lingkonglengfeng/nanhua-pendulum-car/chassis_fr4_v2_direct/README.md

# 底板 V2 新轮组直装版

本版直接修改整块底板，配合用户选定的 370、280 转、带编码器的整套轮组。**不需要上一版的小转接片。** 原 V1 底板文件保留作历史，不要混用两版 DXF。

底板仍为 320×220×4 FR4，外角 R10。四组轮组固定孔，每组横向 X 间距 16、沿电机轴向 Y 间距 14，孔径 Ø3.4，对应套件图的 4×Ø3.3，使用 M3 通孔连接。孔组中心为 X=±118、Y=±94；实际孔坐标 X=±110/±126，Y=±87/±101。

去除了旧 520 的 30×24 固定孔和旧转接片的 16 条 M4 槽，改为新轮组的 16 个直装孔。总孔/槽数量由 100 改为 84。倒立摆 8 个 M5 孔、电子模块 36 孔、IMU 4 孔、传感器 6 槽、电池 4 槽、走线 2 槽与侧边 8 孔全部保留。

孔组向两侧布置以给 27 mm 宽轮胎留空间。依据图中 34 mm 安装段、后孔距端部 8 和孔距 14，孔组中心距靠轮一侧的支架端约 19；因此正侧支架端名义位于 Y=113，超出主板边缘 110 约 3。轮与该端面之间的未标间隙没有擅自给定。最终先用纸样或实物叠放，确认轮胎及支架不擦板，再加工全部孔。

安装面到轴心高度未知，整车离地间隙不能沿用旧 520 模型。支架厚度和螺母空间也需确认后再选 M3 螺丝长度；采用穿透连接配垫圈和螺母，不在 4 mm FR4 上攻承力螺纹。

output/dxf 为加工轮廓，单位 mm；output/step 为完整底板实体；STL 仅供参考，不是一块能放入 A1 mini 的打印件。孔位表与顶视 SVG/PNG 一并提供。几何、孔位及导出文件检查通过，尚未试装和验证强度。
