lingkonglengfeng/nanhua-pendulum-car/pcb_bottom_adapter_v1/README.md

# 小车底部电路板转接板 V1

> 历史方案：用户已修正为底盘中央四槽安装。当前使用同级 `pcb_bottom_adapter_v2_center`；V1 端部安装不再是当前方案。

根据用户给定的电路板 **90×70 mm、四孔中心距 84×64 mm、M3** 设计。读取当前目录较新的 V3 300×200×4 mm 底盘 STEP，原有文件不修改。

## 直接使用

- `output/stl/01_adapter_84x64_M3.stl`：转接板打印 **1 件**，含四个一体支柱，整体 80×116×10 mm；主板厚 4 mm，支柱增高 6 mm。
- `output/stl/02_spacer_D8_H10_M3_qty4.stl`：隔柱打印 **4 件**，外径 8、高 10、通孔 Ø3.4。也可改用同尺寸绝缘通孔隔柱。
- `output/step/01_adapter_84x64_M3.step`：可编辑转接板实体。
- `output/step/03_chassis_adapter_pcb_assembly.step`：底盘、转接板、电路板参考体、电池参考体和简化紧固件装配。**不是整件打印文件**。
- `output/preview/adapter_viewer.html`：独立离线可旋转预览，支持只看打印件、查看装配、底视和侧视。
- `output/preview/dimensions.svg/png`：尺寸图；数值单位 mm，不按 PNG 显示尺寸量孔。
- `output/hole_coordinates_mm.csv`：孔位坐标。
- `output/adapter_profile_reference.dxf`：平面轮廓参考，BOSS_REFERENCE 为辅助层。立体支柱请以 STEP 为准，不可只根据 DXF 加工完整零件。

## 安装位置与尺寸

坐标沿用原底盘：X 为车长，Y 为车宽，底盘上表面 Z=0，下表面 Z=-4。

电路板旋转 90° 后，沿 X 为 70、沿 Y 为 90；孔距沿 X 为 64、沿 Y 为 84。默认孔阵相对板中心对称，即每个安装孔距板边 3 mm。转接板中心位于底盘 **(110,0)**，也可整体移至另一端 **(-110,0)**；两端底盘孔阵相同，实物安装选空闲一端。

| 项目 | 尺寸 / 坐标 mm |
|---|---|
| 转接板外形 | 80×116，外角 R5 |
| 转接板主板厚度 | 4 |
| 中央开窗 | 44×64，R5 |
| PCB 安装孔相对转接板中心 | X=±32，Y=±42，4×Ø3.4 |
| PCB 支柱 | 高 6，接触面 Ø5.5，根部 Ø9 锥形加强 |
| 底盘连接孔相对转接板中心 | X=±20，Y=±50，4×Ø3.4 |
| 默认使用的底盘原孔 | X=90/130，Y=±50；40×100 孔阵 |
| 底盘至转接板上表面 | 10 |
| 转接板主板 Z 范围 | -18 至 -14 |
| PCB 上表面（朝向底盘） | -24 |
| PCB 下表面 | -25.6，板厚仅暂按 1.6 建模 |

支柱朝下，PCB 装在支柱下端。转接板主板与 PCB 朝向底盘的一面之间留 6 mm；PCB 上表面至底盘下表面为 20 mm，中间包含转接板。若 PCB 背面有高于 6 mm 的器件，需增高支柱。接触面 Ø5.5 是为了适应孔中心距板边仅 3 mm 的尺寸。

## 配件与装配

| 配件 | 数量 | 用途 |
|---|---:|---|
| M3×25 螺丝、M3 螺母 | 各 4 | 穿过底盘、10 mm 隔柱、4 mm 转接板 |
| M3 平垫圈，外径约 7 | 8 | 底盘螺丝头和转接板下侧螺母处 |
| M3×16 螺丝、M3 螺母 | 各 4 | 从 PCB 外侧穿过 PCB、一体支柱和转接板 |
| M3 小外径绝缘垫圈，外径约 5.5 | 4 | PCB 螺丝头处，避让板边和元件 |

紧固件模型省略螺纹，长度按模型中 1.6 mm PCB 和 0.5 mm 垫圈选择；实际垫圈、板厚改变时对应调整长度。

1. 转接板平整大面朝打印平台，四个支柱朝上打印；隔柱竖直打印。建议 PETG，0.2 mm 层高、4 圈壁、约 35% 填充；此摆放无需悬空支撑。
2. 清理通孔，按实际打印收缩修至 M3 螺丝可顺畅穿过。所有孔均为通孔，**不要直接把螺丝攻进塑料孔**。
3. 先把 PCB 固定到四个一体支柱上，螺母位于转接板朝底盘的一面。PCB 角部安装孔周围要有足够无元件区域，螺丝及螺母不可触及带电焊盘。
4. 转接板支柱朝下，用四个 10 mm 隔柱连接底盘现有 40×100 mm 四孔。适度拧紧，避免压坏 PCB 或塑料支柱。
5. 线束可经过中央开窗或板边，按实际接插件位置固定。底盘原有孔若已用于上层模块，可共用贯穿螺栓，但需按实际叠层重新选螺丝长度。

## 验证范围

已检查单实体有效性、STL 闭合、STEP 回读、PCB 孔距、底盘四孔对位，以及装配中已表示实体（含螺丝、螺母、垫圈、电池参考体）的体积交叠。转接板与旧模型中央 120×50×28 电池参考体最短距离 10 mm。窗口是通孔，根部为锥形加强，支柱与板身为一个连续实体。

PCB 仅为外形与孔位参考体：未给出实际板厚、元件朝向、元件及接插件高度、孔位相对板边偏置。新轮组安装面至轮轴高度尚无可靠三维模型，未确认轮组向车内伸出的包络、接插件空间、路面间隙或实物强度。PCB 螺丝头最低约 Z=-29.1，PCB 外侧元件可能更低，安装前需一并核对。旧的 520 整车装配不是本次新轮组的尺寸依据。

## 重建

在 `D:\blance_car` 中运行：

```powershell
& .\.cad-venv\Scripts\python.exe .\pcb_bottom_adapter_v1\build_adapter.py
& .\.cad-venv\Scripts\python.exe .\pcb_bottom_adapter_v1\build_viewer.py
```

尺寸参数在同目录 `parameters.json`。改变孔距或安装位置后需同时检查板边距离、现有底盘孔阵及硬件干涉；生成脚本检查不会把未知器件空间当作已确认。
