lingkonglengfeng/nanhua-pendulum-car/HARDWARE_SELECTION.md

# 当前硬件选择

> 历史选型记录：以下内容对应 2026-09-28 的 G474 方案。后期 F103 固件和接口以 [项目首页](README.md) 与 [F103 工程说明](f103_bringup/README.md) 为入口；最终比赛实物配置待补充。

更新于 2026-09-28。

- 主控按最新用户图片：正点原子 ATK-DMG474。工程内资料盘包含 DMG474 V1.0 原理图及 IO 分配表；已据此完成 `wiring_dmg474_drv8871/output/DMG474引脚与转接板方案_V2.md` 的 MCU/接口针号分配。旧接线 SVG 仍为功能级 V1，模块针序与实物电气参数待核对。
- IPS200 调试屏当前走 CN10 的 SPI3 引脚；`wiring_dmg474_drv8871/output/IPS200接入与引脚分配_V3.md` 中的 CN3/SPI1 单独排线是旧备选。屏幕模块的供电、背光和实际排针顺序待实物核对。
- 为减少排线，当前 V6 沿用 `wiring_dmg474_drv8871/output/双牛角座两排线方案_V4.md` 中的 CN8/CN10 两根 24 芯信号排线、四路编码器、I²C4、IPS200/SPI3 和本地 5V→3.3V 供电；驱动器和控制网络以 V6 为准。
- 驱动方案按用户最新选择改为 **两块 AT8236 双路模块**，四台 12V 370 电机各用一通道。接口分配、模块两排 7 针照片视角丝印及 SVG 见 `wiring_dmg474_drv8871/output/AT8236双模块两排线方案_V6.md`。之前的 TB6612 V5 和 DRV8871 V4 均为旧方案。AT8236 小板实际排距、针脚方向、排针载流、温升与 3S 母线换向尖峰仍待实物核对。
- 轮组：用户确认采用最新图片中的整套电机+支架+轮胎。已知轮宽27、总长85.95、四孔3.3、沿电机轴向孔距14、另一方向16。轮径左右65/66标注需核对。
- 不再采用此前 JGB37-520 的参数。用户确认购买 **12V、21.3 减速比、空载 280 rpm** 的 370 电机；参数表标额定转速 220 rpm、额定电流 0.45A、堵转电流 1.3A，并注明不允许堵转或带负载瞬间反转。编码器 A/B 接线及轴高仍待核对。
- 最新底板采用 chassis_fr4_v3_300x200，300×200×4 mm、14×16 轮组直接安装，不再需要小转接片；配套文件为 `pendulum_底板V3_300x200.zip`，离线预览为 `pendulum_底板V3_300x200_独立预览.html`。chassis_fr4_v2_direct 与 wheelset_14x16_v1 仅保留为旧版本/过渡方案。此前整车模型里的 520 轮组外形是旧版占位，不能拿来确认新轮组轴高。
- 倒立摆仍采用 V3、Ø8 铝管、608轴承、AS5600圆板及可调配重。
