lingkonglengfeng/nanhua-pendulum-car/docs/发布准备.md

# GitHub 发布整理记录

首次公开整理包含项目首页、F103 使用入口、建模版本导航、技术调试过程初稿，以及根据作者口述整理的个人复盘、自制转接板工程、原理图及两张实物照片。仓库名为 `lingkonglengfeng/nanhua-pendulum-car`，默认分支为 `main`。

## 已整理的范围

- 当前 `f103_bringup/` 固件、随工程提供的 HAL / CMSIS / FreeRTOS、串口工具。
- 摆架、底盘、转接件、配重和参考整车的建模源文件及输出。
- 现有技术调试文档及面向读者的新导航。
- `hardware/adapter-board/` 保存作者提供的原始硬件工程和原理图；已注明设计仍有纰漏，实物使用飞线修正。
- `docs/images/` 保存整车及底部接线的两张实物照片。
- `.gitignore` 排除厂商整套资料盘、早期 G474 固件、重复归档、虚拟环境、生成缓存、调试器个人布局和批量原始日志。本地文件仍保留。
- 保留 `speed_pid_build/` 里的构建/验证脚本和测试源文件；只排除其中备份、主机生成目录与编译输出。

## 已完成与后续补充

- [x] 根据作者口述整理个人复盘，并将摘要加入 README。
- [ ] 比赛当天的具体过程、现场表现与最终结果。
- [ ] 确认当前 v48 与比赛最终运行版本的关系；需要时单独保留比赛版快照。
- [ ] 最终实物配置，尤其主控、电机、摆杆尺寸与重量、传感器和电源。
- [x] 整车与底部接线实物照片，已与 CAD 示意分开标注。
- [ ] 可公开的演示视频。
- [ ] 实物飞线修改清单：起止焊点、对应网络、原因，以及工程是否已回填。
- [x] 经作者选择，原创代码、设计及文档采用 MIT License；第三方部分保留原许可证。
- [x] 确定 GitHub 仓库名 `nanhua-pendulum-car`，整理简介和提交范围。

## 第三方文件说明

当前文件中可找到的许可证入口包括：

- `f103_bringup/Drivers/STM32F1xx_HAL_Driver/LICENSE.txt`
- `f103_bringup/Drivers/CMSIS/LICENSE.txt`
- `f103_bringup/Drivers/CMSIS/Device/ST/STM32F1xx/LICENSE.txt`
- `f103_bringup/Middlewares/Third_Party/FreeRTOS/Source/LICENSE`
- `pendulum_v3/output/preview/THREE-LICENSE.txt`

完整的第三方许可范围说明见 [THIRD_PARTY_NOTICES.md](../THIRD_PARTY_NOTICES.md)。保留模型预览脚本、参考图片和其他第三方资料的来源信息；仓库根目录的 MIT License 不替代其原许可。

## 原始数据

`f103_bringup/logs/` 暂不纳入默认提交，文档中对该目录的引用属于本地历史实验路径。串口工具 `samples/` 中用于离线展示和解析检查的样本日志保留。若后续公开更多实测数据，可挑选代表性日志，附固件号、命令顺序和实验条件，再单独整理。
