lingkonglengfeng/nanhua-pendulum-car/docs/校赛复盘与个人经验.md

# 南华电赛运控组校赛：一些调车的碎碎念

这次校赛的内容，是做一辆倒立摆小车。规则要求摆杆能够从最低点起摆，然后保持倒立。比赛结束了，就想把这次的代码、建模和一些调试经历整理出来，也聊聊自己一路做下来的感受。

过程中有方案更换，有选型踩坑，也有因为效果和时间原因最后没继续做的部分。把这些一起留下来，我觉得也有意义。

## 不会建模，就借助 AI 先做起来

我一开始不会建模，所以选择让 AI 辅助我做第一版倒立摆小车。考虑到摆杆需要从最低点起摆，最后选了龙门架式的结构，围绕这个结构一步步完成建模。

对我来说，这次算是一次跨出舒适圈的尝试。原本不熟悉的东西，借助 AI 可以先把想法做出来，再通过实物和调试慢慢理解。不过，模型做出来只是第一步，后面还有装配、接线和控制上的很多问题要处理。

## 第一版方案：想少飞线，还是踩了坑

最开始，角度传感器直接选了 AS5600，主控则用了正点原子的电机控制板。后面回头看，这块板对我这次的用途其实不太合适。

我个人不太喜欢飞特别多的线，所以参考原理图做了第一版转接板。想法很直接：利用控制板本身已有的简牛接口，通过排线连接到转接板，再接电机、磁编码器这些外设，把接线集中起来。

但实际测试时发现连接有些问题，加上那块控制板后来疑似因为短接损坏，这套选型最后就放弃了。

这部分让我体会到，前期选型不能只看功能够不够，也要结合自己真正要接的外设，以及整车的接线和调试方式。原本是想少一点飞线，实际做下来，接口核对和转接板设计本身也需要花不少功夫。

## 换成 F103，用 RTOS 组织任务

后面改成了 F103 的方案，重新画了第二版板子，软件架构用 FreeRTOS 来组织。

但换了方案、重新画板，也没有一下子把问题都解决。自己设计的转接板里还是有纰漏，最后是在实物上通过飞线修正的。本来想尽量少飞线，最后还是用到了飞线，这也是这次做板和调试的实际经历。

这次把 [转接板工程、原理图和已知问题](../hardware/adapter-board/README.md) 一起放进仓库，也附上了 [整车照片](images/car-overview.jpg) 和 [底部接线照片](images/car-underside.jpg)。工程文件保留提供时的设计内容，实物飞线的具体起止点还需要继续整理。

实际上，我对 RTOS 学得也不算深入。但这种把控制、通信等工作分成任务、通过调度交替运行的方式，用起来确实很方便。对这次项目来说，这种“伪并行”的使用感受很好，也让我有机会带着实际需求去理解任务调度。

## 编码器选型的影响，一直留到了后面

另一个比较明显的问题，是前期选型经验不足，选的轮组编码器分辨率偏低。

在后续调参时，我一直觉得这件事很影响零速附近的调试：把速度环的目标速度设成 0，也很难让车持续保持在原点。能让摆杆保持倒立，和能让整辆车一直停在同一个位置，实际做起来还是有差别的。

回头看，前期应该更早关注编码器在实际低速工况下能提供怎样的反馈。电机能转、转速够用以后，低速反馈和零速附近的控制仍然有不少问题要处理。

转向环我也做过，但效果比较差。再加上时间不是特别多，后来就没有继续往循迹上做了。

## 起摆策略：学过，也结合实车做了选择

起摆这一部分，我也去学习过，看到过动态正弦策略。不过结合这次的调试感受，AI 辅助写出来的这一版能量控制策略，好像更适合我的这辆车一些。

最后还是要把程序放到实车上，看摆杆怎么动、什么时候接管，再结合现象和日志去调整。

## AI 的辅助，确实占了很大一部分

这次项目里，AI 的辅助是占大头的。从最开始不会建模，到后面的代码实现和调试，我都用了很多 AI 帮助，也想把这个实际过程记录下来。

现在有这样的工具，我觉得应该跟上变化，勇敢跨出舒适圈，尝试一些以前觉得自己不会、可能就不敢开始的事情。很多时候，先把自己的想法说清楚，就可以借助 AI 一步一步往前做。学习和尝试的成本，确实比以前低了很多。

但最后还是要看行动能力。车要自己装，线要自己接，实物出了问题也要实际去看、去测、去改。实践能力还是非常重要的。

理论知识也可以边做边学。我自己的感受是，带着实际遇到的问题回头看理论，理解反而会更深一些。做的过程中发现自己哪里不懂，再去补，学到的东西也更容易和实际对应起来。

至于 AI 工具的选择，我觉得国产模型的能力也已经很强了。就我这次的个人使用体验来说，为了省事，某些国外模型能更快、更准确地帮我完成想做的事情，所以用得更多一些。我也期待国产模型继续进步，慢慢跟上。

这大概就是这次南华电赛运控组校赛调试的一些碎碎念。希望真正看到这里的人，能从这些代码、模型和不太顺利的经历里，找到一点对自己有帮助的东西。

---

项目入口：[README](../README.md)。按源码和历史日志整理的技术过程见 [调试过程](调试过程.md)。比赛现场具体表现与最终成绩，后续另行补充。
