lingkonglengfeng/nanhua-pendulum-car/pendulum_v2/output/V2圆角修改说明.md

# V2 圆角修改与旧底座兼容性

这次修改保留已经打印的 01 号底座。01 号底座、10 号试打块的 STL 与 V1 字节完全相同，下段支撑臂 Z=8–34 的插接段（含底部穿杆孔）与 V1 的几何差异为零，因此已有底座不必重打。如果“第一个”指的是先打印的试打块，它同样可以继续使用。

后续请采用 V2 的 02–09 号文件。轴高、摆长、两塔中心距、支撑臂厚度、轴承座配合、摆轴孔、摆杆孔以及底座/拼接处孔位均保留。编码器参考 PCB 外形仍待选购后确认。

## 改了哪些圆角

| 零件 | 修改 | 用途与边界 |
|---|---|---|
| 02 下段支撑臂 | 镂空窗口四角 R4 | 在原尖角处增加材料形成圆滑过渡；没有削薄原支撑臂，也没有改变底部插接段 |
| 03 上段轴承臂 | 镂空窗口四角 R3；顶部外轮廓 R3 | 窗口内角是主要受力过渡修改；顶部外角圆滑主要是外形处理；底部拼接端保留平面 |
| 04 拼接夹板 | 外轮廓四角 R4 | 保留平面夹紧面、厚度和全部孔位；这项主要去除外尖角，不应当解释为已验证的承载提升 |
| 05 轴承端盖 | 外轮廓四角 R3 | 保留中孔、螺丝孔以及压住轴承外圈的接触面 |
| 06 摆杆夹座 | T 形台阶内根部及外轮廓 R2；夹杆缝盲端 R0.8 退刀圆孔 | 重点改善台阶及夹紧缝根部的尖锐过渡；轴孔和插杆孔配合尺寸保留 |
| 07 编码器滑轨 | 安装脚与横向悬臂交界根部 R2.5；滑轨横截面宽度由 12 增至 14 | 加强悬臂根部；长圆槽位置及原有固定孔保留 |
| 08 编码器背板 | 背板与两脚连接根部 R2；中央开窗四角 R2；顶部外轮廓 R3 | 兼顾根部过渡与中央窗口；安装孔仍为占位 PCB 孔距 |
| 09 磁铁座 | 紧定螺母凸台外围 R1 | 仅圆滑凸台外围；没有声称磁铁座圆柱/凸台交界已做根部圆角 |

圆角针对的是几何过渡，尤其是窗口内角、台阶内角和悬臂根部。打印件仍可能因层间结合、低填充、螺丝过紧或层向不合适而开裂。这里没有进行有限元分析，也没有实测疲劳寿命或强度提升百分比。

## 编码器背板的装配修正

检查原结构时发现：背板脚上的竖直固定孔正好位于立板下方，螺丝头和工具无法从上方正常接近。V2 将两个孔从背板中心平面向磁铁方向前移 10，脚的前后长度由 20 改为 26，给螺丝头和工具留出空间。

这个修改不改变滑轨的长圆槽，也不改变编码器芯片与磁铁的名义位置。装配时让两只脚的新孔与滑轨槽对齐；背板仍可前后移动调节间距。M3 螺丝与原清单兼容。

定位环参考模型同步改为用户已经选定的内径 8、外径 14、厚 6。它不改变打印件配合；安装时薄垫片只接触轴承内圈，调整定位环轴向位置避免给轴承施加预紧。

## 验证情况

- 10 种导出零件均为有效单实体，STL 为封闭正体积网格。
- 最大平放尺寸仍为 169，适用于 A1 mini 的 180 成型范围；08 的打印高度由 20 改为 26。
- 固定打印件之间未检出体积交叠。
- 中央摆杆与夹座的转动空间、磁铁座整圈包络检查通过；底盘净空保持约 39.97。
- 旧底座与新插接段几何对比通过；轴承孔、光轴孔、铝管孔与底部/拼接孔的空腔检查通过。
- 编码器背板两个新孔上方的 Ø6.2、长 60 螺丝头/工具接近包络没有撞到背板。
- 装配 STEP 已回读验证；3MF 已检查内部模型单位、坐标和三角形索引。

对应记录：`verification.json`、`revision_compatibility.json`、`export_readback.json`。验证针对 CAD 几何与文件完整性，不等同于实物配合或强度已经合格。

继续按照原装配顺序，支撑臂平放打印。先用同一种材料和打印参数完成配合测试，再打印大件；不要为了圆角修改同时改变全局缩放比例，否则轴承孔和已打印底座的配合也会变化。
