lingkonglengfeng/nanhua-pendulum-car/chassis_fr4_v1/output/preview/chassis_top.png

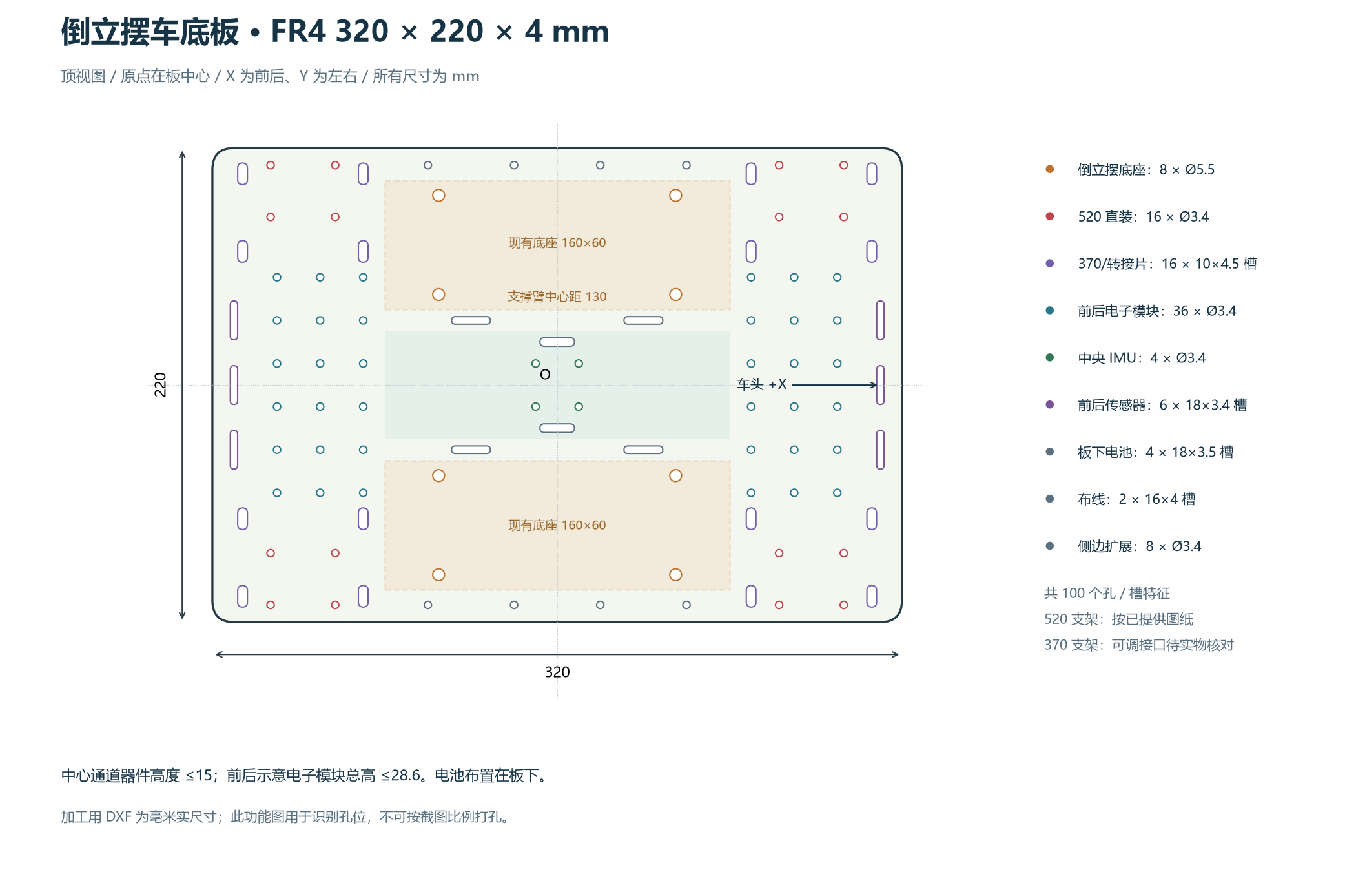
chassis_fr4_v1/output/preview/chassis_top.png
