lingkonglengfeng/nanhua-pendulum-car/chassis_fr4_v1/reference/520_bracket.jpg

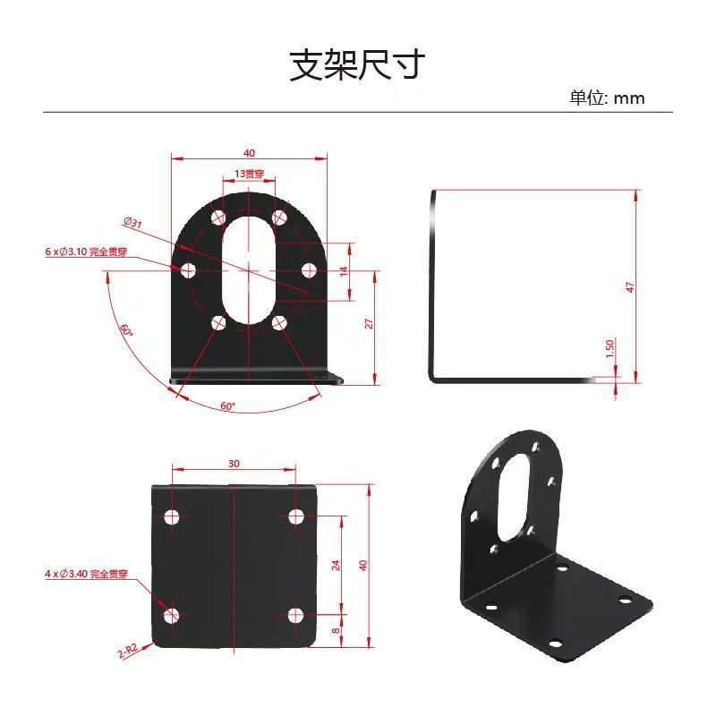
chassis_fr4_v1/reference/520_bracket.jpg
