lingkonglengfeng/nanhua-pendulum-car/chassis_fr4_v2_direct/output/preview/chassis_V2_top.png

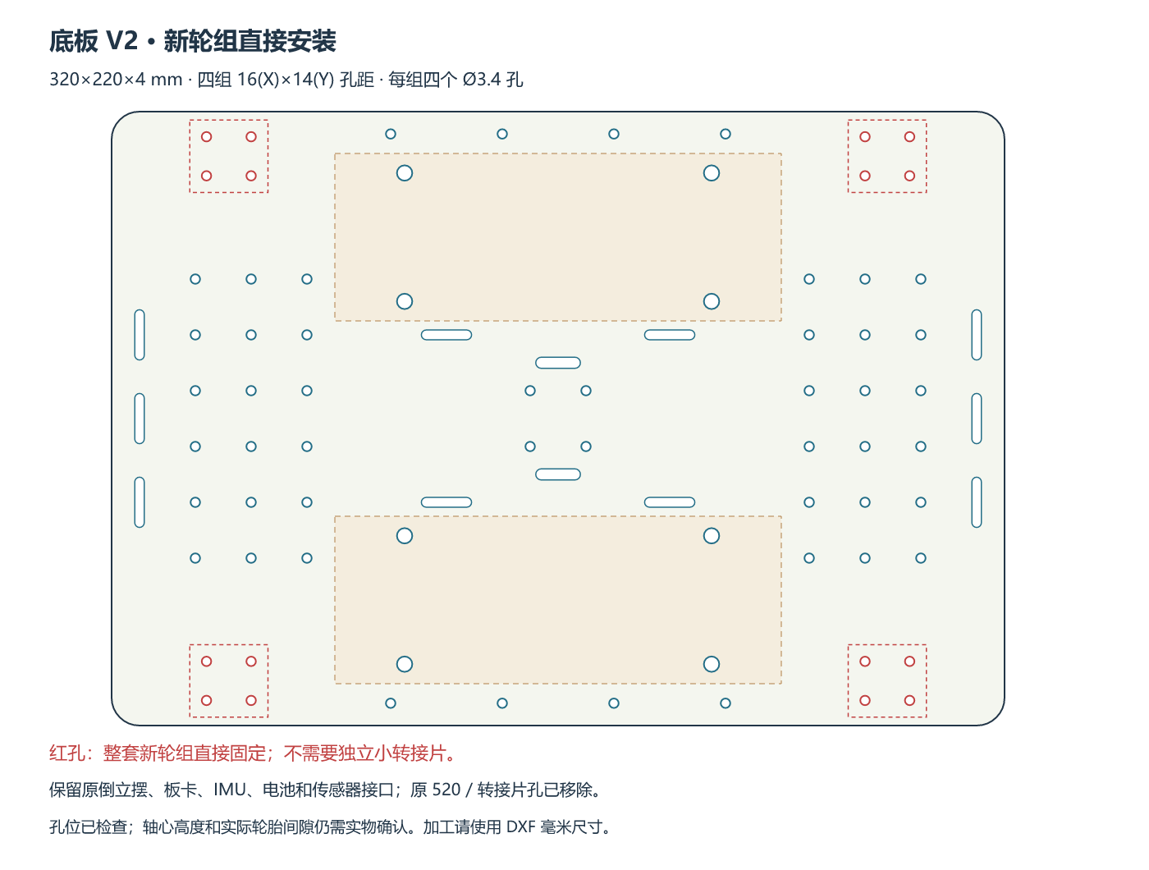
chassis_fr4_v2_direct/output/preview/chassis_V2_top.png
