lingkonglengfeng/nanhua-pendulum-car/pcb_bottom_adapter_v1/output/preview/dimensions.png

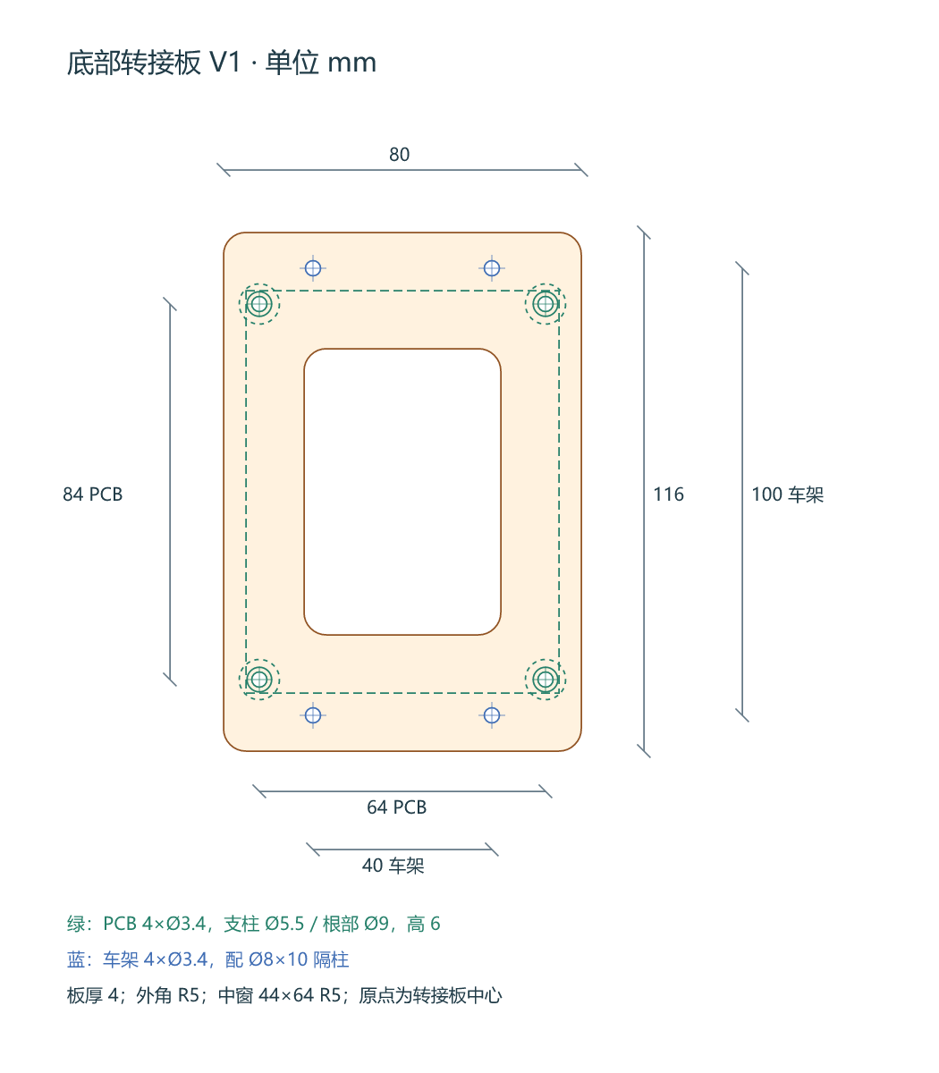
pcb_bottom_adapter_v1/output/preview/dimensions.png
