lingkonglengfeng/nanhua-pendulum-car/pcb_bottom_adapter_v2_center/output/preview/dimensions.png

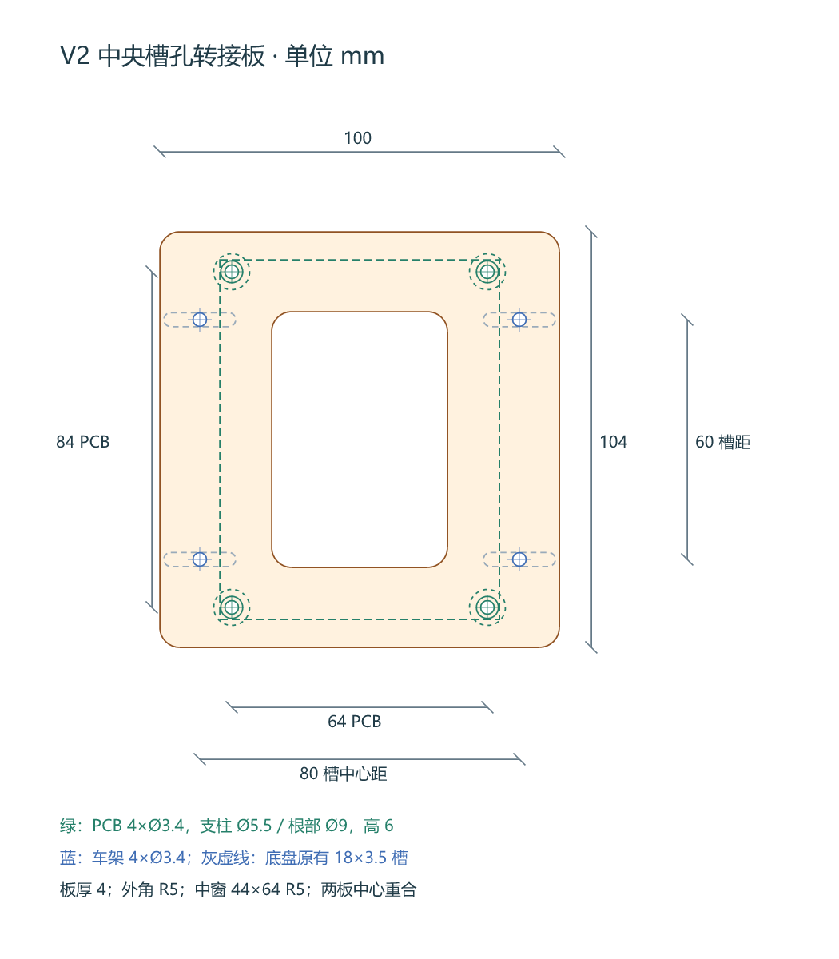
pcb_bottom_adapter_v2_center/output/preview/dimensions.png
