lingkonglengfeng/nanhua-pendulum-car/pendulum_v3/output/preview/AS5600_mount.png

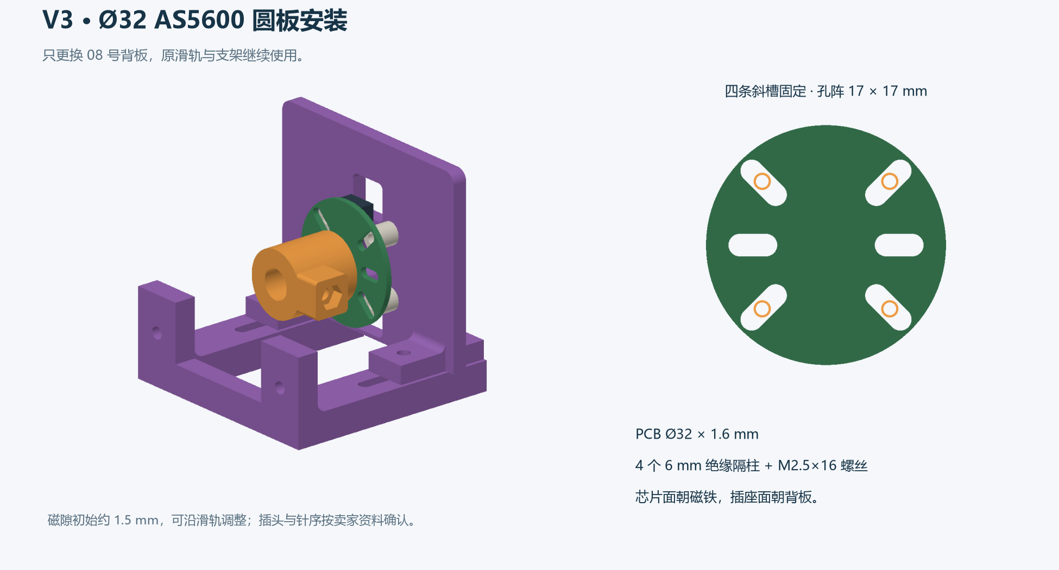
pendulum_v3/output/preview/AS5600_mount.png
