lingkonglengfeng/nanhua-pendulum-car/pendulum_v3/output/preview/dimensions.png

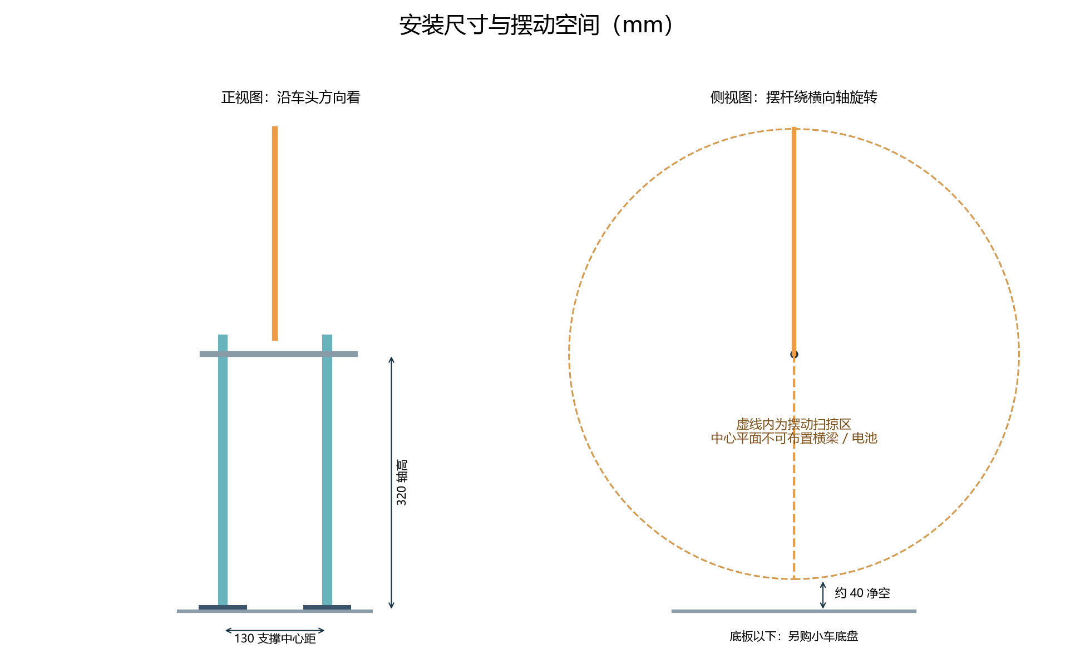
pendulum_v3/output/preview/dimensions.png
