lingkonglengfeng/nanhua-pendulum-car/pendulum_v3/reference/AS5600_module_drawing.jpg

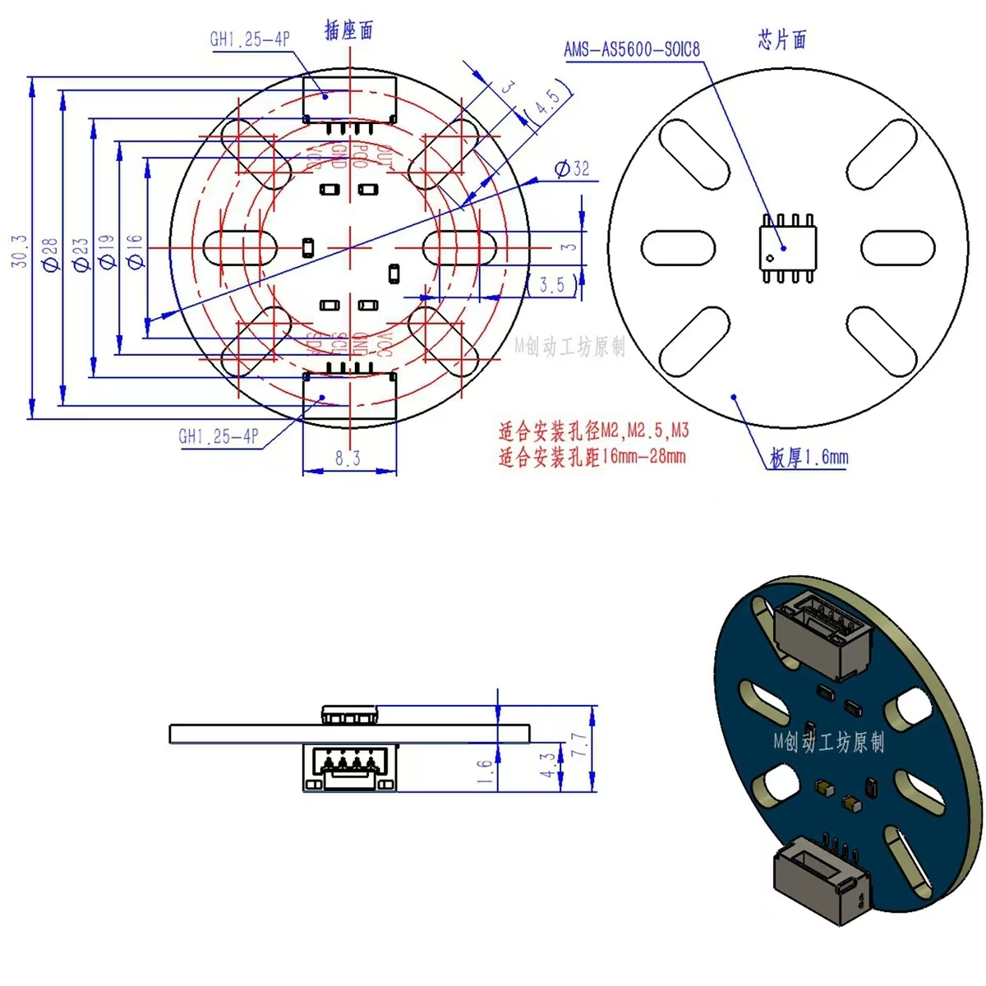
pendulum_v3/reference/AS5600_module_drawing.jpg
