lingkonglengfeng/nanhua-pendulum-car/vehicle_assembly_v1/output/preview/electronics.png

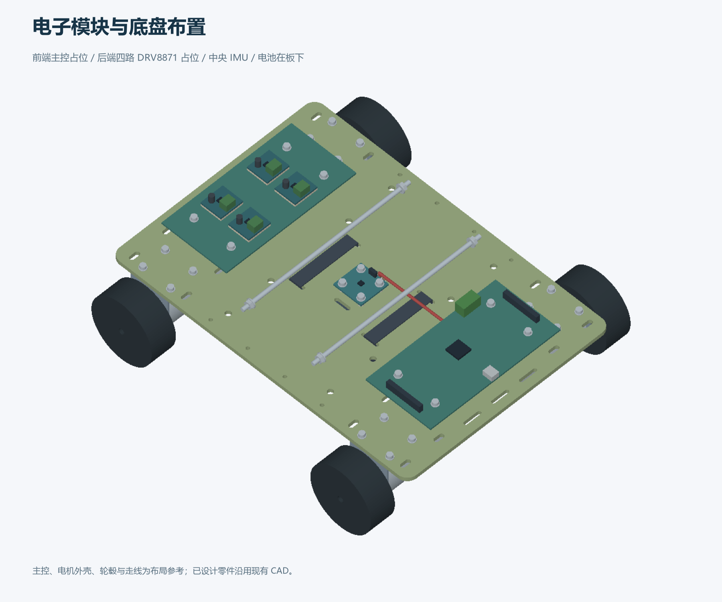
vehicle_assembly_v1/output/preview/electronics.png
