lingkonglengfeng/nanhua-pendulum-car/wheelset_14x16_v1/output/adapter_layout.png

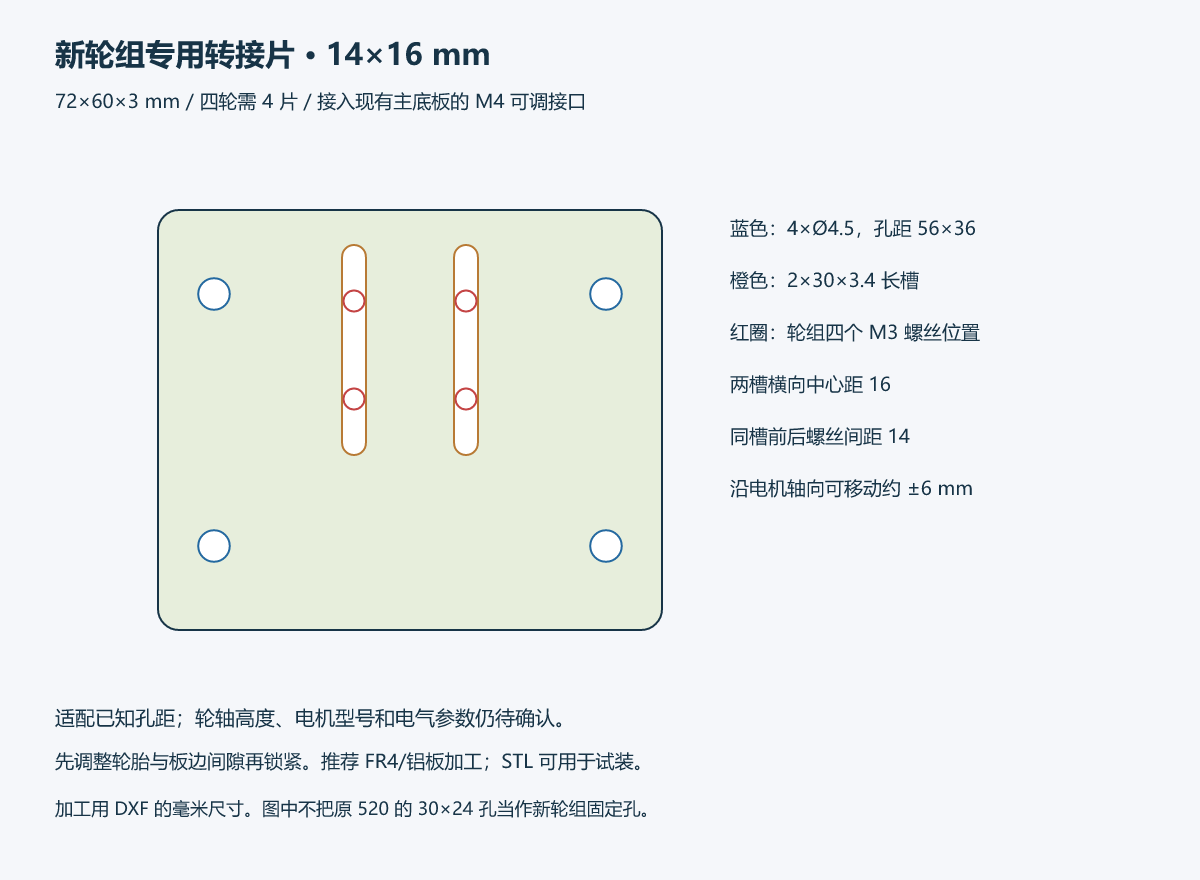
wheelset_14x16_v1/output/adapter_layout.png
