lingkonglengfeng/nanhua-pendulum-car/wiring_dmg474_drv8871/output/AT8236转接板元器件与线缆采购清单_V6.md

# AT8236 四驱转接板元器件与线缆采购清单（V6）

适用范围：ATK-DMG474 + 两块双路 AT8236 + 四台 12V 带编码器 370 电机 + AS5600 + IPS200。依据当前 [V6 接线方案](AT8236双模块两排线方案_V6.md)和 2026-09-28 的转接板原理图/PCB 截图整理。清单是**采购准备表**，不是已经通过 ERC/DRC 的最终 BOM；器件的排距、性别、针序和外形必须与实物及最终 PCB 封装一致。

## 可以先准备的板上连接器

| 用途/图中位号 | 搜索/采购规格 | 数量  | 对应线端与注意事项 |
| --- | --- | ---:| --- |
| 主控排线座 CN1、CN2 | 2.54 mm、2×12、24P、直插防呆简易牛角座（简牛、公座）；按现有 `LAIL-SI-2.54-2X12P-ZC` 封装核对定位柱和外框 | 2 个 | 分别接 DMG474 CN8、CN10。核对主板牛角座 1 脚及防呆口方向。 |
| 四路电机/编码器座 U1～U4 | XH2.54、6P、直插板端公座；按 PCB 选立式/卧式，图中为直插 | 4 个 | 每台电机一组 6 芯。所购电机原插头**不一定是 XH2.54**，先量实际针距和针序。 |
| AS5600 座 U6 | XH2.54、4P、直插板端公座 | 1 个 | 配一组 4 芯线；模块端接口若不是 XH2.54，另一端按模块实物制作。 |
| AT8236 插座 H1～H4 | 2.54 mm、1×7 单排母座/排母 | 4 条 | 两块模块各占两条。确认模块自带的是公针；**两排中心距、插入方向和触点额定电流尚未确认**，测量后再定最终型号。 |
| 电池输入 U5 | 与 PCB 封装一致的 XT60PB-M 板端连接器 | 1 个 | 核对所购 3S 电池插头的性别和 XT60 正负极；不得只按线色判断。 |
| PCB 安装孔 | M3 非金属化孔，建议成品孔径 3.2～3.4 mm | 4 孔 | 这是 PCB 加工特征，不需要买“孔元件”。目前截图只见两个 SCREW，四孔位置须在最终布局中补齐。 |

## 与板上连接器配套的线材

| 用途 | 建议搜索词/做法 | 数量  | 采购前核对 |
| --- | --- | ---:| --- |
| 主控到转接板 | `24P 2×12 IDC 双母头 1:1 直通排线`，24 芯灰排线导体间距通常为 1.27 mm，插头针距 2.54 mm | 2 根 | 两根长度按主板、转接板实际摆放确定；“同向/异向”按防呆口朝向决定，**电气必须逐针 1→1、2→2、…、24→24**。 |
| 四台电机 6 芯线 | XH2.54 6P 单端预压接线，或 6P 母壳 4 个 + 压接端子至少 24 只（建议多买 8 只）+ 合适线材 | 4 组 | 若电机已带可直接插入 U1～U4 的 6P 插头，不重复购买。电机两根功率线的触点额定电流需覆盖约 1.3 A 堵转瞬态。 |
| AS5600 4 芯线 | XH2.54 4P 单端预压接线，或 4P 母壳 1 个 + 压接端子至少 4 只（建议多买 4 只） | 1 组 | 核对模块端的 VCC/GND/SCL/SDA 顺序；不可只按导线颜色接。 |
| 电池到 XT60 | 与 U5 配对的 XT60 插头/成品电池线，建议至少 0.75 mm² 导线 | 1 组 | 若电池已有匹配 XT60 插头可不另买；核对极性、线长和固定方式。 |
| IPS200 屏幕连接 | 按下节确定的 2×8 对接件/16 芯线，或屏幕原装线 | 暂缓  | 当前屏幕实物针序、供电电压和 2×8 座的配合方式未核对，先不要只凭截图下单。 |

上表的“预压接线”和“母壳+散端子”是二选一的制作方式，不需要两套都买。预制排线仍要用万用表检查线序。

## 实物确认后再买的器件

| 项目 | 暂定数量 | 先确认什么 |
| --- | ---:| --- |
| IPS200 板端 2×8、2.54 mm 直插排针/排座 U9（图中 `HC-PM254-8.5H-2x8PZ`）及其对接件 | 各 1 | 现有 PCB 用 16 针，V6 早期草图曾按自定义 8 针规划；必须以**实际 IPS200 模块**的座子尺寸、针序、VCC 和背光接法决定。图中 U9 的 1、15 脚接 5V，不能未经核对就接屏幕。 |
| 5V→3.3V 稳压器及输入/输出电容 | 1 组 | AT8236 VCC 和 AS5600 需要可靠的 `3V3_LOCAL`。当前原理图**没有稳压器**；先根据 IPS、编码器和模块总电流选器件，建议按至少 0.5～1 A 的能力留余量，并在 PCB 中添加相应封装、去耦和测试点。 |
| 电机母线储能/去耦 | 每块驱动附近各 1 组，共 2 组 | 预留约 220～470 µF、耐压至少 25 V 的电解/固态电容及 0.1 µF 陶瓷电容；最终取值与是否已有板载电容按 AT8236 小板电路和实测尖峰确定。 |
| I²C4 上拉电阻 | 2 只（备选） | 常用 4.7 kΩ 上拉到本地 3.3V；若 AS5600 模块/主板已有合适上拉，避免重复导致总阻值过低。 |
| 电池侧保险丝与电源开关 | 各 1 组 | 依实测启动电流、导线规格和所选开关的直流额定值确定；可先做在线束上，不必强塞入紧凑 PCB。 |
| DC1 直流电源插座 | 默认不装 | 当前 DC1 与 XT60 直接并到 `VM/GND`。若要两种电源都保留，先设计切换/防反灌；不可同时插入两个电源。 |

## 模块、结构件与耗材

| 项目 | 数量 | 备注 |
| --- | ---:| --- |
| 所选 AT8236 **双路模块** | 2 块 | 前轮 FL/FR 一块、后轮 RL/RR 一块；不是两颗单路芯片就够四台电机。 |
| 12V、约 280 rpm、带编码器 370 电机 | 4 台 | 用户已选型号；额定约 0.45 A、堵转约 1.3 A/台，不允许持续堵转或带载瞬间反转。 |
| ATK-DMG474 主控板、AS5600 模块、IPS200 屏幕、3S 电池 | 各 1 | 已有则不重复采购；逐件核对接口和供电。 |
| 2 层 FR4 转接板 | 1 块装配，建议打样 5 块 | 当前外形约 120×56 mm，100×56 mm 仅是待重新摆件、完成布线后可尝试的目标；投板尺寸以最终 PCB 为准。 |
| M3 绝缘/金属隔离柱、螺钉与垫圈 | 隔离柱 4 根、螺钉 8 颗、垫圈 8 个 | 先按约 15 mm 隔离柱试装；底板厚 4 mm，螺钉长度按隔离柱有效螺纹和垫圈实测确定。避免金属垫圈碰到铜箔。 |

## 下单与投板前必须处理

1. U1～U4 电机功率脚当前叫 `VIN_*/VOUT_*`，驱动输出叫 `*_MOTOR1/2`；网络名不一致，四路电机实际上未接通。把每台电机的两根绕组线接到对应驱动输出。
2. U6 AS5600 的 `SCL/SDA/VCC` 目前未连到 `PC6_I2C4_SCL/PC7_I2C4_SDA/3V3_LOCAL`；增加稳压器并修正网络名。编码器座当前给 5V，应先确认编码器 A/B 输出的电压与 MCU 输入兼容。
3. CN2-20 右后轮控制网应为 `PC11_RR_IN2`，不是图上的 `PC10_RR_IN2`；PC10 已作屏幕 SPI 时钟。
4. 原方案只从主控 CN10-23 取 5V 给本地稳压器，CN8-23 留空。当前图中两个 5V 针均已连接，需要按最终供电方案修正。
5. 驱动模块双排针排距、IPS 16 针接口、XH 电机插头与 XT60 极性均须按实物检查。排线防呆口方向确定后再选同向/异向；关键是逐针 1:1。完成原理图 ERC、PCB DRC 与装配干涉检查后再投板。
