lingkonglengfeng/nanhua-pendulum-car/vehicle_assembly_v1/output/component_manifest.csv

component | category | source | reference
base_L | fixed | existing_CAD | False
lower_L | fixed | existing_CAD | False
upper_L | fixed | existing_CAD | False
splice_L_-1 | fixed | existing_CAD | False
splice_L_1 | fixed | existing_CAD | False
cover_L | fixed | existing_CAD | False
608_L | hardware | existing_CAD | False
collar_L | rotor | existing_CAD | False
shim_L | rotor | existing_CAD | False
base_R | fixed | existing_CAD | False
lower_R | fixed | existing_CAD | False
upper_R | fixed | existing_CAD | False
splice_R_-1 | fixed | existing_CAD | False
splice_R_1 | fixed | existing_CAD | False
cover_R | fixed | existing_CAD | False
608_R | hardware | existing_CAD | False
collar_R | rotor | existing_CAD | False
shim_R | rotor | existing_CAD | False
shaft_8x190 | rotor | existing_CAD | False
rod_hub | rotor | existing_CAD | False
tube_8x6x260 | rotor | existing_CAD | False
encoder_rail | fixed | existing_CAD | False
encoder_carrier | fixed | existing_CAD | False
magnet_cup | rotor | existing_CAD | False
magnet_6x3 | rotor | existing_CAD | False
AS5600_D32_PCB_FROM_DRAWING | reference | existing_CAD | True
AS5600_PACKAGE_ENVELOPE | reference | existing_CAD | True
GH125_CONNECTOR_ENVELOPE_-1 | reference | existing_CAD | True
GH125_CONNECTOR_ENVELOPE_1 | reference | existing_CAD | True
NYLON_SPACER_6mm_0 | hardware | existing_CAD | False
NYLON_SPACER_6mm_1 | hardware | existing_CAD | False
NYLON_SPACER_6mm_2 | hardware | existing_CAD | False
NYLON_SPACER_6mm_3 | hardware | existing_CAD | False
M4_tie_rod_-38 | hardware | existing_CAD | False
M4_tie_rod_38 | hardware | existing_CAD | False
FR4_MAIN_CHASSIS | fixed | existing_CAD | False
ref_520_-1_-1_Lbracket | reference | existing_CAD | True
ref_520_-1_-1_motor | reference | existing_CAD | True
ref_520_-1_-1_shaft | reference | existing_CAD | True
ref_520_-1_-1_wheel | reference | existing_CAD | True
ref_520_-1_1_Lbracket | reference | existing_CAD | True
ref_520_-1_1_motor | reference | existing_CAD | True
ref_520_-1_1_shaft | reference | existing_CAD | True
ref_520_-1_1_wheel | reference | existing_CAD | True
ref_520_1_-1_Lbracket | reference | existing_CAD | True
ref_520_1_-1_motor | reference | existing_CAD | True
ref_520_1_-1_shaft | reference | existing_CAD | True
ref_520_1_-1_wheel | reference | existing_CAD | True
ref_520_1_1_Lbracket | reference | existing_CAD | True
ref_520_1_1_motor | reference | existing_CAD | True
ref_520_1_1_shaft | reference | existing_CAD | True
ref_520_1_1_wheel | reference | existing_CAD | True
ref_battery_120x50x28 | reference | existing_CAD | True
ref_board_standoff_-1_-90_-50 | reference | existing_CAD | True
ref_board_standoff_-1_-90_50 | reference | existing_CAD | True
ref_board_standoff_-1_-130_-50 | reference | existing_CAD | True
ref_board_standoff_-1_-130_50 | reference | existing_CAD | True
ref_controller_board_-1 | reference | existing_CAD | True
ref_board_standoff_1_90_-50 | reference | existing_CAD | True
ref_board_standoff_1_90_50 | reference | existing_CAD | True
ref_board_standoff_1_130_-50 | reference | existing_CAD | True
ref_board_standoff_1_130_50 | reference | existing_CAD | True
ref_controller_board_1 | reference | existing_CAD | True
weight_lower_head | rotor | existing_CAD | False
weight_lower_nut | rotor | existing_CAD | False
weight_lower_bolt0 | rotor | existing_CAD | False
weight_lower_smallwasher0 | rotor | existing_CAD | False
weight_lower_hexnut0 | rotor | existing_CAD | False
weight_lower_bolt1 | rotor | existing_CAD | False
weight_lower_smallwasher1 | rotor | existing_CAD | False
weight_lower_hexnut1 | rotor | existing_CAD | False
weight_upper_head | rotor | existing_CAD | False
weight_upper_nut | rotor | existing_CAD | False
weight_upper_bolt0 | rotor | existing_CAD | False
weight_upper_smallwasher0 | rotor | existing_CAD | False
weight_upper_hexnut0 | rotor | existing_CAD | False
weight_upper_bolt1 | rotor | existing_CAD | False
weight_upper_smallwasher1 | rotor | existing_CAD | False
weight_upper_hexnut1 | rotor | existing_CAD | False
weight_mass_washer_1 | rotor | existing_CAD | False
weight_mass_washer_2 | rotor | existing_CAD | False
base_M5bolt_-55_-88 | hardware | simplified_fastener | False
base_M5washer_top_-55_-88 | hardware | simplified_fastener | False
base_M5washer_bottom_-55_-88 | hardware | simplified_fastener | False
base_M5nut_-55_-88 | hardware | simplified_fastener | False
base_M5bolt_-55_-42 | hardware | simplified_fastener | False
base_M5washer_top_-55_-42 | hardware | simplified_fastener | False
base_M5washer_bottom_-55_-42 | hardware | simplified_fastener | False
base_M5nut_-55_-42 | hardware | simplified_fastener | False
base_M5bolt_-55_42 | hardware | simplified_fastener | False
base_M5washer_top_-55_42 | hardware | simplified_fastener | False
base_M5washer_bottom_-55_42 | hardware | simplified_fastener | False
base_M5nut_-55_42 | hardware | simplified_fastener | False
base_M5bolt_-55_88 | hardware | simplified_fastener | False
base_M5washer_top_-55_88 | hardware | simplified_fastener | False
base_M5washer_bottom_-55_88 | hardware | simplified_fastener | False
base_M5nut_-55_88 | hardware | simplified_fastener | False
base_M5bolt_55_-88 | hardware | simplified_fastener | False
base_M5washer_top_55_-88 | hardware | simplified_fastener | False
base_M5washer_bottom_55_-88 | hardware | simplified_fastener | False
base_M5nut_55_-88 | hardware | simplified_fastener | False
base_M5bolt_55_-42 | hardware | simplified_fastener | False
base_M5washer_top_55_-42 | hardware | simplified_fastener | False
base_M5washer_bottom_55_-42 | hardware | simplified_fastener | False
base_M5nut_55_-42 | hardware | simplified_fastener | False
base_M5bolt_55_42 | hardware | simplified_fastener | False
base_M5washer_top_55_42 | hardware | simplified_fastener | False
base_M5washer_bottom_55_42 | hardware | simplified_fastener | False
base_M5nut_55_42 | hardware | simplified_fastener | False
base_M5bolt_55_88 | hardware | simplified_fastener | False
base_M5washer_top_55_88 | hardware | simplified_fastener | False
base_M5washer_bottom_55_88 | hardware | simplified_fastener | False
base_M5nut_55_88 | hardware | simplified_fastener | False
splice_M4bolt_-1_-16_155 | hardware | simplified_fastener | False
splice_M4washer_-1_-16_155_77 | hardware | simplified_fastener | False
splice_M4washer_-1_-16_155_52 | hardware | simplified_fastener | False
splice_M4nut_-1_-16_155 | hardware | simplified_fastener | False
splice_M4bolt_-1_-16_195 | hardware | simplified_fastener | False
splice_M4washer_-1_-16_195_77 | hardware | simplified_fastener | False
splice_M4washer_-1_-16_195_52 | hardware | simplified_fastener | False
splice_M4nut_-1_-16_195 | hardware | simplified_fastener | False
splice_M4bolt_-1_16_155 | hardware | simplified_fastener | False
splice_M4washer_-1_16_155_77 | hardware | simplified_fastener | False
splice_M4washer_-1_16_155_52 | hardware | simplified_fastener | False
splice_M4nut_-1_16_155 | hardware | simplified_fastener | False
splice_M4bolt_-1_16_195 | hardware | simplified_fastener | False
splice_M4washer_-1_16_195_77 | hardware | simplified_fastener | False
splice_M4washer_-1_16_195_52 | hardware | simplified_fastener | False
splice_M4nut_-1_16_195 | hardware | simplified_fastener | False
splice_M4bolt_1_-16_155 | hardware | simplified_fastener | False
splice_M4washer_1_-16_155_77 | hardware | simplified_fastener | False
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
encoder_slide_bottomwasher_-23 | hardware | simplified_fastener | False
encoder_slide_nut_-23 | hardware | simplified_fastener | False
encoder_slide_bolt_23 | hardware | simplified_fastener | False
encoder_slide_topwasher_23 | hardware | simplified_fastener | False
encoder_slide_bottomwasher_23 | hardware | simplified_fastener | False
encoder_slide_nut_23 | hardware | simplified_fastener | False
encoder_PCB_bolt_-8.5_311.5 | hardware | simplified_fastener | False
encoder_PCB_frontwasher_-8.5_311.5 | hardware | simplified_fastener | False
encoder_PCB_backwasher_-8.5_311.5 | hardware | simplified_fastener | False
encoder_PCB_nut_-8.5_311.5 | hardware | simplified_fastener | False
encoder_PCB_bolt_-8.5_328.5 | hardware | simplified_fastener | False
encoder_PCB_frontwasher_-8.5_328.5 | hardware | simplified_fastener | False
encoder_PCB_backwasher_-8.5_328.5 | hardware | simplified_fastener | False
encoder_PCB_nut_-8.5_328.5 | hardware | simplified_fastener | False
encoder_PCB_bolt_8.5_311.5 | hardware | simplified_fastener | False
encoder_PCB_frontwasher_8.5_311.5 | hardware | simplified_fastener | False
encoder_PCB_backwasher_8.5_311.5 | hardware | simplified_fastener | False
encoder_PCB_nut_8.5_311.5 | hardware | simplified_fastener | False
encoder_PCB_bolt_8.5_328.5 | hardware | simplified_fastener | False
encoder_PCB_frontwasher_8.5_328.5 | hardware | simplified_fastener | False
encoder_PCB_backwasher_8.5_328.5 | hardware | simplified_fastener | False
encoder_PCB_nut_8.5_328.5 | hardware | simplified_fastener | False
layout_main_MCU | reference | unverified_electronics_envelope | True
layout_USB | reference | unverified_electronics_envelope | True
layout_power_terminal | reference | unverified_electronics_envelope | True
layout_header_-63 | reference | unverified_electronics_envelope | True
layout_header_63 | reference | unverified_electronics_envelope | True
layout_driver_insulation_-125_-25 | reference | unverified_electronics_envelope | True
layout_DRV8871_module_PCB_-125_-25 | reference | unverified_electronics_envelope | True
layout_driver_IC_-125_-25 | reference | unverified_electronics_envelope | True
layout_driver_terminal_-125_-25 | reference | unverified_electronics_envelope | True
layout_driver_capacitor_-125_-25 | reference | unverified_electronics_envelope | True
layout_driver_insulation_-125_25 | reference | unverified_electronics_envelope | True
layout_DRV8871_module_PCB_-125_25 | reference | unverified_electronics_envelope | True
layout_driver_IC_-125_25 | reference | unverified_electronics_envelope | True
layout_driver_terminal_-125_25 | reference | unverified_electronics_envelope | True
layout_driver_capacitor_-125_25 | reference | unverified_electronics_envelope | True
layout_driver_insulation_-95_-25 | reference | unverified_electronics_envelope | True
layout_DRV8871_module_PCB_-95_-25 | reference | unverified_electronics_envelope | True
layout_driver_IC_-95_-25 | reference | unverified_electronics_envelope | True
layout_driver_terminal_-95_-25 | reference | unverified_electronics_envelope | True
layout_driver_capacitor_-95_-25 | reference | unverified_electronics_envelope | True
layout_driver_insulation_-95_25 | reference | unverified_electronics_envelope | True
layout_DRV8871_module_PCB_-95_25 | reference | unverified_electronics_envelope | True
layout_driver_IC_-95_25 | reference | unverified_electronics_envelope | True
layout_driver_terminal_-95_25 | reference | unverified_electronics_envelope | True
layout_driver_capacitor_-95_25 | reference | unverified_electronics_envelope | True
layout_IMU_standoff_-10_-10 | reference | unverified_electronics_envelope | True
IMU_mount_bolt_-10_-10 | hardware | simplified_fastener | False
IMU_mount_topwasher_-10_-10 | hardware | simplified_fastener | False
IMU_mount_bottomwasher_-10_-10 | hardware | simplified_fastener | False
IMU_mount_nut_-10_-10 | hardware | simplified_fastener | False
layout_IMU_standoff_-10_10 | reference | unverified_electronics_envelope | True
IMU_mount_bolt_-10_10 | hardware | simplified_fastener | False
IMU_mount_topwasher_-10_10 | hardware | simplified_fastener | False
IMU_mount_bottomwasher_-10_10 | hardware | simplified_fastener | False
IMU_mount_nut_-10_10 | hardware | simplified_fastener | False
layout_IMU_standoff_10_-10 | reference | unverified_electronics_envelope | True
IMU_mount_bolt_10_-10 | hardware | simplified_fastener | False
IMU_mount_topwasher_10_-10 | hardware | simplified_fastener | False
IMU_mount_bottomwasher_10_-10 | hardware | simplified_fastener | False
IMU_mount_nut_10_-10 | hardware | simplified_fastener | False
layout_IMU_standoff_10_10 | reference | unverified_electronics_envelope | True
IMU_mount_bolt_10_10 | hardware | simplified_fastener | False
IMU_mount_topwasher_10_10 | hardware | simplified_fastener | False
IMU_mount_bottomwasher_10_10 | hardware | simplified_fastener | False
IMU_mount_nut_10_10 | hardware | simplified_fastener | False
layout_IMU_PCB | reference | unverified_electronics_envelope | True
layout_IMU_chip | reference | unverified_electronics_envelope | True
layout_IMU_header | reference | unverified_electronics_envelope | True
battery_pad_top_-45 | reference | battery_mount_reference | True
battery_pad_top_45 | reference | battery_mount_reference | True
battery_pad_bottom | reference | battery_mount_reference | True
battery_strap_-40 | reference | battery_mount_reference | True
battery_strap_40 | reference | battery_mount_reference | True
route_encoder | routing | illustrative_not_wiring_pinout | True
route_power | routing | illustrative_not_wiring_pinout | True
