lingkonglengfeng/nanhua-pendulum-car/chassis_fr4_v1/output/chassis_assembly_520_reference.step

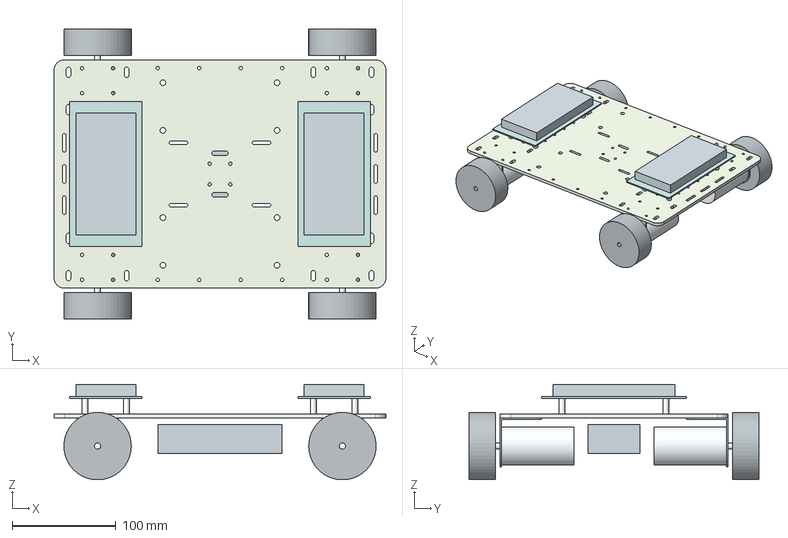
[picture p13: CAD file, 2026-10-20]
chassis_fr4_v1/output/chassis_assembly_520_reference.step
320.0 x 280.0 x 92.0 mm
FR4_MAIN_CHASSIS_part
ref_520_-1_-1_Lbracket_part
ref_520_-1_-1_motor_part
ref_520_-1_-1_shaft_part
ref_520_-1_-1_wheel_part
ref_520_-1_1_Lbracket_part
ref_520_-1_1_motor_part
ref_520_-1_1_shaft_part
ref_520_-1_1_wheel_part
ref_520_1_-1_Lbracket_part
ref_520_1_-1_motor_part
ref_520_1_-1_shaft_part
ref_520_1_-1_wheel_part
ref_520_1_1_Lbracket_part
ref_520_1_1_motor_part
ref_520_1_1_shaft_part
ref_520_1_1_wheel_part
ref_battery_120x50x28_part
ref_board_standoff_-1_-90_-50_part
ref_board_standoff_-1_-90_50_part
ref_board_standoff_-1_-130_-50_part
ref_board_standoff_-1_-130_50_part
ref_controller_board_-1_part
ref_board_components_-1_part
ref_board_standoff_1_90_-50_part
ref_board_standoff_1_90_50_part
ref_board_standoff_1_130_-50_part
ref_board_standoff_1_130_50_part
ref_controller_board_1_part
ref_board_components_1_part
