lingkonglengfeng/nanhua-pendulum-car/pcb_bottom_adapter_v1/output/step/03_chassis_adapter_pcb_assembly.step

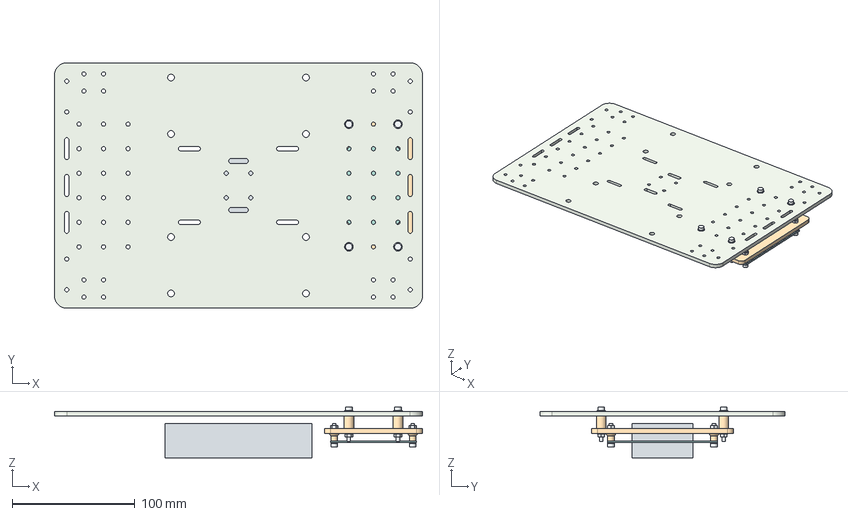
[picture p14: CAD file, 2026-10-20]
pcb_bottom_adapter_v1/output/step/03_chassis_adapter_pcb_assembly.step
300.0 x 200.0 x 41.5 mm
V3_CHASSIS_300x200x4_part
PRINT_ADAPTER_part
PCB_90x70_REFERENCE_part
BATTERY_120x50x28_REFERENCE_part
PRINT_SPACER_1_part
M3x25_CHASSIS_BOLT_1_part
CHASSIS_TOP_WASHER_1_part
CHASSIS_BOTTOM_WASHER_1_part
CHASSIS_M3_NUT_1_part
PRINT_SPACER_2_part
M3x25_CHASSIS_BOLT_2_part
CHASSIS_TOP_WASHER_2_part
CHASSIS_BOTTOM_WASHER_2_part
CHASSIS_M3_NUT_2_part
PRINT_SPACER_3_part
M3x25_CHASSIS_BOLT_3_part
CHASSIS_TOP_WASHER_3_part
CHASSIS_BOTTOM_WASHER_3_part
CHASSIS_M3_NUT_3_part
PRINT_SPACER_4_part
M3x25_CHASSIS_BOLT_4_part
CHASSIS_TOP_WASHER_4_part
CHASSIS_BOTTOM_WASHER_4_part
CHASSIS_M3_NUT_4_part
PCB_M3x16_BOLT_1_part
PCB_SMALL_WASHER_1_part
PCB_M3_NUT_1_part
PCB_M3x16_BOLT_2_part
PCB_SMALL_WASHER_2_part
PCB_M3_NUT_2_part
PCB_M3x16_BOLT_3_part
PCB_SMALL_WASHER_3_part
PCB_M3_NUT_3_part
PCB_M3x16_BOLT_4_part
PCB_SMALL_WASHER_4_part
PCB_M3_NUT_4_part
