lingkonglengfeng/nanhua-pendulum-car/pendulum_rod_weight/output/weight_assembly.step

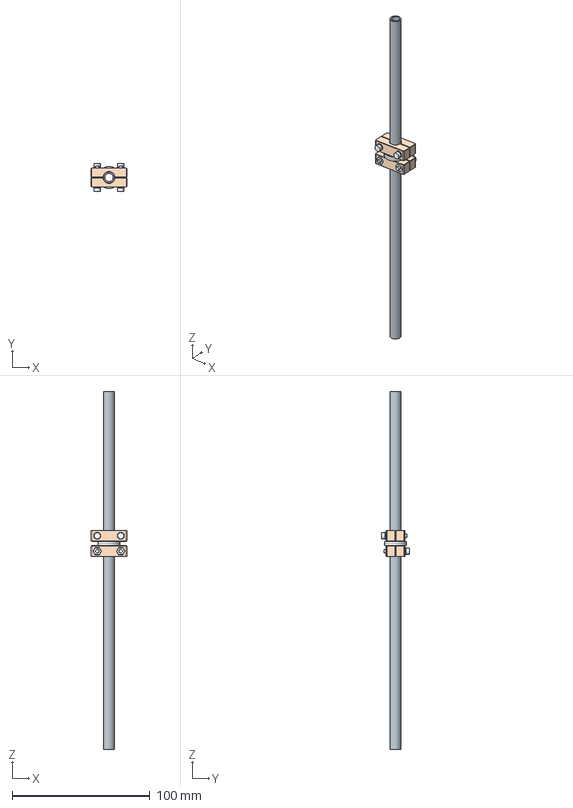
[picture p15: CAD file, 2026-10-20]
pendulum_rod_weight/output/weight_assembly.step
26.0 x 20.0 x 260.0 mm
weight_lower_head_part
weight_lower_nut_part
weight_lower_bolt0_part
weight_lower_smallwasher0_part
weight_lower_hexnut0_part
weight_lower_bolt1_part
weight_lower_smallwasher1_part
weight_lower_hexnut1_part
weight_upper_head_part
weight_upper_nut_part
weight_upper_bolt0_part
weight_upper_smallwasher0_part
weight_upper_hexnut0_part
weight_upper_bolt1_part
weight_upper_smallwasher1_part
weight_upper_hexnut1_part
weight_mass_washer_1_part
weight_mass_washer_2_part
existing_8mm_tube_reference_part
