lingkonglengfeng/nanhua-pendulum-car/pendulum_v3/output/assembly.step

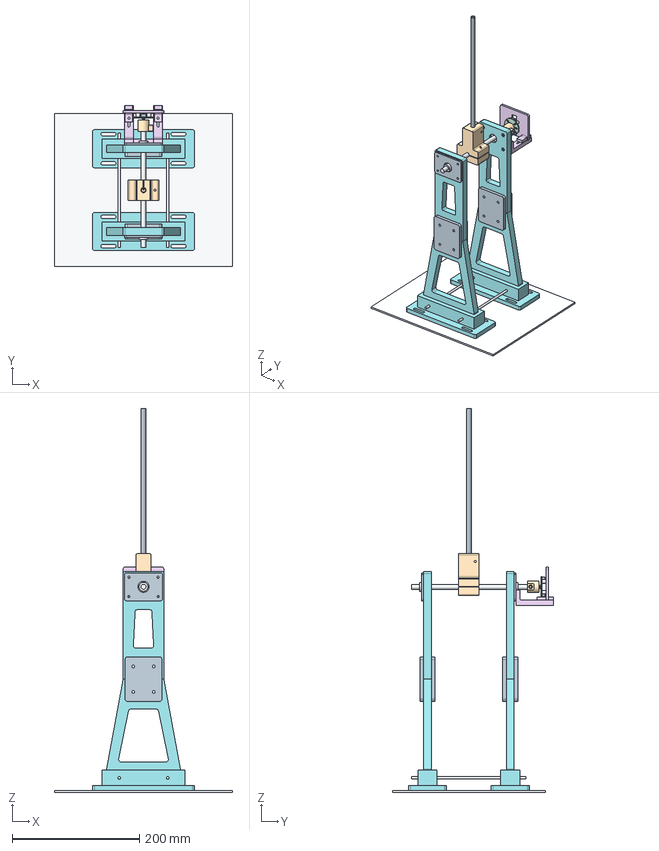
[picture p16: CAD file, 2026-10-20]
pendulum_v3/output/assembly.step
280.0 x 253.0 x 603.0 mm
base_L_part
lower_L_part
upper_L_part
splice_L_-1_part
splice_L_1_part
cover_L_part
608_L_part
collar_L_part
shim_L_part
base_R_part
lower_R_part
upper_R_part
splice_R_-1_part
splice_R_1_part
cover_R_part
608_R_part
collar_R_part
shim_R_part
shaft_8x190_part
rod_hub_part
tube_8x6x260_part
encoder_rail_part
encoder_carrier_part
magnet_cup_part
magnet_6x3_part
AS5600_D32_PCB_FROM_DRAWING_part
AS5600_PACKAGE_ENVELOPE_part
GH125_CONNECTOR_ENVELOPE_-1_part
GH125_CONNECTOR_ENVELOPE_1_part
NYLON_SPACER_6mm_0_part
NYLON_SPACER_6mm_1_part
NYLON_SPACER_6mm_2_part
NYLON_SPACER_6mm_3_part
M4_tie_rod_-38_part
M4_tie_rod_38_part
CHASSIS_DECK_ENVELOPE_ONLY_part
