lingkonglengfeng/nanhua-pendulum-car/vehicle_assembly_v1/output/vehicle_complete_520.step

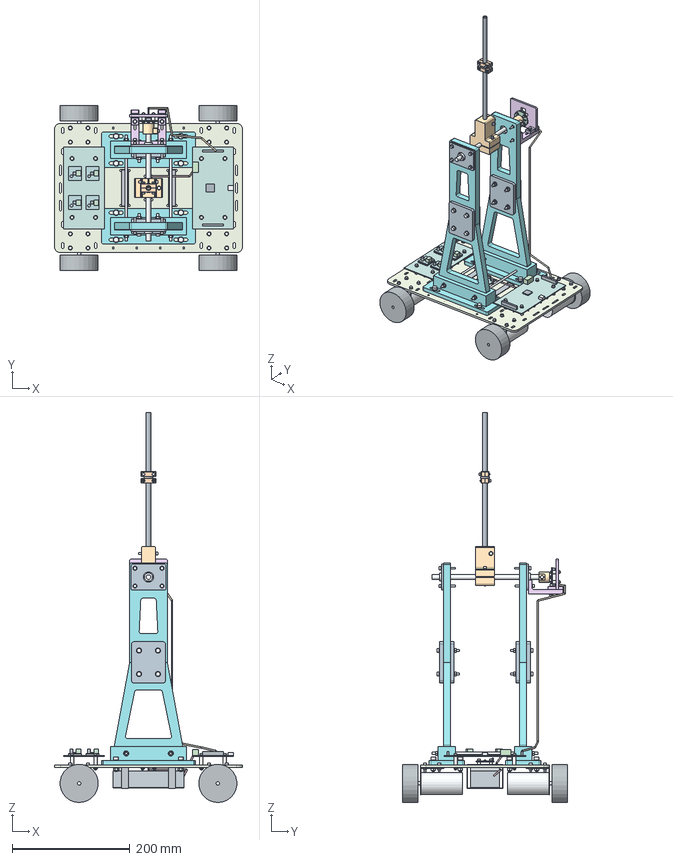
[picture p17: CAD file, 2026-10-20]
vehicle_assembly_v1/output/vehicle_complete_520.step
320.0 x 280.0 x 663.5 mm
base_L_part
lower_L_part
upper_L_part
splice_L_-1_part
splice_L_1_part
cover_L_part
608_L_part
collar_L_part
shim_L_part
base_R_part
lower_R_part
upper_R_part
splice_R_-1_part
splice_R_1_part
cover_R_part
608_R_part
collar_R_part
shim_R_part
shaft_8x190_part
rod_hub_part
tube_8x6x260_part
encoder_rail_part
encoder_carrier_part
magnet_cup_part
magnet_6x3_part
AS5600_D32_PCB_FROM_DRAWING_part
AS5600_PACKAGE_ENVELOPE_part
GH125_CONNECTOR_ENVELOPE_-1_part
GH125_CONNECTOR_ENVELOPE_1_part
NYLON_SPACER_6mm_0_part
NYLON_SPACER_6mm_1_part
NYLON_SPACER_6mm_2_part
NYLON_SPACER_6mm_3_part
M4_tie_rod_-38_part
M4_tie_rod_38_part
FR4_MAIN_CHASSIS_part
ref_520_-1_-1_Lbracket_part
ref_520_-1_-1_motor_part
ref_520_-1_-1_shaft_part
ref_520_-1_-1_wheel_part
ref_520_-1_1_Lbracket_part
ref_520_-1_1_motor_part
ref_520_-1_1_shaft_part
ref_520_-1_1_wheel_part
ref_520_1_-1_Lbracket_part
ref_520_1_-1_motor_part
ref_520_1_-1_shaft_part
ref_520_1_-1_wheel_part
ref_520_1_1_Lbracket_part
ref_520_1_1_motor_part
ref_520_1_1_shaft_part
ref_520_1_1_wheel_part
ref_battery_120x50x28_part
ref_board_standoff_-1_-90_-50_part
ref_board_standoff_-1_-90_50_part
ref_board_standoff_-1_-130_-50_part
ref_board_standoff_-1_-130_50_part
ref_controller_board_-1_part
ref_board_standoff_1_90_-50_part
ref_board_standoff_1_90_50_part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
