lingkonglengfeng/nanhua-pendulum-car/chassis_fr4_v1/output/chassis_assembly_370_reference.step

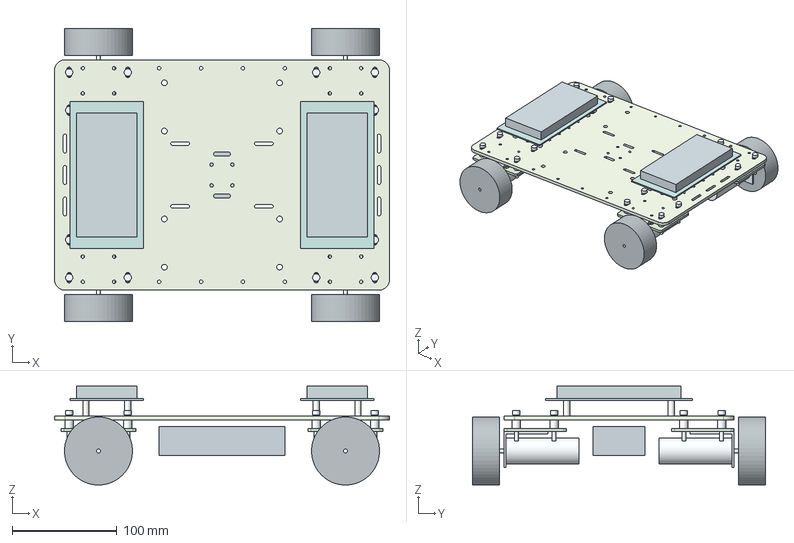
[picture p18: CAD file, 2026-10-20]
chassis_fr4_v1/output/chassis_assembly_370_reference.step
320.0 x 280.0 x 94.5 mm
FR4_MAIN_CHASSIS_part
ref_370_adapter_-1_-1_part
ref_370_standoff_-1_-1_-28_-18_part
ref_370_M4bolt_-1_-1_-28_-18_part
ref_370_standoff_-1_-1_-28_18_part
ref_370_M4bolt_-1_-1_-28_18_part
ref_370_standoff_-1_-1_28_-18_part
ref_370_M4bolt_-1_-1_28_-18_part
ref_370_standoff_-1_-1_28_18_part
ref_370_M4bolt_-1_-1_28_18_part
ref_370_adapter_-1_1_part
ref_370_standoff_-1_1_-28_-18_part
ref_370_M4bolt_-1_1_-28_-18_part
ref_370_standoff_-1_1_-28_18_part
ref_370_M4bolt_-1_1_-28_18_part
ref_370_standoff_-1_1_28_-18_part
ref_370_M4bolt_-1_1_28_-18_part
ref_370_standoff_-1_1_28_18_part
ref_370_M4bolt_-1_1_28_18_part
ref_370_adapter_1_-1_part
ref_370_standoff_1_-1_-28_-18_part
ref_370_M4bolt_1_-1_-28_-18_part
ref_370_standoff_1_-1_-28_18_part
ref_370_M4bolt_1_-1_-28_18_part
ref_370_standoff_1_-1_28_-18_part
ref_370_M4bolt_1_-1_28_-18_part
ref_370_standoff_1_-1_28_18_part
ref_370_M4bolt_1_-1_28_18_part
ref_370_adapter_1_1_part
ref_370_standoff_1_1_-28_-18_part
ref_370_M4bolt_1_1_-28_-18_part
ref_370_standoff_1_1_-28_18_part
ref_370_M4bolt_1_1_-28_18_part
ref_370_standoff_1_1_28_-18_part
ref_370_M4bolt_1_1_28_-18_part
ref_370_standoff_1_1_28_18_part
ref_370_M4bolt_1_1_28_18_part
ref_370_-1_-1_Lbracket_part
ref_370_-1_-1_motor_part
ref_370_-1_-1_shaft_part
ref_370_-1_-1_wheel_part
ref_370_-1_1_Lbracket_part
ref_370_-1_1_motor_part
ref_370_-1_1_shaft_part
ref_370_-1_1_wheel_part
ref_370_1_-1_Lbracket_part
ref_370_1_-1_motor_part
ref_370_1_-1_shaft_part
ref_370_1_-1_wheel_part
ref_370_1_1_Lbracket_part
ref_370_1_1_motor_part
ref_370_1_1_shaft_part
ref_370_1_1_wheel_part
ref_battery_120x50x28_part
ref_board_standoff_-1_-90_-50_part
ref_board_standoff_-1_-90_50_part
ref_board_standoff_-1_-130_-50_part
ref_board_standoff_-1_-130_50_part
ref_controller_board_-1_part
ref_board_components_-1_part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
