lingkonglengfeng/nanhua-pendulum-car/pcb_bottom_adapter_v2_center/output/step/03_center_chassis_adapter_pcb_assembly.step

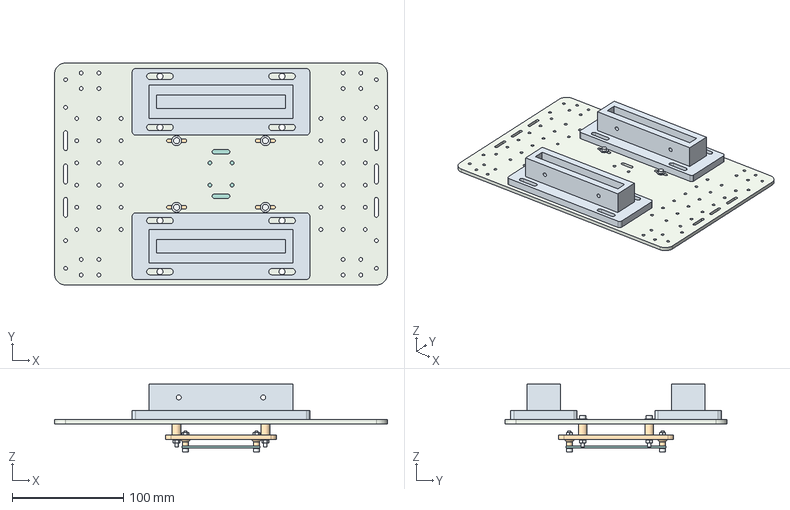
[picture p19: CAD file, 2026-10-20]
pcb_bottom_adapter_v2_center/output/step/03_center_chassis_adapter_pcb_assembly.step
300.0 x 200.0 x 61.1 mm
V3_CHASSIS_300x200x4_part
PRINT_ADAPTER_part
PCB_90x70_REFERENCE_part
EXISTING_PENDULUM_BASE_-1_part
EXISTING_PENDULUM_BASE_1_part
PRINT_SPACER_1_part
M3x25_CHASSIS_BOLT_1_part
CHASSIS_TOP_WASHER_OD9_1_part
CHASSIS_BOTTOM_WASHER_1_part
CHASSIS_M3_NUT_1_part
PRINT_SPACER_2_part
M3x25_CHASSIS_BOLT_2_part
CHASSIS_TOP_WASHER_OD9_2_part
CHASSIS_BOTTOM_WASHER_2_part
CHASSIS_M3_NUT_2_part
PRINT_SPACER_3_part
M3x25_CHASSIS_BOLT_3_part
CHASSIS_TOP_WASHER_OD9_3_part
CHASSIS_BOTTOM_WASHER_3_part
CHASSIS_M3_NUT_3_part
PRINT_SPACER_4_part
M3x25_CHASSIS_BOLT_4_part
CHASSIS_TOP_WASHER_OD9_4_part
CHASSIS_BOTTOM_WASHER_4_part
CHASSIS_M3_NUT_4_part
PCB_M3x16_BOLT_1_part
PCB_SMALL_WASHER_1_part
PCB_M3_NUT_1_part
PCB_M3x16_BOLT_2_part
PCB_SMALL_WASHER_2_part
PCB_M3_NUT_2_part
PCB_M3x16_BOLT_3_part
PCB_SMALL_WASHER_3_part
PCB_M3_NUT_3_part
PCB_M3x16_BOLT_4_part
PCB_SMALL_WASHER_4_part
PCB_M3_NUT_4_part
