lingkonglengfeng/nanhua-pendulum-car/chassis_fr4_v1/output/step/01_chassis_FR4_320x220x4.step

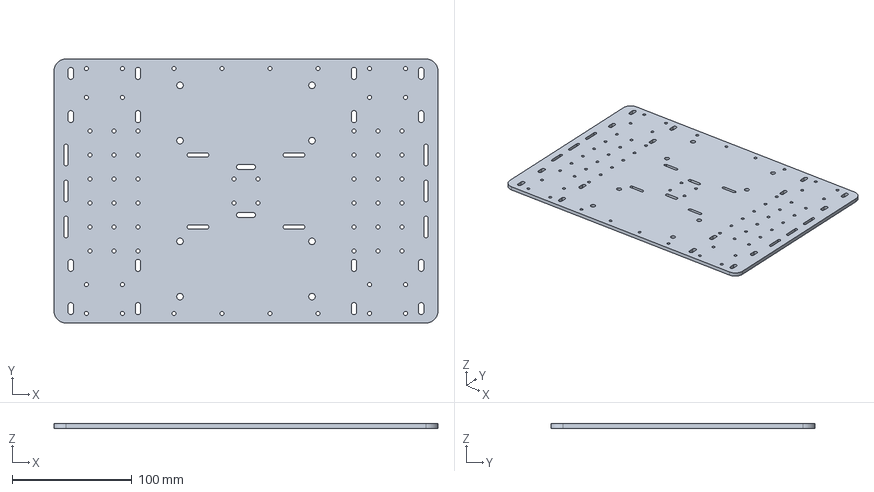
[picture p20: CAD file, 2026-10-20]
chassis_fr4_v1/output/step/01_chassis_FR4_320x220x4.step
320.0 x 220.0 x 4.00 mm
