lingkonglengfeng/nanhua-pendulum-car/chassis_fr4_v1/output/stl_reference/02_motor_adapter_adjustable_72x60x3.stl

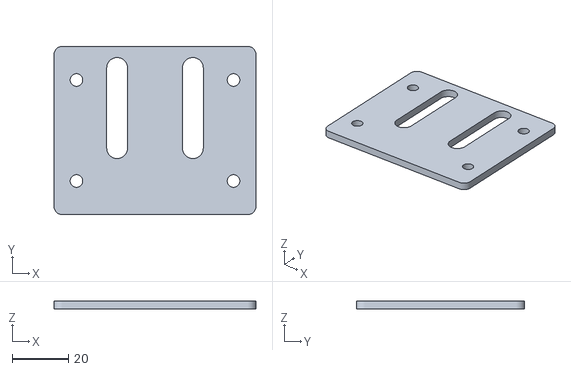
[picture p21: CAD file, 2026-10-20]
chassis_fr4_v1/output/stl_reference/02_motor_adapter_adjustable_72x60x3.stl
72.0 x 60.0 x 3.00
