lingkonglengfeng/nanhua-pendulum-car/chassis_fr4_v3_300x200/output/step/chassis_V3_direct_14x16_300x200x4.step

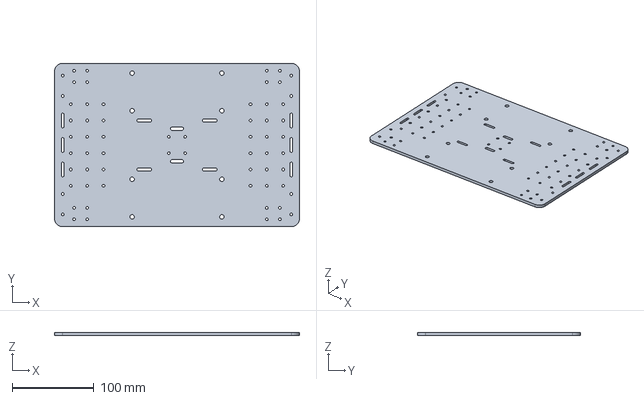
[picture p22: CAD file, 2026-10-20]
chassis_fr4_v3_300x200/output/step/chassis_V3_direct_14x16_300x200x4.step
300.0 x 200.0 x 4.00 mm
