lingkonglengfeng/nanhua-pendulum-car/pcb_bottom_adapter_v1/output/adapter_profile_reference.dxf

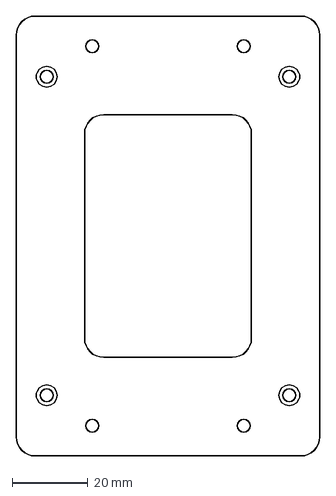
[picture p23: CAD file, 2026-10-20]
pcb_bottom_adapter_v1/output/adapter_profile_reference.dxf
80.0 x 116.0 mm
