lingkonglengfeng/nanhua-pendulum-car/pcb_bottom_adapter_v2_center/output/adapter_profile_reference.dxf

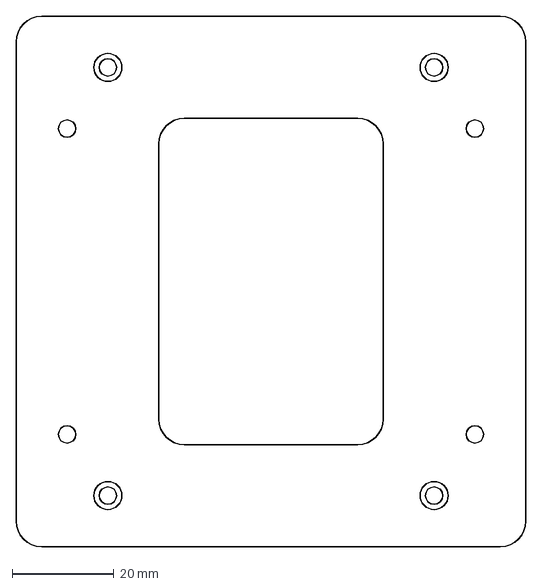
[picture p24: CAD file, 2026-10-20]
pcb_bottom_adapter_v2_center/output/adapter_profile_reference.dxf
100.0 x 104.0 mm
