lingkonglengfeng/nanhua-pendulum-car/pcb_bottom_adapter_v2_center/output/step/01_adapter_center_84x64_M3.step

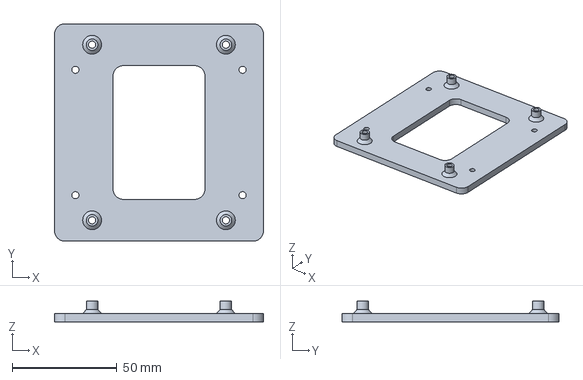
[picture p25: CAD file, 2026-10-20]
pcb_bottom_adapter_v2_center/output/step/01_adapter_center_84x64_M3.step
100.0 x 104.0 x 10.0 mm
