lingkonglengfeng/nanhua-pendulum-car/pendulum_v3/output/step/01_base_shoe.step

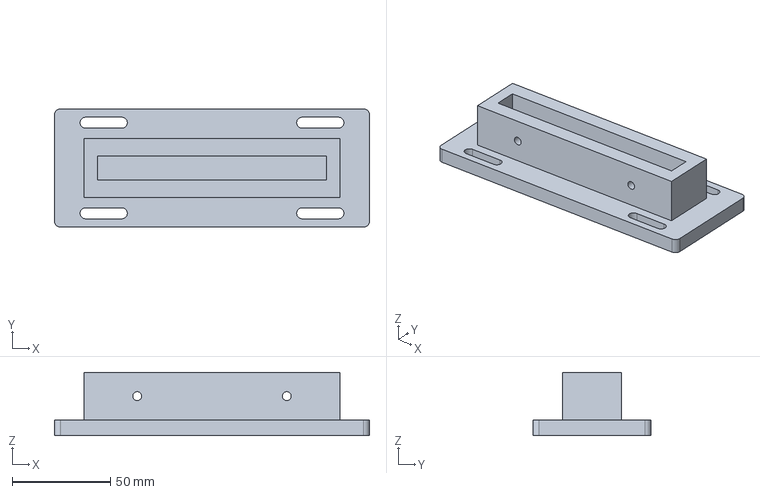
[picture p26: CAD file, 2026-10-20]
pendulum_v3/output/step/01_base_shoe.step
160.0 x 60.0 x 32.0 mm
