lingkonglengfeng/nanhua-pendulum-car/wheelset_14x16_v1/output/wheelset_adapter_14x16.step

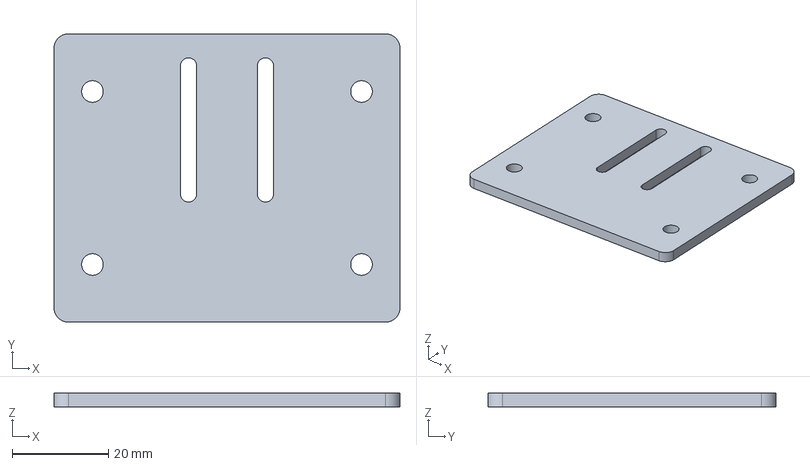
[picture p27: CAD file, 2026-10-20]
wheelset_14x16_v1/output/wheelset_adapter_14x16.step
72.0 x 60.0 x 3.00 mm
