lingkonglengfeng/nanhua-pendulum-car/pcb_bottom_adapter_v1/output/step/02_spacer_D8_H10_M3_qty4.step

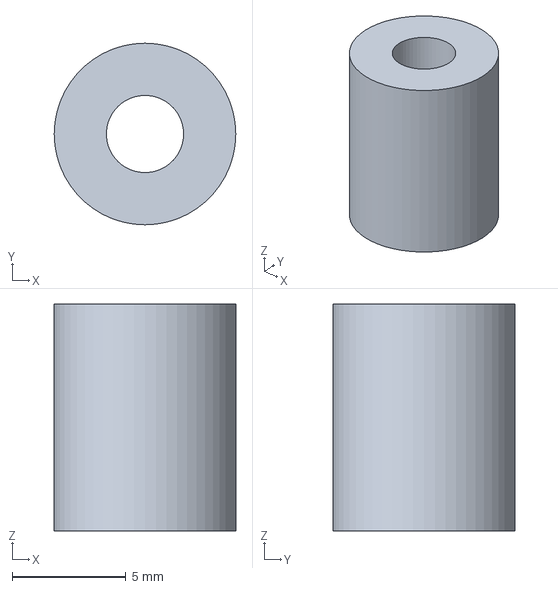
[picture p28: CAD file, 2026-10-20]
pcb_bottom_adapter_v1/output/step/02_spacer_D8_H10_M3_qty4.step
8.00 x 8.00 x 10.0 mm
