lingkonglengfeng/nanhua-pendulum-car/pendulum_rod_weight/output/step/11_weight_clamp_head.step

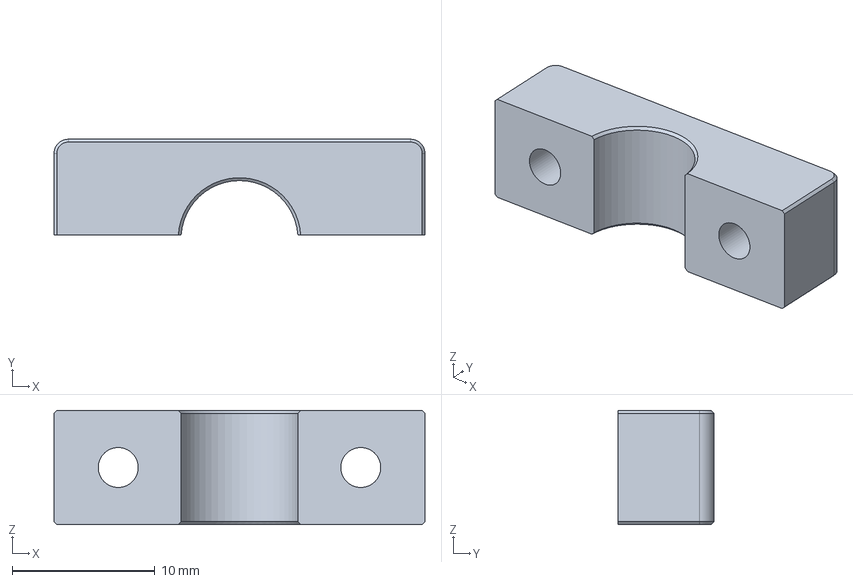
[picture p29: CAD file, 2026-10-20]
pendulum_rod_weight/output/step/11_weight_clamp_head.step
26.0 x 6.70 x 8.00 mm
