lingkonglengfeng/nanhua-pendulum-car/pcb_bottom_adapter_v1/output/step/01_adapter_84x64_M3.step

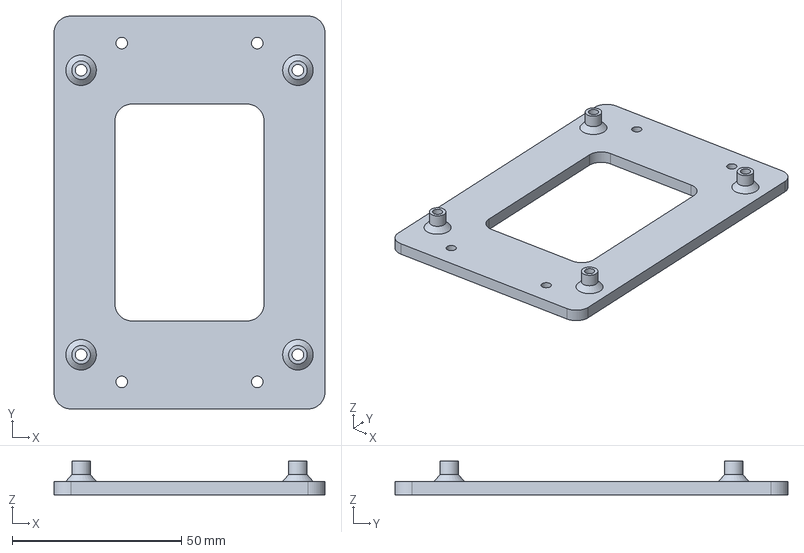
[picture p31: CAD file, 2026-10-20]
pcb_bottom_adapter_v1/output/step/01_adapter_84x64_M3.step
80.0 x 116.0 x 10.0 mm
