lingkonglengfeng/nanhua-pendulum-car/pendulum_v3/output/step/04_splice_plate.step

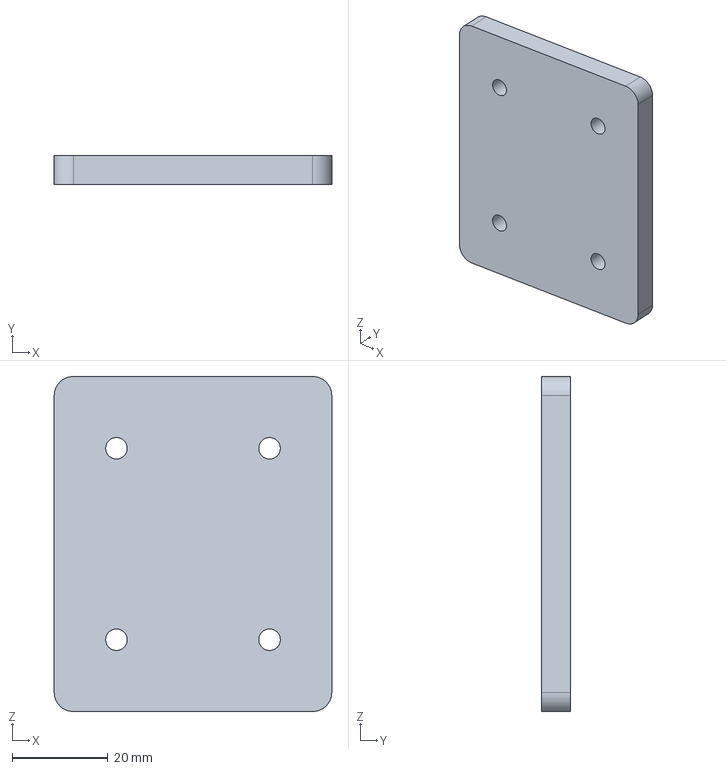
[picture p32: CAD file, 2026-10-20]
pendulum_v3/output/step/04_splice_plate.step
58.0 x 6.00 x 70.0 mm
