lingkonglengfeng/nanhua-pendulum-car/pendulum_v3/output/step/07_encoder_rail.step

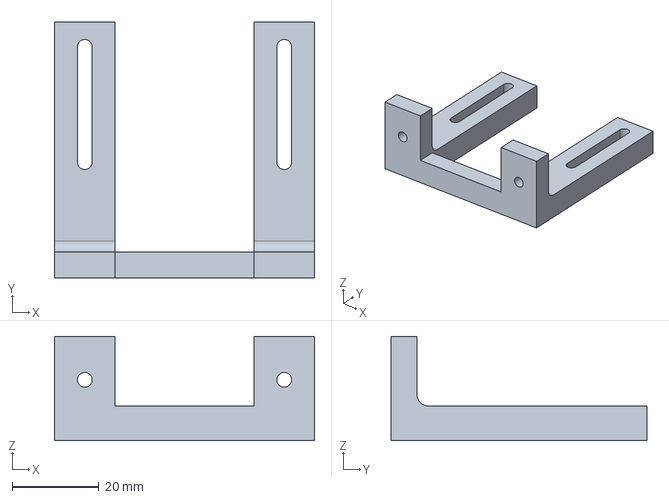
[picture p33: CAD file, 2026-10-20]
pendulum_v3/output/step/07_encoder_rail.step
60.0 x 59.0 x 24.0 mm
