lingkonglengfeng/nanhua-pendulum-car/pendulum_v3/output/step/08_encoder_carrier_PH2_4P_D2p8_edgegap16p75.step

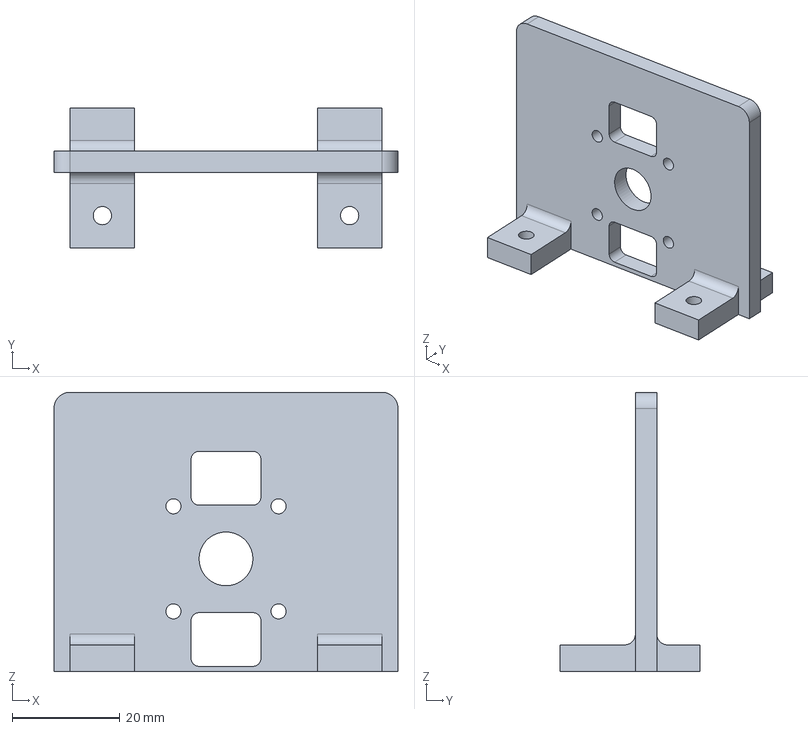
[picture p34: CAD file, 2026-10-20]
pendulum_v3/output/step/08_encoder_carrier_PH2_4P_D2p8_edgegap16p75.step
64.0 x 26.0 x 52.0 mm
