lingkonglengfeng/nanhua-pendulum-car/pendulum_v3/output/step/02_lower_arm.step

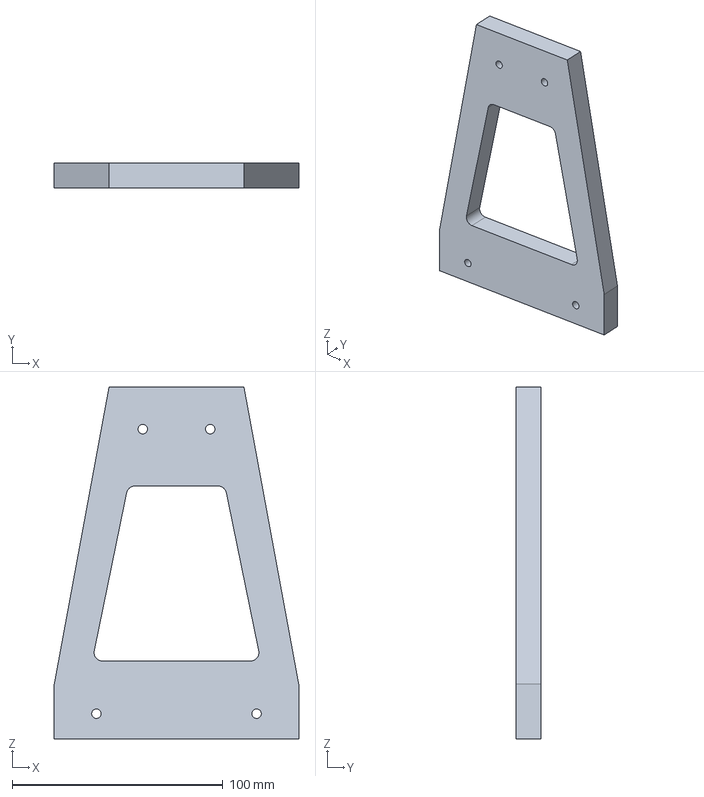
[picture p35: CAD file, 2026-10-20]
pendulum_v3/output/step/02_lower_arm.step
116.0 x 12.0 x 167.0 mm
