lingkonglengfeng/nanhua-pendulum-car/pendulum_v3/output/step/03_upper_arm.step

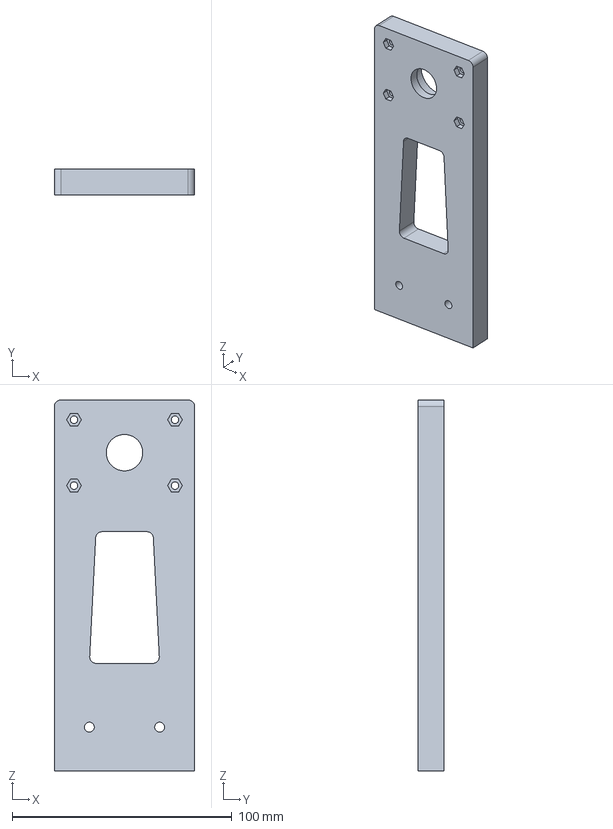
[picture p36: CAD file, 2026-10-20]
pendulum_v3/output/step/03_upper_arm.step
64.0 x 12.0 x 169.0 mm
