lingkonglengfeng/nanhua-pendulum-car/pendulum_v3/output/step/08_encoder_carrier_PH2_4P_M3_pilot_D2p6_H5.step

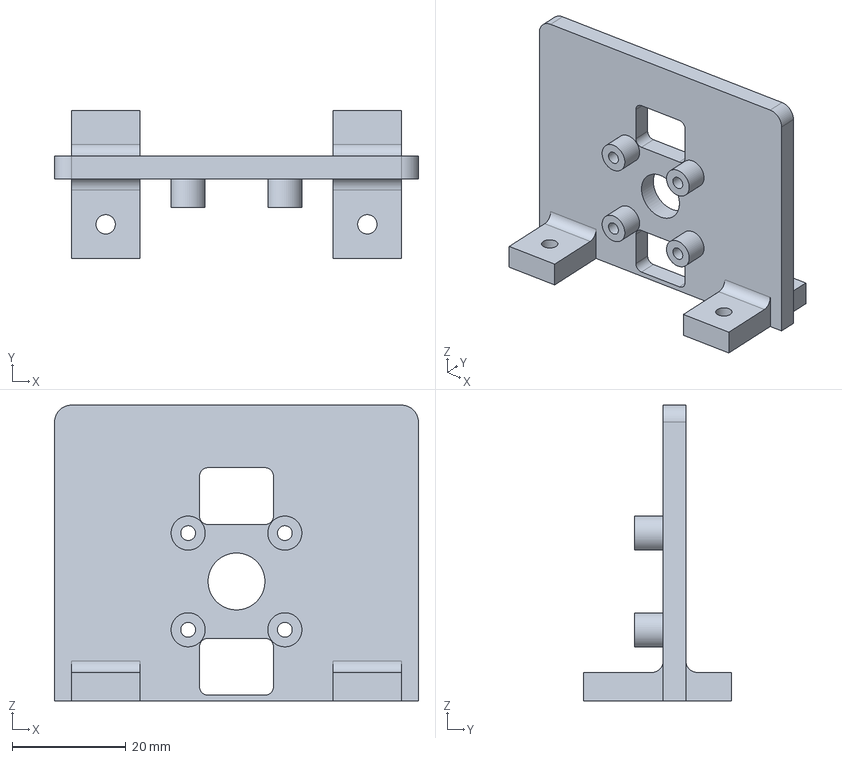
[picture p37: CAD file, 2026-10-20]
pendulum_v3/output/step/08_encoder_carrier_PH2_4P_M3_pilot_D2p6_H5.step
64.0 x 26.0 x 52.0 mm
