lingkonglengfeng/nanhua-pendulum-car/pendulum_v3/output/step/09_magnet_cup.step

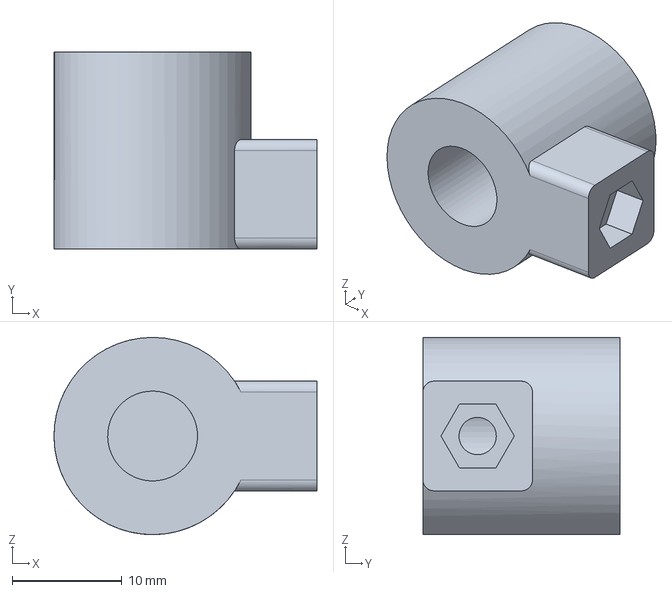
[picture p38: CAD file, 2026-10-20]
pendulum_v3/output/step/09_magnet_cup.step
24.0 x 18.0 x 18.0 mm
