lingkonglengfeng/nanhua-pendulum-car/pendulum_v3/output/step/10_fit_coupon.step

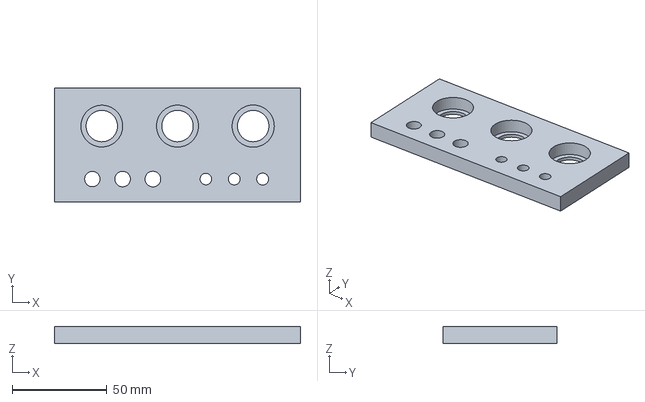
[picture p39: CAD file, 2026-10-20]
pendulum_v3/output/step/10_fit_coupon.step
130.0 x 60.0 x 9.00 mm
