lingkonglengfeng/nanhua-pendulum-car/pendulum_v3/output/step/05_bearing_cover.step

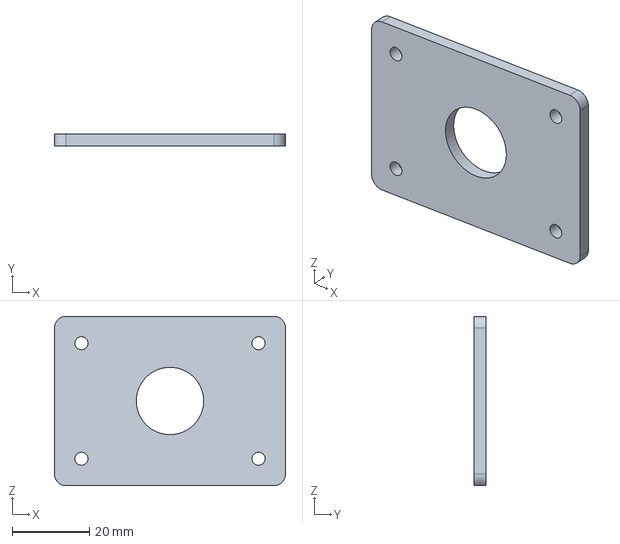
[picture p40: CAD file, 2026-10-20]
pendulum_v3/output/step/05_bearing_cover.step
60.0 x 3.00 x 44.0 mm
