lingkonglengfeng/nanhua-pendulum-car/pendulum_v3/output/step/06_rod_hub.step

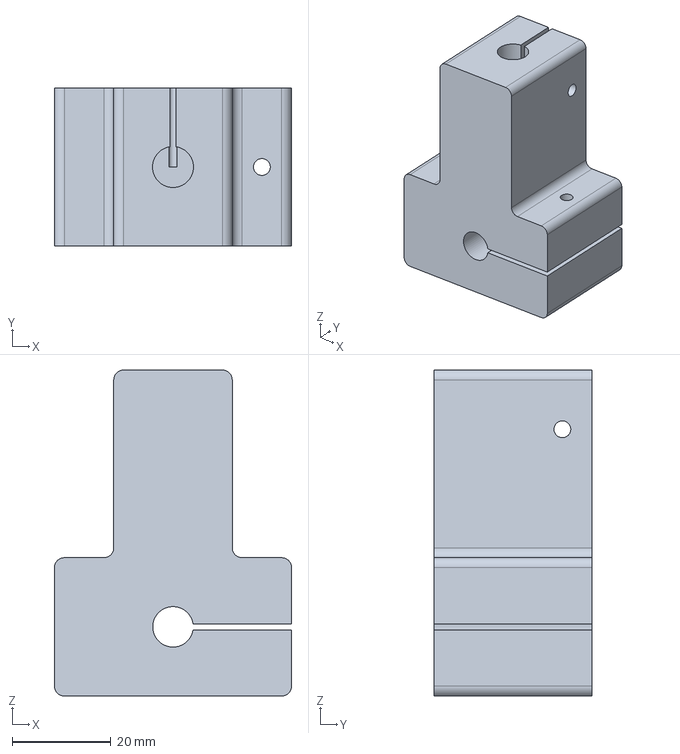
[picture p41: CAD file, 2026-10-20]
pendulum_v3/output/step/06_rod_hub.step
48.0 x 32.0 x 66.0 mm
