lingkonglengfeng/nanhua-pendulum-car/(list of files, cad)

Other CAD files:
chassis_fr4_v2_direct/output/step/chassis_V2_direct_14x16_320x220x4.step
chassis_fr4_v2_direct/output/stl_reference/chassis_V2_direct_14x16_320x220x4.stl
chassis_fr4_v3_300x200/output/stl_reference/chassis_V3_direct_14x16_300x200x4.stl
chassis_fr4_v1/output/step/02_motor_adapter_adjustable_72x60x3.step
chassis_fr4_v1/output/stl_reference/01_chassis_FR4_320x220x4.stl
pcb_bottom_adapter_v2_center/output/step/02_spacer_D8_H10_M3_qty4.step
chassis_fr4_v1/output/step/03_motor_adapter_blank_72x60x3.step
chassis_fr4_v1/output/stl_reference/03_motor_adapter_blank_72x60x3.stl
pendulum_v3/output/step/08_encoder_carrier_PH2_4P.step
pendulum_v3/output/step/08_encoder_carrier.step
chassis_fr4_v1/output/dxf/01_chassis_FR4_320x220x4.dxf
chassis_fr4_v1/output/dxf/02_motor_adapter_adjustable_72x60x3.dxf
chassis_fr4_v1/output/dxf/03_motor_adapter_blank_72x60x3.dxf
chassis_fr4_v2_direct/output/dxf/chassis_V2_direct_14x16_320x220x4.dxf
chassis_fr4_v3_300x200/output/dxf/chassis_V3_direct_14x16_300x200x4.dxf
pcb_bottom_adapter_v1/output/stl/01_adapter_84x64_M3.stl
pcb_bottom_adapter_v1/output/stl/02_spacer_D8_H10_M3_qty4.stl
pcb_bottom_adapter_v2_center/output/stl/01_adapter_center_84x64_M3.stl
pendulum_rod_weight/output/3mf/11_weight_clamp_head.3mf
pendulum_rod_weight/output/3mf/12_weight_clamp_nut.3mf
pendulum_rod_weight/output/step/12_weight_clamp_nut.step
pendulum_rod_weight/output/stl/11_weight_clamp_head.stl
pendulum_rod_weight/output/stl/12_weight_clamp_nut.stl
pendulum_v1/output/3mf/01_base_shoe.3mf
pendulum_v1/output/3mf/02_lower_arm.3mf
pendulum_v1/output/3mf/03_upper_arm.3mf
pendulum_v1/output/3mf/04_splice_plate.3mf
pendulum_v1/output/3mf/05_bearing_cover.3mf
pendulum_v1/output/3mf/06_rod_hub.3mf
pendulum_v1/output/3mf/07_encoder_rail.3mf
pendulum_v1/output/3mf/08_encoder_carrier.3mf
pendulum_v1/output/3mf/09_magnet_cup.3mf
pendulum_v1/output/3mf/10_fit_coupon.3mf
pendulum_v1/output/assembly.step
pendulum_v1/output/step/01_base_shoe.step
pendulum_v1/output/step/02_lower_arm.step
pendulum_v1/output/step/03_upper_arm.step
pendulum_v1/output/step/04_splice_plate.step
pendulum_v1/output/step/05_bearing_cover.step
pendulum_v1/output/step/06_rod_hub.step
pendulum_v1/output/step/07_encoder_rail.step
pendulum_v1/output/step/08_encoder_carrier.step
pendulum_v1/output/step/09_magnet_cup.step
pendulum_v1/output/step/10_fit_coupon.step
pendulum_v1/output/stl/02_lower_arm.stl
pendulum_v1/output/stl/03_upper_arm.stl
pendulum_v1/output/stl/04_splice_plate.stl
pendulum_v1/output/stl/05_bearing_cover.stl
pendulum_v1/output/stl/06_rod_hub.stl
pendulum_v1/output/stl/07_encoder_rail.stl
pendulum_v1/output/stl/08_encoder_carrier.stl
pendulum_v1/output/stl/09_magnet_cup.stl
pendulum_v2/output/3mf/01_base_shoe.3mf
pendulum_v2/output/3mf/02_lower_arm.3mf
pendulum_v2/output/3mf/03_upper_arm.3mf
pendulum_v2/output/3mf/04_splice_plate.3mf
pendulum_v2/output/3mf/05_bearing_cover.3mf
pendulum_v2/output/3mf/06_rod_hub.3mf
pendulum_v2/output/3mf/07_encoder_rail.3mf
pendulum_v2/output/3mf/08_encoder_carrier.3mf
pendulum_v2/output/3mf/09_magnet_cup.3mf
pendulum_v2/output/3mf/10_fit_coupon.3mf
pendulum_v2/output/assembly.step
pendulum_v2/output/step/01_base_shoe.step
pendulum_v2/output/step/02_lower_arm.step
pendulum_v2/output/step/03_upper_arm.step
pendulum_v2/output/step/04_splice_plate.step
pendulum_v2/output/step/05_bearing_cover.step
pendulum_v2/output/step/06_rod_hub.step
pendulum_v2/output/step/07_encoder_rail.step
pendulum_v2/output/step/08_encoder_carrier.step
pendulum_v2/output/step/09_magnet_cup.step
pendulum_v2/output/step/10_fit_coupon.step
pendulum_v2/output/stl/02_lower_arm.stl
pendulum_v2/output/stl/03_upper_arm.stl
pendulum_v2/output/stl/04_splice_plate.stl
pendulum_v2/output/stl/05_bearing_cover.stl
pendulum_v2/output/stl/06_rod_hub.stl
pendulum_v2/output/stl/08_encoder_carrier.stl
pendulum_v2/output/stl/09_magnet_cup.stl
pendulum_v3/output/3mf/01_base_shoe.3mf
pendulum_v3/output/3mf/02_lower_arm.3mf
pendulum_v3/output/3mf/03_upper_arm.3mf
pendulum_v3/output/3mf/04_splice_plate.3mf
pendulum_v3/output/3mf/05_bearing_cover.3mf
pendulum_v3/output/3mf/06_rod_hub.3mf
pendulum_v3/output/3mf/07_encoder_rail.3mf
pendulum_v3/output/3mf/08_encoder_carrier.3mf
pendulum_v3/output/3mf/09_magnet_cup.3mf
pendulum_v3/output/3mf/10_fit_coupon.3mf
pendulum_v3/output/stl/01_base_shoe.stl
pendulum_v3/output/stl/07_encoder_rail.stl
pendulum_v3/output/stl/08_encoder_carrier.stl
pendulum_v3/output/stl/10_fit_coupon.stl
wheelset_14x16_v1/output/wheelset_adapter_14x16.dxf
wheelset_14x16_v1/output/wheelset_adapter_14x16.stl
