lingkonglengfeng/nanhua-pendulum-car/chassis_fr4_v1/output/制造与装配说明.md

# 倒立摆小车 FR4 底板 V1

本版是整车承载底板，不是装在旧 235×140 底板上的转接板。尺寸为前后 X=320、左右 Y=220、厚 4，四角 R10。保留 V3 的 130 支撑臂中心距和两个 160×60 底座，兼顾前后电子模块空间、板下电池和四个轮组。

按本次题目，为单轴倒立摆稳摆、抗小幅扰动、移动到 1.5 m 正方形顶点提供机械安装基础；保留原结构的下垂空间。题目未明确的初态/人工辅助判定仍由出题方确认。底板本身不能保证完成控制指标。

## 本次交付与制造数量

| 文件前缀 | 成品尺寸 | 材料建议 | 数量 |
|---|---|---|---:|
| 01_chassis_FR4_320x220x4 | 320×220×4 | 无覆铜 FR4 环氧玻纤板 | 1 |
| 02_motor_adapter_adjustable_72x60x3 | 72×60×3 | FR4 或 3 mm 铝板 | 用 370 转接时 4；当前 520 直装不需要 |
| 03_motor_adapter_blank_72x60x3 | 72×60×3 | FR4 或 3 mm 铝板 | 可选，替代 02，不是两种都装 |

主板有 100 个孔/槽。按密度 1.9 g/cm³ 估算，开孔后约 518 g；不是轻量化极限方案。转接片约 21 g/片。整车最终质量可能超过此前电机讨论中假设的 1.5–2 kg，装车后应称重并复核加速能力。

加工使用 DXF 的所有 `CUT_` 图层，单位 mm、比例 1:1。外轮廓为闭合圆角多段线，长槽为闭合圆弧多段线，圆孔为圆实体。DXF 不含厚度，厚度以文件名和 STEP 为准。禁止按 PNG 截图比例打孔。

自己加工时可使用 `drill_template_1to1_A3.svg`：A3 横向、100% 实际尺寸打印，关闭“适应页面”。先量底部 100 mm 标尺，并用实物底座和金属 L 支架核对纸上孔位，再转印到板材。A4 缩印或截图打印不可用作钻孔定位。

建议尺寸目标：外形 ±0.2、孔中心位置 ±0.15；孔径确保紧固件能自由通过。实际加工厂能否满足需报价时确认。全为通孔，不在 FR4 上攻承力螺纹，不做沉头窝。孔边、外边去毛刺，玻纤板加工需控制粉尘。

## 孔位分区

坐标原点在板中心，X 向车头，Y 左右；底板上表面 Z=0。孔位编号对应 `hole_coordinates_mm.csv` 和 `hole_features.json`。

| 用途 | 数量 | 布置 |
|---|---:|---|
| 现有倒立摆底座 | 8 个 Ø5.5 | X=±55；Y=±42、±88，所有组合 |
| 520 金属 L 支架直装 | 16 个 Ø3.4 | X=±103、±133；Y=±78、±102，所有组合 |
| 可调电机转接片固定 | 16 个 10×4.5 长槽 | X=±90、±146；Y=±62、±98；槽长沿 Y |
| 前后电子模块 | 36 个 Ø3.4 | X=±90、±110、±130；Y=±10、±30、±50；20 mm 基本网格 |
| 中央 IMU | 4 个 Ø3.4 | X=±10、Y=±10，20×20 孔阵 |
| 前后传感器/附件 | 6 个 18×3.4 长槽 | X=±150；Y=−30、0、30；槽长沿 Y |
| 板下电池扎带 | 4 个 18×3.5 长槽 | X=±40，Y=±30，槽长沿 X |
| 中央走线 | 2 个 16×4 长槽 | X=0，Y=±20，槽长沿 X |
| 侧边扩展 | 8 个 Ø3.4 | X=±20、±60；Y=±102 |

孔阵为通用接口，**不是已验证的 G407 专用孔位**。若主控或传感器的四孔不落在孔阵上，使用小型转接片/有槽安装条和绝缘隔柱固定，不要强行弯板对孔。

## 520 的安装

用户提供的支架图存放在 `reference/520_bracket.jpg`：底部 40×40、孔距 30×24、4×Ø3.4、板厚 1.5；立面总高 47、安装孔阵中心距底面 27、前端 6×Ø3.1 位于 Ø31 圆周。**27 不是已经确认的电机出轴高度**：长圆开口可容纳偏置输出轴，实际还要结合电机正面尺寸图。折弯内半径未标明，模型使用外包络与孔位参考。

四个支架翻转安装在底板下表面，30 mm 孔距沿 X、24 mm 沿 Y，电机轴朝车外。每个支架用 4 颗 M3×12 螺丝、两侧平垫圈和螺母固定，共 16 套；长度按 4 mm FR4+1.5 mm 钢支架估算，实物垫圈/螺母不同时核对长度。建议板面使用较大外径的平垫圈分散压力，勿把 FR4 拧裂。电机与支架的短螺丝按电机厂家允许旋入深度选，不能用底板长螺丝代替。

预览暂把输出轴放在孔阵中心 Z=−31。以 Ø65、宽 26 的轮胎包络为例：轴距 236，轮中心左右间距约 254，车体连轮总宽约 280，底板上表面名义离地约 63.5。若轴线相对孔阵中心上下偏 7，离地高度相应变为约 56.5–70.5，因此这些不是实车保证尺寸。轮毂需要让轮胎内侧距板边至少 3 mm；模型是 4 mm，实际轮毂插深和电机轴伸长尚未确认，不能直接把轮子推到底。

520 默认方案不安装 02/03 转接片或 8 mm 电机隔柱。

## 370 的安装范围

370 的 L 支架尚未提供尺寸，主板为其保留可更换接口。02 转接片的主板接口为 56×36 的四个 Ø4.5 孔，通过 8 mm 长 M4 金属隔柱装在主板下方，再将 370 L 支架固定在转接片下面。每片需 4 套 M4×25、平垫圈、螺母以及 4 个 8 mm 隔柱，四片合计各 16。

02 中间两条槽总长 36、宽 7.4、X 中心距 27，槽沿 Y；在模型指定中心位置，M3 底脚孔可覆盖约 24–30 的横向孔距和 0–30 的纵向孔距。已检查 24/27/30 与 0/12/20/24/30 的组合。宽槽必须用外径约 12 的大平垫圈或合适压板跨住，不能只用小螺丝头压槽。

该范围不是所有“370 支架”都通用的承诺。拿到实际支架后核对孔位、底脚外形、轴高和输出轴。超出范围时，在 03 留白转接片上按实物开孔，保留其标准四孔接口即可；原主板不需跟着改孔。留白片上的新增孔也要避开现有四孔并留足边距。

参考 370 示意脚厚 2 mm；L 支架到转接片暂按 M3×12 配大垫圈和螺母。8 mm 隔柱为这层螺母和螺丝尾端提供空间，装好确认不顶到主板。预览中的 370 轴高和外形都是假设，不能用于电机支架加工。

四个轮组应使用同一种电机/支架组合，不建议在一辆车上混用 370 和 520，以免轴高、速度和响应不一致。

## 倒立摆、电池与电子模块

原 V3 两底座放在主板上，用原有 8 个长圆孔对准主板 Ø5.5 孔。初始可配 M5×20、平垫圈和螺母共 8 套，按 8 mm 旧底座+4 mm 主板核对实际螺纹啮合。支撑中心距保持 130，摆轴高度仍为安装面上方 320，摆长 280，原 8 mm 光轴、AS5600 背板和可调配重无需改变。

电池放在主板下方中央，用软垫/绝缘支撑和两条绑带固定。预览包络为 120×50×28，顶部距板下表面 6 mm，为中央螺母和螺丝尾端留空间；520 零偏置参考下其底面距地约 25.5，出轴上下偏 7 时约 18.5–32.5。实际电池还要留接头、扎带扣和缓冲垫空间，检查所有螺丝尾端都没有顶到电池。

前后各放一个约 70×140 的电子模块参考板，使用约 15 mm 绝缘隔柱；元器件顶部包络为 Z=28.6。它们用于展示布局，不代表 G407 外形已经核实。前后位置可互换：主控一端、驱动/电源另一端，重物尽量低置并靠近中心。

中央 IMU 区建议器件连安装件总高不超过 15，避开原两根底部横杆；其余中央区域保留摆动通道。原摆杆全周扫掠最低约 Z=39.97，示意电子模块顶部比它低约 11.37。实际插头和线缆也要计入高度，不能让线拱到摆杆路径中。

## 验证和限制

已完成有效单实体、STL 封闭网格、DXF 毫米单位与实体数量回读、主板孔间距计算、旧底座孔位、520 四孔对位、转接片孔位范围及参考轮组/电池空间检查。底盘 STEP 是装配参考，主板 STEP/DXF 才是加工文件。

没有完成实物加工、螺丝预紧、底板刚度/模态、抗倾覆或控制性能试验。特别是底板跨度和整车质量已增大，装车后先检查高支架根部是否随加减速明显晃动，再整定控制参数。需加强时可增加金属加强条，而不宜只靠大力拧紧螺丝。

`chassis_assembly_520_reference.step` 显示当前已知支架的直装方案；`chassis_assembly_370_reference.step` 显示待核对的转接方案。独立 HTML 可切换两种模式，三维不可用时会显示装配图；它不是动力学仿真。
