lingkonglengfeng/nanhua-pendulum-car/pendulum_v3/output/采购与装配说明.md

# 车载倒立摆打印结构 采购与装配说明

当前为 V3 AS5600 圆板适配版。只有 08 号背板相对 V2 改变，01–07、09、10 均不变，已有底座继续使用。圆角结构保留。编码器安装的完整说明见同目录 `AS5600安装说明.md`。

这套结构让摆杆绕小车左右方向的一根被动转轴转动，小车通过前后加速稳摆。支撑臂与夹具打印，转轴、轴承和摆杆使用采购金属件；编码器只测角度，不承担摆杆载荷。所有尺寸均为 mm。

模型按 A1 mini 的 180 × 180 × 180 成型范围设计，最大零件平放后的长度 169。9 种功能零件共 16 件，另有 1 块配合试打块。无需多色打印。

## 先看这些尺寸

| 项目 | V3 尺寸或约束 |
|---|---|
| 支撑臂中心间距 | 130 |
| 摆轴距底盘安装面 | 320，不是离地高度 |
| 摆杆轴心到末端 | 280 |
| 采购铝管切割长度 | 260；管底位于摆轴上方 20，插入夹座约 32 |
| 下垂扫掠对底盘的保守净空 | 约 39.97，不包含端帽、变形和额外线缆 |
| 两个底座合计占地 | 前后 160 × 左右 190 |
| 顶部编码器端的最外位置 | 比右支撑中心向外约 68；预留模块接线空间 |
| 底盘选购起点 | 可用安装面至少约 280 × 240，优先刚性好的金属板底盘 |
| 底盘安装孔 | 每底座 4 个 M5 长圆孔，左右两底座合计 8 个；可能需要自行钻孔 |

不要把电池、主控或横梁布置在中央摆动扫掠区。保守做法是底盘中央沿前后方向留出至少 50 mm 宽的通道，并让通道内器件高度不超过 15 mm。280 mm 是轴心到末端，不是购买管材的长度。增加端帽或配重后必须重新检查扫掠半径。

底盘安装面越高，整车总高度也越高；直立杆端在底盘安装面上方约 600。底盘轮组、电机、驱动、电池和主控不包含在这份上部机构模型中。底盘电机仍需结合整车质量和电机板型号确定。

## 采购清单

| 物料 | 规格与采购关键词 | 数量 | 说明 |
|---|---|---:|---|
| 金属转轴 | Ø8 精密光轴，长 190 | 1 | 让商家切割、去毛刺；不要用螺纹杆作摆轴。装配时轴心相对两塔中心左右不对称：编码器侧伸出较长 |
| 深沟球轴承 | 608，内径 8、外径 22、宽 7，优先低阻力 ZZ 型 | 2 | 轴承必须转动顺畅；不要为高粘度润滑或紧配合损失过多摆动能量 |
| 轴用定位环 | 用户选定的内径 8、外径 14、厚 6，带紧定螺钉 | 2 | V2 装配参考已更新；外径必须能通过端盖 17.5 孔；轴向位置在装配时调整 |
| 轴端薄垫片 | 内径约 8.2、外径约 11、厚约 0.5 | 2–4 | 放在轴承内圈与定位环之间；不能压到密封盖或外圈；备薄垫片调节 |
| 摆杆 | 铝管，外径 8、内径 6，切割长 260 | 1 | 先用无顶部配重的轻杆；买较长管材也可以自行切割并去毛刺 |
| 磁编码器模块 | 用户图中的 AS5600 圆板，Ø32、厚 1.6、六个长槽、GH1.25-4P 插座 | 1 | 按卖家引脚图确认 I²C 和供电接法；机械图不能确定插座针序 |
| 磁铁 | 编码器用径向/直径方向充磁，Ø6 × 3 | 1–2 | 必须核对“直径方向充磁”；普通轴向充磁圆片不能替代 |
| 打印耗材 | 1.75 PETG，先用单色 | 1 卷 | V2 结构较厚；实际耗材量由切片决定。PLA/PLA+ 可用于尺寸试装，注意电机附近温升 |
| 胶水 | 少量适合塑料与磁铁的环氧胶 | 少量 | 固定磁铁；不要流入轴承、轴孔或夹紧缝 |
| 编码器线 | 适配该模块的 GH1.25-4P 线 | 至少 1 条 | 向卖家索取同款配套线；固定在支撑臂外侧 |

AS5600 圆板依据用户提供的图纸重建，四个安装点选在四条斜槽内：相对板中心 X/Z 各 ±8.5，即 17×17 孔阵，对角孔距约 24.04。用 M2.5 螺丝、6 mm 绝缘隔柱固定，芯片面朝磁铁、插座面朝背板。不得用 V2 的方形模块背板替代。

09 号磁铁座继续保留 Ø6×3 直径方向充磁磁铁方案，这不是对赠送磁铁规格的确认。V3 名义磁隙 1.5，沿滑轨调节后用磁场诊断/AGC 确认。AS5600 数据手册的典型磁隙为 0.5–3，实际取决于所用磁铁。插座的插头外形和线序仍需卖家资料或实物确认。

## 螺丝、螺母与间隔柱

长度均为螺丝头以下长度；建议各类多买 20% 备用。底盘厚度变化时，M5 长度必须跟着复核。

| 紧固件 | 用途 | 基本数量 |
|---|---|---:|
| M4 丝杆，切长 180 | 在底部横穿两个底座及下支撑臂，兼作两根横向连接杆 | 2 根 |
| M4 × 35 螺丝 | 两侧拼接，穿过 6 + 12 + 6 的夹板/支撑臂 | 8 |
| M4 螺母 | 拼接 8 个，丝杆两端 4 个 | 12 |
| M4 平垫圈 | 拼接和丝杆两端 | 至少 20 |
| M5 × 20 螺丝 | 底座与约 3 mm 金属底板连接 | 8 |
| M5 螺母和平垫圈 | 底盘固定，垫圈放在长圆孔处 | 螺母 8，垫圈 16 |
| M3 × 25 螺丝 | 左端盖 4，右端盖上部 2 | 6 |
| M3 × 30 螺丝 | 右端盖下部与编码器滑轨共用 2，摆杆夹座两处夹紧各 1 | 4 |
| M3 × 20 螺丝 | 编码器背板两只脚锁在滑轨上 | 2 |
| M3 × 12 螺丝 | 磁铁座径向紧定，顶住光轴 | 1 |
| M3 六角螺母 | 上述 M3 连接，含预留的六角螺母窝 | 13 |
| M3 平垫圈 | 按螺丝头与滑轨处配置，避免局部压坏 | 约 20 |
| M2.5 × 16 低头/盘头螺丝与螺母 | AS5600 PCB 四条斜槽固定，优先非磁性材料 | 各 4 |
| M2.5 平垫圈，外径约 6 | PCB 面与背板螺母侧，跨住长槽 | 8 |
| 绝缘穿孔隔柱，长 6、外径 6、内径约 2.7 | PCB 与背板隔开，避让 4.3 mm 高的插座 | 4 |

编码器模块固定件尽量用尼龙/黄铜，并避开磁铁正对区域。本次已按指定圆板配置；如果商家发来不同版本，需重新核对。模型中的 M3 螺母窝是普通六角螺母设计，不是热熔铜螺母孔。PCB 螺丝头加前垫圈凸出按约 2.2 mm 校核，实物装配仍需转轴检查。

## 打印文件与数量

打印时选择 `stl` 或 `3mf` 中的一种即可，不要把两套一起导入。3MF 是通用几何文件，不是已切片的 Bambu 工程。导入后选择 A1 mini 与实际耗材，查看层预览再切片。

| 文件名 | 零件 | 数量 | 已设置的朝向 |
|---|---|---:|---|
| 01_base_shoe | 底座插槽座 | 2 | 底面贴板，插槽向上 |
| 02_lower_arm | 下段支撑臂 | 2 | 大平面贴板 |
| 03_upper_arm | 上段轴承臂 | 2 | 大平面贴板，轴承沉孔向上 |
| 04_splice_plate | 拼接夹板 | 4 | 大平面贴板 |
| 05_bearing_cover | 轴承端盖 | 2 | 大平面贴板 |
| 06_rod_hub | 摆杆/转轴夹持座 | 1 | 转轴孔竖直，部分侧孔需要检查桥接或局部支撑 |
| 07_encoder_rail | 编码器滑轨 | 1 | 滑轨底面贴板 |
| 08_encoder_carrier | 编码器背板 | 1 | 带脚结构，按切片预览为悬空面增加支撑 |
| 09_magnet_cup | 磁铁座 | 1 | 转轴孔/磁铁孔轴线竖直；检查盲孔封顶桥接 |
| 10_fit_coupon | 配合试打块 | 1 | 试完再决定主件孔径 |

建议起始配置：0.4 喷嘴、0.20 层高、5–6 道墙、5 层顶底、40–50% 填充。轴承臂、拼接区可局部提高填充，夹座与磁铁座采用较高填充。它们是试打起点，不是已经验证的打印配方。壁数、填充、材料与摆放方向变化都会影响刚度和配合。

支撑臂必须平放打印，不要竖着打印长臂。模型最大平面尺寸 169，可留约 5 mm 边界；添加裙边/擦嘴/辅助结构后仍需检查是否超出打印范围。左右上臂用同一个零件打印两份，装配时让轴承沉孔朝两侧外面。

先打印 `10_fit_coupon`，不要直接把全部零件开打：

- 上排三个轴承座从左到右为 Ø22.1、22.2、22.3，深 7.2，内孔 16.6。
- 下排左侧三个光轴孔从左到右为 Ø8.1、8.2、8.3。
- 下排右侧三个磁铁孔从左到右为 Ø6.1、6.2、6.3。
- 左右以导入后的打印顶视图为准；没有额外刻字，所以请对照孔排列。
- 当前主模型轴承座 Ø22.2、转轴夹座孔 Ø8.2、摆杆孔 Ø8.3、磁铁座 Ø6.2。
- 轴承外圈应能轻压装入且无明显晃动；不要靠锤击压入。孔过紧会改变外圈形状并增加阻力。光轴需要顺利穿过轴承；打印夹座则依靠螺丝夹紧。

## 装配顺序

1. 清理毛刺、桥接与支撑。把 M3 螺母预装进上轴承臂内侧的螺母窝，确认孔道通畅。
2. 两个底座按中心距 130 放在底盘上，安装螺丝先不完全锁紧。插入两个下支撑臂，用两根 M4 丝杆在底部横穿连接，丝杆位于摆动区下方。
3. 接上两个上轴承臂，接缝两面各一块夹板，每侧 4 颗 M4 × 35。先松装，以便后续对齐。
4. 两只 608 从外侧装入轴承座。把 Ø8 光轴穿过第一轴承、中央摆杆夹座和第二轴承，利用光轴对中后再逐步锁紧支架、夹板和底盘固定。不要用螺丝强行把歪斜的轴承拉正。
5. 安装两个端盖。右端盖下方两颗螺丝同时固定编码器滑轨。摆杆夹座置于两支撑中心，确认夹紧缝可收紧。
6. 轴承外侧依次安装小外径薄垫片和定位环。定位环用于轴向限位，不要将两侧拧成轴承预紧；留微小轴向活动余量，确保转轴自由转动。
7. 将长 260 的 Ø8 铝管插到底，管底位于轴心上方 20，夹座插入深度约 32。锁紧夹杆螺丝，不要把薄铝管压瘪。用手轻试确认管和轴都不会在夹座内滑动。
8. 编码器侧光轴端部安装磁铁座，径向 M3 螺丝固定；可在轴端接触处做小平面避免打滑。将直径方向充磁的磁铁装入，少量胶固定，胶不要高出磁铁正面。
9. 圆板四条斜槽经 6 mm 隔柱装在 V3 背板的 17×17 孔阵上，芯片面朝磁铁，中心对准轴心。背板脚放在原滑轨上，用 M3 螺丝、垫圈、螺母锁定。移动背板调节磁铁间距；插座朝背板，线缆从窗口或板边引出后沿右支撑外侧固定。
10. 手动慢转一整圈，检查杆、夹座、磁铁座、螺丝尾端和线缆是否碰撞，再测编码器角度是否连续。编码器数据正常后再接入稳摆程序。

装配 STEP 中的绿色圆板按用户图纸建模，包含六条长槽、芯片/插座包络与四个 6 mm 隔柱。没有绘制配套插头和绝大多数螺丝。插座沿板面方向的深度采用 4.5 mm 保守包络，实际采购件仍需试装。

## 已验证与未验证

已通过：10 种零件均为有效单实体；导出的 STL 为封闭正体积网格；打印包络符合 180 mm；固定打印件无体积交叠；中央摆杆/夹座与固定支架在轴向空间分离；杆端全转动扫掠半径对应底板净空约 39.97。详细记录在 `verification.json`。

未验证：实际打印公差、层间强度、支架模态/振动、整车抗倾覆裕量、采购件误差、控制性能，以及具体 PCB 的尺寸/电气兼容性。先以轻摆杆、低加速度做机械试验；这份 CAD 不代表已经能完成比赛指标。

题目是否允许单轴摆、摆杆初始是否必须自然下垂仍需向出题老师确认。本模型已经保留自然下垂与完整转动空间，但没有额外驱动摆轴的电机。

## 技术依据

- [Bambu Lab A1 mini 官方快速指南：180 mm 成型范围](https://cdn1.bambulab.com/documentation/quick-start-f507128172bdf/Quick%20start%20guide%20-%20A1%20mini-EN.pdf)
- [AS5600 数据手册：接口、磁铁与间距要求](https://files.seeedstudio.com/wiki/Grove-12-bit-Magnetic-Rotary-Position-Sensor-AS5600/res/Magnetic%20Rotary%20Position%20Sensor%20AS5600%20Datasheet.pdf)
- [用户提供的 AS5600 模块尺寸图](../reference/AS5600_module_drawing.jpg)
- [SKF 官方轴承目录：608 的 8 × 22 × 7 尺寸](https://cdn.skfmediahub.skf.com/api/public/0901d196802809de/pdf_preview_medium/0901d196802809de_pdf_preview_medium.pdf)

预览使用 Three.js 0.160.1（MIT 许可）；许可证在 `preview/THREE-LICENSE.txt`。结构参数和采购数量以本 V3 为准，修改尺寸后应重新生成与检查。
