lingkonglengfeng/nanhua-pendulum-car/vehicle_assembly_v1/output/整车模型说明.md

# 整车模型与当前布局

整车采用 320×220×4 FR4 底板、四个 520 减速电机及 Ø65 普通轮、现有 V3 单轴倒立摆和 Ø32 AS5600 模块。摆杆配重使用两片 M8 垫片，下夹环下沿距摆轴 160，可在预览中沿杆调整。

## 已整合的结构

- 原 V3 的打印底座、分段支撑臂、拼接夹板、轴承盖、摆杆夹座、编码器滑轨、圆板背板及磁铁座。
- 金属光轴、铝管、两只 608、用户选定的 8×14×6 定位环、薄垫片和底部横杆。
- 新 FR4 主底板与按用户图纸确定底脚孔距的 520 金属 L 支架。
- 两组配重夹环、两片 M8 垫片及夹紧螺丝。
- 底座/拼接/端盖/编码器/夹座/电机安装/电子模块的主要简化紧固件。
- 板下电池、支撑垫、两条绑带，以及参考电子模块和两束示意走线。

模型共 360 个独立实体，包括大量垫圈、螺母和电子元件包络，因此不是 360 种采购物料。STEP 保留各零件名称和颜色，具体导入后的层次显示取决于 CAD 软件。紧固件没有建螺纹；电机到 L 支架的厂家专用短螺丝、轮毂紧定螺丝等未全部细化，实际长度和旋入深度依供应商资料。

## 空间参考

| 项目 | 名义值 |
|---|---:|
| 底板外形 | 320×220×4 mm |
| 包含轮子的整车宽度 | 约 280 mm |
| 直立时总高度 | 约 664 mm |
| 摆轴距底板上表面 | 320 mm |
| 轴心到摆杆末端 | 280 mm |
| 下垂杆端距底板 | 约 40 mm |
| 电池占位 | 120×50×28 mm |
| 电池顶端与底板下表面 | 6 mm，采用支撑垫留空间 |
| 配重默认位置 | 下夹环下沿距摆轴 160 mm |

轮组参考把轴线放在支架孔阵中心，对应底板上表面距地约 63.5。实际减速箱可能有出轴偏置，轮毂宽度和轴伸长也未确认，所以总高度、离地间隙与轮距不是最终实车保证尺寸。

## 电器件的表示方式

前端绿色板表示主控安装空间，后端安装板上放置四块 DRV8871 模块包络，中央放置一个小 IMU 包络。它们用于看布置和螺丝位置，没有声称是 G407、某款 DRV8871 模块或特定 IMU 的准确 PCB 模型。准确安装仍需实物外形、孔距和插头高度。

AS5600 圆板及四条斜槽固定点延续已提供尺寸图的 V3 方案。板下电池也是空间占位，插头、BMS 和线束尺寸待核对。

橙色线为编码器线束的参考路径，红色线为电源线路的参考路径。两者只表达从哪里走线，不表达线数、针序、接插件或电气连接关系。实际线束应固定在车架上，留弯曲余量，避开转动件。

## 预览操作

打开独立 HTML，拖动旋转、滚轮缩放；可选择整车、底盘、摆轴/AS5600、配重四种范围。正面、侧面、上方和底部按钮用于检查不同方向。摆角滑块改变杆和相关转动件姿态，配重滑块改变夹环位置。它们是几何演示，没有模拟电机力矩、摆杆动力学或控制器。

参考器件和走线可以隐藏，便于观察已设计的结构。所有占位仍保留在 STEP 中供检查，不应该将其当作采购件加工图。整车 STEP 不能直接作为一件打印；原 V3 打印零件、新底板 DXF 和配重分件文件仍是各自制造依据。

## 检查结果

- 已从各子项目 STEP 读取实体，并按唯一位置包络与已知零件名称匹配，避免把旧底板或重复铝管叠加进去。
- 对当前名义装配的非线束实体进行交叠检查，未检出超过检查阈值的体积穿插。
- 新增摆杆夹紧螺丝、磁铁座紧定螺丝已经计入转动包络。中心转动组件的最低包络约 Z=39.97，新增磁铁座紧固件的转动包络半径约 19.20，均通过固定结构避让检查。
- 整车 STEP 回读为有效实体。预览脚本的角度、范围切换、配重移动及静态图回退经过无 GPU 的逻辑检查；没有在实际浏览器 GPU 上复测。

线束因端点进入接插件占位，不包含在普通实体交叠结论中；实际走线、接头和弯曲半径需装机确认。所有检查均为给定模型下的几何检查，没有做实物静载、振动、夹紧力或比赛控制测试。
