lingkonglengfeng/nanhua-pendulum-car/wiring_dmg474_drv8871/output/IPS200接入与引脚分配_V3.md

# DMG474 四驱接线增加 IPS200 调试屏（V3）

> 已由 [两根 24 芯排线的 V4 方案](双牛角座两排线方案_V4.md)更新。V3 需要 CN3 第三根排线；V4 改用 CN10 空脚的 SPI3，并在转接板本地转换 3.3V。新制作请用 V4。

**结论：CN8/CN10 两只 2×12 座的四驱、编码器和 AS5600 分配保持不变。** IPS200 从 DMG474 已有的 2×4 LCD 接口 **CN3** 单独接入；若所有插头集中在信号转接板，就增加一只与 CN3 对接的输入座和一个 J_IPS 输出座。最新版图见 [05_双排座加IPS关系图_V3.svg](05_双排座加IPS关系图_V3.svg)，所有网络见 [pin_assignment_v3_ips.csv](pin_assignment_v3_ips.csv)。

## 从参考工程移植的依据

`E:\Engineering_Training_Project\Core\Src\ips200.c` 用 `HAL_SPI_Transmit()` 发送命令/像素，使用独立的 CS、DC、RST GPIO，分辨率为 240×320（横屏 320×240）；其 `spi.c` 把屏幕接 **STM32H723 的 SPI2**。该工程的 `Core\Inc\main.h` 标为 PC6/PC7/PC8 控制脚。**这些 MCU 脚号不照搬到 DMG474**；移植的是屏幕所需的电气信号、SPI 模式和命令流程。

DMG474 工程资料 `3，原理图.zip` 中 `DMG474_V1.0.pdf` 第 1 页显示 CN3 的逐针网络；硬件手册说明 PB3/PB4/PB5 的 SPI1 同时连接板载 SPI Flash，靠不同片选使用。CN3 原本为 1.3 寸 TFT 接口，但三根控制脚可重新定义为 IPS200 所需的 CS、DC、RST。没有修改主板铜线。

| 主板 CN3 脚 | 主板网络/MCU | 本方案 IPS200 信号 | 转接板 J_IPS（自定义） |
|---:|---|---|---:|
| 1 | GND | GND | 1 |
| 2 | VCC3.3 | VCC（仅在模块支持 3.3 V 时） | 2 |
| 3 | PD8，原 LCD_PWR/CE | D/C，普通 GPIO | 6 |
| 4 | PD10，原 LCD_CS | CS#，普通 GPIO | 5 |
| 5 | PB3，SPI1_SCK | SCK/SCL | 3 |
| 6 | PB5，SPI1_MOSI | MOSI/SDA/DIN | 4 |
| 7 | PB4，SPI1_MISO | 屏幕不用，J_IPS 不连接 | — |
| 8 | PD9，原 LCD_RST/IRQ | RST#，普通 GPIO | 7 |

J_IPS-8 预留给 BLK/LED 背光。如果所购屏幕板的背光需要单独供电，应按模块电路图确定电压、电流和限流方式，在转接板上通过可选焊位供电；若屏幕已经板载背光电路，按其说明连接。**不能从标号猜测直接把 BLK 接 3.3 V。** J_IPS 是本方案自定义线序，屏幕本身排针的真实顺序还需逐脚核对。

## 原理图怎么画

1. 保留 V2 的 J1←CN8、J2←CN10 及所有四轮网络。增加 J3←CN3（2×4，逐脚对应）。若屏幕直插主板 CN3，可省去转接板上的 J3 与 J_IPS。
2. J3 的 1、2、3、4、5、6、8 脚按表连接到 J_IPS；J3-7（PB4/MISO）不引到 IPS，标不连接。J3-3 虽在主板标 `LCD_PWR`，本方案在固件中改成 `IPS_DC` GPIO，连接屏幕 D/C，不能继续作为背光开关。
3. 板载 W25Q128 Flash 仍使用 PB3/PB5 的 SPI1，总线 MISO 为 PB4，片选为 PB8；IPS 使用 PD10 片选。固件保证访问任何一个器件时另一个的片选为高，若有并发访问则用同一总线锁串行化。屏幕不接 MISO。
4. CN3-2 的 3.3 V 只供电压兼容且总电流在主板预算内的屏幕；两块 2×12 座的第 23 脚为 **5 V**，本方案仍留空，不用于屏幕或传感器。

## 固件移植要点

DMG474 固件应启用 **SPI1 主机、8 bit、MSB first、CPOL=0、CPHA=首沿、软件 NSS**，首版可从较低时钟开始测试，再按屏幕实测稳定性提速。`PB3=SPI1_SCK`、`PB5=SPI1_MOSI`；`PD10=IPS_CS`、`PD8=IPS_DC`、`PD9=IPS_RST` 初始输出高。板载 Flash 的 `PB8=FLASH_CS` 初始保持高。屏幕初始化沿用参考工程的复位、Sleep Out、像素格式和显示开启流程，但实际屏幕控制芯片、分辨率和方向设置须与所购模块一致。

把参考代码中的 `stm32h7xx_hal.h` 和 `hspi2` 换为 DMG474 工程对应的 STM32G4 HAL 头文件与 `hspi1`。参考工程使用 FreeRTOS `osDelay()`；若本车固件不是 CMSIS-RTOS，应在其延时封装中改用 HAL/定时器延时。屏幕与 Flash 共用 SPI1 时，**锁必须覆盖片选拉低至拉高的完整事务**，不能只锁一次 `HAL_SPI_Transmit()`。不在高优先级平衡控制中断里做整屏刷新；调试屏低优先级、限频更新，避免影响摆杆控制周期。

## 上电前核对

- IPS200 实物的 VCC/BLK 允许电压、供电电流、控制芯片、分辨率和排针顺序。
- CN3 插座的 1 脚方向及连接排线的逐针通断，避免把原理图奇偶列当成实物俯视顺序。
- 屏幕 CS、Flash CS 在复位和初始化期间均处于非选中状态；SPI1 共线不会同时驱动两器件。
- 实测屏幕刷新对控制任务周期的影响。现有仓库只有接口/模型资料，没有可直接编译的 DMG474 控制固件，因此此处不声称已经完成代码移植或上机测试。
