lingkonglengfeng/nanhua-pendulum-car/wiring_dmg474_drv8871/output/双牛角座两排线方案_V4.md

# 两根 24 芯排线连接四驱、编码器、AS5600 和 IPS200（V4）

> 历史方案：用户已改选两块 AT8236 双路模块。新制作请使用 [V6 双模块方案](AT8236双模块两排线方案_V6.md)；以下 DRV8871 内容仅供追溯。

## 所购 DRV8871 模块的正反转

用户提供的正面照片清楚标出四针 **VM、GND、IN1、IN2**，左侧另有 `POWER` 两孔和 `MOTOR 1/2` 两孔。**可以双向驱动有刷直流电机**；`IN2` 是 H 桥的第二个控制输入，图里的 `*_DIR` 只是 MCU 侧网络简称，不代表模块有专用 DIR 引脚。四路均按 `PWM→IN1`、`DIR控制GPIO→IN2` 接。DRV8871 芯片真值表如下：

| IN1 | IN2 | 结果 |
|---:|---:|---|
| 0 | 0 | 输出悬空，滑行；持续约 1 ms 后进入休眠 |
| 1 | 0 | 正向：电流 OUT1→OUT2 |
| 0 | 1 | 反向：电流 OUT2→OUT1 |
| 1 | 1 | 两端低电平，电气刹车 |

当前 **一根 PWM + 一根 GPIO** 的分配可实现正反转。以 `d` 为 0–1 的目标占空比：正向 `IN1=PWM(d)、IN2=0`；反向 `IN1=PWM(1−d)、IN2=1`；停止时 `IN1=0、IN2=0`。反向的 PWM 关闭区间进入刹车，正向关闭区间进入滑行，动态响应会有差异；做倒立摆控制时需分别实测、整定。若将来要求两方向采用同一衰减模式，可改为每个输入各由一个 PWM 通道驱动，再重做引脚分配。

模块上的 **VM 不是 3.3V 逻辑电源**。本方案把电机电源接到模块 `POWER +/−`，把模块 `GND` 针接控制板公共地，`VM` 针先不接；断电后用万用表核对 `VM` 与 `POWER+` 是否同网、GND 针与 `POWER−` 是否同网，再按实物丝印确认 `POWER` 两孔的极性。两个 `MOTOR` 孔接该台电机绕组。芯片输入可识别 3.3V 逻辑，但模块限流电阻、散热能力仍要与所购 370 电机核对。[TI DRV8871 数据手册](https://www.ti.com/lit/ds/symlink/drv8871.pdf)给出上述 H 桥真值表。

## 如改用 TB6612FNG

TB6612FNG 每片有两路，可用两片驱动四台电机；[东芝数据手册](https://toshiba.semicon-storage.com/info/TB6612FNG_datasheet_en_20141001.pdf?did=10660&prodName=TB6612FNG)给出的输出能力为**每路平均 1.2 A**，峰值 **3.2 A 仅为约 10 ms 单次脉冲**，另列 2 A/20 ms 且占空比不超过 20% 的脉冲条件。两路同时工作还共用一片芯片的散热条件。用户新提供的 370 参数表显示，21.3 减速比、280 rpm 空载转速对应 **6V/12V/24V 三个版本**；其中若实物为 **12V 版本**，其额定电流 0.45A、堵转电流 1.3A。按额定工作点看 TB6612 的每路电流并非明显不足，但堵转已略高于 1.2A 平均限值，不能长期堵转；表格也明确不允许堵转或带负载瞬间反转。3S 电池满电 12.6 V 距 TB6612 的 13.5 V 推荐 VM 上限仅 0.9 V，需验证回生及走线尖峰。若实际为 6V 或 24V 版本，应重新评估电机供电和整车性能，不能沿用本 3S/12V 判断。

若确认购买的是 12V 版本，且启动/快速换向电流、芯片温升及母线尖峰均满足要求，现有每电机两根 MCU 控制线可改接 TB6612 的 IN1/IN2，并将其 PWM 使能脚保持高电平、STBY 可靠拉高，另接逻辑 3.3 V 和电机 VM；**不能将当前 DRV8871 模块插头直接替换为 TB6612 模块**。本版仍以已购 DRV8871 为正式接线。无论用哪种驱动器，控制程序均应限制换向电流、避免堵转，并检测驱动器热状态。

主板到低压信号转接板只接 **CN8→J1、CN10→J2 两根 2×12 牛角座排线**，逐针 1:1。屏幕不再占用 CN3 排线，传感器也不再需要 CN2 的供电线。完整原理图关系参考 [06_双牛角座全接线_V4.svg](06_双牛角座全接线_V4.svg)，逐网络表见 [pin_assignment_v4_two_cables.csv](pin_assignment_v4_two_cables.csv)。V2/V3 文件保留作设计历史，绘制新转接板以本 V4 为准。

## 仅改动的 MCU 引脚

先前右后轮的 `RR_DIR` 使用 **PC10/CN10-18**。现把它改接 **PC11/CN10-20**，空出 PC10 作为屏幕 SPI3 时钟。其他三路驱动、四路编码器、AS5600 的引脚均不变。

| 功能 | MCU | 主板 CN10 针号 | 连接 |
|---|---|---:|---|
| 右后轮 DIR | PC11 / GPIO | 20 | DRV_RR.IN2 |
| IPS SCK | PC10 / SPI3_SCK | 18 | IPS.SCK/SCL |
| IPS MOSI | PC12 / SPI3_MOSI | 22 | IPS.SDA/DIN |
| IPS CS# | PD11 / GPIO | 24 | IPS.CS |
| IPS D/C | PD14 / GPIO | 5 | IPS.DC |
| IPS RST# | PD7 / GPIO | 6 | IPS.RST |

屏幕是单向 SPI，**PC11/SPI3_MISO 无须给屏幕使用**，所以 PC11 可以设普通 GPIO 做 `RR_DIR`。STM32G474 数据手册的复用表确认 PC10/PC12 可作 SPI3_SCK/MOSI；DMG474 原理图第 2 页确认两脚分别是 CN10-18/-22，且上述其他脚都引出到 CN10。TIM2/TIM4 编码器只使用 CH1/CH2，PD7/PD14 改成 GPIO 不占用它们的 A/B 通道。PC8 的 TIM8_CH3 PWM 与 PC12 的 SPI3 引脚配置各自独立。

## 用两根排线解决 3.3V

主板 **CN10-23 = VCC5**，只从这一脚给转接板的本地稳压器 `U_REG` 输入供电；**CN8-23 = VCC5** 保持不连接，避免两条排线并联供电。CN8/CN10 的 7、16 脚为公共信号地。`U_REG` 输出 `3V3_LOCAL`，只供四个编码器、AS5600、可选 IMU 和 IPS 屏幕；它**不接**主板 CN2-1 的 3.3V。电机驱动模块的 `POWER+/−` 和电机绕组仍走独立功率线，不经排线或稳压器。

```text
DMG474 CN10-23 (VCC5) ──> U_REG 5V→3.3V ──> 3V3_LOCAL
DMG474 CN8/CN10 GND ───────────────────────> 信号公共 GND
3V3_LOCAL ──> 编码器×4 / AS5600 / IPS200 / 可选 IMU
```

`U_REG` 选型须满足所有模块的**同时峰值电流**并留余量，输入/输出去耦按所选器件数据手册布置。若用线性稳压器，按 `(5−3.3)×电流` 计算发热；电流偏大时优先用 5V→3.3V 开关稳压。CN10-23 取电仍受 DMG474 板载 5V 轨及其保护/连接器额定能力限制，应在主板 DC6–24V 正常供电下测负载端电压，不以 USB 单独供电作为带全负载依据。编码器、AS5600、IPS 的 3.3V 兼容性和总电流需按实物确认。

## 屏幕输出座和背光

建议转接板 `J_IPS` 自定义 8 针：`1 GND、2 3V3_LOCAL、3 SCK、4 MOSI、5 CS、6 DC、7 RST、8 BLK预留`。这不是 IPS200 模块现有排针的物理顺序，接线前按实物板丝印和电路图换位。BLK 是否接 3.3V、是否需要限流/开关，待模块资料确认；转接板预留可选焊位，不默认短接。

I²C4 仍是 PC6/CN10-17（SCL）与 PC7/CN10-19（SDA），上拉到 `3V3_LOCAL`。这两脚同时接板载步进/舵机辅助电路，使用前按 V2 说明处理 P7/CN14 供电并检查波形。

## 固件与参考工程的关系

`E:\Engineering_Training_Project\Core\Src\ips200.c` 是 STM32H723 的 SPI2 屏幕驱动。移植到 DMG474 时使用 **SPI3**：`hspi2→hspi3`，HAL 头文件改为 G4 对应版本，控制 GPIO 改为 `PD11=CS、PD14=DC、PD7=RST`，按参考工程设 8 bit、MSB first、SPI Mode 0、软件 NSS。先用低速测试，再根据显示稳定性调节分频。`RR_DIR` 固件定义要同步从 PC10 改 PC11。屏幕低优先级限频刷新，不在平衡控制中断里整屏刷图。SPI3 当前没有其他使用者，板载 Flash 继续使用 SPI1，屏幕与 Flash 也不再共用总线。

当前仓库没有可直接构建的 DMG474 控制固件，因此这里交付的是接线与端口移植清单，尚未声称代码已烧录或实测。上电前还须核对牛角座 1 脚、防呆口、排线逐芯通断和各模块实际针序。
