lingkonglengfeng/nanhua-pendulum-car/chassis_fr4_v1/output/preview/assembly.png

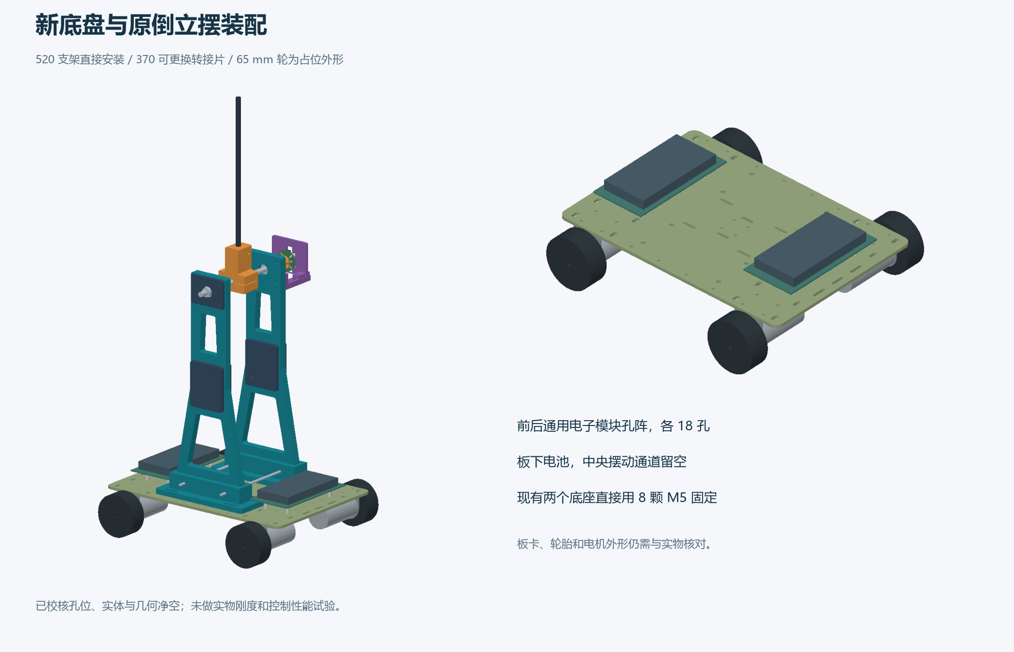
chassis_fr4_v1/output/preview/assembly.png
