lingkonglengfeng/nanhua-pendulum-car/pcb_bottom_adapter_v1/output/preview/adapter_and_assembly.png

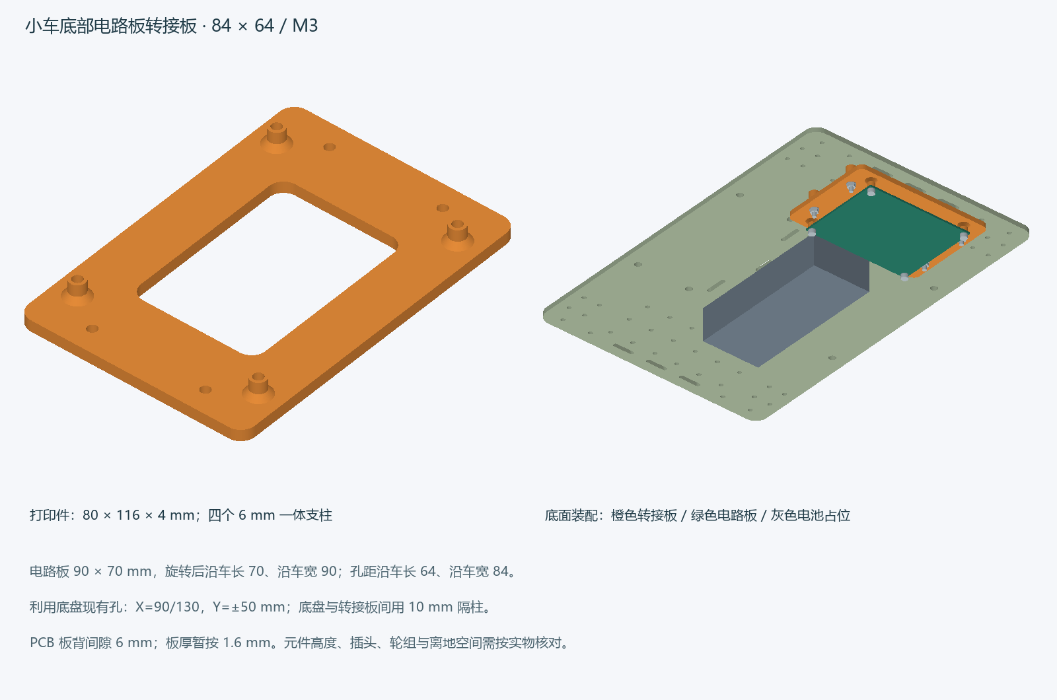
pcb_bottom_adapter_v1/output/preview/adapter_and_assembly.png
