lingkonglengfeng/nanhua-pendulum-car/pcb_bottom_adapter_v2_center/output/preview/adapter_and_assembly.png

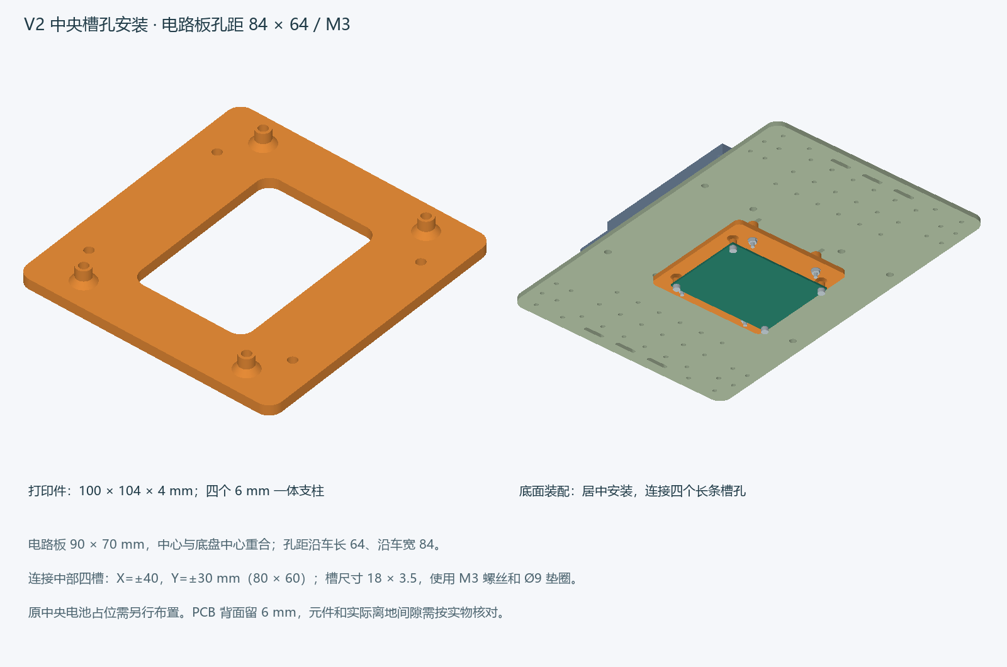
pcb_bottom_adapter_v2_center/output/preview/adapter_and_assembly.png
