lingkonglengfeng/nanhua-pendulum-car/pendulum_rod_weight/output/preview/assembly.png

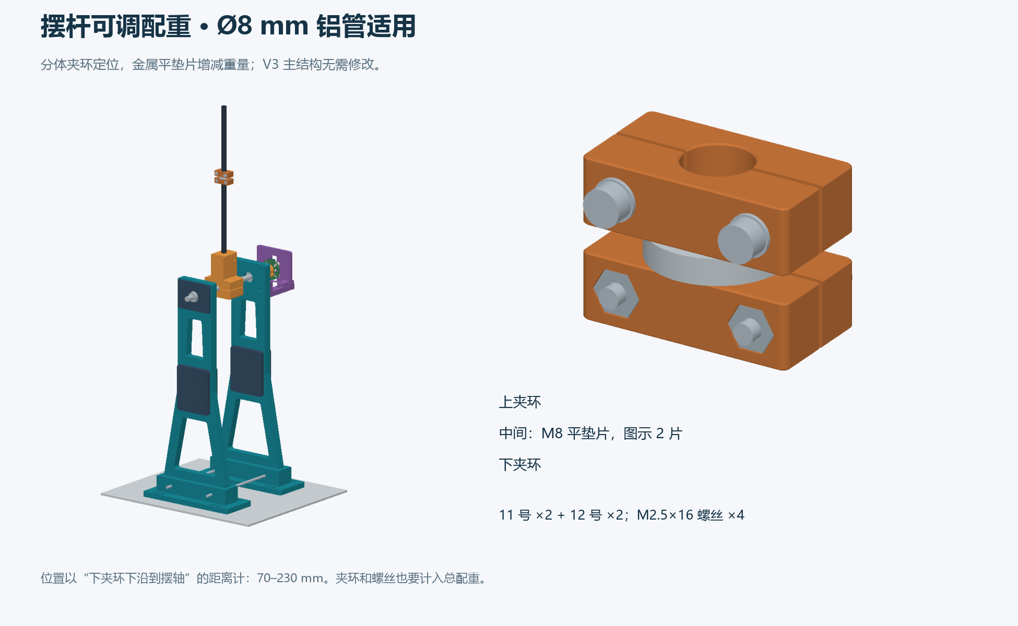
pendulum_rod_weight/output/preview/assembly.png
