lingkonglengfeng/nanhua-pendulum-car/pendulum_v3/output/preview/assembly.png

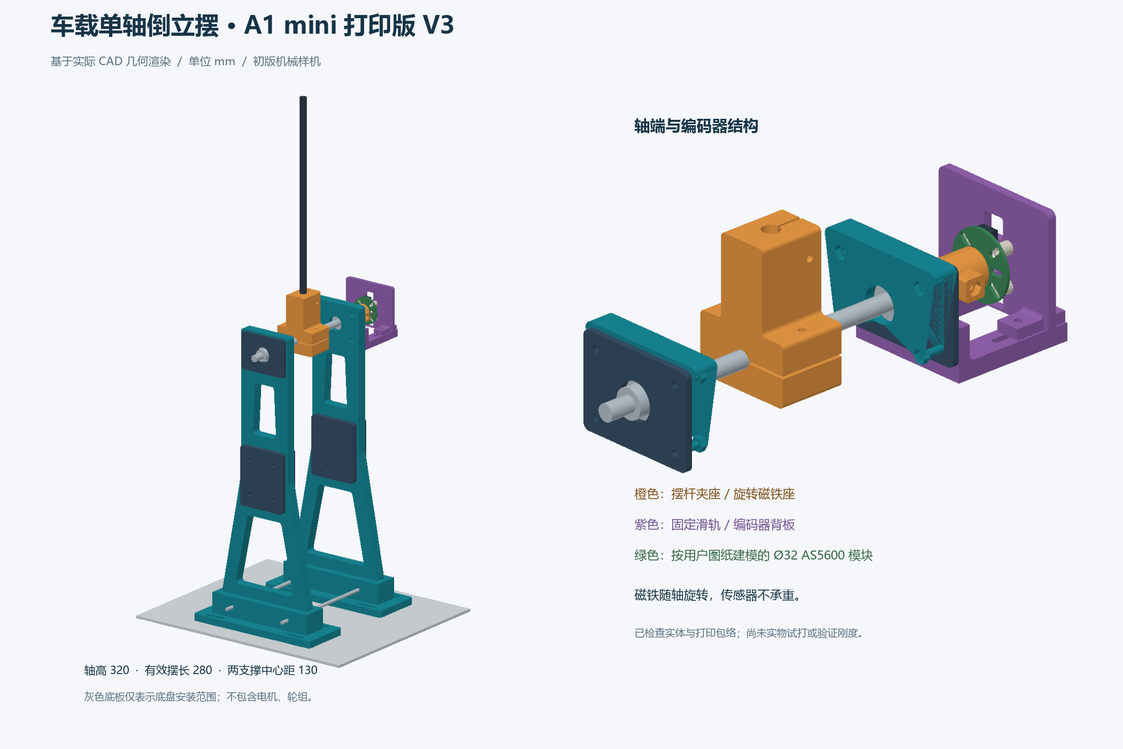
pendulum_v3/output/preview/assembly.png
