lingkonglengfeng/nanhua-pendulum-car/vehicle_assembly_v1/output/preview/assembly.png

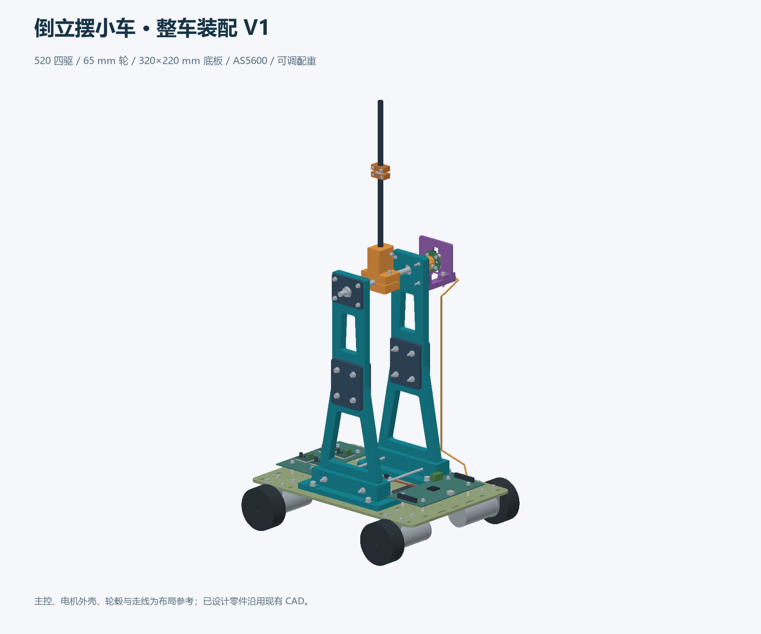
vehicle_assembly_v1/output/preview/assembly.png
