lingkonglengfeng/nanhua-pendulum-car/vehicle_assembly_v1/output/preview/three_views.png

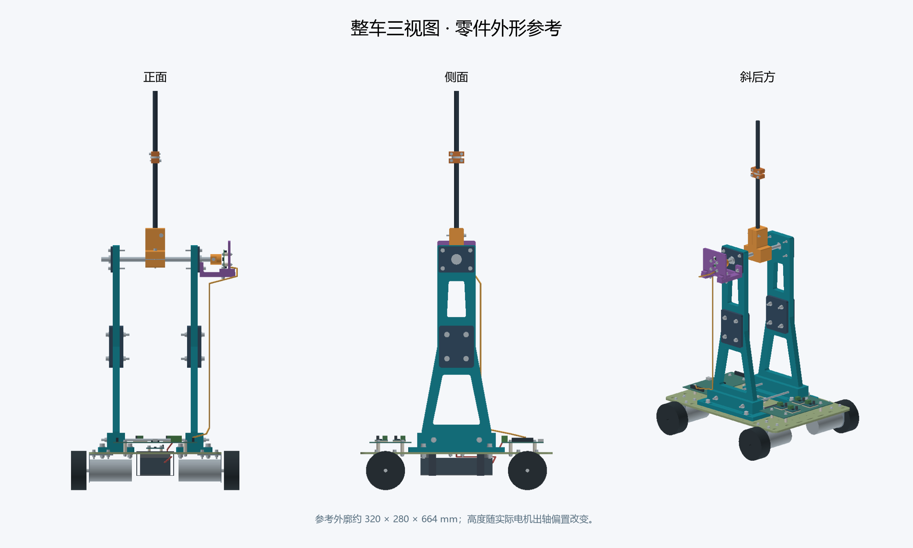
vehicle_assembly_v1/output/preview/three_views.png
