lingkonglengfeng/nanhua-pendulum-car/vehicle_assembly_v1/output/preview/underside.png

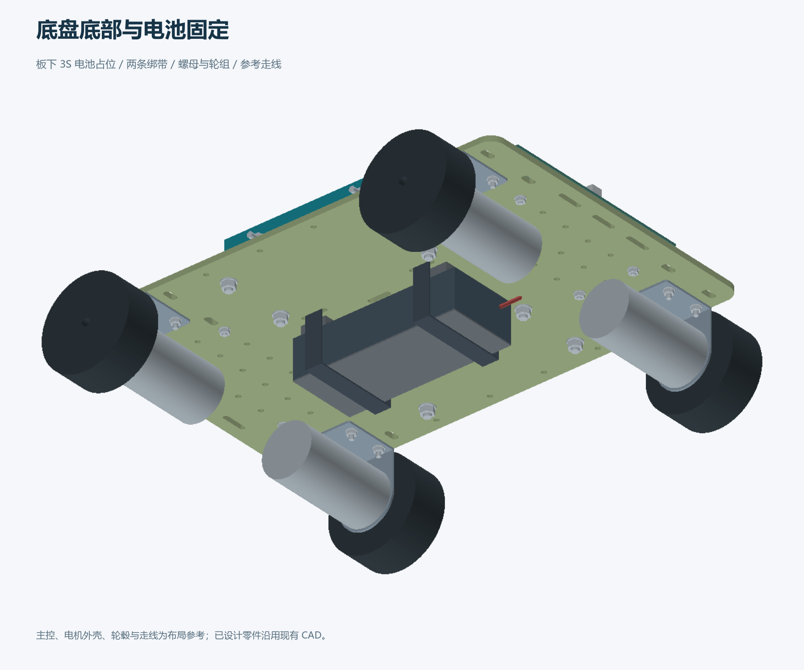
vehicle_assembly_v1/output/preview/underside.png
