lingkonglengfeng/nanhua-pendulum-car/wiring_dmg474_drv8871/output/01_整车接线总图.png

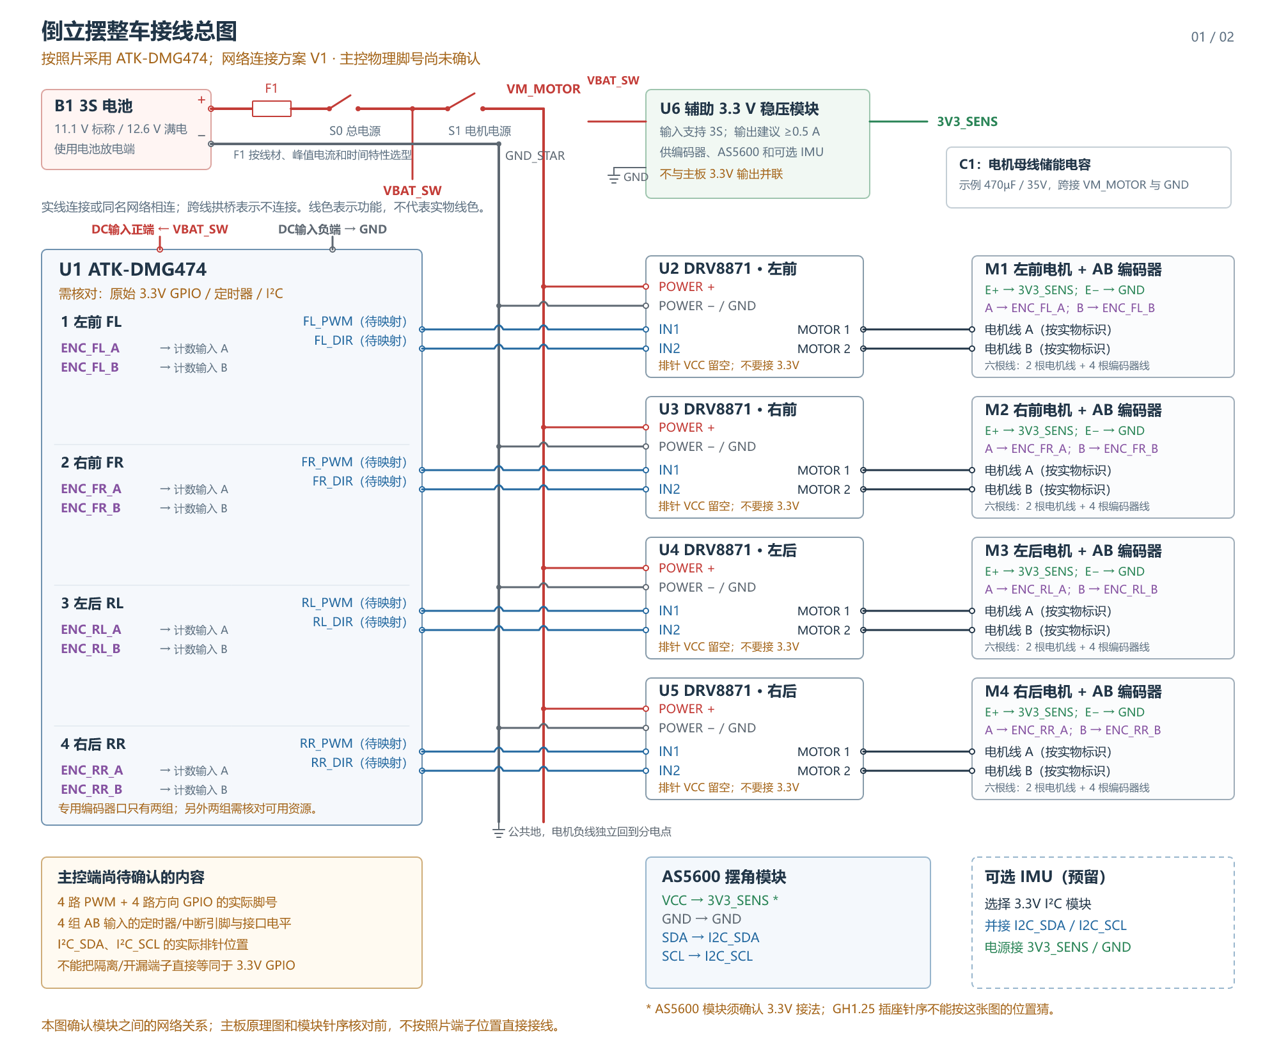
wiring_dmg474_drv8871/output/01_整车接线总图.png
