lingkonglengfeng/nanhua-pendulum-car/wiring_dmg474_drv8871/output/02_单路驱动与传感器细节.png

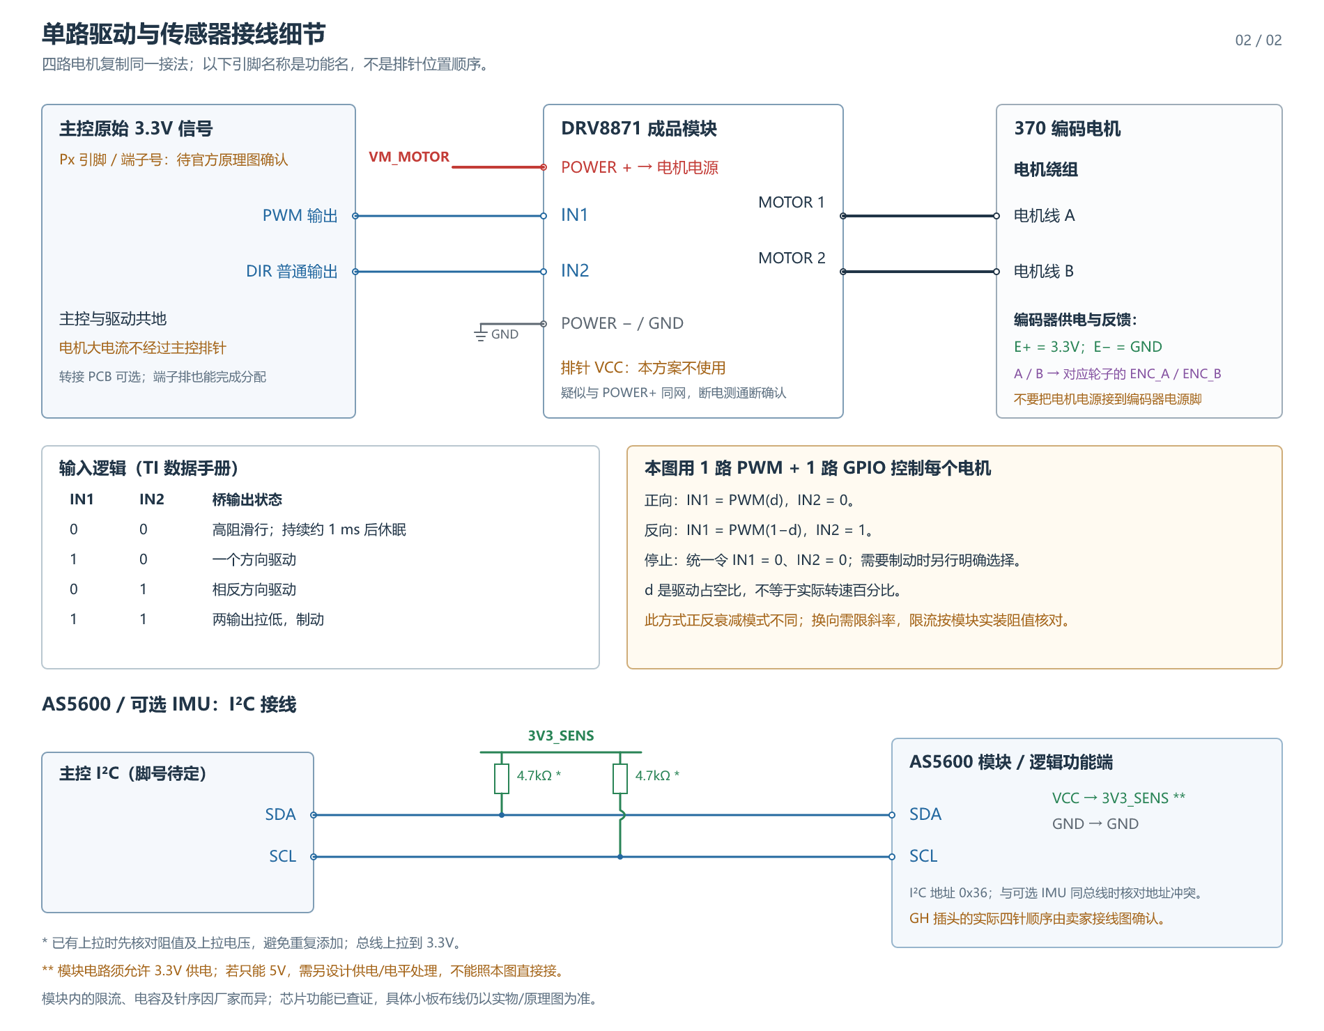
wiring_dmg474_drv8871/output/02_单路驱动与传感器细节.png
