lingkonglengfeng/nanhua-pendulum-car/wiring_dmg474_drv8871/output/03_原理图关系图_V2.png

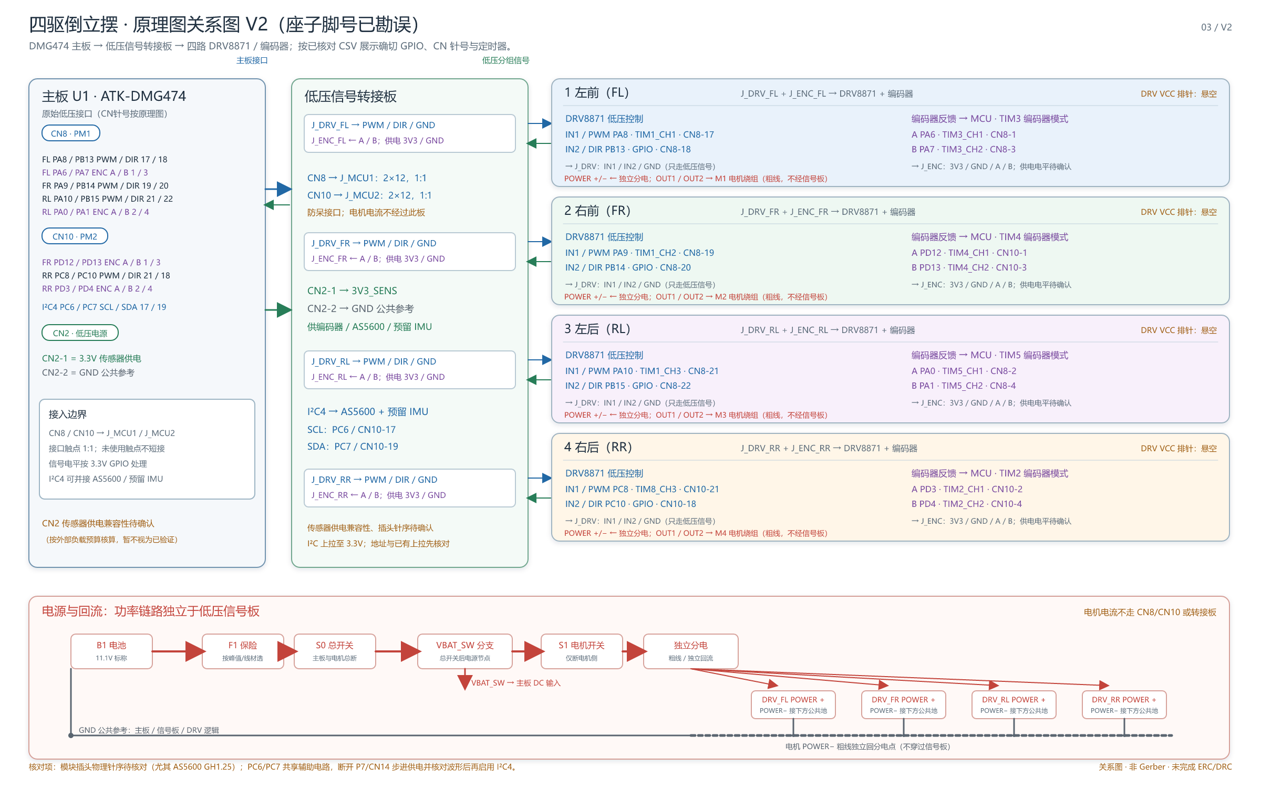
wiring_dmg474_drv8871/output/03_原理图关系图_V2.png
