lingkonglengfeng/nanhua-pendulum-car/wiring_dmg474_drv8871/output/04_双排座原理图参考.png

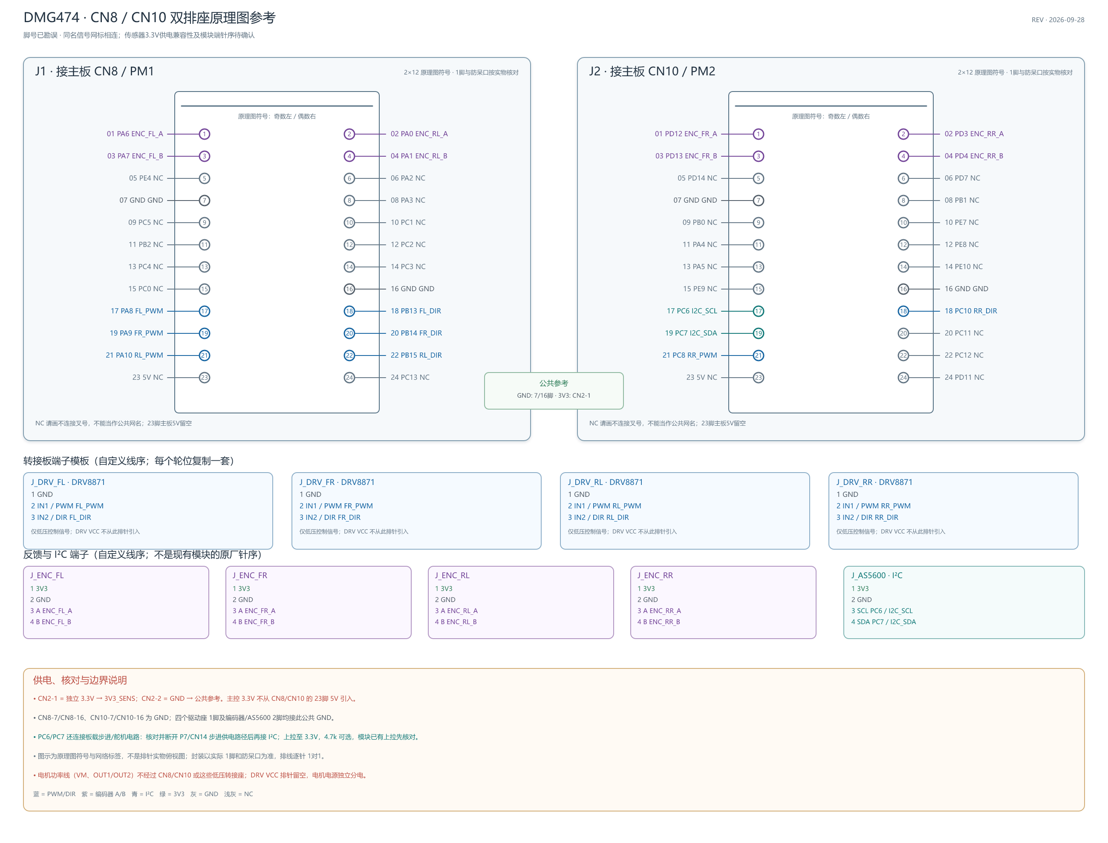
wiring_dmg474_drv8871/output/04_双排座原理图参考.png
