lingkonglengfeng/nanhua-pendulum-car/wiring_dmg474_drv8871/output/05_双排座加IPS关系图_V3.png

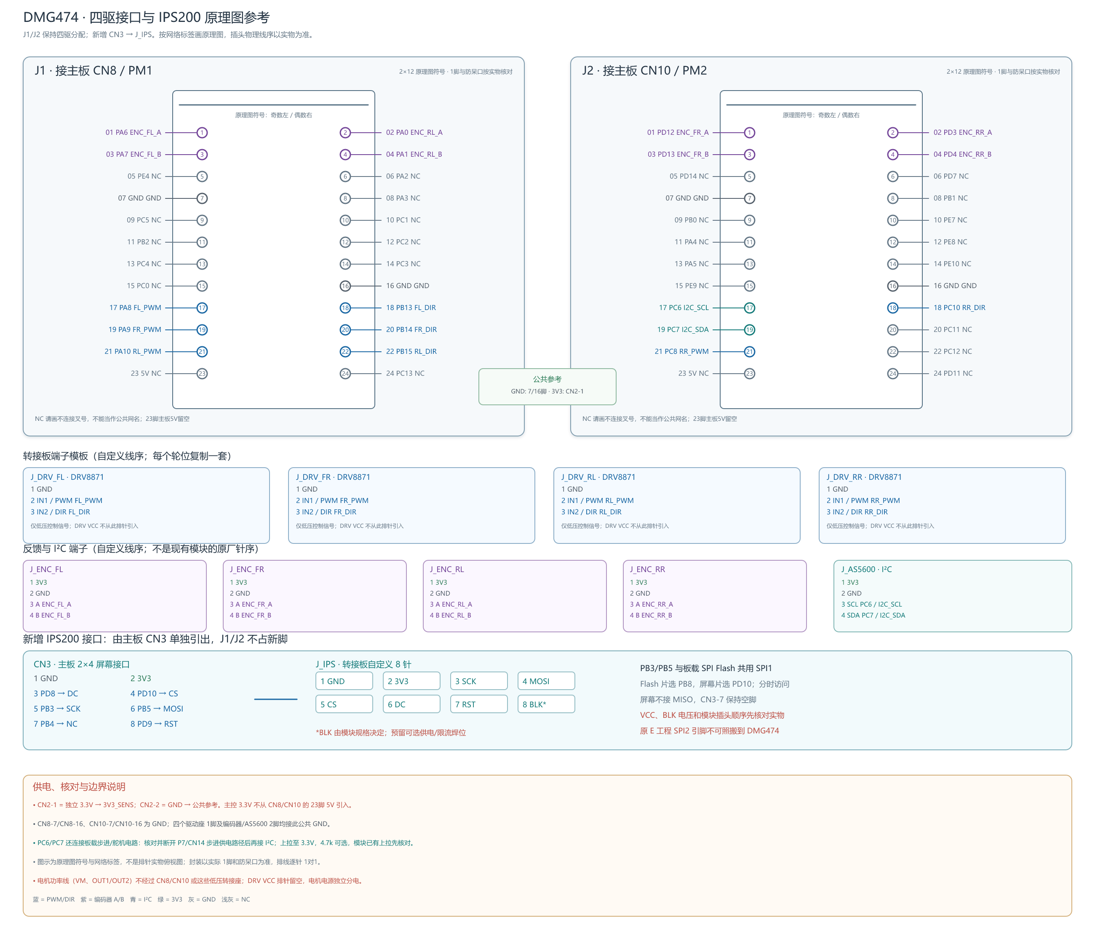
wiring_dmg474_drv8871/output/05_双排座加IPS关系图_V3.png
