lingkonglengfeng/nanhua-pendulum-car/wiring_dmg474_drv8871/output/06_双牛角座全接线_V4.png

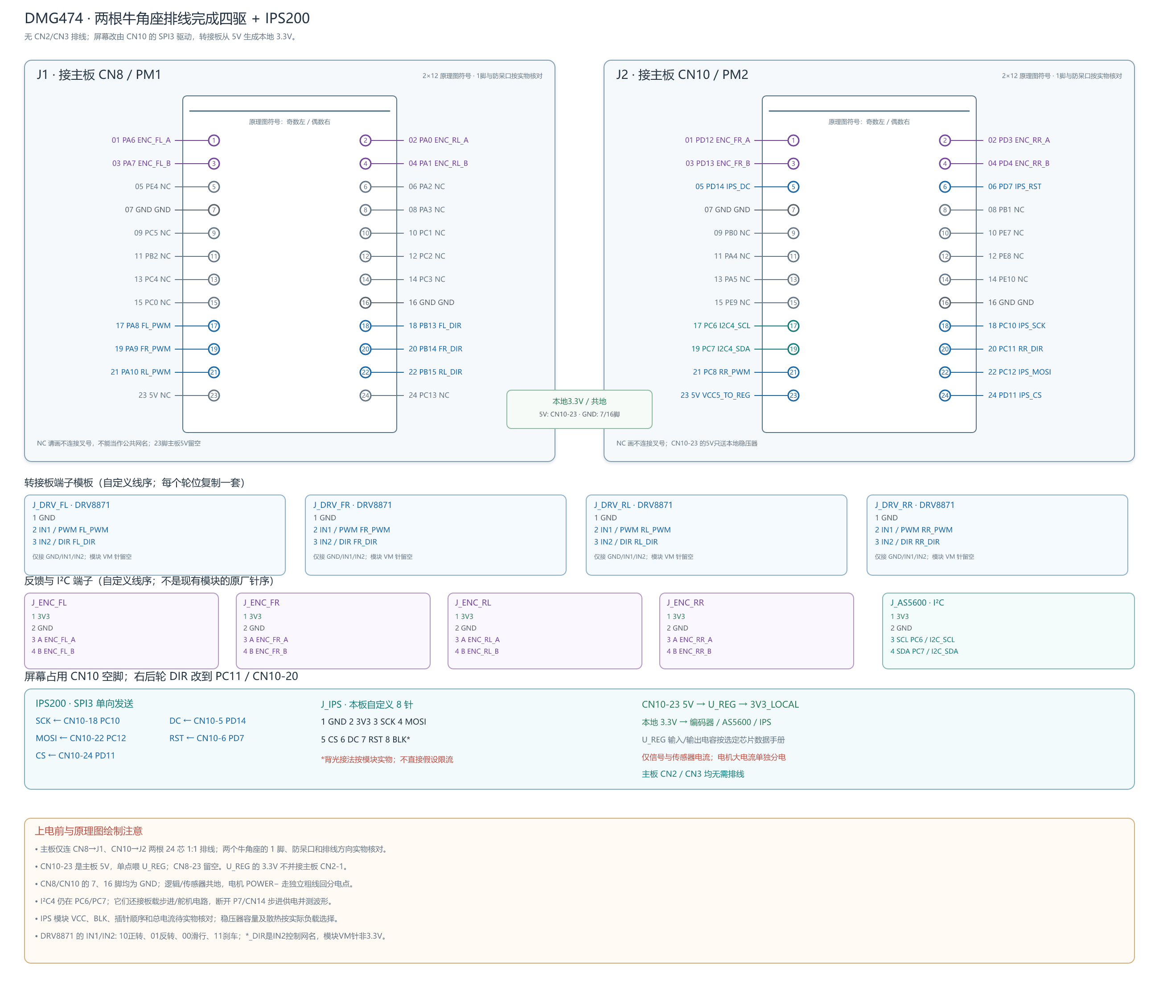
wiring_dmg474_drv8871/output/06_双牛角座全接线_V4.png
