lingkonglengfeng/nanhua-pendulum-car/wiring_dmg474_drv8871/output/07_TB6612双牛角座接线_V5.png

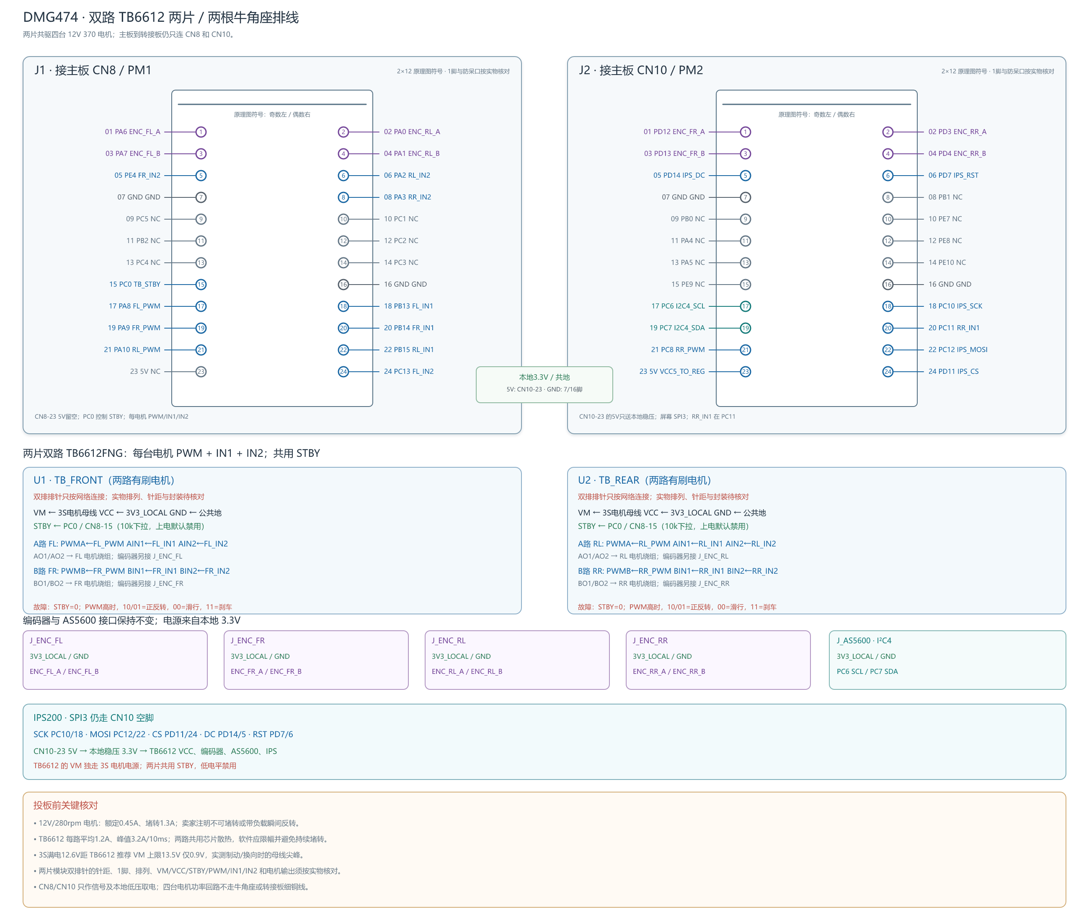
wiring_dmg474_drv8871/output/07_TB6612双牛角座接线_V5.png
