lingkonglengfeng/nanhua-pendulum-car/wiring_dmg474_drv8871/output/08_AT8236双模块双牛角座_V6.png

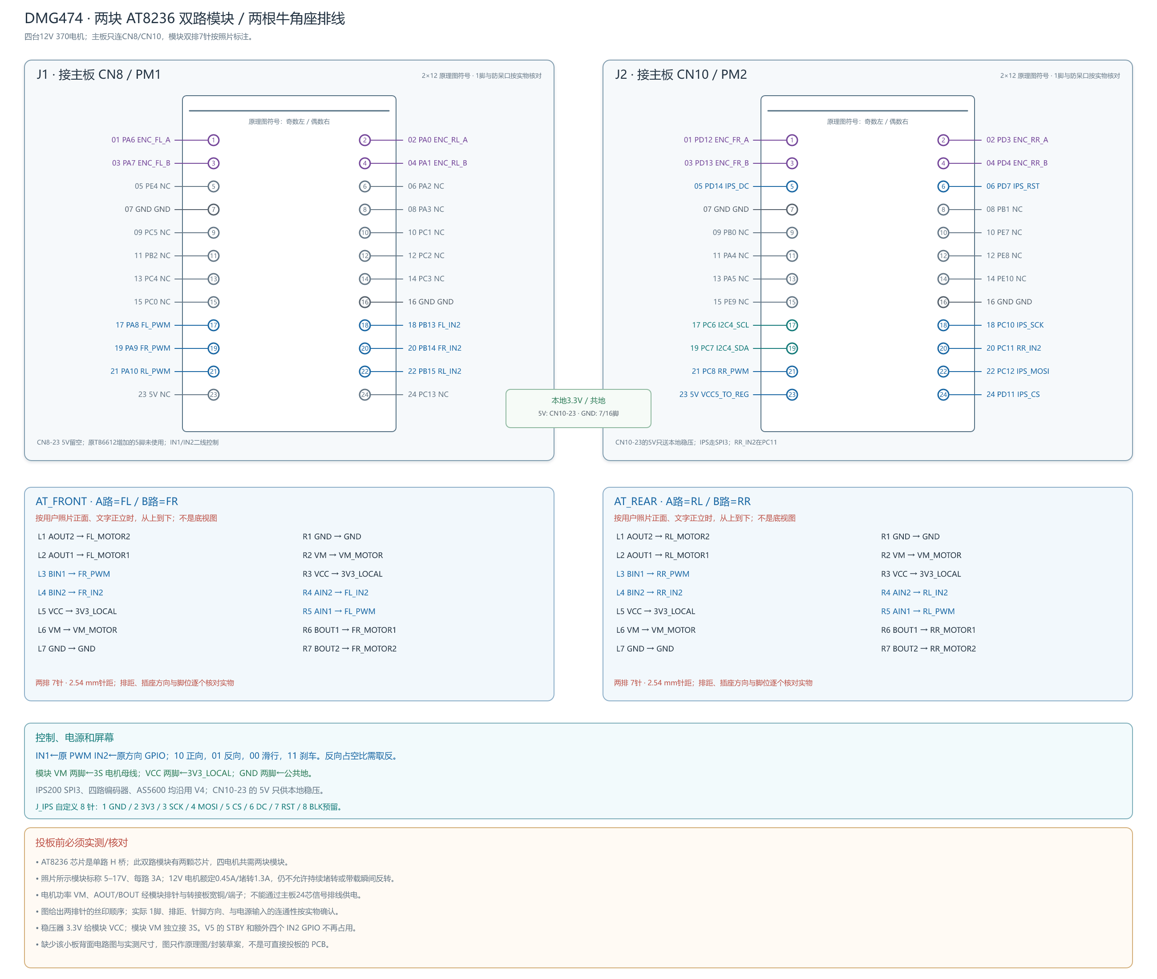
wiring_dmg474_drv8871/output/08_AT8236双模块双牛角座_V6.png
