lingkonglengfeng/nanhua-pendulum-car/wiring_dmg474_drv8871/reference/ATK_DMG474_board.png

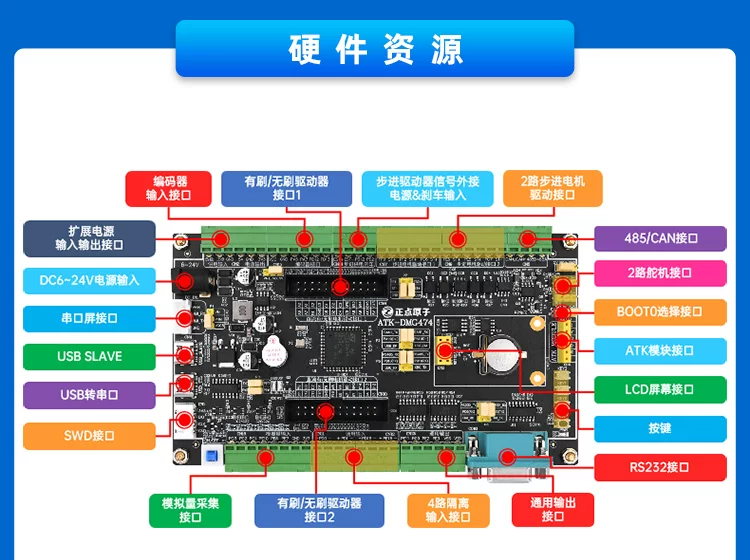
wiring_dmg474_drv8871/reference/ATK_DMG474_board.png
