lingkonglengfeng/nanhua-pendulum-car/wiring_dmg474_drv8871/reference/DRV8871_module.png

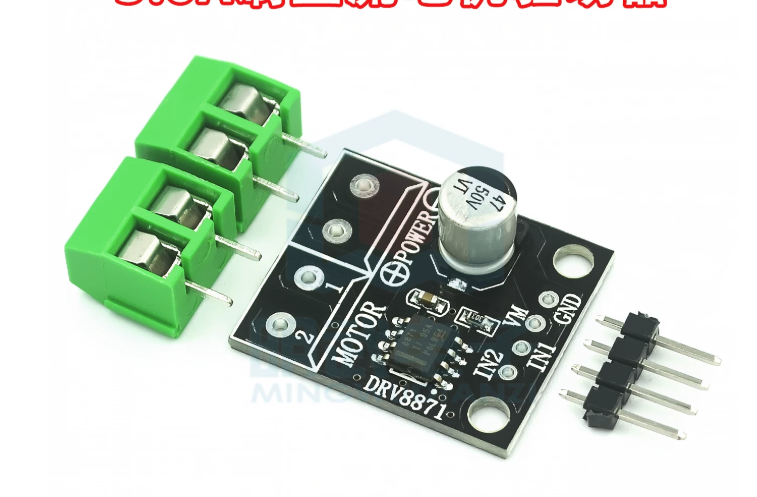
wiring_dmg474_drv8871/reference/DRV8871_module.png
