lingkonglengfeng/nanhua-pendulum-car/f103_bringup/docs/F103倒立摆完整方案.md

# F103C8T6 车载倒立摆完整实现方案（过渡平台）

> 目标：以 STM32F103C8T6（Blue Pill）为平台，完整实现选拔题全部功能：
> 摆起 → 倒立保持 20s → 抗扰 → 1.5m 正方形四顶点巡点（每点停 5s）。
> 设计原则：模块名/变量名与 G474 工程保持一致，将来回迁零障碍。

## 1. 系统组成

| 层 | 组成 |
|---|---|
| 控制器 | F103C8T6 @72MHz（HSE 8MHz × PLL9，已验证） |
| 执行 | 4× AT8236 通道（2 块双路模块）：PWM 20kHz + DIR 真值表映射 |
| 感知 | 摆杆角度 AS5600（位带 I2C，目标 200~400Hz）；4× 车轮霍尔编码器（定时器编码器模式）；航向 IMU（ICM-42688/MPU6050，强烈建议） |
| 人机 | PC13 LED（心跳/状态）；USART3 调试日志（报告数据用） |

## 2. 引脚分配（完整，最终版）

| 功能 | 引脚 | 外设/说明 |
|---|---|---|
| FL 轮 PWM | PA2 | TIM2_CH3（20kHz） |
| FR 轮 PWM | PA3 | TIM2_CH4 |
| RL 轮 PWM | PB0 | TIM3_CH3 |
| RR 轮 PWM | PB1 | TIM3_CH4 |
| FL/F** DIR ×4 | PB12~PB15 | GPIO 输出 |
| FL 编码器 A/B | PA8 / PA9 | TIM1 CH1/CH2 编码器 TI12 |
| RL 编码器 A/B | PA15 / PB3 | TIM2 CH1/CH2（部分重映射①） |
| FR 编码器 A/B | PB4 / PB5 | TIM3 CH1/CH2（部分重映射①） |
| RR 编码器 A/B | PB6 / PB7 | TIM4 CH1/CH2 |
| AS5600 + IMU SCL/SDA | PB8 / PB9 | 位带 I2C（开漏，模块 3.3V 上拉），两器件共总线（地址 0x36 / 0x68） |
| 调试串口 | PB10 / PB11 | USART3 TX/RX |
| LED | PC13 | 状态指示 |
| SWD | PA13 / PA14 | 下载调试 |

① TIM2 部分重映射（AFIO_MAPR.TIM2_REMAP=01）+ TIM3 部分重映射（=10）+ 关闭 JTAG（SWJ_CFG=010，保留 SWD）。
**原因：PA0~PA7 非 5V 容忍，编码器多为 5V 输出；重映射后编码器输入全部落在 5V 容忍(FT) 引脚上，5V/3.3V 输出都安全。**
若实测编码器输出 ≤3.3V，可用简化版：TIM2=PA0/PA1、TIM3=PA6/PA7（免重映射）。

**定时器复用技巧**：F103 只有 4 个定时器，4 路编码器占满 CH1/CH2；PWM 从 TIM2/TIM3 剩余
的 CH3/CH4 出（编码器模式下 CH3/CH4 完全空闲）。方向脚用普通 GPIO。

## 3. 关键电气检查点（上电前）

1. **编码器电平**：量编码器输出高电平（5V 还是 3.3V）→ 按上表接线（两版都安全，重映射版为默认）。
2. **共地**：Blue Pill GND ↔ 电池− ↔ 驱动模块 GND ↔ 编码器 GND ↔ AS5600/IMU GND 全部连通。
3. **供电**：VM 从电池走（只接 VM/GND）；逻辑 3.3V 从 Blue Pill 3V3；编码器 5V 从 Blue Pill 5V 针（USB 供电时可用）。
4. **电机线束**：XH6 转杜邦；电机两根功率线接模块 AOUT1/AOUT2。
5. 上电顺序：先逻辑（ST-Link/USB）→ 心跳灯闪 → 再接电池。急停习惯：测试前手边可随时拔电池。

## 4. 软件架构（裸机 + SysTick 1ms 调度）

| 文件 | 职责 |
|---|---|
| main.c | 初始化、SysTick 1ms 时基、主循环调度 |
| bsp.c | GPIO / AFIO 重映射 / 外设时钟 |
| encoder.c | 4 路计数读取，16 位回绕安全的差值解算 + 速度滤波 |
| motor.c | AT8236 映射：u>0 → (CCR=u·ARR, DIR=0)；u<0 → (CCR=(1−|u|)·ARR, DIR=1)；u=0 → (0,0) 滑行 |
| as5600.c | 位带 I2C（移植现版，延时改 ~20 迭代 → 约 250kHz） |
| pendulum.c | 零点/跨零/角速率低通（移植 pendulum_angle.c 数学部分） |
| imu.c | 陀螺/加速度读取、航向积分、静止零漂校正 |
| control.c | 直立环 + 速度环 + 转向环 |
| swingup.c | 能量法摆起 + 捕捉切换 + 失稳自动重试 |
| nav.c | 里程计（x,y,ψ）+ 方形巡点状态机 |
| log.c | 可选：USART3 100Hz 回传（测试数据/画波形） |

**调度表**：

| 任务 | 频率 | 说明 |
|---|---|---|
| AS5600 读角 | 200~400Hz | 与直立环同一时隙先读后算，保证数据新鲜 |
| 直立环 | 200Hz（5ms） | 先跑通后可提到 400Hz |
| 编码器读取 + 速度解算 | 200Hz | 计数差分 |
| 速度环 / 转向环 | 100Hz | |
| 摆起控制 | 200Hz | 能量法 |
| 里程计 / 航向 | 100Hz | |
| 巡点状态机 | 20~50Hz | |

## 5. 控制算法

### 5.1 直立环（200Hz，PD）
`u_θ = Kp·θ + Kd·θ̇` （θ：直立偏差 rad，杆顶向车头为正——沿用你们已验收的符号约定）

### 5.2 速度环（100Hz，PI 进角度给定）
`v_err = v_meas − v_ref`；`lean = Kp_v·v_err + Ki_v·∫v_err`
把 lean 叠加到角度给定（车身倾斜追速度），符号在阶段 2 实测标定。

### 5.3 转向环（100Hz，PD）
`u_ψ = Kp_ψ·(ψ_ref − ψ) + Kd_ψ·(ω_ref − ω_gyro)`

**轮输出合成**：`u_L = uθ + u_v − u_ψ`，`u_R = uθ + u_v + u_ψ` → motor_set()。

### 5.4 摆起（200Hz，能量法）
以直立为 θ=0，单位能量：`E = ½·θ̇² + (g/l)·(cosθ − 1)`（静止下垂 E=−2g/l，目标 E*=0）

```
u_a = Ke·(E* − E)·sign(θ̇·cosθ) + Kx·x + Kv·ẋ
```
前项泵能量，后两项把小车拉回原点（防漂移）。**捕捉条件**：|θ| < 20° 且 |θ̇| < 1.5 rad/s → 切直立环。
失稳（|θ| > 35°）自动回到摆起——满足"重复性"要求。

### 5.5 方形巡点（20~50Hz）
- 里程计：x, y 由 4 轮编码器（差速运动学）；航向 ψ 优先用陀螺积分（无 IMU 则用编码器差速，精度差）；
- 状态机：`待命 → 去点 k（v_ref 指向目标，ψ_ref 指向目标方向）→ 距点 <5cm → 保持 5s（位置保持 ±3~5cm）→ 下一点`；
- 起步巡点速度 ≤0.6 m/s，稳定后逐步提高（时间分）；
- 全程保持倒立：位置误差只进速度/航向环，直立环始终优先。

### 5.6 总体状态机
`上电标定(陀螺零漂) → 待命 → 摆起 → 倒立保持 →（任务使能）→ 巡点 → 完成`，
任意阶段失稳 → 自动摆起重试。启动触发用按键或串口命令。

## 6. 分阶段实施计划

| 阶段 | 内容 | 验收标准 |
|---|---|---|
| 0 ✅ | 台架固件（AS5600 + 单电机） | 已编译通过 |
| 1 | 硬件全检：4 编码器手转计数+方向表；4 电机真值表+方向表；AS5600 提速到 200Hz+；IMU 打通 | 计数/方向正确，read_errors 不涨 |
| 2 | 直立保持 | 手扶释放后自主保持 20s；轻推能回 |
| 3 | 摆起 | 静止自动摆起；连续 10 次成功 ≥8 次 |
| 4 | 巡点 | 1.5m 方形 4 点各停 5s；连续 3 轮成功 |
| 5 | 提速+数据 | 记录完成时间；导出测试数据（报告素材） |

## 7. 资源预算

| 资源 | 预估 | 余量 |
|---|---|---|
| Flash | ≈20~35KB | 64KB ✓ |
| RAM | ≤8KB（全局+栈+小缓冲） | 20KB ✓ |
| CPU | AS5600 读 ~8% + IMU ~10% + 控制 ~10% | <30% ✓（还有提速空间） |

不跑 FreeRTOS（裸机调度），不做动态内存——RAM 省着用，为日志/调参留余量。

## 8. 风险与对策

| 风险 | 对策 |
|---|---|
| 编码器 5V 电平伤 IO | 默认重映射方案（FT 引脚）；先测量再接线 |
| 摆起失败（机械摩擦大） | 检查摆杆枢轴/轴承顺畅度；能量法参数从慢到快调 |
| 陀螺零漂导致航向漂 | 上电静止标定；巡点每段重新对准目标方向 |
| 电池电压下降致参数漂移 | 比赛保持满电；可选加电池电压前馈 |
| AS5600 磁铁松动 | 磁铁+支架点胶固定（评分要求重复性） |
| 时间超支 | 按阶段推进，任一阶段超时先保底（保持+抗扰 50 分优先于巡点 50 分） |

## 9. 与 G474 工程的对应关系

- `as5600.c / pendulum.c` 直接沿用 G474 版逻辑（位带总线宏改 PB8/PB9）；
- `encoder/motor/control/swingup/nav/imu` 为新增模块——将来 G474 板修好后整体搬回，接口不变；
- Watch 变量沿用 `g_` 前缀命名（g_as5600_* / g_pendulum_* / g_motor_* / g_car_*），调试习惯无缝切换。

## 更新（整车版 v3，固件 0x103C8003）

工程已升级为与 F407 版功能对齐的整车固件（四电机+四 EXTI 编码器+AS5600+直立环），引脚方案更新如下（替代上文早期方案）：

| 功能 | 引脚 |
|---|---|
| 4 路 PWM（TIM1，20kHz）| PA8 / PA9 / PA10 / PA11 |
| 4 路 DIR | PA2 / PA3 / PB14 / PB15 |
| 编码器 w0 右前 | PA0(A) / PA1(B)，EXTI0 |
| 编码器 w1 左前 | PA4(A) / PA5(B)，EXTI4 |
| 编码器 w2 右后 | PA6(A) / PA7(B)，EXTI6 |
| 编码器 w3 左后 | PB12(A) / PB13(B)，EXTI12 |
| AS5600 位带 I2C | PB8(SCL) / PB9(SDA) |
| 心跳 LED | PC13（Blue Pill 板载）|
| SWD | PA13 / PA14 |

- 电机接线（模块 AIN1/AIN2、BIN1/BIN2、AOUT/BOUT → 线束 1/6）与 F407 版完全一致，只改探索者侧引脚名
- Watch 变量全套同名（g_enc_*、g_pendulum_*、g_bal_*），调试流程照 F407 版
- 编码器线束：3脚→A、4脚→B、5脚→3.3V、2脚→GND（5 脚供电不能忘）
