lingkonglengfeng/nanhua-pendulum-car/f103_bringup/docs/F103引脚分配与应用.md

# STM32F103C8T6 引脚分配与应用详解（蓝丸 · 整车版）

> 对应工程：`f103_bringup`（固件 0x103C8003）
> 与 F407 探索者版功能完全一致：四电机 + 四 EXTI 编码器 + AS5600 + 摆角处理 + 直立环
> 本文是引脚清单、选型理由、避坑规则与扩展余量的完整说明

## 1. 芯片资源速览

- LQFP48，37 个 GPIO，64KB Flash / 20KB RAM（本项目仅用 8.6KB Flash）
- 定时器：TIM1（高级）、TIM2/3/4（通用）
- 通信：2×SPI、2×I2C、3×USART、USB、CAN
- 本项目不用硬件 I2C（AS5600 走**位带**，任意两个 IO 都行——把外设资源留给以后）

## 2. 本项目引脚总表（21 个 GPIO）

| 引脚 | 用途 | 模式 | 备注 |
|---|---|---|---|
| **PA8** | 右前轮 PWM（TIM1_CH1） | AF 推挽 | 20kHz |
| **PA9** | 左前轮 PWM（TIM1_CH2） | AF 推挽 | 20kHz |
| **PA10** | 右后轮 PWM（TIM1_CH3） | AF 推挽 | 20kHz |
| **PA11** | 左后轮 PWM（TIM1_CH4） | AF 推挽 | 20kHz |
| **PA2** | 右前轮 DIR | 推挽输出 | 低=前进 |
| **PA3** | 左前轮 DIR | 推挽输出 | 低=前进 |
| **PB14** | 右后轮 DIR | 推挽输出 | 低=前进 |
| **PB15** | 左后轮 DIR | 推挽输出 | 低=前进 |
| **PA0** | 右前编码器 A | 输入上拉 + **EXTI0** | 双边沿中断 |
| **PA1** | 右前编码器 B | 输入上拉 | 中断里读电平判方向 |
| **PA4** | 左前编码器 A | 输入上拉 + **EXTI4** | |
| **PA5** | 左前编码器 B | 输入上拉 | |
| **PA6** | 右后编码器 A | 输入上拉 + **EXTI6** | |
| **PA7** | 右后编码器 B | 输入上拉 | |
| **PB12** | 左后编码器 A | 输入上拉 + **EXTI12** | |
| **PB13** | 左后编码器 B | 输入上拉 | |
| **PB8** | AS5600 SCL（位带 I2C） | 开漏输出 | ~150kHz，内置总线解锁 |
| **PB9** | AS5600 SDA（位带 I2C） | 开漏输出 | |
| **PC13** | 心跳 LED（板载蓝灯） | 推挽输出 | 低点亮，500ms 翻转 |
| **PA13** | SWDIO | SWD 调试 | 保留 |
| **PA14** | SWCLK | SWD 调试 | 保留 |

时钟：**PD0/PD1 接板载 8MHz 晶振**（HSE ×PLL9 = 72MHz），不可移作他用。

## 3. 分组详解与设计理由

### 3.1 PWM 组（PA8~PA11，TIM1 一个定时器出 4 路）

- 四路 PWM 放在**同一个定时器**：输出同频同相、寄存器同时更新——四轮驱动的加速指令天然同步，省掉跨定时器对齐的问题
- 20kHz（PSC=0、ARR=3599 @72MHz）：超出人耳，电机线圈不啸叫
- TIM1 是高级定时器：需要 MOE（`HAL_TIM_PWM_Start` 自动处理），本项目不开死区（单端驱动不需要）
- 把 4 路 PWM 集中在 PA8~PA11，是为了**把 PA0~PA7 整段留给编码器**（编码器最吃 EXTI 线号资源）

### 3.2 编码器组（EXTI 软件正交解码，2 倍频）

- **只有 A 相接中断**（双边沿），B 相普通输入——中断里读 B 电平判方向：`a≠b 则 +1，否则 -1`
- **EXTI 线号 = 引脚编号**（PA0 和 PB0 共用线 0！），所以 4 个 A 相必须落在**互不相同**的线号上：
  本项目用 **0（PA0）、4（PA4）、6（PA6）、12（PB12）** ✓
- B 相不受线号限制（不接中断），随便放
- 上拉输入：拔掉编码器时引脚不悬空
- 中断入口：`EXTI0/EXTI4/EXTI9_5（线6）/EXTI15_10（线12）` 四个处理函数（在 main.c）
- 计数速度：11 线 ×2 倍频×减速比 ≈ 每轮几百~几千计数/圈，72MHz 下 IRQ 负载 <3%
- 编码器供电：线束 **5 脚必须接 3.3V、2 脚接 GND**（血的教训：不供电=一个脉冲都没有）

### 3.3 AS5600（PB8/PB9 位带 I2C）

- 任意两个 IO 都能做位带 I2C（不占硬件外设）；选 PB8/PB9 是为了和 F407 版**引脚名相同**，两套平台接线不用改
- 开漏输出 + 模块自带 3.3V 上拉；驱动含 9 时钟总线解锁（从机卡死自恢复）
- 与 F407 版一样：5ms 读一次（200Hz），带通信/磁铁/30ms 时效三重有效性判断

### 3.4 心跳 LED（PC13）

- 蓝丸板载 LED，低电平点亮——不接调试器也能一眼看出"程序在跑"（F407 版没有这个，F103 版反而多一个优势）
- PC13 在 F103 上驱动能力弱（仅 2MHz/低驱动）：只适合 LED，别挂外设

### 3.5 调试（PA13/PA14）

- SWD 独占；工程的 `HAL_MspInit` 里调了 `SWJ_NOJTAG`——**JTAG 已禁用，PA15/PB3/PB4 已释放**（可作扩展 IO）

## 4. 避坑规则（选脚红线）

| 引脚 | 为什么避开 |
|---|---|
| **PB2** | BOOT1 启动配置脚（上电采样），当普通 IO 有启动模式风险 |
| **PC14/PC15** | 板载 32.768kHz 晶振 |
| **PD0/PD1** | 板载 8MHz 晶振（HSE） |
| **BOOT0 跳线** | 必须放"0"位——不在 0 位时上电进 Bootloader，程序"假死"（探索者上折腾一晚的同款坑） |
| PA0 的按钮 | 蓝丸 PA0 没有按钮（若是有按钮的板型，按钮=往 3.3V 短接，属无源负载，可接受） |

## 5. 空闲资源与扩展建议

### 空闲 GPIO（可用于以后加设备）

**PA12、PA15、PB0、PB1、PB3、PB4、PB5、PB6、PB7**（+ 若不做 USB 的其余脚）

| 想加什么 | 推荐引脚 | 说明 |
|---|---|---|
| 串口日志/无线 | **USART3 = PB10/PB11**（空闲） | 首选；别动 PA9/PA10 |
| IMU（ICM42688/MPU6050）| **直接挂 PB8/PB9 同一条位带 I2C** | 地址不同不冲突（0x36 vs 0x68） |
| SPI 屏/W25Q | **SPI1 重映射 = PB3/PB4/PB5** | JTAG 已禁，正好可用 |
| 备用 PWM | PB0/PB1（TIM3_CH3/4）、PB6/PB7（TIM4_CH1/2） | |
| 硬件 I2C（如果想换） | PB6/PB7（I2C1 默认脚，空闲） | 目前位带方案更稳，不刚需 |

### 定时器余量

- TIM1：已用（4 路 PWM）
- **TIM2 / TIM3 / TIM4：完全空闲**——以后做舵机/云台/双 PWM 硬件驱动的备用

## 6. F407 ↔ F103 引脚对照（换平台接线用）

| 功能 | 探索者 F407 | 蓝丸 F103 |
|---|---|---|
| 右前 PWM | PB0 | **PA8** |
| 左前 PWM | PB1 | **PA9** |
| 右后 PWM | PE5 | **PA10** |
| 左后 PWM | PE6 | **PA11** |
| 右前 DIR | PB6 | **PA2** |
| 左前 DIR | PB7 | **PA3** |
| 右后 DIR | PB10 | **PB14** |
| 左后 DIR | PB11 | **PB15** |
| w0 编码器 A/B | PA4 / PA5 | **PA0 / PA1** |
| w1 编码器 A/B | PE2 / PE3 | **PA4 / PA5** |
| w2 编码器 A/B | PD6 / PD7 | **PA6 / PA7** |
| w3 编码器 A/B | PC7 / PC12 | **PB12 / PB13** |
| AS5600 | PB8 / PB9 | **PB8 / PB9**（相同）|
| 心跳 LED | 无 | **PC13** |

**电机/模块侧接线完全不变**：模块 AIN1/AIN2、BIN1/BIN2、AOUT/BOUT→线束 1(M−)/6(M+)，只换开发板这一头的引脚名。

## 7. 完整外设接线速查

| 对端 | 接到蓝丸 |
|---|---|
| 4 个编码器线束 | 3脚→A（见上表）、4脚→B、**5脚→3.3V**、**2脚→GND** |
| 模块① 通道A（右前）| AIN1←PA8、AIN2←PA2、AOUT1→1孔、AOUT2→6孔 |
| 模块① 通道B（左前）| BIN1←PA9、BIN2←PA3、BOUT1→1孔、BOUT2→6孔 |
| 模块② 通道A（右后）| AIN1←PA10、AIN2←PB14、AOUT1→1孔、AOUT2→6孔 |
| 模块② 通道B（左后）| BIN1←PA11、BIN2←PB15、BOUT1→1孔、BOUT2→6孔 |
| 模块 VCC | 3.3V（×2 每块，共 4 路）|
| 模块 GND | 共地（板子 GND + 电池−，粗线走电机电流）|
| 模块 VM | 电池+（粗线，两块并联）|
| AS5600 | VCC→3.3V、GND→共地、SCL→PB8、SDA→PB9 |
| ST-Link | SWD 4 针：3V3、DIO(PA13)、CLK(PA14)、GND |

## 8. 中断与定时资源占用表

| 资源 | 用途 | 说明 |
|---|---|---|
| EXTI0 | 右前编码器 A | `EXTI0_IRQHandler` |
| EXTI4 | 左前编码器 A | `EXTI4_IRQHandler` |
| EXTI9_5 | 右后编码器 A（线6）| `EXTI9_5_IRQHandler` |
| EXTI15_10 | 左后编码器 A（线12）| `EXTI15_10_IRQHandler` |
| SysTick | HAL 1ms 时基 | main 循环用 5ms 软节拍 |
| TIM1 | 4 路 PWM | 20kHz |
