lingkonglengfeng/nanhua-pendulum-car/f103_bringup/docs/不改线双向慢衰减PWM.md

# 不改线双向慢衰减PWM（0x103C8013）

用户已明确控制信号线焊死，保持现有接线，要求软件修改。原先的换线方案不再执行；g_mot_sign仍为{-1,1,1,1}，反馈映射、编码器符号、轮位定义均保持。无需把方向符号改成全-1。

## 控制方式

F103的PA8～PA11改为普通GPIO输出，与原IN2引脚PA2/PA3/PB14/PB15一起由同步DMA生成波形。每路电气正向为10驱动/11刹车，电气反向为01驱动/11刹车，零输出为00滑行。两方向都采用慢衰减，不再存在原方案一边驱动/滑行、一边驱动/刹车的模式差异。

由TIM1更新事件触发DMA1通道5向GPIOA.BSRR写入；TIM1的TRGO同时经ITR0复位TIM4，TIM4更新事件触发DMA1通道7向GPIOB.BSRR写入。TIM4的URS保持0，允许从模式控制器产生更新DMA请求。固定引脚未改变，只写电机相关GPIO位，保留编码器、AS5600、串口和LED相关位。

TIM1分频为72MHz/56，波形64个槽，PWM约20089Hz；串口TX/RX仍使用DMA1通道2/3，HAL时基仍为TIM2。资料依据：[ST RM0008的DMA请求映射、内部触发连接与URS说明](https://www.st.com/resource/en/reference_manual/rm0008-stm32f101xx-stm32f102xx-stm32f103xx-stm32f105xx-and-stm32f107xx-advanced-armbased-32bit-mcus-stmicroelectronic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)、[AT8236第5页逻辑表](https://static.chipdip.ru/lib/795/DOC042795118.pdf)。

每5ms在ControlTask生成完整四轮波形，发布至两个staging bank之一；DMA中断只把完整波形复制到两个GPIO流共同空闲的循环缓冲区半区。ISR不做浮点计算、不调用RTOS或阻塞函数。发布bank/代号用极短PRIMASK区保护，防止高优先级中断看到不一致的组合。更换半区前检查两个DMA的剩余计数，至少预留32槽约25us；迟到只保留上一帧并增加诊断计数，不写DMA正在读取的半区。

单周期分辨率为1/64，在相邻5ms命令周期之间保留小数余量，使长期平均占空比接近输入值；例如10%会在6/64与7/64之间分配。具体低速表现仍需实物测试。DMA传输错误会关闭这两路波形DMA并将电机输入置00，计数暴露在M行；正常STOP也是00滑行。上电仍默认所有驱动入口关闭，没有自动起转。

实现以 `Core/Src/app_motor_dma.inc` 私有文件被app_vehicle.c包含，无需新增Keil编译源文件，避免再次出现漏加.c导致的链接错误。回退源码及12版AXF/HEX备份位于 `MDK-ARM/speed_pid_build/before_dma_motor/`。没有自动烧录。

## 第一轮只验右前正负10%

1. 在旧程序先STOP，再下载13版，确认g_fw_build=0x103C8013；保留原方向符号。
2. 逐行发送STOP、LOG 1、OPEN 3 10，记录约3秒，STOP并等停稳。
3. 单独发送OPEN 3 -10，记录约3秒，再STOP。

先不发送RUN 1，不继续沿用旧快衰减下的59%作为新慢衰减起点。记录全部C/S/W/M/D/F行并反馈两个方向是否都能起转、是否平稳。如果两方向均可小输出起转，再做60RPM闭环试验，重新验证增益；原后轮基础参数也不能自动视为新驱动方式下已通过。

额外测速低通仍为{0,60,0,60}ms，可通过Watch设0旁路，M/OPEN测试不由速度PID驱动。

## CSV_V5与Watch

D/C/S/W/F列数保持49/28/22/18/10。新增每次配置报告及GET返回的21列M行：

`M,ms,slow_decay,slots,pwm_hz,periods,dma_err,refill_late,isr_max_cycles,on0,in1_hi0,in2_hi0,on1,in1_hi1,in2_hi1,on2,in1_hi2,in2_hi2,on3,in1_hi3,in2_hi3`

- slow_decay=1、slots=64。on是本周期实际量化的驱动槽数，in1_hi/in2_hi是两根输入线的高电平槽数；它们不是GPIO瞬时电平，波形应用可能滞后该命令至多几个PWM周期。
- 正10%预计on3=6或7、in1_hi3=64、in2_hi3=58或57；负10%则in1_hi3与in2_hi3对换。其它三轮应全0。
- periods正常应持续增长，72MHz下每秒约20089；这是DMA循环完成计数，长时间暂停CPU造成中断合并时不能作为精确频率测量。
- dma_err正常0，refill_late正常应为0或无持续增加。isr_max_cycles/72可估算ISR最大微秒耗时；运行时序尚未上板验证，需通过M行核对，最好测量IN1/IN2波形。
- Watch对应g_motor_on_ticks、g_motor_in1_ticks、g_motor_in2_ticks、g_motor_pwm_hz、g_motor_dma_periods、g_motor_dma_errors、g_motor_dma_late、g_motor_dma_max_cycles。
- 旧D.ccr字段现在是IN1高电平占比换算至3599刻度的兼容观察量，不是TIM1的CCR；D.dir是电气方向命令，不是IN2静态引脚电平。实际波形占比以M为准，原始测试g_motor_test_pwm_pct/dir仍沿用旧命令接口，以便OPEN指令保持兼容。

## 验证与资源

生产波形函数已回归检查中间值、端点、混合四轮方向、00滑行、10/01驱动与11刹车、非电机GPIO位不变；实际s_motor_apply的方向映射和限幅、小数余量、反转清余量、完整波形发布、STOP清输出、双流共同空闲半区及环绕/时限边界均通过。本机测试不能代替定时器内部触发和真实DMA总线时序验证。

原命令/串口DMA边界及滤波回归通过，格式检查包含21列M行。压力包1891/2048字节，默认20Hz上限估算8312字节/秒。39个源文件完整构建，Keil Rebuild为0 Error、0 Warning。

Code34784、RO2828、RW572、ZI19404字节，ROM38184字节，静态RAM19976/20480字节，包含既有任务栈和FreeRTOS堆；未减少任务栈或堆。日志任务已知调用链1268/2048字节，DMA7中断调用链56字节（不含硬件异常入栈）。CPU负载、GPIO相位、半区更新时间和物理调速效果均需新日志/实测确认。

## 03:30:26 首轮板上日志

原始日志、归一化CSV、汇总及曲线位于 `logs/2026-10-18_033026/`。板上版本确认为13；OPEN正10%、STOP、负10%均成功回执。共454条完整D记录，均为5ms采样，控制漏周期与晚唤醒均0，其它三轮输出始终0。

| 右前轮 | 跳过起转1秒后的D均值 | 同段累计计数平均 | D范围 | 原20ms测速标准差 |
|---|---:|---:|---|---:|
| OPEN 3 10 | +25.23RPM | +25.25RPM | 22.99～25.80RPM | 1.27RPM |
| OPEN 3 -10 | -25.53RPM | -25.52RPM | -26.28～-23.34RPM | 1.00RPM |

累计计数计算的两方向速度幅值相差约1.1%。原先正10%不转、负10%转的明显差异在本轮已经消失，软件改波形的效果得到电机计数响应支持；真实IN1/IN2引脚相位尚未用仪器直接测量。

M的DMA错误与refill_late全0，periods每秒约增加20089，符合预期频率。记录到ISR最大1144周期，即72MHz下约15.89us，低于32槽约24.89us的换缓冲区预留；这只是本轮观测，不能代替所有负载下的最坏时序验证。日志任务最小余栈796字节。log_drop从4增加到33，表示日志包发送忙时跳过数据帧，控制漏周期仍为0，不能把该计数解释为车轮漏计或控制丢周期。

停止段计数稳定、测速回0。截取末尾仍处于负10%OPEN，未见最终STOP，下一轮前先STOP。

目前完成的是固定输出双向对照，还没有验证新版下的60RPM闭环。下一轮先用通道0此前的基础增益做右前单轮试验：STOP、LOG 1、PIDW 3 0.001562 0.01 0、LED 3 5、SET 3 60、RUN 1，记录10～12秒后STOP。各行等待OK回执，保存M/F及全部数据。以实物平稳程度、累计计数跟踪、原测速/反馈与PWM变化共同判断，不单独用灯或额外低通后的D判断通过。
