lingkonglengfeng/nanhua-pendulum-car/f103_bringup/docs/串口控制指令.md

# 串口控制速度环（固件 0x103C8041）

当前v48（0x103C8048）：支持BALSAFE 0 0关闭轮速超限退出和直立运行时限；BALSAFE 200 0恢复200RPM连续200ms退出。命令会先STOP，之后需重新ARM或SWING；仅RAM生效，复位恢复200RPM默认。角度、传感器及起摆15秒时限等原逻辑保留。详见[关闭轮速超限退出](关闭轮速超限退出.md)。

v47（0x103C8047）：BALSTEP默认直行上限20RPM，等价BALSTEP 1 20；起点和终点保持均改为固定计时5秒，平衡修正不重置计时。行进到点仍需位置/速度条件连续400ms。

v45（0x103C8045）新增 `BALSTEP [metres rpm]`：默认当前位置稳住5秒、向前1米、终点稳住5秒后继续保持；仅直立ACTIVE时接受。实测65mm轮径已固化，`BALWHEEL mm`可修改滚动直径（20～300，先STOP，RAM配置）。新增P阶段7/8/9，完成回到原保持状态5；不自动返程。详见[完整使用与状态说明](直立保持5秒直走1米再保持5秒.md)。保留v44起摆37%/.65/63.5/2和速度外环.040/.0015/3、trim=-.81。下文各版本为历史记录。

v42（0x103C8042）新增 `AS5600`：全部状态、LOG 0 均可主动查询最新 C/S/Q，不启动电机或改变控制。网页新增对应读取按钮，见 [AS5600主动查询](AS5600主动查询.md)。原 GET 和周期日志的运行状态条件保持原有行为。

v41按用户成功试验固化SWINGENERGY0.65/66/2，其余v40默认与命令/协议不变。上电自然下垂静止ZERO，等待约1秒，再单独SWING即可，不必重发参数。成功轮完整日志与连续20秒保持仍待核验。

v40自动起摆接管单独改顶端±2°，要求原始/滤波/40ms预测角都在范围内；手动ARM仍±8°连续400ms。新增 `SWINGCATCH deg`（0.5～4，修改停止），实际角带还受BALWIN入口较小值约束。起摆开机默认35%/±2圈/15秒、能量.65/65/2；上电ZERO等待标定完成后直接SWING。U末尾新增capture_deg为18列，SWING_TRACE_V2/CSV_V22，正常旧日志列数保留。详见[自动起摆顶端接管修正](自动起摆顶端接管修正.md)。旧版默认值见历史条目。

v39新增能量反馈自动起摆：自然下垂静止ZERO，等待约1秒标定结束，再单独发 `SWING`。默认35%输出、起点±2轮轴圈、10秒；`SWINGCFG pct rev ms`、`SWINGENERGY gain omega2 capture_rate`、`SWINGDIR +/-1`可配置，修改会停止。SWING运行state6，近顶端满足角度/角速度/预测角及车速条件后自动接入原ACTIVE与位置保持，无需手扶400ms；手动ARM流程仍±8°/400ms。新增40ms U17起摆日志，CSV_V21，正常TRACE_V2/旧列保留，TRAVEL=10退出诊断。详见[自动起摆控制与调试](自动起摆控制与调试.md)。软件验证完成，实车起摆未验证。

v38修正SPIN状态的前后测速，改用四轮平均以匹配位置里程；此前排序中间两项在转向轮速不一致时会低估平移。其它模式和PID保留，CSV_V20/TRACE_V2、字段数不变，详见[原地转向前后测速均值修正](原地转向前后测速均值修正.md)。首轮用BALSPIN2作对照，实际窜动改善待验证。

v37新增 `BALSPIN rpm`（±10，仅ACTIVE），原地转向时同时保持进入SPIN时的平均里程锚点；重复正反转速或BALSPIN0不重设锚点，0停止差速并继续保持。P.seq_state6为SPIN，旧BALTURN仍取消位置模式。PID/零点/阈值保留，见[原地转向与零点整定](原地转向与零点整定.md)。完整CSV_V19，旧各日志字段数不变；新模式待实车验证。

v36默认捕捉改为180°±8°连续400ms，捕捉进入ACTIVE时自动把当前位置记0并保持，无需再发BALHOLD/BALPZERO。上电先ZERO标定；重新ARM捕捉会以新进入地点为原点。退出±30°、200RPM/200ms及X诊断保留，见[自动捕捉与当前位置保持](自动捕捉与当前位置保持.md)。以下旧版本±1.4°与手动启用保持说明为历史值。

v35按用户要求将默认超速退出改为任一轮绝对速度>200RPM连续达到200ms；BALSAFE第二项仍是总时限，可用BALSAFE200/0关闭总时限。新增一次性X11退出诊断，显示SPEED/ANGLE/TIMING等原因、实际阈值和冻结观测值，在非ACTIVE/LOG0也可发送，普通参数仍仅ACTIVE。详见[退出诊断与200RPM阈值](退出诊断与200RPM阈值.md)。以下旧版60RPM/50ms和只靠Watch确认退出的说明为历史记录。

v34新增编码器平均里程位置保持：`BALPOS rev`（±5圈）设置绝对目标且不重设原点，`BALHOLD`保持当前位置，`BALPZERO`将当前位置设0并保持，`BALPOSCFG kp max_rpm`默认20/6。位置/保持/置零只在ACTIVE且速度外环启用、转向请求及斜坡归零时接受；启动不自动启用，位置控制P.seq_state=5，非零转向/普通速度/STOP取消。新增O5日志，旧T/B/V/E/P/Y/H列数保持，CSV_V17，详见[编码器平均里程位置保持](编码器平均里程位置保持.md)。以下为旧版本记录。

v33增加转向PI及 `BALTURNPI kp ki`（0～0.02、0～0.05；可在ACTIVE修改，清转向积分），默认0.008/0.010。直立共同输出上限改80%、转向差动上限12%、退出角度改180°±30°；捕捉仍±1.4°连续400ms，不限时与原速度保护保留。Y行末尾追加ki/i，现10列，完整CSV_V16，其余T/B/V/E/P/H列数不改。见[转向积分与30度退出](转向积分与30度退出.md)。下文为旧版本记录。

v32加入F103低速周期/高速计数混合测速，新增H6列用于观察四轮估算RPM；转向P默认提高到0.008，指令格式不变。原计数fast速度仍用于独立超速退出，旧T/B/V/E/P/Y列数保留，完整协议CSV_V15；捕捉、时限和PID等参数延续v31。见[低速周期测速与转向增益](低速周期测速与转向增益.md)。下文v31及更早段落保留为历史记录。

v31新增 `BALTURN rpm`（±10，正右/负左，左右平均轮速差的一半），仅ACTIVE接受，斜坡变化并优先保留直立输出。默认运行时限改为0，不再24秒自动退出；`BALSAFE 60 0` 关闭到时退出，其余退出条件保留，非零时限仍500～60000ms。BALSPD保留当前转向请求，非零BALTURN取消BALSEQ且把平移目标设0；BALSEQ要求转向目标和斜坡均0。新Y8列每100ms记录差速目标/实测/输出，T/B/V/E/P列不改，全量CSV_V14。详细操作与限制见[长时间直立与差速转向](长时间直立与差速转向.md)。以下v30和更早部分为版本记录，当前默认值以上述v31为准。

v30新增保持倒立的BALSPD目标速度和BALSEQ直走/停稳/返原点流程，仅ACTIVE时接受。默认BALSEQ等于8RPM上限/0.25轮轴圈/停稳2000ms，回程基于编码器相对里程；实际精度需实车验证。捕捉按用户要求改为±1.4°连续400ms，退出改为±25°。源码默认速度外环0.038/0.0009、60RPM/24000ms，目标0且不自动跑序列。新增P9列运动日志，旧T/B/V/E列保持；完整步骤和限制见[直立直走停车返程测试](直立直走停车返程测试.md)。普通FWD/REV/MOVE仍退出直立。

v29增加F103编码器100μs非阻塞稳定电平确认与重复IRQ检查，T/B/V旧列保持，ACTIVE期间新增E19列累计诊断。全量协议CSV_V12，TRACE_V2不改T格式。源码默认PID仍为v28起点，恢复当前0.038/0.0009和12秒候选的下载步骤见[编码器毛刺与重复中断检查](编码器毛刺与重复中断检查.md)。本次先核查测速突跳，不同时调增益。

v28按用户更换实心铁棒后的要求，将最近参数固化为开机试调初值：直立8.4/0/0.17、速度外环启用0.037/0.0007/3°、70%输出、60RPM/8000ms、捕捉±0.5°/400ms、BALSLEW10、trim0、BALTRACE1。仍开机OFF，每次需要最低点ZERO；旧版下面的“默认”描述为历史值，当前值及上电步骤以[实心铁棒默认参数](实心铁棒默认参数.md)为准。这组尚未验证新结构稳定性。

v26不加新命令，直立外环车速输入改为四轮排序中间两路均值，再做原100ms低通；原始最大轮速仍用于超速保护。精简TRACE_V2的T16列新增四轮测速和robust_rpm，全量CSV_V11的V16列新增robust_rpm，原B不变。下载恢复指令及局限见[直立外环单轮测速尖峰处理](直立外环单轮测速尖峰处理.md)。

v25新增 `BALTRIM deg`（-1～+1°，默认0，修改会停止，需ARM或ZERO），为控制目标添加独立平衡点偏置，不改写AS5600几何标定/角度保护。V尾部新增trim_deg，全量CSV_V10；T11列格式不变。完整烧录后恢复指令及试调说明见[直立平衡点微调](直立平衡点微调.md)。

v24新增 `BALTRACE 0/1`：1启用20ms/50Hz精简T日志，0恢复全量CSV；修改会停止，需ARM或ZERO。仍仅ACTIVE输出参数，LOG仍是总开关，控制算法与v23相同。详见[直立环50Hz精简日志](直立环50Hz精简日志.md)。

v23新增 `BALSLEW deg_s`（0.1～10°/s，默认1，修改会停止，需ARM或ZERO），允许调整速度外环目标角变化率。协议CSV_V9的V行新增尾字段slew_deg_s，原B不变。新版候选试验与模型局限见[外环变化率与电机延迟复核](外环变化率与电机延迟复核.md)。

v22新增 `BALVEL kp ki max_deg`：零速外环，增益范围0～0.05°/RPM、0～0.01°/(RPM·s)，目标角最大偏置0.1～3°；两增益为0关闭，默认关闭。修改会停止，需ARM或ZERO。角速度滤波已改为10ms，读取仍200Hz。详情及初估参数见[10ms滤波与直立速度外环](10ms滤波与直立速度外环.md)。

v21新增 `BALSAFE max_rpm max_run_ms`，默认 `BALSAFE 40 1500`：任一轮基础滤波RPM绝对值连续50ms超过阈值，或ACTIVE运行达到设定时长，撤掉驱动并锁定。范围10～280RPM、500～60000整数ms；修改会停机，需ARM或ZERO。此为退出阈值，不是恒速控制；STOP及保护退出均为滑行。详见[直立试验自动退出保护](直立试验自动退出保护.md)。

v20：参数仅在直立环state=4时打印；其它状态保持静默，但指令接收/回执及主动HELP继续工作。非运行状态GET只回执。直立PID默认输出方向BALSIGN=-1，按用户实测修正“杆前倾、车却后退”的现象。

v19依据用户最新逐轮确认：0右后、1右前、2左后、3左前；将左前（3）和右后（0）相对v18取反。当前电机方向 `{-1,-1,1,1}`、编码器方向 `{-1,1,-1,-1}`，映射 `{0,2,1,3}`。

新增整车 `FWD rpm` / `REV rpm` / `MOVE signed_rpm`，以及最低点 `ZERO`、手扶400ms捕捉、`ARM`、`BALPID` 等直立控制；完整流程见 [倒立摆串口控制与最低点标定](倒立摆串口控制与最低点标定.md)。前后指令直接切到四轮速度环；STOP同时取消直立准备。新增B日志，默认打印周期100ms。

## 接线与格式

USART3，**115200、8N1、无流控，ASCII 文本发送，末尾加 CR、LF 或 CRLF**。命令不区分大小写，参数用空格或 Tab 分开；每条发完等待回执，再发下一条。参数可用小数或科学计数法。

| F103 | USB-TTL |
|---|---|
| PB10（TX） | RX |
| PB11（RX） | TX |
| GND | GND |

使用 3.3V TTL。板子已有供电时无需连接 USB-TTL 的供电脚。

发送使用文本模式，不选 HEX。串口助手的发送换行选项必须开启；没有行尾时，固件只保存半条命令，不会执行。

## 先测试通道 0

F103 电机方向为 `g_mot_sign={-1,-1,1,1}`；编码器方向为 `{-1,1,-1,-1}`，反馈映射为 `{0,2,1,3}`。轮位为0右后、1右前、2左后、3左前。RPM 每圈计数仍为 `11×2×21.3=468.6`。

架空车轮，依次发送下面各行，每行等待 `A,...,OK,...`：

```text
STOP
PID 0.001562 0.01 0
SET 0 60
RUN 1
```

`RUN 1` 自动退出原始单电机测试、开环直行和直立模式并进入速度环；从停止或其它模式进入时清 PID 历史。已在速度模式时重复发送保持现有积分，不会因重复使能掉速。`SET` 只改目标，不会自行开启电机。

停止时发送：

```text
STOP
```

停止命令会关闭全部电机控制入口、清零四轮目标和 PID 历史，并在该控制周期输出滑行；轮子仍可能因惯性继续转动。再次运行前需重新设置目标。

反馈方向若仍不对，先停止，确认物理轮位和前进方向后再改电机方向或编码器符号；不要在持续饱和的状态下靠增益调整修正方向问题。

## 指令表

| 指令 | 示例 | 行为 |
|---|---|---|
| `HELP` | `HELP` | 返回简短英文指令帮助 |
| `AS5600` | `AS5600` | 单次读取当前 AS5600 机械角、磁场和通信计数；停止/LOG 0 也可用 |
| `GET` | `GET` | 直立环运行时返回完整参数（LOG=0也可）；其它状态仅回执 |
| `SET <轮号> <rpm>` | `SET 0 60` | 设置指定电机目标，轮号 0～3，负数表示反向 |
| `ALL <rpm>` | `ALL 30` | 四轮使用相同目标 |
| `TARGET <r0> <r1> <r2> <r3>` | `TARGET 60 60 0 0` | 在同一控制周期设置四轮目标 |
| `PID <kp> <ki> <kd>` | `PID 0.001562 0.01 0` | 同时设置增益，清 PID 历史 |
| `PIDW <轮号> <kp> <ki> <kd>` | `PIDW 3 0.0008 0.005 0` | 只设置该轮独立增益、清该轮历史；其它轮不变 |
| `KP <值>` | `KP 0.002` | 单独设置 Kp，清 PID 历史 |
| `KI <值>` | `KI 0.003` | 单独设置 Ki，清 PID 历史 |
| `KD <值>` | `KD 0` | 单独设置 Kd，清 PID 历史 |
| `RUN 1` | `RUN 1` | 退出其它驱动模式并启用速度环；首次进入清历史，重复使能保持历史 |
| `OPEN <轮号> <有符号百分比>` | `OPEN 3 59` | 关闭速度/直立/直行模式，清四轮目标和PID历史，仅指定轮恒定输出；整数-100～100，按电机方向符号换算 |
| `STOP` / `RUN 0` | `STOP` | 关闭速度环及其它驱动模式，清四轮目标和 PID 历史 |
| `RESET` | `RESET` | 清积分/微分历史，保持当前目标和运行模式 |
| `MAP <电机> <编码器>` | `MAP 0 0` | 设置反馈对应通道，两个索引均为 0～3；清 PID 历史 |
| `ENCSIGN <编码器> <符号>` | `ENCSIGN 0 -1` | 修改指定编码器符号，只接受 ±1；清 PID 历史 |
| `MOTSIGN <电机> <符号>` | `MOTSIGN 0 -1` | 修改指定电机驱动符号，只接受 ±1；清 PID 历史 |
| `CPR <每圈计数>` | `CPR 468.6` | 修改四轮共用的输出轴每圈计数；清 PID 历史 |
| `LOG <0或1>` | `LOG 0` | 关闭/允许直立运行期间的周期日志，不能绕过state=4条件；指令接收和回执继续工作 |
| `PERIOD <毫秒>` | `PERIOD 100` | 日志周期，整数20～1000，默认100，过快可能跳过日志 |
| `LED <电机> <容差百分比>` | `LED 0 5` | PC13 观察通道和速度到达容差，默认通道 0、5% |

目标 RPM 的语法范围为 ±1000000，增益 0～100，CPR 0.001～1000000，LED 容差 0～100；这些是输入有效性范围，不代表电机可实现的速度。当前电机试调仍建议从 60RPM 开始。`RUN` 和 `LOG` 参数必须严格写 `0` 或 `1`，不接受 `1.0`。

设置写入RAM，掉电、复位或重新下载后恢复源码默认值；本版没有写Flash的SAVE命令。上电默认目标0、速度环关闭、无周期打印，满足直立运行条件后自动打印。

## 回执和日志

每条命令由固件分配编号，成功示例：

```text
A,1,OK,SET
A,2,OK,RUN
```

成功回执表示指令已在控制周期开始时应用；它不表示机械速度已到达目标。到达情况看 D 数据行的 `rpmN/errorN` 或 PC13。

错误示例：

```text
A,3,ERR,SET,BAD_ARGS
A,4,ERR,UNKNOWN,UNKNOWN_COMMAND
```

错误原因包括 `BAD_ARGS`、`UNKNOWN_COMMAND`、`QUEUE_FULL`、`RX_OVERFLOW`、`LINE_TOO_LONG`、`BAD_CHAR`、`RX_ERROR`。非法或不完整命令不会部分修改参数。错误只丢弃命令/损坏行，不自动切换电机模式。出现接收错误后发送一个空行，再发送完整命令，以重新对齐行边界。

接收单行最多 95 个 ASCII 字符（不含行尾）。串口输入队列可容纳 8 条待执行命令，回执队列容纳 16 条；正常交互请逐条等待回执。瞬间灌入大量指令可能收到队列满或导致回执丢弃计数增加。

回执优先于周期日志；运行直立环时GET主动返回一组状态，非运行时GET只回执。HELP可在任意状态返回帮助。用于调参时保持LOG 1，保存包含B行的完整运行日志。退出后不再提交新参数包，已提交的DMA包正常发完。S行包含通信、任务栈等诊断。

## 实现与验证

TX 使用 DMA1 通道 2；RX 使用 DMA1 通道 3、512 字节循环缓冲区。低优先级任务每 5ms 服务 RX，先复制最多 256 字节再解析，避免格式化日志期间占用 DMA 接收缓冲区。USART3 接收错误中断和 DMA 中断只维护标志/计数，不解析字符串、不操作电机。

完整且合法的命令进入固定队列，200Hz ControlTask 每周期开始应用，再计算本周期反馈和输出。四轮目标与三项增益的批量设置在同一个控制周期生效。串口拔出、日志错误和接收错误均不会自动停机；停止使用显式 `STOP`。

新增 Watch：`g_uart_rx_bytes`、`g_uart_rx_overruns`、`g_uart_rx_dma_errors`、`g_uart_rx_uart_errors`、`g_uart_cmd_received`、`g_uart_cmd_applied`、`g_uart_cmd_errors`、`g_uart_cmd_reply_drops`。它们是观察量，请由固件更新。

本机构建脚本为 `build_speed_pid.ps1`。命令回归脚本 `verify_commands.ps1` 编译真实生产解析器及提取的接收/回执函数，覆盖分段接收、CR/LF/CRLF、全部指令、控制周期提交、STOP、非法数值和后缀、增益原子更新、溢出恢复、队列满、DMA 环绕与 NDTR=0、接收错误、关闭日志后的回执和 HELP/GET 包长度。寄存器边界测试使用本机桩，不代表板上 DMA 已经验证；实际串口和车轮响应仍需下载后采集确认。

本版增加 AS5600 BUSY 快速返回和耗时诊断，保持 PID 参数不变。39 个源文件编译/链接通过，Keil Rebuild 0 Error、0 Warning；三组本机回归通过。静态 RAM 17608 字节，ROM 34608 字节。S 行增加 AS5600 诊断字段，周期修复仍需新日志确认。详见 [首轮日志分析](首轮速度环日志分析.md)。

固件0x103C8010已将默认Ki固化为0.01，通道0空载30/60/100RPM跟踪已验证。复位仍默认关闭电机。详见 [基础参数报告](通道0速度环基础参数.md)。

通道1/2已根据联动日志修正默认反馈映射与编码器2符号，详见 [映射修正](通道1-2反馈映射修正.md)。

从0x103C8010起，已在速度模式时重复RUN 1保持积分历史；从停止/其它驱动模式进入仍重置。详见 [通道1实测](通道1速度环实测.md)。

0x103C8010新增PIDW单轮PID覆盖与W配置行，详见 [单轮PID调试](单轮PID调试.md)。后轮参数不变，前轮试验组尚未固化。

0x103C8011新增OPEN固定输出诊断；59表示输出59%，不是59RPM。该模式PC13熄灭是正常现象，观察测速和实际CCR/DIR。停止仍使用STOP，切回闭环需重新SET目标再RUN 1。详见 [右前轮固定输出对照](右前轮固定输出对照.md)。

0x103C8012只给前轮1/3增加60ms反馈低通，原测速保留在F行；保存日志时也需保留F行。详见 [前轮测速反馈滤波](前轮测速反馈滤波.md)。

0x103C8013保留焊死的全部接线和原方向符号，通过GPIO DMA把正反转都改为慢衰减，协议CSV_V5新增21列M行。旧ccr/dir字段不再代表TIM比较寄存器/静态IN2电平，第一轮先做OPEN正负10%对照，详见 [不改线双向慢衰减PWM](不改线双向慢衰减PWM.md)。

0x103C8014协议CSV_V6新增9列Q行（原始AS5600角度、度数、STATUS/valid、MD/ML/MH），每次D后发送，GET也返回。角度诊断步骤见 [AS5600角度串口诊断](AS5600角度串口诊断.md)，电机驱动和参数保持13版。
