lingkonglengfeng/nanhua-pendulum-car/f103_bringup/docs/原地转向与零点整定.md

# 原地转向与零点整定

v38（0x103C8038）更新：SPIN的前后速度反馈改四轮平均，与平均里程一致；非SPIN模式保留中间两项抑制。用户无外力10RPM试验发现前后往复及约2.55RPM测量偏差，见[均值修正分析](原地转向前后测速均值修正.md)。以下v37记录为此前实现。

2026-10-18，固件 `0x103C8037`。用户当前优先目标为原地转弯，并询问零点与11线编码器是否妨碍位置保持。本版新增BALSPIN，将平均里程保持与差速转向同时启用；原BALTURN保留取消位置模式的旧语义。编译和逻辑回归通过，未自动烧录或实车验证。

## 零点与当前推杆记录

摆杆角度零点由自然下垂静止时ZERO标定，最高点取底点加180°；BALTRIM是直立参考的微小偏置，二者与车轮里程原点不同。BALPZERO只是把当前平均里程记0，不会校正摆杆平衡点。应先在同一平整地面取得无外力的静止记录，再判断是否有恒定角度偏置；不能只凭一轮推杆瞬态就确定trim方向和数值。

11线编码器在当前A双边沿、减速21.3条件下为468.6计数/轮轴圈，单轮一计数约0.768°。其极低速反馈确实有粒度和无新脉冲的等待时间。v32已用低速周期/高速计数混合测速，不能增加物理分辨率。四轮平均里程有更细的数值步进，但不能把它等同编码器真实精度提高四倍；打滑、间隙和轮胎变形也会影响位置。

本次附件 `C:/Users/14449/.codex/attachments/3d70cad2-01b9-4221-b430-d8cf79276d1c/已粘贴的文本.txt` 为fw36；用户确认推的是摆杆，其余接触情况未补充。起点B偏角+2.021°，自动位置模式P.state5、目标0，P20/上限6，内环8.4/0/0.17、外环0.038/0.0009、X保护200RPM/200ms正确生效。

约运行1.9～2.1秒附近，原始角/角速度开始快速变化；记录从10139ms的-0.615°、均速-7.03RPM，发展到10299ms的-6.943°、均速168.33RPM。10399ms位置环已要求-6RPM回原点，速度斜坡尚+1.64RPM；11199ms斜坡已到-6，滤波速度仍+119.68RPM。外环参考角从约10539ms开始限在+3°，输出多次到0.80；中段一度减速到约41RPM，但未恢复静止，随后再次持续增速。速度积分约-0.013°，没有达到3°积分限幅，不能说是速度积分饱和。

最终明确诊断为 `X,13089,SPEED,8,204.85,200.00,200,200,-14.326,4891,0`：运行4.891秒，峰值204.85RPM，超限连续200ms，原始直立偏差-14.326°，不是30°角度退出。末P位置6.496轮轴圈、目标0，控制明显未跟踪回正。四轮计数/混合测速共同升高，不能把这一整段都归因于11线低速测速粒度；仍需整定速度跟踪和扰动恢复，不仅是换编码器或改静态零点。

## 原地转向指令

烧录正常Keil HEX/AXF，上电摆杆自然下垂且静止发ZERO，标定完成后扶到180°±8°连续400ms，自动倒立并保持进入点。先记录不推杆的零速段，再单独测试一个方向：

| 指令 | 请求 |
| --- | --- |
| `BALSPIN 2` | 记录当前平均里程为转向锚点，右转半轮速差目标2RPM |
| `BALSPIN -2` | 左转，保留原地转向锚点 |
| `BALSPIN 0` | 转向目标归零，继续保持同一平均里程锚点 |
| `BALTURN 0` | 差速目标归零；若处于SPIN也继续保持锚点 |
| `BALSPD 0` | 取消位置/原地转向模式，转为平移零速；转向目标仍按原BALSPD语义保留 |
| `STOP` | 撤驱动并取消全部运动请求 |

BALSPIN参数±10，与BALTURN一样是 `(左平均RPM−右平均RPM)/2`，不是转角、角速度或占空比。正值左轮比右轮快，定义为右转；实际左右与转向效果仍需实车确认。BALSPIN0不是STOP，仍保持倒立。

只在实际ACTIVE且速度外环启用时接受；否则NOT_READY。首次进入SPIN从当前里程建立新锚点，不清原始编码计数，也不改总里程的坐标原点。重复发送正/负/零转速保留同一锚点和原阶段计时，不会让位置目标追随小车漂移。它不继续追旧BALSEQ的一维返程目标；从往返切入时会取消往返并改为当前地点锚点。

P.seq_state新增6=原地转向带平均里程保持（与B.state6不存在对应关系）。位置P20产生前后纠偏请求，限幅最多6RPM；转向PI0.008/0.010负责半轮速差。两者目标绝对值之和继续不超过当前超速阈值一半且平移最多30RPM的既有余量；SPIN会按转向请求缩小前后目标上限。共同角度输出优先、差动最多12%且受80%共同限幅剩余空间约束，目标斜坡和转向反向清积分保留。

普通非零BALTURN仍取消所有位置保持，用于保留旧的手动平移/转向模式；原地需求使用BALSPIN。BALPOS/BALHOLD/BALPZERO仍要求转向请求和斜坡均归零，完成停转后才能修改位置目标。STOP/ARM/ZERO/故障取消SPIN，重新捕捉默认回普通位置保持5，不自动恢复旧转向。

这是平均净里程约束，目的是减少原地旋转时的前后窜动。它不测车体航向或地面二维位置，轮胎打滑/转向侧滑时，平均编码器位移小不等于车身中心完全不移；不保证转90°或锁住绝对地面点。位置/速度环已有漂移仍需要实车调参，新增模式不是已经验证的长期稳定结果。

## 验证与后续

保留所有PID、trim0、80%共同/12%差动、200RPM/200ms、±8°/400ms捕捉、±30°退出和X打印，未基于单次推杆记录盲改零点。CSV_V19/TRACE_V2，旧T/B/V/E/P/Y/H/O/X列数不变，P.state6标识新模式。下一轮需要完整无外力零速段、单独BALSPIN2的T/P/Y/H/O日志及实物是否转向；若先出现持续加速，日志可用来先整定平移，不能仅看转向指令OK判断已原地转成功。

主机回归验证SPIN同时允许位置回正与非零差速、锚点记录/重复/中立不重置、反向积分清除及斜坡、目标总余量、正反位置纠偏、非法命令原子拒绝、手动/往返切换、STOP/传感器/配置/原时限退出和计时回绕。旧控制/位置/转向/退出、生产命令与日志回归通过，ARMCC5全40源警告视错编译成功；没有新增RAM、任务或堆分配。v36备份before_spin_hold_v37，构建日志build_spin_hold_v37.log。
