lingkonglengfeng/nanhua-pendulum-car/f103_bringup/docs/原地转向前后测速均值修正.md

# 原地转向前后测速均值修正

2026-10-18，固件 `0x103C8038`。用户报告原地转向时仍到处跑，并确认全程落地、松杆、没有接触/过坎/碰撞。检查发现SPIN仍沿用直行的四路排序中间两项均值，与四轮平均里程的位置反馈权重不一致。本版仅修正SPIN的平移测速为四轮算术平均，保留其它PID与阈值作对照；未自动烧录或实车验证。

## 日志依据

附件 `C:/Users/14449/.codex/attachments/2e5c7a16-cee3-49a5-8fdf-62a759ccab20/已粘贴的文本.txt` 是中间截取片段，没有版本头和命令ACK，但P.seq_state始终6，Y请求/斜坡均10，确实进入了SPIN。完整T1132/P290/Y290/H290/V29/B29/E29行，覆盖约95364～124364ms，共29秒。V反推ACTIVE起点82263ms，P反推SPIN起点86749ms；不能当成含启动静止段或2RPM对照的完整试验。

转向半轮速差实测6.36～16.87RPM，均值10.09，基本围绕目标10；前后计数均速却在-36.45～+58.10RPM之间往复，摆角约-1.318～+1.758°。位置目标0.744圈不变，位置约-0.13～1.90圈，末1.902，偏离锚点约1.158圈，位置环目标多次到±6限幅。没有X退出行，末仍ACTIVE，不是这段发生了保护退出。

H同一四轮快照分别计算均值和中间两项：四轮均值全片段平均约+2.84RPM，中间两项平均约+0.29RPM，平均低估约2.55RPM，差值范围-2.80～+8.37。对应约29秒的净里程差可达1.23轮轴圈量级，足以影响位置反馈。示例H95464四轮[0,5.12,40.82,21.55]，全均值16.8725，中间两项13.335；后者原T末robust_rpm约13.33。前后轮响应不同时，丢最大/最小项不再保留平移与差动分解的正确轮权重。

E首末快照差，按原始编码器顺序：0 IRQ+3610/ok+3606/glitch+1/dup+2；1 +4591/+4581/+1/+9；2 +6975/+3597/+953/+1472；3 +3930/+3174/+255/+246。确认器仍在拦截输入事件，特别原始2，不能据此认定输入已经无噪声；也不能用排序均值掩盖原地转向的合法轮速差。新平均法对单轮通过确认的假计数更敏感，E、H与原计数保护应继续观察。

## 修改

SPIN（P.seq_state6）的平移测速为 `(H0+H1+H2+H3)/4`，与位置累计中每轮1/4的权重一致，再走原100ms外环低通。左右轮纯等速反转的均值为0；叠加共同前后速度时保留这个共同分量。普通HOLD/速度模式的中间两项离群抑制保留，不在本轮同时调整所有测量模式。

沿用既有变量/日志名g_bal_robust_rpm、T.robust_rpm和V.robust_rpm；它们现在需按模式解释：SPIN是四轮均值，其它模式仍排序中间两项。H是各轮混合测速，T.fast/mean仍是旧计数测速，故同一时刻可能略有差异。字段数不变，完整CSV_V20，精简T仍TRACE_V2；版本头为0x103C8038。

原角度8.4/0/0.17、速度0.038/0.0009、位置20/6、转向0.008/0.010、trim0、±8°/400ms自动捕捉保持、±30°退出、80%共同/12%差动、200RPM/200ms超速和X打印都保留。此处有明确软件偏差，不把所有往复都确定归因为单一因素；修正后的实际稳定性仍需继续整定。

## 首轮对照

烧录正常Keil HEX/AXF，下垂静止发ZERO，扶到捕捉窗口进入自动保持。先记录无手推的静止段，再单独发送：

```text
BALSPIN 2
```

数秒后单独发送BALSPIN0，转向斜坡归零并继续守锚点。先验证较小目标；本次附件实际目标是10，已到当前±10范围上端。发送完整T/P/Y/H/O和可能的X，并注明实物是否仍前后来回、左右方向及接触情况。不要把左右/停止命令一次连续粘贴，避免没有独立观察段。

## 验证

生产回归回放非对称轮速[0,0,33.12,14.19]，SPIN前后测速应为11.8275而非旧7.095，反向对称输入符号正确；纯差速[-10,-10,10,10]不产生虚假平移，共同分量[5,5,25,25]恢复15RPM。切回普通模式仍用原中间两项，确认没有全局删掉离群抑制。原SPIN锚点/斜坡/控制、位置、转向PI、退出事件、命令及日志回归通过，ARMCC5全40源警告视错编译成功。没有新增RAM、任务或堆分配。

v37备份before_spin_mean_v38，构建日志build_spin_mean_v38.log。这是代码与测量回归，不是实车已位置收敛或固定中心旋转的证明。
