lingkonglengfeng/nanhua-pendulum-car/f103_bringup/docs/右前轮双向慢衰减60RPM实测.md

# 右前轮双向慢衰减60RPM实测（0x103C8013）

用户已确认右前轮新驱动下OPEN正负10%均能起转且平稳；本次又确认60RPM闭环“看起来平稳”。当前右前轮空载正向60RPM点的实物与日志一致，暂保留Kp=0.001562、Ki=0.01、Kd=0。未验证其它速度、反向闭环、其它轮位的新驱动响应和带载效果。

## 两份相邻日志

- 03:37:36日志保存于 `logs/2026-10-18_033736/raw.txt`，实际发送的是OPEN 3 60，即60%固定输出；目标仍0、mode4、速度环关闭，后段约162RPM。这份不能作为60RPM闭环数据。
- 03:38:09日志保存于 `logs/2026-10-18_033809/`，107条完整D记录、mode2、speed_en=active=1，目标3=60RPM。C/W确认共用基础增益0.001562/0.01/0，individual全0，符合本轮要求。

最后2秒37条记录，D反馈平均60.076RPM，范围59.61～60.43，标准差0.180RPM；同段累计计数平均60.051RPM。原20ms测速F范围57.85～63.09RPM、标准差1.55RPM；新增60ms低通后的平滑程度不能直接等同于机械精度，因此同时核对了累计计数和用户实物观察。

稳态u约0.226～0.227，平均0.22619，标准差0.000392；积分约0.226～0.227，未饱和。最后2秒其它三轮输出、速度均0，计数保持不变。5ms周期、漏周期0、晚唤醒0；M的波形DMA错误/换半区迟到均0，最大ISR1146周期约15.92us。没有为此修改参数默认值或发布新固件，仍为13版。

## 中间掉速的原因

截取起始已经在60RPM附近运行。约471254ms收到STOP、SET 3 60、RUN 1，并于下一组回执确认应用。这几条连续命令清零了积分；471303ms的u降至约0.005，随后速度暂降至19.46RPM，再恢复60RPM。该过程是人为清历史后的恢复，不能作为从静止起转或正常目标阶跃来评价，也不能据此贸然增大Ki。

起始截取中通道0目标0但留有-0.019积分/输出；STOP后已清零，后续段保持0。此历史输出不计为新一轮单轮试验中的持续联动。

今后在同一速度模式下改变目标只发送SET，不重复STOP、PID或RESET；RUN 1虽已实现幂等，变速时通常也无需重复。停止测试时才发送STOP。

## 下一轮建议

发LED 3 5确保PC13观察右前轮。本段reached仍为0，日志不记录LED通道/容差，不能单凭该字段推断速度未达到目标；重新明确LED配置即可。

保持已运行的速度模式，SET 3 100采8～10秒；再SET 3 30采8～10秒；最后STOP。若开始前已停机，则先设置目标100并RUN 1，过程中不再清历史。保存全部行并反馈高/低速实物表现，先验证增益的适用范围，再决定是否调整或推广至其它轮。

## 03:40:45 高低速补充与任务切换

用户已完成100/30RPM试验并确认“两档都平稳”，数据保存在 `logs/2026-10-18_034045/`。最后2秒累计计数平均：60RPM为59.92、100RPM为100.06、30RPM为30.09。对应D反馈范围为59.05～60.34、98.16～101.38、28.97～30.61RPM，平均输出为0.22584、0.37214、0.11677。其它三轮输出0，5ms周期、漏周期0、晚唤醒0，DMA错误/换缓冲区迟到0，最后STOP成功，计数稳定并回到0速。

右前轮空载正向30/60/100RPM跟踪与用户实物反馈一致，保留原基础增益，不为本轮另行改PID。仅完成了这些范围的验证，不代表其余三个轮位和反向闭环、带载测试已完成。用户现转向AS5600角度检查，不继续派发车轮试验；后续见 [AS5600角度串口诊断](AS5600角度串口诊断.md)。
