lingkonglengfeng/nanhua-pendulum-car/f103_bringup/docs/右前轮固定输出对照.md

# 右前轮固定输出对照（固件0x103C8011）

本轮日志来自 `logs/2026-10-18_024342/raw.txt`。W行与回执确认右前轮3已实际使用Kp=0.0008、Ki=0.005、Kd=0。用户无法肉眼确定改善，只感觉指示灯有一点变化。PC13表示当前误差进入±5%，亮灯不能单独证明速度稳定。

降低增益后，末4秒测速范围36.21～101.42RPM、标准差13.57RPM；此前共用增益末4秒为28.48～85.07RPM、标准差10.80RPM。末2秒降增益组均值60.37RPM，但仍为36.21～82.33RPM。不同时间段的波动使本轮不能判定改善；不固化前轮试验增益。

## 下一次采集

先STOP，下载新固件并确认 `g_fw_build=0x103C8011`。逐行发送、等待OK回执：

```text
STOP
LOG 1
OPEN 3 59
```

架空记录5～8秒，然后单独发送 `STOP`。59是59%固定输出，不是目标RPM；取值接近右前轮此前60RPM时约0.59的闭环输出。不要在对照期间发送RUN 1，它会切回闭环。串口115200、8N1，文本发送加行尾，保存全部回执和C/S/W/D行，同时记录轮子是否仍忽快忽慢。

## 预期日志

- 原始单轮测试模式（mode=4），速度使能/active均为0，四轮目标为0；PC13熄灭正常。
- 只有通道3输出；正方向符号为+1，DIR=0、CCR约2123（ARR=3599）。C行记录测试使能、轮号、占空比和方向。
- D行rpm3仍是右前轮映射后的测速；u3、i3属于关闭的PID，保持0不能用于推断电机未输出。实际输出看ccr3/dir3。
- 负输出按AT8236关系换算：DIR=1、PWM=1-|输出|。OPEN同时应用g_mot_sign；并非直接把绝对占空比写入反向PWM。

固定输入时若仍明显波动，应继续区分编码器测量、供电和机械问题；若明显平稳，再针对闭环增益/测速处理调整。此试验尚未进行，不能提前判定原因。

## 02:51:55 实测结果

原始日志与分析结果保存于 `logs/2026-10-18_025155/`。本节更新上一段的待测状态：固定输出试验已完成，实物观察仍待用户确认。

固件0x103C8011；STOP、LOG、OPEN均成功回执。约9秒内179条完整OPEN数据，mode=4、speed_en=active=0，右前轮CCR始终2123、DIR=0，其余三轮CCR为0。5ms采样，无晚唤醒或漏周期；随后STOP成功，输出回到0。

跳过起转1秒后，现有测速均值60.74RPM，范围32.98～92.68RPM，标准差10.26RPM；按累计计数计算该段平均61.17RPM。PID关闭后仍有相近量级的测速波动，不能把现象全部归因于PID增益，也不能由此排除闭环对波动的放大。

使用同一日志的累计计数离线重新计算，100ms测速范围39.69～76.82RPM、标准差7.30RPM；500ms为53.01～67.35RPM、标准差2.55RPM。长窗会平均掉快速变化，不能把更平滑的曲线直接认定为真实转速稳定，不能据此直接将控制滤波改成500ms。

在468.6计数/圈、5ms采样下，每个计数对应约25.61RPM。短采样窗会放大量化影响，但100ms计数窗口仍有明显变化，因此尚不能仅凭量化解释全部波动。仅靠本日志不能区分真实机械转速变化、编码器边沿不均匀或信号计数异常；下一步需要结合固定输出下的实物观察，必要时用示波器/逻辑分析仪或已知正常电机通道做交叉对照。暂不修改PID默认值或固件。

图：`logs/2026-10-18_025155/wheel3_open_response.png`，其中100/500ms曲线仅为离线诊断，不是本次固件新增的控制滤波。

用户随后确认固定输出下轮子“看起来平稳”。下一轮采用0x103C8012有限反馈低通试验，保留原测速并打印F行，见 [前轮测速反馈滤波](前轮测速反馈滤波.md)。

## 实现验证

生产解析器回归覆盖OPEN单轮隔离、退出其它模式、目标清零、正反方向与端点换算、非法参数原子拒绝、STOP退出。原有PIDW、RUN、接收DMA边界和格式回归通过。HELP+GET包1138/2048字节，压力日志包1501/2048字节。

39个源文件构建通过；Keil Rebuild为0 Error、0 Warning。Code33156、RO2592、RW500、ZI17260字节，静态RAM17760字节，ROM36248字节。没有自动烧录或驱动车轮。
