lingkonglengfeng/nanhua-pendulum-car/f103_bringup/docs/外环变化率与电机延迟复核.md

# 外环变化率与电机延迟复核

2026-10-18，固件0x103C8023；未自动烧录，未实车验证。

## 05:56重新校零结果

附件：`C:/Users/14449/.codex/attachments/7d6fa622-b58a-47d3-95fc-50e40bf45d74/已粘贴的文本.txt`。STOP、ZERO均收到OK；200样本标定成功，bottom_raw4053、upright_raw2005，相对前次4044/1996移动9计数约0.791°。角度PID8/0/0.205、输出限幅50%、保护120RPM/4000ms、外环关闭。首末B377664～379364ms覆盖1.7秒，曾经过+0.088°，后段缓慢负向偏至-3.428°，输出+0.500，末条四轮约100～117RPM。重新校零未消除持续加速，不能将零位差当作唯一原因。

此前理想模型用“占空比直接产生加速度”，忽略了电机速度升高时的力矩下降，不能据其通过就认定实车角度环或外环已经设计完成。仍需结合供电、摩擦、机械参数及反馈辨识；现有闭环日志不足以可靠辨识全部参数。

## 软件修改

新增 `BALSLEW deg_s`，允许0.1～10°/s，默认仍1°/s。命令会停止当前运行，需ARM或ZERO。配置使用实际控制dt，NaN/越界Watch修改触发配置退出。STOP/故障/重新捕捉清外环参考与积分；不修改轮位、方向、电机PWM或角度滤波。

外环保持默认关闭，BALVEL语义不变。v22参考角每秒最多变化1°，前几轮日志后段已触及变化率限制；继续只提高外环P会继续受此限制，所以本次将变化率单独开放调参。该限制可能参与了响应偏慢，但日志不足以证明它是唯一原因。

新增V行尾字段 `slew_deg_s`，V列数从13变为14，协议CSV_V9；原B行仍25列，仅ACTIVE打印策略不变：

```text
V,ms,en,rpm,ref_deg,i_deg,kp,ki,limit_deg,guard_rpm,max_rpm,run_ms,max_run_ms,slew_deg_s
```

## 下一轮候选值

先烧录正常Keil路径 `MDK-ARM/f103_bringup/f103_bringup.hex`，再逐行发指令并等OK：

```text
STOP
BALPID 8 0 0.205
BALLIMIT 50
BALSAFE 120 4000
BALVEL 0.035 0 3
BALSLEW 10
ZERO
```

摆杆自然下垂、底盘放平静止完成ZERO，再手扶顶端连续400ms进入。新一轮保留角度PID和保护；速度外环只用P，不先加积分。0.035的单位为°/RPM，参考角限制±3°，变化率10°/s。它是在补充示意模型中选出的试调值，不是实车稳定参数，未写为默认。不得据此再放大输出或保护阈值；若仍持续加速或振荡，应依据V行、角度和实际驱动响应继续排查。

## 检查范围与局限

除既有生产代码回归，增加含速度相关电机响应的示意模型：

```text
rpm_dot = (260*u - rpm) / motor_tau
theta_ddot = 25*theta - BALSIGN*0.0085*rpm_dot
```

其中260、0.0085、25以及0.10/0.18/0.25秒电机时间常数是用于敏感性检查的假设，不是本车实测辨识结果。模型加入20ms编码器低通、10ms角度延迟、10ms角速度低通，并执行生产外环与角度控制模块。初始偏角±0.5°、速度0时，候选参数在这些模型上40秒内收敛，峰值约9.2～9.8RPM；这不预测本车峰值或成功率。相反角度符号测试通过。

控制回归覆盖原默认1°/s、新10°/s实际变化率、NaN和零变化率拒绝、参考限幅/抗积分饱和、外环关闭等价、STOP复位、角度/超速/到时保护。串口验证BALSLEW合法范围、原子拒绝、HELP/schema/GET包大小，遥测验证V14列和完整GET1052/2048字节。默认10Hz极值带宽估算7296字节/秒。

ARMCC5全量40个源文件、警告视为错误构建通过：Code39008、RO3844、RW680、ZI19528；RAM链接占用20208/20480字节，ROM加载42976字节。静态最大栈保留未知路径警告，实车继续看S.stack_free。新HEX/AXF同步正常Keil产物；v22备份在 `MDK-ARM/speed_pid_build/before_velocity_slew_v23/`。
