lingkonglengfeng/nanhua-pendulum-car/f103_bringup/docs/摆杆转轴与重心几何核对.md

# 摆杆转轴与重心几何核对

2026-10-18，按用户指定读取 `D:/blance_car` 的机械模型，未修改或重新生成CAD，也未改变固件参数。

## 已从旧模型确认的结构

读取 `pendulum_v3/parameters.json`、`build_model.py`、原装配说明和预览图，并用本地CadQuery回读 `pendulum_v3/output/assembly.step`：

| 项目 | 模型中的直立装配坐标/长度 |
| --- | --- |
| 横向转轴中心 | Z=320 mm，轴沿Y方向 |
| 原铝管近轴端 | Z=340 mm |
| 原铝管尖端 | Z=600 mm |
| 管本体长度 | 260 mm |
| 轴心到管尖 | 280 mm |
| 轴心到管近轴端的沿杆偏移 | 20 mm |
| 原均匀管本体中心到轴心距离 | 150 mm |

这是通过橙色夹座连接的单轴摆，横轴没有直接穿过长摆杆的端面。模型以直立姿态展示，棒位于轴的上方；绕轴转180°成为自然下垂姿态时，轴在棒上方。两种姿态是同一结构，不应将某个姿态下的“上/下”误当成不同转轴或直接据此翻转控制输出。

## 新铁棒的测量口径

用户粗测约265 mm、直径8 mm，并已明确265 mm指“旋转的那个轴到铁棒末端”，即轴心到棒尖，不是棒本体长度。模型仍是原Ø8×Ø6铝管及旧配重，不能从这些旧CAD质量属性直接读取新实心棒的实际质量，也不能保证新棒插入深度与原模型一致。

按已确认的轴心到棒尖约265 mm，若沿用原夹座并插到底、轴心到近轴端仍为20 mm，则棒本体长度约245 mm，均匀裸棒本体重心距轴约142.5 mm。20 mm仍是模型值，实际插入位置需要实物核准。棒本体长度265 mm对应的另一种估算已不适用。

之前按“轴正好在棒端”的假设给出132.5 mm，只是条件估算；该假设与当前旧夹座模型不符，后续不能沿用。实际应以横轴中心为基准量到棒近端、棒尖，再确定重心。整个转动组件还含夹座、横轴、螺丝、磁铁座及可能保留的配重，整体重心/惯量不等于裸铁棒数值；打印填充率和实物质量需另行确定。

用户补充实际连接件很大一部分中空，认为下垂姿态重心更偏下。此信息应体现在质量分布中：其余部分不变时，近轴连接件质量减小会使整体重心更接近铁棒一侧；不能将CAD外形或实体体积直接按满密度计算该打印件。只有随摆轴转动的零件计入摆组件，固定支撑塔/底板不计入；横轴、夹具、紧固件及可能保留的配重需按实际质量加权。沿杆方向距离取同一坐标，整体重心为 `sum(m_i*r_i)/sum(m_i)`，惯量还需各件自身惯量与平行轴项。裸棒142.5 mm不是已确认的整组件重心。

“偏下”描述自然下垂姿态时的空间位置；将整套旋转180°至直立，同一重心随之转到轴上方。空心连接件改变质量分布，不改变ZERO最低点与顶端相隔180°的定义，也不单独要求反转控制极性。

本次几何核对不构成新PID识别，不修改软件最低点ZERO/顶端相差180°的标定流程。控制方向和参数仍按实物/日志验证，先前建议的外环Ki0.0009回退候选未因读取模型自动写入或发送给硬件。
