lingkonglengfeng/nanhua-pendulum-car/f103_bringup/docs/直立外环单轮测速尖峰处理.md

# 直立外环单轮测速尖峰处理

2026-10-18，固件0x103C8026。已编译和主机验证，未自动烧录、未实车验证。

## 07:15回退记录中的疑点

附件：`C:/Users/14449/.codex/attachments/6e8d0d59-feaa-4ca3-9584-08c6541c8fc1/已粘贴的文本.txt`。本轮回退到外环0.035/0.0005/3°，其余内环8.4/0/0.15、零位4061/2013、trim0、窄捕捉、70%输出、60RPM/8000ms均保持。

392条完整T覆盖1246594～1254574ms，约7.98秒。末速+7.73RPM，最后一秒均速约+9.90RPM，偏角-0.264～0°，后段比Ki0.001的增长振荡小。但约620ms（1247214ms）角度+0.088°、输出-0.038时，四轮算术均速突到-56.59RPM、最大单轮223.73RPM；下一条最大91.64RPM，随后37.54RPM，符合短时单路输入经过低通衰减的可疑形态。

用户确认本次“无接触”，且实物轮速没有那么高、看起来较稳定。此与07:04那次用户确认碰轮/搬动车的319RPM记录不同：此次有理由优先排查测速跳变，但仅靠最大值与算术均值不能确定哪一通道，也不能认定一定是编码器硬件毛刺，采样/计数/干扰等仍待检查。末段速度变正和较低的终值不能直接归因于Ki回退，因为前面异常输入已影响外环状态。

## 外环速度估计修改

原来外环输入是四个有符号逻辑轮速的算术均值，单轮突跳会以1/4幅度进入车速估计，经过100ms滤波和PI改变参考角。直立场景是四轮同向平移，现改为：

```text
sorted = sort(fast_rpm[0..3])
robust_rpm = (sorted[1] + sorted[2]) / 2
outer_rpm = LP100ms(robust_rpm)
```

它剔除最大和最小的各一路，减少单路失真或打滑对车身平移估计的影响。两路或更多异常、正常轮速本来不一致的转向等情况仍可能有偏差；这不是编码器硬件故障的修复，不能以估计看起来平稳就停止检查原始数据。

以下保持：

- 编码器ISR、原始计数、20ms基础低通、轮速PI、轮位映射和符号均不改。
- 超速保护仍取四路原始基础滤波速度的最大绝对值，连续50ms超阈值仍退出；不是拿中值来放宽保护。NaN/无穷大测速仍触发原传感器故障退出。
- 原始轮速不被覆写，T.mean_rpm仍是原算术均值，便于直接观察污染；新增估计量不掩盖原始尖峰。
- 角度PID、外环增益默认值、10ms角速度滤波、BALTRIM、捕捉/退出角度、定时退出与仅ACTIVE打印策略均保持。

计算仍在5ms控制任务，固定4个栈内float做插入排序，无堆分配/阻塞；本周期估计用于下一控制周期，沿用原最多一个正常5ms周期的速度反馈时序。外环关闭时PI状态仍清零，估计值只用于诊断；它本身不会启动电机。

## 新日志

精简协议F103_BAL_TRACE_V2，T从11增加到16列，前11列含义保持不变，尾部新增四轮基础滤波速度和本周期中间两路估计：

```text
T,ms,raw,error_deg,rate_rad_s,u,mean_rpm,ref_deg,guard_rpm,state,reason,fast0,fast1,fast2,fast3,robust_rpm
```

fast0=右后、fast1=右前、fast2=左后、fast3=左前，均为映射后的逻辑有符号RPM。mean_rpm是原四路算术均值，robust_rpm是本次直接估计，V.rpm是其100ms低通后的外环反馈。guard_rpm仍是原始最大单轮绝对RPM。

全量协议CSV_V11，V尾部新增robust_rpm，V由15增16列，原B仍25列。Watch新增g_bal_robust_rpm。需要看原始快速度与估计是否分离、是否只有某一通道反复异常，不将单个原始尖峰当作整车速度。

## 下载后设置

正常Keil下载路径为 `MDK-ARM/f103_bringup/f103_bringup.hex`。复位后RAM参数和标定丢失，逐行发送并等OK：

```text
STOP
BALPID 8.4 0 0.15
BALLIMIT 70
BALSAFE 60 8000
BALWIN 0.5 20 400
BALVEL 0.035 0.0005 3
BALSLEW 10
BALTRACE 1
BALTRIM 0
ZERO
```

杆自然下垂、底盘放平静止完成ZERO，再手扶顶端捕捉。全程不碰轮/搬动车，保留足够无障碍行程，发送新T/V日志。此轮优先定位测速跳变，不同时继续调增益。中间两路估计改变了外环实际输入，旧增益只能作为候选，不能预先保证同样稳摆；原始超速保护仍有效，撤驱动仍滑行。

## 验证与资源

- 生产控制模块：四个通道分别注入+319/-319RPM、另三路0；估计保持0、外环参考与输出不被拉偏。持续原始超速50ms仍退出，短脉冲后重置计时。
- 正负同速DC保留，-21/-19/-20/-1000时估计-20.5、原峰1000；NaN仍退出。旧捕捉、角度/时序/配置/标定故障、trim和抗积分饱和回归通过。
- 串口/RX DMA旧命令回归通过。遥测T16/V16、前11列兼容、四轮列顺序、极值缓冲边界与溢出检测通过。首trace包531/2048字节，50Hz极值估算不超过5900字节/秒；全量GET1067/2048字节，10Hz极值估算7450字节/秒。
- ARMCC5全量40源文件、警告视为错误构建通过：Code39628、RO4144、RW688、ZI19536；RAM链接占用20224/20480字节（含预留堆栈），ROM加载43896字节。模型/主机测试不代表实车成功；继续观察实测周期、日志栈余量和原始四路数据。

正常Keil HEX/AXF与脚本产物一致；v25源码和固件备份在 `MDK-ARM/speed_pid_build/before_robust_speed_v26/`。
