lingkonglengfeng/nanhua-pendulum-car/f103_bringup/docs/直立环调参记录.md

# 直立环实车调参记录

日期：2026-10-18；固件：0x103C8020。参数单位：Kp为归一化输出/rad，Kd为归一化输出/(rad/s)，限幅为归一化驱动比例。日志仅在ACTIVE期间打印，因此末条ACTIVE数据不能证明确切退出原因或运行总时长。

## 已确认的实物条件

小车放在地面，摆杆松手；BALSIGN=-1时，车朝摆杆倾倒方向追赶。最新轮位：0右后、1右前、2左后、3左前。保留现有轮位及方向配置。

## 第一次：05:11

- 来源：`C:/Users/14449/.codex/attachments/8fce75be-d81b-4614-b9e4-1d69ae60296c/已粘贴的文本.txt`。
- Kp=1.2，Ki=0，Kd=0.08，限幅25%。最低点200样本标定成功，bottom_raw=4056，upright_raw=2008。
- 共20条B数据，MCU时间12199～14199ms，覆盖2秒。后段误差从约-2°扩大到-12.920°，末条角速度-0.872rad/s，输出+0.250已限幅。
- 不能据此认定已稳摆。下一次建议P、D加倍，并提高限幅；用户实际采用70%限幅。

## 第二次：05:15

- 来源：`C:/Users/14449/.codex/attachments/bf9f8d7a-239d-44a5-928b-6c66a15c6f61/已粘贴的文本.txt`。
- 回执及B行确认Kp=2.4，Ki=0，Kd=0.16，限幅70%，BALSIGN=-1均已生效。
- 用户重新ZERO，200样本标定成功，bottom_raw=4054，upright_raw=2006；相对上次仅差2计数（约0.176°）。
- 共12条完整B数据，MCU时间230454～231854ms，覆盖1.4秒；记录有缺段，不能把样本覆盖时间当作松手后的准确存活时间。

| MCU时间ms | 直立偏角° | 角速度rad/s | 输出 |
|---|---:|---:|---:|
| 231154 | 2.109 | 0.075 | -0.100 |
| 231454 | 4.834 | 0.210 | -0.236 |
| 231654 | 8.877 | 0.459 | -0.445 |
| 231854 | 16.963 | 0.880 | -0.700 |

- 末条四轮测速约-162.09、-141.37、-167.41、-142.49RPM。四轮已有明显响应；编码器速度本身不能证明车身加速度足够或完全没有打滑。
- AS5600有效，所见通信错误、漏周期和DMA错误为0。用户确认“车朝倒下方向追，但杆一直倒向一边”。本次未建立直立稳定，未观察到反复过冲的证据。
- 当前工作假设：小偏角阶段控制增益仍不足，追赶偏晚；不能仅靠日志排除驱动能力、机械摩擦、地面附着等因素。

## 第二轮后的建议，尚未实测

保持方向、70%限幅、±20°退出保护以及Ki=0，将P、D再次加倍，使小偏角阶段更早给出纠偏输出：

```text
STOP
BALPID 4.8 0 0.32
BALLIMIT 70
ARM
```

逐行发送并确认OK；未重启且标定有效时无需重新ZERO。手扶在顶端附近连续400ms，进入直立后松手并记录完整日志；反馈继续单向倾倒、来回振荡或打滑的实物表现。这组参数只作下一轮试调，尚未写入固件默认值，也没有自动运行电机。

## 第三次：05:17，高频振荡反馈

- 来源：`C:/Users/14449/.codex/attachments/12fce835-a75a-4263-80ce-af604852db0b/已粘贴的文本.txt`。
- 用户实际发送且B行确认：Kp=6，Ki=0，Kd=0.16，限幅100%。尚未验证上节建议的4.8/0/0.32、70%组合。
- 用户明确反馈高频振荡。完整B行12条，MCU时间360419～361718ms，覆盖1.299秒；其中存在缺段。
- 可见角速度多次正负切换，例如-0.537、+0.314、-0.601、+0.303rad/s；偏角仍全部在负侧，后段-6.504、-4.395、-9.580、-7.119、-11.426°。这是振荡叠加单侧偏离，尚未稳住。
- 所记录输出均为正，范围+0.136～+1.000，其中两条满幅；不能说日志已证明电机反复正反换向。100ms采样无法可靠测定高频振荡频率。
- 最低点标定成功，bottom_raw=4053，upright_raw=2005。所见AS5600、DMA及控制漏周期计数没有报错。

下一轮仍建议实测4.8/0/0.32、70%组合：相对本次降低P、增加D，并收回满幅输出。增加D是待实测的阻尼调整，现有角速度滤波与执行机构响应会影响效果，不能保证仅加D即可消除高频振荡。Ki继续为0；保留方向、±20°退出窗口和现有标定。记录是否减轻抖动，以及杆是否仍单侧倒下；固件默认值暂不改动。

## 第四次：05:21，7/0/0.1

- 来源：`C:/Users/14449/.codex/attachments/59fe6b3e-74d5-459c-a99a-d45e8c565020/已粘贴的文本.txt`。
- 实际参数Kp=7、Ki=0、Kd=0.1，限幅100%。标定成功，bottom_raw=4057，upright_raw=2009。
- 用户说明后面失控是把小车提起来了，并反馈“没倒下去，但是一直往一个方向走”。提起时刻不详，不能将日志后半段满幅和偏角增大当作落地自行失稳的证据。
- 前段MCU时间619984～621184ms（1.2秒、13条B），偏角-1.406～0°，RMS约0.629°；所采样输出-0.005～+0.183。该短段显示已有回拉并保持在顶端附近，不代表长期稳定。
- 最初ARM返回NOT_READY，随后ZERO成功并自动进入捕捉，后续B行state=4。该回执不是传感器故障；未标定时应直接ZERO，无须在ZERO前ARM。

## 第五次：05:23:16，7/0/0.3，高频抖动

- 来源：`C:/Users/14449/.codex/attachments/ae14af91-68e9-4405-b5a0-0c1663933e76/已粘贴的文本.txt`。
- 实际Kp=7、Ki=0、Kd=0.3，限幅100%；用户明确反馈高频抖动。
- 共15条完整B，覆盖705799～707998ms。前段可见+1.934、-1.934、+2.109、-2.197°等反复越过顶端；输出约-0.386、+0.393、-0.377、+0.377，已有反复换向证据。
- 该实测不支持继续增加D。当前100ms日志不能可靠测定振荡频率，不能单凭这些样本断言噪声、滤波相位或机构间隙的各自贡献。

## 第六次：05:23:41，7/0/0.2，候选基准

- 来源：`C:/Users/14449/.codex/attachments/e47d812f-9c75-4c36-b7ed-0155e747b994/已粘贴的文本.txt`。
- 实际Kp=7、Ki=0、Kd=0.2，限幅100%；bottom_raw=4059，upright_raw=2011。用户反馈短暂稳定，并确认05:23:47后大幅摆动时也提起了小车；不能将该尾段当作落地自行失稳。
- 前段730249～731849ms（1.6秒、17条B），偏角+0.176～+1.143°，RMS约0.579°；所采样输出-0.168～-0.026，未接近满幅。
- 同期四轮平均反馈由约-2.44RPM增至-16.54RPM。杆维持在顶端附近，同时小车向同一方向漂移，和用户反馈一致。这里只确认短时间角度控制有效，尚无长期原地稳定的证据。
- 当前代码只有角度PD直接输出四轮驱动，没有小车速度归零或位置回中外环。角度暂稳不能保证车速为0；应结合平均轮速反馈及直立平衡点偏差处理持续行驶，不能仅凭漂移给角度环加积分。

最新建议：将7/0/0.2暂记作候选角度环基准，不再沿用第三次之后继续提高D的建议；固件默认值尚未修改。后续落地记录应在提车前先STOP，给出可区分的地面运行结束时间。接入速度外环时必须与现有角度环一起设计，不直接并联四轮速度PI输出，也不把上次悬空数据用于整定。

## 第七次：05:26，来不及手动STOP

实际参数7/0/0.19、100%限幅。用户反馈车跑太快，来不及STOP。日志末段四轮约180～204RPM，偏角约-7°，仍在±20°窗口内；所给记录没有后续STOP发送。此前要求较长落地记录并依赖人工及时STOP不适合当前持续加速的表现，因此暂停该试验方式。

已实现v21试验自动退出：默认任一轮基础滤波绝对RPM连续50ms超过40，或ACTIVE运行达到1500ms，清输出并锁定。新增BALSAFE，不改角度PID默认值。构建及控制/串口/日志/电机DMA回归通过，未自动烧录；退出为滑行且尚无速度外环。后续使用短试验，说明及HEX路径见[直立试验自动退出保护](直立试验自动退出保护.md)。

## 第八次：05:36，放宽保护后仍加速

实际7.05/0/0.205、50%输出限幅，BALSAFE 120 4000收到OK；首末ACTIVE相隔2秒，末条四轮约106～118RPM、偏角-4.131°、输出+0.500。日志没有退出后的状态，不能仅凭最后速度接近120认定退出原因。AS5600在相邻1秒配置帧间恰好成功读取200次，无通信错误，读取仍200Hz。

随后用户要求将角速度滤波改为10ms。v22已实现10ms滤波和默认关闭的零速外环BALVEL，独立保护保留；全量编译、生产控制/串口/日志回归通过，未自动烧录。先单独比较滤波，再手动启用外环，以免混淆效果。具体参数、V行和试验指令见[10ms滤波与直立速度外环](10ms滤波与直立速度外环.md)。

## 第九次：05:50，10ms滤波首轮

- 来源：`C:/Users/14449/.codex/attachments/8de83e67-562e-492e-ac44-4b763f65a581/已粘贴的文本.txt`。固件0x103C8022、CSV_V8，7.05/0/0.205、输出限幅70%、BALSAFE 180 4000，BALVEL 0 0 2关闭外环，回执和B/V行一致。
- 用户确认实物高频抖动减轻，随后补充本次一直在地面上；该尾段可作为落地持续加速的证据。
- 共20条完整B，27759～29759ms覆盖2秒。前段28059～28959ms偏角-0.352～-2.109°，后段到-8.438°、输出+0.700。末条四轮D速度约167.81～179.65RPM，基础滤波最大速度V.guard_rpm=182.52RPM，V.run_ms=2000。
- 末条已超过180RPM阈值，但仍为ACTIVE；仅该100ms采样不能证明内部连续超速50ms已满足，也不能确认最终退出原因。到时阈值4000ms尚未到。需要Watch读reason，不将日志截止直接描述成超速退出。
- 外环关闭时V.rpm/ref/i均为0是实现主动清状态的结果，实际轮速看D/F；不是编码器没有测速。
- 本次bottom_raw=4044、upright_raw=1996；上一轮4058/2010，相差14计数约1.230°。可能与自然下垂、底盘姿态或机械条件有关，不能直接认定传感器漂移；后续在相同平整地面自然下垂静止后标定，不据单次差异硬改零位。

下一轮建议：保留10ms滤波和角度PID7.05/0/0.205，收回输出限幅50%、BALSAFE 120 4000，再单独启用初估外环 `BALVEL 0.008 0.002 2`、ARM。外环尚未实车验证，不保证能消除漂移；不得以初估外环代替自动退出保护。若已重启/移动底盘重新标定，用ZERO替代ARM，ZERO只需一次。观察V.en=1、均速和ref_deg，及小车是否仍持续加速。

## 第十次：05:52，外环启用但未建立稳定

- 来源：`C:/Users/14449/.codex/attachments/624d9bc8-b852-4b97-b4e2-a6cabf0e1247/已粘贴的文本.txt`。实际角度7.05/0/0.205、限幅50%、BALSAFE 120 4000、BALVEL 0.008 0.002 2，回执和B/V行确认。沿用同一标定4044/1996。
- 用户确认持续加速并自动撤掉驱动；最后B仍是ACTIVE，退出reason没有记录，因此不能仅凭附件确认超速原因码，但时间上尚未达到4秒。
- 首B123234ms，末B124234ms，覆盖1秒。V.en=1，滤波均速从13.41升至99.37RPM，参考偏置从+0.110升至+0.817°，积分+0.003升至+0.082°。
- 同时实际角度误差从-1.055扩大到-3.252°，末条角度相对参考误差约-4.069°，输出+0.500饱和。外环有执行，但未使摆杆向目标角收敛，也未观察到速度回落。
- 外环目标角后段每100ms增加0.1°，已受1°/s变化率限制，继续只增大BALVEL的P不一定能加快参考变化。不能从“输出仍为正”直接认定外环极性错误，倒立摆的零速控制有先改变杆倾斜的暂态；也不能把本次和上次不同释放初态的加速时间直接用作参数优劣证据。
- 修正调试判断：此前“短暂角度接近顶端”不足以证明内环已稳定。外环整定提前，应先回到角度环，确认能出现持续拉回而非角度与速度单向增长。

下一轮只作单变量小步试调：外环关闭，角度P从7.05增至8（约+13.5%），D保持0.205、I=0、滤波10ms、输出限幅50%、保护120RPM/4000ms均不变。指令如下；未实测、未固化到默认值：

```text
STOP
BALVEL 0 0 2
BALPID 8 0 0.205
BALLIMIT 50
BALSAFE 120 4000
ARM
```

观察是否能向顶端拉回或出现来回振荡；若仍在小偏角单向加速后饱和，不继续扩大输出/保护阈值，应转向在地面负载下辨识驱动响应和内环控制结构，而非不断加大外环增益。

## 第十一次：05:53，提高输出上限仍持续加速

- 来源：`C:/Users/14449/.codex/attachments/626dd322-3a27-4f86-8649-156200b7e7d7/已粘贴的文本.txt`。实际仍为7.05/0/0.205、外环0.008/0.002/2°，输出限幅提高至78%、BALSAFE提高至180RPM/4000ms；回执和B/V行一致。前述关闭外环、P=8的单变量试验尚未收到实测。
- 首B216844ms，末B218544ms，覆盖1.7秒；实际末段是否提车本次没有额外确认。
- 末条滤波均速159.49RPM，基础滤波单轮最大189.31RPM，目标角+1.360°，实际偏角-4.834°，输出+0.780已限幅。相对目标角误差约-6.194°，摆杆未向外环要求的正偏角收敛。目标角后段仍受1°/s限速。
- 加大可用输出没有建立稳定，不能继续将问题单独归结为50%限幅。最大单轮已超过180但末B仍ACTIVE，50ms连续条件和最终退出原因仍须Watch确认；本次没有达到4秒时限的证据。
- 保留上一轮的待测建议：关闭外环，角度P=8、D=0.205、I=0，限幅50%、BALSAFE120/4000。该试验仅为辨别内环拉回能力，尚未验证；不据本次提高固件默认输出或保护阈值。

## 第十二次：05:54，外环关闭、P=8

- 来源：`C:/Users/14449/.codex/attachments/634298be-0749-4e7d-b81e-a8c3286eaafd/已粘贴的文本.txt`。确认角度PID8/0/0.205、外环关闭、输出限幅50%、BALSAFE120/4000已生效，仍沿用bottom_raw4044、upright_raw1996。
- 首B256604ms、末B258004ms，覆盖1.4秒；由初始+0.615°到末条-3.691°，200ms时曾到-0.088°。随后角度缓慢向负侧偏离，轮速持续上升，末条四轮约110～126RPM，输出+0.500限幅。不能把短暂接近0°描述为已建立长期稳定。
- 用户先选择“摆杆也逐渐倒向一边”，随后主动更正：“肉眼可见基本直立说错了，有一点斜而已”。以更正为准：略有倾斜并持续加速，不是明显大幅倾倒。末条小偏角与这一观察一致；最终退出原因未在本附件中记录。
- 增大角度P未消除漂移。现有标定与05:36的4058/2010差14计数约1.23°，需在相同平整地面、底盘静止、摆杆自然下垂后重新ZERO复核；该差异仅提示需核验，不能据此认定零位有误或是唯一原因。

下一步不改增益或保护阈值，先STOP、自然下垂静止、ZERO，底盘保持同一位置和姿态，再手扶顶端捕捉并提交日志。重新标定后的原始底/顶计数、偏角和加速方向将用于区分重复的零点偏差与内环/执行机构及外环问题。当前没有为本轮修改固件或自动驱动。

## 第十三次：05:56，重新ZERO仍加速

STOP/ZERO成功；200样本bottom_raw4053、upright_raw2005，比4044/1996变化9计数约0.791°。参数仍8/0/0.205、限幅50%、120RPM/4000ms、外环关闭；记录覆盖1.7秒，末偏角-3.428°、输出+0.500、四轮约100～117RPM。重新校零未消除现象，不能再单独归因于零位差。

改为复核电机速度相关响应及外环速率约束，不继续只提高角度P。v23新增BALSLEW可调变化率、CSV_V9的V14列，外环默认仍关闭；补充含电机延迟和测量滤波的示意模型。控制/串口/遥测回归及ARMCC5全量构建通过，未自动烧录、没有实车稳定结论。下一轮初估外环0.035/0/3°、变化率10°/s，保留内环8/0/0.205、输出50%、120RPM/4秒保护。细节见[外环变化率与电机延迟复核](外环变化率与电机延迟复核.md)。

## 06:00～06:03后续：撞桌、高频抖动与较长保持

06:00新外环试验用户明确碰撞桌子，不知道碰撞时刻，不能当作保护正常停机或稳定记录。06:02将输出改70%、180RPM保护，用户确认全程松手无碰撞/提车，杆中段偏角较小但车反向加速至约182RPM，仍未稳速。06:03用户把角度P改8.8，其余同上，完整记录3.9秒、偏角采样-2.55～+1.58°、最大单轮约115RPM，仍存在抖动及约-8～-58RPM滤波均速，末条接近4秒时限，需Watch确认是否reason9。

不再继续盲目放大增益。v24仅补上50Hz精简诊断BALTRACE，控制保持v23原样，编译/生产串口及格式回归通过，未自动烧录。详细事实、数据限制与字段见[直立环50Hz精简日志](直立环50Hz精简日志.md)。

## 06:08，首份50Hz诊断

来源：`C:/Users/14449/.codex/attachments/8f043c64-a9c8-4c2b-b4be-788fef956bf4/已粘贴的文本.txt`。固件0x103C8024，8.8/0/0.205、70%限幅、180RPM/4000ms、外环0.035/0/3°、10°/s。200样本ZERO成功，bottom4076、upright2028；本次是否全程无接触未额外确认。

- 重建串口助手拆分帧后，102条完整T覆盖11059～13139ms，共2.08秒。首包与1秒配置包附近存在40ms间隔，其余多数20ms；分析使用真实ms。
- 摆角采样范围-1.934～+2.197°。正峰时间11419、11639、11879、12119、12359、12579、12839、13059ms，峰间隔220/240/240/240/220/260/220ms，约4.3Hz，不能将该频率等同于PWM开关频率。
- 12/102条采样输出达到70%限幅。均速最高+40.30、最低-172.16RPM，最大单轮185.53RPM。外环参考由正转负，约12199ms后多次顶到-3°。偏角仍只有数度，却有持续振荡并反向漂移。
- 本次末T仍ACTIVE、reason0，最大单轮已经超180RPM，但日志缺少最终退出码；不能仅据截止认定超速退出。由连续采样的上下波动可见，瞬间越限不必然满足连续50ms条件。
- 不能根据这一份闭环日志唯一确定电机惯性、机械间隙、测量延迟或D项各自作用，也不能仅凭参考角与输出同向判断外环极性错误。

下一轮作为单一控制增益试调：角度P保留8.8、I=0，D从0.205降至0.15；外环0.035/0/3°、变化率10°/s及70%输出保持。因已有碰撞史，保护收回120RPM/1500ms（不是控制增益变化），记录约6个4.3Hz周期，保留BALTRACE1；不烧录、不固化默认值。依据先前D0.3抖动较明显的实测选择向下试探，但这不是已证实的阻尼修复，若振荡加重需撤回。不要同时再改P、外环或提高输出限制。

## 06:10，D=0.15抖动减轻，仍漂移

来源：`C:/Users/14449/.codex/attachments/49a9a197-b8da-47b7-b882-7345a5f26244/已粘贴的文本.txt`。固件v24，8.8/0/0.15、70%限幅、120RPM/1500ms，外环仍0.035/0/3°、10°/s，沿用bottom4076/upright2028。用户肯定本次抖动减轻，确认全程松开摆杆，车移动方向与摆杆摆动方向一致。

- 73条完整T覆盖133654～135134ms，1.48秒。串口助手末段接收延迟约2秒，但MCU时间戳仍基本每20ms，不能将PC接收延迟描述成控制暂停。
- 全段偏角-0.703～+0.791°，相对上次-1.934～+2.197°收窄，4.3Hz持续往复在本轮短窗内明显减弱。
- 以各次进入ACTIVE后400～1400ms比较，偏角标准差约1.112→0.310°，角速度RMS约0.494→0.049rad/s。初始偏角分别约-1.846与-0.615°且保护窗口不同，不能将全部改善精确归因于D，更不能据此保证任意释放条件下稳定。
- 末T平均轮速-91.33RPM、最大单轮92.94RPM，参考角-3°，输出-0.368，角度-0.615°。未顶70%输出，但仍反向漂移，尚未达到零速稳定。
- 末时长1480ms接近1500ms保护阈值，最后T仍ACTIVE，退出原因未记录。不能直接认定reason9，需Watch确认。

下一轮保留角度环8.8/0/0.15作为候选，外环积分仍0，角度偏置限幅3°、变化率10°/s、70%输出及120RPM/1500ms保护不变。仅将外环P从0.035降至0.030（约-14.3%），观察漂移和目标角是否减少；这是待实测的小步试调，不是已证实的极性或模型修复。STOP、BALVEL 0.030 0 3、ARM，无需重复ZERO、烧录或延长保护。若漂移减轻但摆角变差，应据下一轮T数据重新权衡，不能只以较低车速判定控制成功。

## 06:12～06:14，外环0.030与捕捉初态

06:12日志直接粘贴在对话中：8.8/0/0.15，外环0.030/0/3°、10°/s，70%输出、120RPM/1500ms、零位4076/2028。进入时+0.439°，约1秒前较平缓；约1.14秒偏角+1.934°、1.18秒平均轮速-130.33RPM、最大单轮148.39RPM。用户记不清松手时机，因此不能将约1.1秒的突变直接归于外环增益，也不能假定一定是那时松手。没有证明0.030优于0.035，不根据该不确定记录继续调增益。

06:14用户再次直接粘贴同参数试验，并明确“这是立马松开”：初始322449ms偏角-2.549°、角速度-0.050rad/s，输出+0.399；60ms后322509ms平均轮速+60.63RPM，随后摆角过冲到+3.340°（322629ms）。末T323409ms即960ms，偏角+2.197°、输出-0.674、均速-141.34RPM、最大单轮170.14RPM。仅该尾段不能证明确切退出原因。

这份明确显示±5°捕捉窗口允许在较大初始偏角进入，初始P项约39.15%、加D项后约39.9%，与日志一致；不能归咎于“松手太晚”。起步角不同会混淆增益比较。

下一步只统一捕捉条件，不据这两份改变增益：STOP、BALWIN 0.5 20 400、ARM。保持当前角度8.8/0/0.15、外环0.030/0/3°、变化率10°/s及全部输出/退出保护。入口改为180°±0.5°连续400ms，原始角度退出仍±20°。±0.5°时仅P项不超过约7.68%，D项仍依实际角速度计算，所以不能承诺总输出一定低于8%。这一步针对初始冲击，不保证消除后续振荡。无需重新烧录或ZERO，保留50Hz日志与相同零位，下一次记录开始即松手。

## 06:16，收窄捕捉后的首次记录

附件：`C:/Users/14449/.codex/attachments/decc9ab8-7e20-4c22-af82-a9afcafc9d17/已粘贴的文本.txt`。本次用户又发送ZERO，成功200样本，bottom4047/upright1999，比前次4076/2028变化29计数约2.549°。记录确认入口0.50°、出口20°、保持400ms，内环8.8/0/0.15、外环0.030/0/3°、10°/s、70%输出、120RPM/1500ms均保持。

首B/T486899ms，角度0.000°、角速度0.082rad/s、输出-0.012。对比06:14起步-2.549°与+0.399，明显减少了起步脉冲；但同时重新标定和初始姿态均有变化，不能把全部后续差异单独归于捕捉窗口。

最初约400ms，单轮最高不到14RPM，部分时段速度接近0；随后从约0.5秒开始向正方向加速。1秒时V均速29.71RPM、参考+0.891°，T实际均速36.32RPM、角度-0.352°、输出+0.191。末T488379ms即1.48秒，角度-1.230°、角速度-0.464rad/s、输出+0.522、实际均速72.69RPM、参考+1.714°、最大单轮76.26RPM。仍未稳速，末T仍ACTIVE，不能仅凭接近1500ms推断最终退出原因。

下一步保留最新零位1999、入口±0.5°、内环8.8/0/0.15、70%输出与120RPM/1500ms保护；仅关闭速度外环，STOP、BALVEL 0 0 3、ARM。此组合（10ms滤波、D0.15、窄入口、同一零位）此前没有外环开关直接对照，不再同时改增益或反复ZERO。该对照用于区分外环参考变化与内环/负载漂移，不能预先认定外环极性错误或关闭即可稳定。

## 06:18，外环关闭，零位再次变化

附件：`C:/Users/14449/.codex/attachments/11617e85-4366-415b-93fe-870a762e1b61/已粘贴的文本.txt`。本次仍发送ZERO，成功200样本，bottom4061/upright2013，比上一轮4047/1999变化14计数约1.230°；入口±0.5°、角度PID8.8/0/0.15、70%输出、120RPM/1500ms均保持。V.en=0，参考偏置0，确认外环关闭。

73条完整T覆盖614644～616124ms，共1.48秒。首角度+0.264°、输出-0.052；末角度+1.318°、角速度+0.052rad/s、输出-0.210、平均轮速-39.81RPM、最大单轮43.68RPM。小幅抖动较前期4.3Hz试验明显小，但角度缓慢正向偏离且车仍反向漂移，未建立零速稳定。最后仍ACTIVE，退出原因未记录。

相对06:16外环开启时末均速+72.69RPM，关闭后本次漂移较慢但方向也改变；零位同时相差1.23°且初始状态不同，不满足只切外环的严格对照，不能将差异全部归因于外环增益/极性。探索性拟合轮速/输出与摆角模型的拟合质量不足，不据此认定真实电机参数或给出新的已验证增益。

当前先保持增益与保护，核实ZERO时是否完全松手自然下垂、底盘是否同一平整位置；后续沿用同一零位并通过ARM重复试验，减少零位变化对小偏角实验的干扰。不自动运行电机。

用户随后确认ZERO时完全松手自然下垂，底盘在同一块平整地面。因此标定操作符合既定流程，不能归咎于用户扶杆或换地面。历史重复零位存在约1°以上变化，具体是轴系静摩擦、导线偏置、磁铁/支架相对位移或传感器读数变化，尚无证据区分。下一步先STOP、不驱动电机，摆杆从左右两侧轻拨后自然静止，用Watch记录g_as5600_raw_angle，复核最低点重复性；不通过不断改PID来掩盖这个未明的重复性问题。

## 06:25～06:27，复位后重建参数及3秒记录

用户提供最低点静止raw四值0x0FDD/0x0FDF/0x0FDE/0x0FDE，即4061/4063/4062/4062，极差2计数约0.176°，短期重复性良好，不据历史ZERO差异认定机械故障。后续ARM返回NOT_READY且命令编号重回1，提示可能复位、RAM标定/调参丢失；因此重新设置内环8.8/0/0.15、70%输出、120RPM/1500ms、外环关闭、入口0.5°/出口20°/400ms、BALTRACE1并ZERO。B确认新底/顶4063/2015；此后不用反复ZERO。

06:26的末T约运行1480ms，偏角+1.230°、均速-39.17RPM、最大单轮41.31RPM；用户反馈“还在平衡就退出”，推测接近1500ms定时条件，需Watch确认reason9。不能将短时小角度描述为稳态稳定。

附件 `C:/Users/14449/.codex/attachments/4b42fb25-df83-4291-98f7-f4b6f2c7e13b/已粘贴的文本.txt` 前半为上述旧数据，后半是新增06:27试验：STOP、BALSAFE 120 3000、ARM收到OK，同一零位4063/2015；其余控制参数不变，外环仍关闭、BALSLEW复位默认1但外环关闭时不参与输出。

- 新试验293849ms初角0°、输出-0.002。附件约开始100ms后至1160ms之间缺段，不能按PC接收延迟认定控制停顿。
- 295009ms（1160ms）偏角+1.230°、均速-37.97RPM；295849ms（2000ms）偏角+3.428°、输出-0.555、均速-125.15RPM、最大单轮130.54RPM。未达到70%输出限幅，但角度与车速继续偏离。
- 最后时长2000ms尚未达到3000ms，不支持“3秒定时结束”的解释；末几条单轮超120RPM，更像超速退出，但末T仍ACTIVE，需Watch确认reason8。20ms采样不能证明中间每个5ms样本均持续超限，因此不据连续几条T超限就认定50ms保护实现错误。

下一轮保留当前同一零位2015、内环8.8/0/0.15、70%输出、120RPM/3000ms及窄捕捉窗口，仅启用外环0.030/0/3°，显式BALSLEW10恢复变化率，再ARM。不要ZERO或同时加P；这是同一标定与相近释放初态的外环开关对照，尚未验证，不表示预先确认能稳住。如果启用后加速更快或振荡加重，应关闭外环并据新日志复核增益与控制结构，不再提高输出/速度上限。

## 06:29，同零位开启外环后短时角度显著改善

附件：`C:/Users/14449/.codex/attachments/be30fa29-5773-448f-b8e9-862d3ea9becb/已粘贴的文本.txt`。前一组ARM后未见ACTIVE日志，随后用户再次STOP/BALVEL0.030/0/3、BALSLEW10、ARM。本段进入时零位仍4063/2015，角度+0.176°、输出-0.041，内环8.8/0/0.15、70%输出、入口±0.5°/400ms、120RPM/3000ms保护均确认。

相同零位下，运行2秒的外环开启记录：偏角+0.088°、均速-25.41RPM、参考-0.727°、输出-0.125；对照外环关闭的2秒记录：偏角+3.428°、均速-125.15RPM、输出-0.555。初始释放角度/角速度仍非完全相同，不做精确因果量化，但这轮确有短时角度改善和更慢的速度漂移。

末T410569ms，进入407589ms，覆盖2.98秒。末偏角+0.088°、均速-46.05RPM；后段角度多在顶端附近，没有之前4.3Hz大幅周期摆动的形态，但均速仍缓慢向负侧增长，未实现零速稳态。最后仍ACTIVE，接近3秒时限，不能仅凭日志结束确认reason9。约460ms时单轮峰值76.32RPM而其它速度较低，不能将孤立测速尖峰当作稳定运行速度或判定传感器坏。

下一轮只加入小外环积分：从BALVEL 0.030 0 3改为BALVEL 0.030 0.001 3。内环、外环P、偏置限幅3°、变化率10°/s、70%输出、120RPM/3000ms保护均不变；STOP、BALVEL0.030/0.001/3、ARM。积分单位°/(RPM·s)，初估值尚未验证，应同时看V.i_deg/T参考角和车速趋势，不能把积分改变后短时角度小直接描述成零速稳定。不重新ZERO、不烧录、不增加输出/保护阈值；如加速或摆动明显恶化，撤回Ki=0。

## 06:37，外环Ki=0.001末段再现增长振荡

附件：`C:/Users/14449/.codex/attachments/4282fd60-293c-4e91-a65b-901f4f149c63/已粘贴的文本.txt`。STOP/BALVEL0.030/0.001/3、ARM收到OK。所见B确认内环8.8/0/0.15、70%限幅、窄窗口0.5°/20°/400ms及零位4063/2015，V确认120RPM/3000ms、参考变化率10°/s。用户反馈前段还行、末段抖动。

开头协议头和首B/V缺失，由871954ms的V.run_ms2000推算进入约869954ms。2秒时角度+0.176°、均速-32.80RPM、外环滤波均速-31.30RPM、参考-0.968°，其中积分仅-0.029°。其幅度远未到3°限幅，且折算角度P输出仅约0.0045，因此不能未经证据就称为积分饱和/严重积累，不能断言末段振荡唯一由小积分引起。

约2.28秒后角度往复逐步增大，后段正峰约872414、872654、872914ms，峰间240/260ms，约4Hz；872754～872794ms负峰-1.758°，末段正峰+2.461°。末T872934ms约运行2980ms，角度+2.373°、角速度-0.068rad/s、输出-0.612、均速-119.49RPM、最大单轮139.76RPM、参考-1.676°，尚未到参考限幅。末T仍ACTIVE，不能仅凭结束确定超速或到时原因。

该轮小积分没有确认的稳速收益，撤回Ki=0，以最近无积分组合为比较基准。下一轮仅相对该基准将角度P从8.8降到8.4（约-4.5%），D仍0.15、I_angle=0，外环P0.030、I_velocity=0、偏置3°、10°/s、70%输出和120RPM/3000ms保护均保持；STOP、BALVEL0.030/0/3、BALPID8.4/0/0.15、ARM。不重新ZERO，不延长试验，尚未实测或固化默认值。观察后段振荡是否减弱，同时确认角度不因降P而更快单向偏离，不能只根据振幅小就判定稳住。

## 06:40，角度P=8.4，末段振荡减轻但仍缓慢行驶

用户直接粘贴日志，STOP、BALVEL0.030/0/3、BALPID8.4/0/0.15、ARM收到OK。B确认内环8.4/0/0.15、70%限幅、入口0.5°/出口20°/400ms、同一零位4063/2015；V确认外环0.030/0/3°、10°/s、120RPM/3000ms。

开头、若干中段T及尾部一段存在缺失，不能据PC接收间隔断言控制暂停。所见后半段偏角约0～+0.264°，没有上一轮Ki0.001末段的明显增长振荡。2秒时偏角+0.176°、输出-0.162、均速-33.26RPM、参考-0.926°；末T1059909ms约运行2980ms，偏角+0.088°、输出-0.219、均速-46.21RPM、参考-1.360°、最大单轮48.66RPM。用户反馈“一直稳定但是缓慢向前”。可以把8.4/0/0.15保留为当前候选角度环，但记录仅约3秒且有缺段，不称为长期稳摆或零速稳定。

下一轮保留内环、当前零位、窄捕捉与全部输出/退出保护，只将外环P0.030降至0.025（约-16.7%）、I_velocity仍0、偏置3°、变化率10°/s保持。STOP、BALVEL0.025/0/3、ARM，不ZERO、不烧录；这仍是待实测的小步试调，不保证降低P一定消除漂移。同时评估车速趋势和角度误差，若速度降低但角度开始持续偏离，也不能判定改善；不通过扩大时限/保护上限掩盖加速。

## 06:43，外环P=0.025未显示漂移改善

附件：`C:/Users/14449/.codex/attachments/ac66869a-b2c5-42d7-82f1-d3492668aef0/已粘贴的文本.txt`。STOP/BALVEL0.025/0/3、ARM均OK；B/V确认同一零位4063/2015、内环8.4/0/0.15、70%限幅、0.5°/20°/400ms、120RPM/3000ms、参考变化率10°/s。进入1212244ms时角度0°、输出0。日志有缺帧和拼接残片，只使用完整帧，不把PC接收时间间隙当控制间隔。

1秒1213244ms偏角+0.352°、输出-0.110、均速-18.72RPM、滤波外环均速-16.06RPM、参考-0.401°。后段大多数偏角约+0.18～+0.44°，仍无之前的大幅4Hz摆动，但平均轮速继续向负侧增长：约2秒均速约-37RPM，2.88秒1215124ms均速-63.74RPM，末T1215224ms即2980ms均速-55.20RPM、角度0°、参考-1.477°、输出-0.219。末段最大单轮约67RPM，未接近120阈值；记录接近3秒时限，但最终退出原因仍未直接记录。

本次不支持“降低外环P即可减轻漂移”的试调方向：上一轮P0.030的3秒末约-46RPM，本次后段约-55～-64RPM。初始释放状态并非完全相同，不能据单次比较精确量化因果；但没有改善证据，不继续往更小P试探。

下一轮保持候选角度环8.4/0/0.15、外环I=0、偏置3°、变化率10°/s、70%输出、120RPM/3000ms及同零位与窄捕捉，只试外环P0.032（比先前0.030高约6.7%，不直接跳回0.035）。STOP、BALVEL0.032/0/3、ARM，不ZERO、不烧录。重点观察是否开始减小均速增长且摆角仍小；参数尚未验证、不固化默认值。

## 06:44，外环P=0.032，角度小但未稳速

附件：`C:/Users/14449/.codex/attachments/750e7039-4f1e-448d-a31d-b3e038c3cc4c/已粘贴的文本.txt`。STOP/BALVEL0.032/0/3、ARM均OK；B/V确认零位4063/2015、内环8.4/0/0.15、70%限幅、入口0.5°/20°/400ms、120RPM/3000ms和10°/s变化率。进入1290159ms时角度-0.176°、角速度0.001rad/s、输出+0.026。早段约100～820ms缺失，不按接收时间插值补造数据。

2秒1292159ms偏角+0.088°、输出-0.178、均速-38.26RPM，外环滤波均速-35.17RPM、参考-1.126°。末T1293139ms即2980ms，偏角0°、角速度0.045rad/s、输出-0.235、均速-50.77RPM、参考-1.554°、最大单轮51.96RPM。所见后段角度在顶端附近、未出现此前4Hz增长振荡形态，但车速仍向负侧增加，未实现零速稳定。

相对P0.030末速约-46RPM，两轮差异小、释放初态略有不同，不足以可靠排序0.030和0.032；不能宣称0.032已改善稳速。P0.025末段约-55～-64RPM也没有改善。下一轮不加I，在当前内环8.4/0/0.15、窄捕捉和同一零位条件下只试P0.035、I0、偏置3°；STOP、BALVEL0.035/0/3、ARM，不ZERO、不增限幅或时限。先前0.035试验的内环/捕捉初态不同，不能直接将其结果等同于本次组合。此为待实测的增益范围探索，不是已证实的极性/平衡点修复；应观察车速增长是否减慢或反转，并注意角度振荡是否再现。

## 06:46，外环P=0.035，漂移减慢但尚未稳速

附件：`C:/Users/14449/.codex/attachments/50126dbc-d32e-4706-9002-e7e422481719/已粘贴的文本.txt`。本次仅STOP/BALVEL0.035/0/3、ARM，收到OK。头部首B/V缺失，不能从本附件单独再次核验全部沿用参数；所见V残行确认外环0.035/0/3°、120RPM/3000ms、10°/s。此前同一标定2015、内环8.4/0/0.15与窄捕捉沿用，没有ZERO/改内环命令。

由1432639ms的run_ms2000推算进入1430639ms。该时刻T偏角0°、均速-19.49RPM、参考-0.683°、输出-0.090；末T1433619ms即约2980ms偏角0°、角速度0.003rad/s、输出-0.140、均速-29.36RPM、参考-0.953°、最大单轮31.24RPM。可见后段多数偏角0°或±0.088°，未见此前增长振荡形态。头部及中间有缺帧，不能据此保证全程极值或准确松手时刻。

末速度约-29RPM较0.032时约-51RPM更低，当前试验提示向上调整有改善，但释放初态不完全相同，不做精确因果量化。后段均速仍从约-19增至-29RPM，不能称为零速稳定或速度已回落。

下一轮仅试外环P0.038、Ki0、偏置3°；内环8.4/0/0.15、10°/s、70%输出、120RPM/3000ms、窄捕捉及零位均保持。STOP、BALVEL0.038/0/3、ARM，不ZERO，不烧录，不加积分或扩大保护。若均速增长停止同时角度仍小，再确认重复性；若振荡再现或漂移更快，撤回0.035，不将单纯增P视为必然改善。

## 06:48～06:50，0.038振荡、0.035恢复小幅摆角

0.038同零位试验后段出现周期振荡，用户明确确认“抖动了”，角度约-1.67～+1.58°，不能作为稳速改善。退回0.035，06:50复测记录2.98秒、末均速-31.66RPM、最大单轮33.11RPM，后段多数角度0或±0.088°；与之前0.035约-29RPM接近。保留8.4/0/0.15和外环0.035/0/3°为短时角度控制候选，速度仍漂移，未达到原地稳定。

不继续加外环P。v25新增默认0°的独立BALTRIM平衡点偏置，用于检验小参考角偏差的影响，不声称已确定漂移根因。范围±1°，修改停止；原AS5600零位和所有保护不变。首次候选+0.10°，其余控制候选保持；需要烧录，尚未自动烧录或实车验证。控制、串口、日志回归及ARMCC5全量构建通过，T仍11列、V增至15列。完整恢复/试调指令见[直立平衡点微调](直立平衡点微调.md)。

## 06:55，BALTRIM+0.10°首次实测

附件：`C:/Users/14449/.codex/attachments/e8be3f66-afd5-49a7-a81c-c7e13a2d1519/已粘贴的文本.txt`。固件v25，完整恢复指令均OK；B/V确认内环8.4/0/0.15、外环0.035/0/3°、10°/s、70%输出、120RPM/3000ms、入口±0.5°和trim+0.100°。烧录后必须重做ZERO，本次bottom4061/upright2013，相对旧底/顶4063/2015变化-2计数约-0.176°。

首T36039ms，角度+0.264°、输出-0.025；末T39019ms，覆盖2.98秒，角度+0.088°、角速度0.020rad/s、输出-0.159、平均轮速-32.86RPM、外环参考-1.077°、最大单轮35.17RPM。后段多数摆角0或+0.088°，没有此前增长振荡形态；约1.6～2.4秒均速曾在约-25～-29RPM附近，后段仍缓慢向负侧增长。

用户反馈“直立了但是缓慢运动，效果好挺多”，认可实物感受并记录。数值上末均速与v24最后复测的-31.66RPM接近，不能声称漂移已显著减少；还同时重做了标定，所以不能把全部改善单独归因于trim。按原始轴坐标计算，本次几何顶端2013+0.1°对应约2014.138计数，旧无trim顶端2015；净物理参考差约-0.076°，并非单独+0.10°，因此后续应固定这次零位，不继续ZERO。

下一轮只将trim+0.10改为+0.15°（增量+0.05°），其余控制参数、零位与保护保持，STOP、BALTRIM0.15、ARM；无需烧录或ZERO。检查均速及末段趋势是否降低、摆角是否仍小，参数尚未验证。若漂移/抖动加重，应停机撤回+0.10°，不能仅因杆直立就判定原地稳定。

## 06:57，trim+0.15°未进一步减漂移

附件：`C:/Users/14449/.codex/attachments/479ca8d0-cf65-43f2-b12d-a70591f56b7b/已粘贴的文本.txt`。仅STOP/BALTRIM0.15/ARM，回执OK；B/V确认内环8.4/0/0.15、外环0.035/0/3°、10°/s、70%输出、120RPM/3000ms、窄捕捉及同一零位4061/2013保持。

首T144069ms角度-0.264°、角速度0.028rad/s、输出+0.057；末T147049ms即2980ms，角度+0.088°、角速度-0.003rad/s、输出-0.175、均速-38.08RPM、外环参考-1.259°、最大单轮40.00RPM。角度仍小，没有明显增长振荡形态，但均速仍向负侧增大。

相对trim+0.10°末速-32.86RPM，本次末速-38.08RPM，没有进一步减漂移。两次初始角分别+0.264与-0.264°，初态不同，不能据一次差值就精确计算trim灵敏度，也不能说已证明正负方向或平衡偏差根因。瞬时输出偏移的符号不保证闭环长期速度变化同号。

下一轮不再继续加正trim；取+0.10°基准另一侧+0.05°做小步对照：STOP、BALTRIM0.05、ARM。内外环增益、零位与全部限幅/保护保持，不ZERO不烧录。根据末段平均速度、速度增长趋势和摆角一起判断，不以某个瞬时读数判定成功。

## 06:59，trim+0.05°末段速度有回落

附件：`C:/Users/14449/.codex/attachments/038148e8-518c-4c2f-a6b1-b1a544f46e4f/已粘贴的文本.txt`。STOP/BALTRIM0.05/ARM均OK；首B/V缺失，中途B/V确认同一零位4061/2013、内环8.4/0/0.15、外环0.035/0/3°、10°/s、70%输出、窄捕捉和120RPM/3000ms保护。

由241039ms的V.run_ms2000推算进入239039ms，开头/中段有缺帧，不能补造初始状态。2秒均速-22.47RPM、偏角+0.088°、参考-0.721°；后段约241739ms曾-30.11RPM，末T242019ms即约2980ms均速-22.83RPM、角度0°、角速度0.088rad/s、输出-0.138、参考-0.903°、最大单轮24.78RPM。所见后段摆角多0或±0.088°，末段有从约-30向-23RPM的回落，仍未到零速或建立长期稳定。

对照正trim0.15的末速约-38RPM、0.10约-33RPM，这次正trim0.05末速较低，提示继续向更小trim探索。但起始状态/缺帧和单次试验限制仍在，不能拟合出可靠的最优角度或把末一个数当稳态速度。

下一轮仅将trim0.05改为0，STOP、BALTRIM0、ARM。BALTRIM0是恢复无手动偏置，不是ZERO，不修改当前原始顶端2013与最低点4061。其余PID、外环、偏置限幅/变化率、输出与退出保护均保持，不烧录、不重新标定。观察是否继续减速或运动方向越过0，同时确认摆角没有开始持续偏离。

## 07:00，trim0继续减轻末段漂移

附件：`C:/Users/14449/.codex/attachments/483b9f03-ac50-4208-830a-111fff2cf2ea/已粘贴的文本.txt`。STOP/BALTRIM0/ARM均OK；B/V确认v25、零位4061/2013、内环8.4/0/0.15、外环0.035/0/3°、10°/s、70%输出、入口±0.5°、120RPM/3000ms均保持。

首T313354ms角度+0.176°、输出-0.026，均速0；中段存在缺帧。2秒315354ms角度0°、均速-17.09RPM、外环滤波-17.43RPM、参考-0.610°。末T316334ms即2980ms角度-0.088°、角速度0、输出-0.093、均速-19.52RPM、参考-0.725°、最大单轮21.22RPM。2.6秒左右曾到约-24RPM，此后末段有向约-20RPM回落，仍未达零速稳定。

近几轮同一几何标定的末均速大致为trim+0.15:-38、+0.10:-33、+0.05:-23、0:-20RPM。各次释放初态及缺帧不同，不做精确线性拟合，但减小trim的探索方向获得多次支持；仍需同时看角度及速度增长，不能单独按末速度判定稳态。

下一轮只试trim-0.05°，STOP、BALTRIM-0.05、ARM；保持其余控制参数、3秒/120RPM保护和当前标定，不ZERO不烧录。若速度越过0，需观察是小幅往复还是向正侧持续加速；不要因为某瞬间速度0便认定完成。

## 07:01，trim-0.05°未改善，退回0并延长观察

附件：`C:/Users/14449/.codex/attachments/3f8e3b1a-6d13-4d5b-ad92-011845ede4d4/已粘贴的文本.txt`。仅STOP/BALTRIM-0.05/ARM，收到OK；B/V确认同零位4061/2013、内环8.4/0/0.15、外环0.035/0/3°、10°/s、70%输出、窄捕捉及120RPM/3000ms。

首T381459ms初角+0.264°、输出-0.054，均速0。2秒383459ms角度0°、均速-21.22RPM、参考-0.673°；末T384439ms即2980ms角度-0.176°、角速度-0.068rad/s、输出-0.143、均速-35.63RPM、参考-1.174°、最大单轮37.86RPM。角度仍小、没有明显增长振荡，但末段速度继续向负侧增大。

相对trim0末均速约-19.52RPM且末段有回落，本次-0.05没有改善。不继续向负方向放大trim，退回0。各轮初态不同且仅3秒，不能以这些末值断言精确最佳平衡角或证明长期稳定，也不能继续无止境只根据一个终值调角。

下一轮固定增益、零位、trim0，仅把试验最长时长从3000改为5000ms、超速仍120RPM，其余70%输出和原始角度保护均保持。STOP、BALTRIM0、BALSAFE120/5000、ARM；不ZERO不烧录。目的是观察trim0末段回落是否持续及收敛，而不是通过延长时限掩盖漂移；需有足够无障碍行程，若车速达到保护仍自动撤驱动。未预先声称5秒内必定收敛。

## 07:03，trim0观察5秒，残余非零车速

附件：`C:/Users/14449/.codex/attachments/b32137d2-aef5-4744-b5f1-0255530a4ced/已粘贴的文本.txt`。STOP/BALTRIM0/BALSAFE120/5000/ARM收到OK。B/V确认零位4061/2013、内环8.4/0/0.15、外环0.035/0/3°、10°/s、70%输出、窄捕捉、120RPM/5000ms和trim0均保持。

首T495739ms，末T500719ms，约4.98秒。2秒均速-14.34RPM、角度+0.088°；3秒均速-24.05RPM、角度0°；后段约-25～-30RPM附近，末T均速-26.44RPM、角度0°、角速度0.004rad/s、输出-0.135、参考-0.913°、最大单轮28.90RPM。后段摆角小，没有此前增长振荡或冲到120RPM的形态，但车速仍非零，5秒内没有看到收敛到零；这不证明无限期保持，也不表示继续延时必定停住。

下一轮保持trim0、同一零位和全部增益/保护，只给外环Ki从0增加到0.0002°/(RPM·s)：STOP、BALVEL0.035/0.0002/3、ARM。不ZERO不烧录，120RPM/5000ms保护不变。该值是此前0.001的1/5，且内环P现在8.4（此前8.8）；上次加I后抖动不能直接外推到本次，但也不能因幅值小就保证稳定。观察V.i_deg与车速是否发生持续改善，若加速/振荡加重，停止并撤回Ki0，不同时再改trim/P或扩大保护。

## 07:04，Ki=0.0002试验含外部碰轮/搬动，需重测

附件：`C:/Users/14449/.codex/attachments/c0817d20-8ce1-4b51-ba6d-8e3adf4baa98/已粘贴的文本.txt`。STOP/BALVEL0.035/0.0002/3、ARM均OK，B/V确认同零位4061/2013、内环8.4/0/0.15、trim0、70%输出、窄捕捉、120RPM/5000ms和10°/s。进入581559ms，末T586539ms，4.98秒。

约920ms（582479）角度0°、角速度0、输出-0.015，但原始最大单轮318.99RPM、四轮算术均速+79.05RPM；此前582459均速-2.69、最大5.33。随后582499最大133.16、582519最大194.83RPM，外环参考受输入由负侧向正侧变化。2秒时均速近0、角度0；3秒均速+18.23RPM，4秒约+23.98RPM，末约+24.87RPM。V积分4秒仅+0.006°，不能将方向变化直接归功于小积分消除偏差。

初看存在单轮测速尖峰，助手询问是否碰轮/搬动车；用户明确回答“有碰轮或搬动车”。因此本次应视为有外部扰动的记录，不能把尖峰单独当成编码器硬件/软件故障证据，也不能拿本轮反向与Ki0无接触试验直接比较。之前提出的测速稳健化计划暂不据这一条受扰动记录实施，固件不变。此次只证明实际控制经历外部输入后仍有残余车速，未证明Ki好坏或稳态稳定。

下一轮保持本次所有参数（外环Ki0.0002），仅STOP、ARM，沿用同一标定，不ZERO、不加大Ki、不修改测速算法。在足够无障碍行程下全程无碰轮/搬动/碰撞，使用原5秒/120RPM自动退出并提交完整T/V，再判断积分效果。

## 07:07，Ki0.0002重测无明显尖峰或增长振荡

附件：`C:/Users/14449/.codex/attachments/eac3da03-1e5e-4d01-8df0-651e3ada8fb7/已粘贴的文本.txt`。STOP/BALVEL0.035/0.0002/3、ARM均OK；B/V确认同零位4061/2013、内环8.4/0/0.15、trim0、70%输出、窄捕捉、10°/s和120RPM/5000ms均保持。

245条完整T覆盖715734～720714ms，共4.98秒。初角+0.264°、角速度0；所见最大单轮25.60RPM，没有上一轮外部碰轮时约319RPM的尖峰。4秒V.i_deg=-0.011°、滤波均速-19.02RPM、参考-0.677°。末T角度0°、角速度0、输出-0.124、均速-25.05RPM、参考-0.849°，依然没有零速稳定。

按运行4秒之后的完整T计算：本次49条末秒均速约-21.59RPM、偏角-0.088～+0.088°；Ki0的5秒参考记录38条末秒均速约-27.11RPM、偏角-0.176～0°。两次初态和缺帧仍有不同，因此只能说这次表现略好且未引入明显增长振荡，不能把均速差精确归因于Ki；末段仍有向负侧增长。

下一轮仅将外环Ki0.0002试升到0.0005°/(RPM·s)，P0.035、偏置3°保持；内环、trim0、零位与所有限幅/退出保护不变。STOP、BALVEL0.035/0.0005/3、ARM，不ZERO、不烧录、不同时延长时限。Ki0.0005仍是试调值，不保证消除漂移；若摆动或加速加重，停止并回退Ki0.0002。继续同时记录积分、车速和摆角，不以瞬时速度为0当成收敛。

## 07:09，Ki0.0005没有确认的稳速改善

附件：`C:/Users/14449/.codex/attachments/b3be30a8-ccfd-40b2-8d8b-9c7497135c71/已粘贴的文本.txt`。STOP/BALVEL0.035/0.0005/3、ARM均OK；B/V确认同零位4061/2013、内环8.4/0/0.15、trim0、70%输出、窄捕捉、10°/s、120RPM/5000ms保持。

245条完整T覆盖856454～861434ms，共4.98秒，起始角-0.088°、角速度0.002rad/s，前约0.6秒轮速近0；与上一轮起始+0.264°不同，不能把所有速度差归因于Ki变化。4秒V积分-0.025°、滤波均速-24.76RPM、参考-0.891°，未接近3°参考限幅。末T角度-0.088°、角速度-0.040rad/s、输出-0.120、均速-26.08RPM、参考-0.948°，尚未回零。

最后一秒49条T均速-27.58RPM，范围-31.21～-23.77RPM，角度-0.264～0°。本轮最大单轮32.60RPM，无此前增长振荡形态；末秒平均不优于Ki0.0002上一轮约-21.59RPM，不能声称加Ki已改善稳速，也不能由单次5秒不同初态试验唯一识别原因。

下一轮先停止增Ki，控制参数全部保持当前值0.035/0.0005/3，trim0和同一标定；仅增加观察时长到8000ms，同时降低软件超速退出阈值到60RPM，保留连续50ms判定及其它原始角度/配置/传感器保护。STOP、BALSAFE60/8000、ARM，不ZERO不烧录。在足够无障碍行程记录较长暂态，观察是否真正持续减速，不能因延长时限就预期必定收敛。60RPM是撤驱动阈值而非硬速度限幅，撤驱动仍滑行；若触发保护，不继续抬高阈值掩盖增长。

## 07:10，Ki0.0005观察8秒仍有残余速度

附件：`C:/Users/14449/.codex/attachments/c07898f5-a72c-42ee-8dd4-3e14cd9fc31b/已粘贴的文本.txt`。STOP/BALSAFE60/8000/ARM均OK，B/V确认同零位4061/2013、内环8.4/0/0.15、外环0.035/0.0005/3°、10°/s、70%输出、窄捕捉、trim0均保持。

首T947899ms，末T955879ms，覆盖7.98秒。初角+0.088°，输出-0.013；2秒均速-16.33RPM，4秒约-16.84RPM，6秒约-25.95RPM，末约-25.99RPM。后段未形成向0的持续收敛，主要在约-22～-27RPM附近运行；摆角仍较小，无此前增长振荡形态，所见单轮最大速度远低于60RPM保护阈值。末T仍ACTIVE，接近8秒到时条件，但最终退出原因没有打印，不能仅凭日志截止确认。

7秒V.i_deg=-0.060°、参考-0.843°、滤波均速-22.39RPM，积分未到3°限幅。残余速度仍在，不能把角度保持约8秒等同于原地稳速。也不能仅因积分幅值小，就断定唯一问题是Ki不足。

下一轮保持当前同零位与其它全部控制/保护，Ki0.0005试升至0.001°/(RPM·s)，不再延长试验或提高输出/速度阈值。STOP、BALVEL0.035/0.001/3、ARM，不ZERO不烧录。早期Ki0.001试验时角度P8.8、外环P0.030，末段出现增长振荡，不能称其已验证安全；当前内环P8.4、外环P0.035和窄捕捉条件不同，仍只作60RPM/8000ms保护下的试调。若摆角振荡/加速加重，停止并退回Ki0.0005，不用提高限幅来维持测试。

## 07:12，Ki0.001约6.7秒后发生数次明显摆动

附件：`C:/Users/14449/.codex/attachments/d0cfd3b4-424a-428c-87ca-d2365bd15c42/已粘贴的文本.txt`。STOP/BALVEL0.035/0.001/3、ARM均OK，B/V确认同零位4061/2013、内环8.4/0/0.15、trim0、窄捕捉、10°/s、70%输出和60RPM/8000ms。用户反馈“后面一段突然抖两下这样”。

359条完整T覆盖1065959～1073279ms，共7.32秒。前约6.64秒采样偏角-0.439～+0.439°；约6.7秒后波动增大，后段-1.670～+1.406°，最大单轮67.57RPM。末T均速-56.63RPM、角度+0.615°、角速度-0.334rad/s、输出-0.222、参考-1.241°，仍ACTIVE。7秒时积分-0.141°，未到3°参考限幅；不能直接称“积分饱和”，也不能唯一断言由Ki引起。抖动发生在仍运行时且早于8秒时限，不能当作仅由到时撤驱动引起的摆动。

末段超60RPM，更像后续可能触发超速退出，但缺最终reason，需Watch确认；20msT采样不能证明每一个5ms内部样本连续50ms均超限。已询问后段是否有外部接触，答复尚待记录；没有出现此前碰轮时约319RPM单路突跳那种相同证据。

当前先撤回Ki0.0005，其余均不变：STOP、BALVEL0.035/0.0005/3、ARM，不ZERO、不烧录、不提高输出/速度/时限。目的先确认较低积分组合能重复恢复小幅摆角，不把回退等同于原地稳速已完成。若后段确有接触，应将该轮归为扰动响应而非无接触基线；若无接触，则记录为这组Ki0.001未通过当前8秒稳定性测试。

用户补充确认本轮“全程无接触”。据此本轮应记为当前Ki0.001组合约6.7秒后出现自行振荡，未通过8秒无接触稳定性测试；不以外部碰轮解释本次抖动。回退Ki0.0005后仍需复测，残余约20～30RPM漂移尚未解决，不固化为已完成整定。

## 07:15，回退记录含无接触单路测速尖峰，先修外环输入与诊断

回退外环Ki0.0005后，记录7.98秒，后段角度较小、末均速+7.73RPM，末秒平均约+9.90RPM。但约620ms时角度+0.088°、输出-0.038，原始最大单轮223.73RPM、算术均速-56.59RPM。用户明确“无接触”，实物轮速没那么高、车较稳定。因此不像07:04的已确认碰轮记录，需排查测速突跳；当前旧T只给均值/最大值，不能定位哪一路，不能直接认定编码器硬件故障。

暂停增益试调。v26将外环输入改为四路中间两路均值，原始四轮数据及原始峰值保护保持；T16列同时公开fast0～3与robust_rpm，V尾部追加估计值，便于定位。控制/串口/日志回归及ARMCC5全量构建通过，未自动烧录或实车验证。恢复候选参数8.4/0/0.15、外环0.035/0.0005/3、trim0、60RPM/8秒保护后采新数据，不同时加减PID。详情见[直立外环单轮测速尖峰处理](直立外环单轮测速尖峰处理.md)。

## 07:21，v26首轮四路诊断，末段碰撞，暂不改增益

附件：`C:/Users/14449/.codex/attachments/4cb481a0-45f6-460e-9f3d-c8539784ccff/已粘贴的文本.txt`。全部配置命令OK，固件0x103C8026、TRACE_V2；标定4061/2013，内环8.4/0/0.15，外环0.035/0.0005/3，trim0，70%输出，0.5°捕捉，60RPM/8000ms保护，参考变化率10°/s。用户明确“最后一段撞到了”，日志没有明确碰撞标记，不能定位接触时刻或将尾部减速作为自主收敛证据。

391条完整T覆盖25369～33349ms，共7.98秒。所有可见采样偏角-0.527～+0.527°，原始单轮峰值34.92RPM；未见此前约224RPM的尖峰或明显增长振荡，但碰撞前独立稳定时长尚不精确。约220ms时通道3（左前）-34.92RPM，其余三路-11.06/-7.28/-9.57RPM，原始均值-15.71RPM、中间两路均值-10.32RPM；约260ms通道3仍-20.85RPM，其余接近-2RPM，稳健值-2.08RPM。新估计器确实降低单轮偏离的影响，尚不能确定偏离源自编码器误计、机械负载还是短时轮间运动差异。

按MCU运行秒分段，1～2秒原始均速平均+10.41RPM，2～3秒+17.73RPM，3～4秒+19.77RPM，稳健均值分别+10.44/+17.73/+19.89RPM。多数时段四轮同向接近，因此持续平移不能全归因于单轮测量异常。后续分段存在用户报告的碰撞污染，排除其对参数优劣的证明；当前仍未完成原地零速整定。

下一轮先不修改PID、trim、标定或估计器，仅将时限缩短至5000ms，保持60RPM退出阈值，在有足够行程的位置重复：STOP、BALSAFE 60 5000、ARM。沿用同一上电标定，不ZERO、不烧录。先获取无碰撞重复记录，再判断残余速度及是否需要改变外环；不据受碰撞尾部再次增加Ki。

## 07:25，v26五秒重复，四轮一致且仍有正向残余速度

附件：`C:/Users/14449/.codex/attachments/9bbeebf7-663e-40ad-a5b0-5dc554dce218/已粘贴的文本.txt`。STOP、BALSAFE60/5000、ARM均OK。B/V确认内环8.4/0/0.15、外环0.035/0.0005/3、trim0、70%输出、0.5°捕捉、参考变化率10°/s和60RPM/5000ms。注意这次B标定为4060/2012，与07:21的4061/2013相差1计数（0.0879°）；可见命令只有STOP/保护/ARM，无法从本附件确定此前标定改变的时机，不假定用户操作，也不将两次幅值差全部归因于估计器。

244条完整T覆盖257609～262589ms，共4.98秒。所见角度-0.352～0°，原始单轮峰值17.81RPM，无此前大幅单轮测速尖峰或增长振荡。末T角度0°、速率0.074rad/s、输出+0.063、原始均速+15.26RPM、稳健值+15.35RPM、参考+0.505°；末行仍ACTIVE，接近5秒时限，但附件没有最终退出reason。

按秒分段，算术均速均值依次+5.59、+12.37、+11.03、+11.09、+13.11RPM。末秒四轮各自平均+13.00/+12.66/+13.66/+13.11RPM，稳健均速+13.21RPM，确认持续平移不是某一路离群值单独造成。4秒V滤波速度+11.07RPM、积分+0.019°、参考+0.407°，未接近参考或输出限幅。日志未显示角度大振荡，但不能据此称原地稳速完成，且用户尚未单独确认本轮全程无接触。

下一轮不升外环P或I（此前0.038和Ki0.001均出现振荡），仅试BALTRIM -0.05°，保持本次4060/2012标定、60RPM/5秒保护及所有增益。命令STOP、BALTRIM -0.05、ARM，不ZERO、不烧录。在当前Kp8.4、BALSIGN-1条件下，同一瞬间状态的未限幅输出减小约0.00733（0.73个百分点），实际长期速度改善仍需实测，不能从静态公式保证。早期在不同零位/初态曾测试负trim且漂移更大，不把本次微调视为已验证解；若本次漂移加重或出现振荡，STOP后BALTRIM0撤回。下一轮比较后2秒四轮稳健均速和摆角，避免受碰撞尾部误导。

## 07:27，trim -0.05反向漂移更大，约7.7秒后无接触自行摆动

附件：`C:/Users/14449/.codex/attachments/2084aec4-e284-4bef-ab93-bca00fa69848/已粘贴的文本.txt`。STOP、BALTRIM -0.05、ARM均OK。内环8.4/0/0.15、外环0.035/0.0005/3、标定4060/2012、70%输出、0.5°入口、10°/s均与上轮一致。但V.max_run_ms始终50000（50秒），不是上一轮5000；本附件没有改变时限的命令，无法确定其修改来源，不能认为5秒保护仍在生效。

397条完整T覆盖356409～364749ms，共8.34秒。初角+0.088°，与上一轮trim0初角0°不同；同标定可以比较，但不能拟合精确trim最优值。第3～5秒算术均速平均-19.04RPM、中间两路均值-19.06RPM，上轮同时间窗分别+12.10/+12.17RPM。方向翻转且绝对残余速度增大，不支持保留-0.05作为稳速参数。

前约7秒角度较小，随后约7.7秒开始明显摆动；完整记录角度-1.494～+1.230°，单轮峰值69.26RPM，末均速-53.36RPM、稳健值-49.83RPM、参考-1.159°、输出-0.165。用户明确本次“全程无接触，自己开始抖动”，因此不能归为碰撞尾部。末行仍ACTIVE，虽有采样超过60RPM，20ms日志不能确认5ms内部连续50ms超速或最终退出reason；不能将截止直接定性为超速退出。积分7秒-0.049°，未到3°限幅，不称积分饱和，也不能从这一轮唯一归因于trim。

下一轮不保留trim -0.05、不改变P/D和外环PI，恢复60RPM/5000ms短时试验，仅在trim0与-0.05之间试较小幅度-0.02°。命令STOP、BALSAFE60/5000、BALTRIM -0.02、ARM，沿用同一标定，不ZERO不烧录。这只是区间内候选，不以两轮数据线性拟合声称已知最优值，也不因缩短记录就宣称长期稳定。若仍出现明显漂移/振荡，STOP后BALTRIM0撤回；下一份需核实V.max_run_ms=5000、trim=-0.020，比较第3～5秒均速与摆角。

## 07:29，trim -0.02五秒仍漂移；用户指定三点中值窗口

附件：`C:/Users/14449/.codex/attachments/b83abb84-e0fa-451a-b9c1-c1f080ff900d/已粘贴的文本.txt`。STOP/BALSAFE60/5000/BALTRIM -0.02/ARM全部OK，V确认5000ms、trim -0.020，其余增益与前轮相同，标定4060/2012。244条完整T覆盖468739～473719ms，共4.98秒，角度-0.088～+0.352°，最大单轮24.37RPM。第3～5秒算术均速-17.32RPM、稳健均值-17.24RPM；对比trim -0.05的同时间窗-19.04RPM和trim0的+12.10RPM，尚未得到零速收敛，且不同初态下不能拟合精确最优trim。末T均速-17.56RPM、参考-0.626°、输出-0.066；角度较小，无上一轮7.7秒后明显摆动的同等时长证据，5秒截止不证明更长运行稳定。

用户随后明确“滤波窗口变为3试一下”。遵照请求停止同时改增益，v27仅将AS5600角度环形中值窗口由5改3并更新版本号；10ms角速度LP、控制逻辑及参数默认值保持。编译及生产中值/角度/直立/外环回归通过，未自动烧录。烧录会丢失RAM参数与标定，需要重下发本次候选配置并ZERO；见[AS5600三点中值滤波试验](AS5600三点中值滤波试验.md)。不把缩短滤波窗口预先称为实车稳速或抖动修复。

## 07:32，日志仍为v26，不能归入三点滤波试验

附件：`C:/Users/14449/.codex/attachments/7e71a3fb-1ee4-4527-becc-ad5978d3afb8/已粘贴的文本.txt`。完整设置命令均OK，60RPM/5000ms、trim -0.020，标定4060/2012，内环8.4/0/0.15、外环0.035/0.0005/3等保持。但日志头明确fw=0x103C8026，未报告新v27，因此不能把本轮变化归因于三点窗口。当前本地生产源码MEDIAN_WIN3、APP_FW_BUILD0x103C8027，全量构建成功，正常KeilHEX与构建HEX SHA256一致；新固件可用，需用户重新下载正确镜像并以板上日志版本确认，未替用户操作硬件。

244条T覆盖658399～663379ms，4.98秒，角度-0.352～+0.527°、最大单轮79.29RPM，末均速-19.66RPM、稳健值-19.78RPM。第3～5秒均速-14.96RPM；仍存在漂移，不构成新滤波优劣证据。本次不再改PID、trim或时限；下载v27后恢复本轮完整配置并在最低点ZERO，待日志头确认0x103C8027后再评估三点滤波效果。

## 07:34，已烧录三点窗口，末段无接触自行摆动

附件：`C:/Users/14449/.codex/attachments/d0127e7e-4b0b-4edd-843b-eb7cafc5c8bd/已粘贴的文本.txt`。完整配置命令均OK，B/V确认内环8.4/0/0.15、外环0.035/0.0005/3、trim -0.020、60RPM/5000ms、70%输出、0.5°捕捉和10°/s。本附件缺协议头，不能从文本独立验证fw；询问后用户确认“以烧录”（已烧录），按新三点窗口试验继续，下一份仍保留版本头为宜。用户同时明确末段“无接触”，因此摆动应视为自行发生，不能用碰撞解释。

B最低点4061、顶端2013，较前一轮4060/2012偏1计数，初始姿态和完整前段也缺失，不能把跨轮变化全部归因于窗口。V27919ms的run_ms2000推导ACTIVE起点25919ms；首完整T27679ms已经运行1760ms，末T30899ms为4980ms。只有125条完整T，中间也缺帧，严禁以首T当0秒或声称完整5秒平均。

2～3秒49条T均速-18.48RPM、摆角-0.176～+0.088°；3～4秒仅15条均速-21.07RPM；4～5秒49条均速-21.46RPM、摆角-0.703～+0.703°。约4.6秒后开始明显周期变化，所见单轮峰值58.30RPM；末T均速-27.94RPM、稳健值-26.43RPM、角度+0.703°、角速度+0.425rad/s、输出-0.263、参考-0.635°。存在持续漂移及后段摆动，不能说缩短窗口已经改善或恶化整体性能；前段缺失、零位1计数变化和释放条件不同均限制比较。

下一轮先只试角度D从0.15减到0.12，P8.4、角度I0、外环/trim/标定/三点窗口和60RPM/5秒均保留：STOP、BALPID8.4/0/0.12、ARM。不ZERO不烧录。假设是降低快速角速度反馈幅度可能减轻高频输出，尚不能确定是根因，也不保证更小D改善真实阻尼；若摆动或倾倒加重，STOP后BALPID8.4/0/0.15回退。继续保留完整头部及T/V，避免把短时角度小幅维持当成零速整定完成。

## 07:37，三点窗口版本确认，D0.12试验更早出现加速与摆动，撤回

附件：`C:/Users/14449/.codex/attachments/5cc5cc43-9de4-4a0a-beae-7c50473272db/已粘贴的文本.txt`。协议头确认fw=0x103C8027，三点窗口新固件已运行。STOP/BALPID8.4/0/0.12/ARM均OK；B/V确认标定4061/2013、外环0.035/0.0005/3、trim -0.020、60RPM/5000ms和其它设置保持。初角+0.264°、速率0，不同于上一份缺首段的试验，不能据一次比较唯一证明D是所有差异的原因；本轮有无外部接触尚未单独确认。

124条完整T覆盖253474～256014ms，从ACTIVE起点到末帧2.54秒，不足5秒，不能计算3～5秒平均。1秒V滤波速度-22.96RPM、参考-0.810°；2秒滤波速度-38.63RPM、参考-1.374°、积分-0.022°，未到3°参考或70%输出限幅。所见角度-1.055～+0.703°、单轮峰值70.28RPM，末T均速-55.16RPM、稳健值-52.19RPM、原始单轮最大65.74RPM、参考-1.520°、输出-0.173。多数轮均明显同向加速，不能用单轮离群测速解释整体增长。

约2.2秒后摆动明显，较前轮D0.15记录在约4.6秒才见较大摆动的表现更差。末端有超过60RPM的采样，可能后续触发超速退出，但末行仍ACTIVE，20ms帧不能证明内部50ms连续超速或最终reason，不能断言本轮因超速停机；记录截止也不等于角度失控退出。

不保留D0.12，先回退：STOP、BALPID8.4/0/0.15、ARM。保持三点窗口、同标定、外环和trim -0.02、60RPM/5秒，不ZERO、不烧录、不提高限幅；下一轮完整记录用于复现基线。此前降低D的诊断假设未获得改善证据，不继续降低或同时增加Ki来补偿。

## 07:43，D恢复0.15后五秒摆角小，但负向残余速度仍在

附件：`C:/Users/14449/.codex/attachments/c19cb88a-0549-4cb2-9ee1-e2426159681a/已粘贴的文本.txt`。STOP/BALPID8.4/0/0.15/ARM均OK。附件首段缺协议头/首B/V，但中段B/V确认标定4061/2013、内环8.4/0/0.15、外环0.035/0.0005/3、trim -0.020、60RPM/5000ms、70%输出、0.5°捕捉和10°/s。沿用前轮已确认v27的三点滤波，不据缺失协议头独立声称再次验证版本。

V577099ms的run_ms2000推导ACTIVE起点575099ms；225条完整T覆盖起点后220～4980ms，前段有缺帧。所见角度-0.176～+0.352°、单轮最大34.24RPM，未出现D0.12那轮2.2秒后明显扩大的摆动和约55RPM整体加速。仅是本次短时表现恢复，初始/释放条件不同，不唯一证明D差异是全部原因。

2～3秒算术均速-21.56RPM，3～4秒-22.46RPM，4～5秒-26.17RPM；第3～5秒98条T平均-24.32RPM，稳健值-24.26RPM。末T角度-0.088°、速率0.003rad/s、输出-0.124、四轮均速-24.01RPM、稳健值-24.91RPM、参考-0.909°。4秒积分-0.028°，未到参考限幅；角度小不代表原地稳速完成，也不能以日志接近5秒断言最终reason=9。

暂保留D0.15及其余增益。trim -0.02在同标定三点窗口条件下没有证明稳速改善，下一轮先撤回手动偏置到0，获取当前窗口/标定的零偏置基线：STOP、BALTRIM0、ARM。不ZERO不烧录、不改P/I/D或扩大保护，60RPM/5000ms保持。此前v26在不同零位/初态的trim0记录不能替代本次基线；若回退后速度反向，也不直接线性拟合最优trim，需要看后段稳定速度及重复性。

## 07:47，trim0与-0.02残余速度接近，可能有启动接触，暂停参数搜索复测

附件：`C:/Users/14449/.codex/attachments/d2c9193a-9b06-4206-a685-0f0a72584dcb/已粘贴的文本.txt`。STOP/BALTRIM0/ARM均OK，fw0x103C8027；B/V确认标定4061/2013、内环8.4/0/0.15、外环0.035/0.0005/3、trim0、60RPM/5000ms、70%输出、0.5°捕捉、10°/s。用户补充“开始的时候手可能碰到了一下”，这是可能的启动扰动，不扩写为确定碰撞，也不因此将整段后续数据全部作废。

167条完整T覆盖831324～836304ms，0～4.98秒，中间有较多缺帧。首角-0.264°，60ms后+0.088°，随后转向正侧；与用户可能启动接触相容，但不能仅由日志确认接触时刻或唯一原因。所见角度-0.264～+0.527°，最大单轮31.74RPM，无D0.12那样明显增长振荡；后段四轮同向接近，是真实持续平移的反馈形态。

第3～5秒87条完整T算术均速-22.49RPM、稳健均值-22.46RPM。上轮trim -0.02同窗98条均速-24.32RPM，差约1.83RPM，同时初态/接触/缺帧不同，不支持声称偏置回0已经解决漂移或可继续据此拟合最佳偏置。末T角度0°、速率0.045rad/s、输出-0.134、均速-24.80RPM、稳健值-24.61RPM、参考-0.868°；4秒积分-0.028°，未接近参考限幅。即便启动确有接触，后段未回零仍说明本次扰动后的零速恢复未实现，不能把一切归因于碰手。

本轮不再改变增益、trim、窗口、标定或保护，保留trim0基线，下一轮仅STOP、ARM，不ZERO不烧录。要求在同一位置尽量静止捕捉、完全松手后不再碰杆/轮/底盘，提交完整头部与T/V，用于确认无额外启动扰动时仍否持续漂移；避免依据这一次可能接触的方向继续改trim。

## 07:49，同参数重复仍持续负向漂移，停止扫描trim，试D0.17

附件：`C:/Users/14449/.codex/attachments/9a9b407b-5492-4479-a6b4-8e93c731c19d/已粘贴的文本.txt`。STOP/ARM均OK，fw0x103C8027。B/V确认标定4061/2013、内环8.4/0/0.15、外环0.035/0.0005/3、trim0、60RPM/5000ms、70%输出、0.5°捕捉、10°/s与上轮一致。

173条完整T覆盖937689～942669ms，0～4.98秒，中间缺帧较多。初角0°、速率0、输出0，前约100ms零轮速；140～200ms仅fast3负向偏离（最大25.87RPM），其余三路0，稳健值保持0，新外环输入没有将该离群值当车身速度。后续四轮均同向接近，所见最大单轮38.13RPM，角度-0.264～+0.439°，没有D0.12试验的明显增长摆动。

第3～5秒只有69条完整T，观测帧算术均速平均-29.56RPM，稳健均值-29.35RPM；上轮87条约-22.49RPM。存在缺帧和不同释放初态，不能将二者差精确归因于单个参数，但同配置重复未显示零速收敛。末T角度-0.088°、角速度0、均速-31.07RPM、稳健值-30.82RPM、参考-1.060°、输出-0.143。末帧参考未到3°、输出未到70%；不支持用扩大限幅处理本次漂移。用户在本轮没有额外报告碰撞/接触，不将前轮“可能碰手”自动延伸到本轮，也不声称已单独确认本轮全程无接触。

不再继续据当前零速漂移扫描细小trim，保持trim0和全部外环/窗口/标定/保护。D降低到0.12曾明显更早出现加速与摆动，下一轮只向另一侧小幅试D0.17（增0.02），内环P8.4/I0保持：STOP、BALPID8.4/0/0.17、ARM。不ZERO不烧录。此为阻尼试验，不保证消除直流残余速度；若出现高频抖动或加速更重，STOP后BALPID8.4/0/0.15恢复。先比较摆角和速度增长，不同时增加外环P/I，避免再次进入先前0.038或Ki0.001的振荡区域。

## 07:50，D0.17五秒未引入明显振荡，暂留候选，外环P试0.036

附件：`C:/Users/14449/.codex/attachments/80bec31d-287b-4fcd-a241-07a25234e3af/已粘贴的文本.txt`。STOP/BALPID8.4/0/0.17/ARM均OK，fw0x103C8027；B/V确认标定4061/2013、外环0.035/0.0005/3、trim0、60RPM/5000ms、70%输出、0.5°捕捉和10°/s均保持。

235条完整T覆盖1023069～1028049ms，0～4.98秒。初角-0.264°、速率-0.014rad/s，和前轮初角0°不同；所见角度-0.439～+0.527°，最大单轮33.96RPM。第3～4秒均速-25.31RPM，第4～5秒-21.09RPM，后2秒98条平均-23.20RPM、稳健值-23.07RPM；末T角度0°、速率0.066rad/s、输出-0.129、均速-22.19RPM、参考-0.804°。后两秒角度均在-0.176～0°，未出现D0.12记录的快速增长振荡，仍非零速收敛。

上轮D0.15无额外参数变化记录末2秒均速-29.56RPM，本轮绝对值较小，但更早D0.15另一次约-22.49RPM，落在类似幅度；释放状态和缺帧不同，不能据一次结果声称D0.17已显著优于0.15。仅暂留为未引入明显五秒振荡的阻尼候选，不继续扫描D。

下一轮只将速度外环P0.035小幅试增至0.036，Ki0.0005、最大参考3°保持，内环8.4/0/0.17及其余配置/保护不变：STOP、BALVEL0.036/0.0005/3、ARM。不ZERO不烧录。此前0.038在不同窗口/阻尼下曾振荡，不直接跳至0.038，也不同时加Ki。此为小步速度反馈试调，不保证减少漂移；若出现自行振荡或速度增长加重，STOP后BALVEL0.035/0.0005/3恢复。继续比较完整3～5秒速度和角度，禁止把角度短时小幅维持当成原地整定完成。

## 07:52，P0.036方向翻转但仍加速，暂停细扫增益，做短时外环关闭对照

附件：`C:/Users/14449/.codex/attachments/78d325da-097f-470f-89cb-3babe3fc3793/已粘贴的文本.txt`。STOP/BALVEL0.036/0.0005/3/ARM均OK。附件缺协议头和首次B/V，中段B/V确认标定4061/2013、内环8.4/0/0.17、外环0.036/0.0005/3、trim0、60RPM/5000ms及其它配置保持。

V1119869ms的run_ms2000推导ACTIVE起点1117869ms，首完整T为460ms后，189条T到末4980ms。所见角度-0.264～+0.176°、最大单轮25.61RPM。第1～2秒44条T均速+9.48RPM，2～3秒49条+10.61RPM，3～4秒49条+14.54RPM，4～5秒37条+22.39RPM；后2秒86条观测平均+17.92RPM、稳健均值+17.99RPM。末T均速+21.97RPM、稳健值+23.78RPM、角度+0.088°、速率+0.048rad/s、输出+0.110、参考+0.891°。4秒积分+0.020°，没有接近参考3°上限，不能说积分饱和。

相较P0.035时的负向漂移，本次翻到正向且绝对均速较小，但启动前段/初态缺失，不把翻向当作减速成功，后段仍呈速度增长，也不能唯一归因于P增加0.001。日志中多数轮速同向接近，不是单轮离群值导致；角度维持小范围仍未实现原地稳速。

重新核对生产代码：外环滤波速度经正PI形成demand，再乘-BALSIGN成为目标角，目标角通过直立PD进入电机；BALVEL0/0/3会禁用速度外环并清参考/I，不关闭直立角度PD。当前实验还没有在三点窗口/内环8.4/0/0.17/同标定下的外环关闭对照，不根据源注释认定物理外环极性已验证。

暂停继续微增P/I和扫描trim。下一轮仅作短时诊断：STOP、BALSAFE60/3000、BALVEL0/0/3、ARM，保留直立8.4/0/0.17、三点窗口、trim0、标定与其它限制。不ZERO不烧录，不操作OPEN。缩短至3秒是限制此对照的运行时长，不能将完整3秒与原5秒尾部作等时比较；重点记录首3秒摆角、T四轮速度和加速趋势，单次结果也不独立证明外环符号。外环关闭时V.rpm/ref/I为0是模块禁用清零，实际运动仍看T.mean/fast0～3/robust，不能当编码器不工作。

## 07:54，关闭速度外环后快速发散，恢复并小步试P0.037

附件：`C:/Users/14449/.codex/attachments/ded5b5ed-917f-49b5-b809-870057088f8a/已粘贴的文本.txt`。STOP/BALSAFE60/3000/BALVEL0/0/3/ARM均OK。fw0x103C8027，B/V确认标定4061/2013、内环8.4/0/0.17、trim0、速度外环enable0和P/I0、60RPM/3000ms；其它窗口/限幅保持。角度内环并未关闭。

92条完整T覆盖1247734～1249614ms，0～1.88秒。初角+0.352°、角速度0、输出-0.052；此初态和上一轮缺失首段不同，不能做严格同初态增益识别。1秒时角度+0.791°、四轮峰值23.09RPM；末角+1.846°、速率0.007rad/s、输出-0.272、原始四轮均速-60.80RPM、稳健值-59.49RPM、峰值64.88RPM。完整记录最大单轮66.57RPM，四路一致同向增长，不能归因于单轮异常。V.rpm/ref/I保持0是外环禁用的正常清零，实际速度由T明确可见。

末行仍ACTIVE；原始轮峰值多次超60RPM，末段时间形态符合后续可能触发速度退出，但仅20msT不能确认每个5ms内部样本50ms持续超限，也没有最终reason，故不写“已确认超速停机”。未达到3秒记录长度，不继续延时或提高阈值以获取更长无外环运行。

相比启用外环P0.036时可见5秒角度-0.264～+0.176°、末均速+21.97RPM，本轮更快出现角度和速度发散，支持保留速度外环；单次不同初态不能精确证明其极性/最优增益，也不把漂移方向翻转当成功。下一轮恢复外环并只相对已测P0.036增加0.001到0.037，Ki仍0.0005、参考限幅3°，内环8.4/0/0.17、trim0、三点窗口和零位均保持。恢复有外环基线的60RPM/5000ms设置：STOP、BALVEL0.037/0.0005/3、BALSAFE60/5000、ARM，不ZERO不烧录。此前0.038曾在不同窗口/阻尼下振荡，本次仍是试验值；若出现摆动或加速加重，STOP并回退BALVEL0.036/0.0005/3，不继续加大P/I或保护阈值。

## 07:55，P0.037用户反馈明显改善，保留候选并先复测

附件：`C:/Users/14449/.codex/attachments/925c6358-ae63-4698-bb6c-a36c40323cca/已粘贴的文本.txt`。STOP/BALVEL0.037/0.0005/3/BALSAFE60/5000/ARM均OK。用户反馈“这段效果好很多”。附件首段缺协议头/首次B/V，后续B/V确认标定4061/2013、内环8.4/0/0.17、外环0.037/0.0005/3、trim0、60RPM/5000ms、70%输出、0.5°捕捉和10°/s保持。

V1347114ms的run_ms1000推导ACTIVE起点1346114ms；首完整T为起点后960ms，198条T到末4980ms，不能声称完整启动阶段已验证。可见角度-0.352～+0.088°，最大单轮19.43RPM。第1～2秒均速+7.80RPM，2～3秒+10.74RPM，3～4秒+14.00RPM，4～5秒+11.99RPM。后2秒98条完整T均速+12.99RPM、稳健均值+13.00RPM；末T角度-0.088°、速率+0.064rad/s、输出+0.072、均速+14.65RPM、稳健值+13.97RPM、参考+0.475°。3～5秒可见角度-0.176～+0.088°，无明显增长振荡；后1秒相较前一秒减速，但末尾仍非零且不能据局部下降外推长期收敛。

上轮P0.036末1秒37条均速+22.39RPM，本轮49条+11.99RPM，且用户主观感觉改善，支持保留为候选。启动姿态和缺帧不同，不能精确把速度差归因于P增加0.001，也不能定为原地稳速已完成。4秒积分+0.017°，参考+0.510°，尚远离参考3°限幅。

暂停继续增P/I、改D/trim或扩大时限，保留这组参数先做一次5秒重复：STOP、ARM，不ZERO不烧录。目的确认改善可重复，并保存完整协议头和启动T；此前P0.038曾振荡，不因本轮变好就继续推高。若重复仍小摆角、低残余速度，后续再判断更长观察或针对残余漂移的单项调整；本轮不更改固件默认值，不写入持久化标定。

## 07:57，P0.037重复仍小摆角，但较低漂移未重复，试外环Ki0.0007

附件：`C:/Users/14449/.codex/attachments/582dff25-0113-47d5-bcdc-302d4534e9da/已粘贴的文本.txt`。STOP/ARM均OK，fw0x103C8027，完整首B/V确认标定4061/2013、内环8.4/0/0.17、外环0.037/0.0005/3、trim0、60RPM/5000ms、70%输出、0.5°捕捉和10°/s未改变。初角+0.088°、角速度0.001rad/s；上轮缺首次帧，释放状态不可直接比较。

172条完整T覆盖1429119～1434099ms，0～4.98秒，中间缺帧较多。所见角度-0.176～+0.352°、单轮峰值29.59RPM，无此前明显增长摆动。第1～2秒32条均速-16.59RPM，2～3秒49条-18.12RPM，3～4秒27条-19.83RPM，4～5秒30条-23.12RPM。后2秒仅57条完整T均速-21.56RPM、稳健值-21.56RPM，末T均速-24.41RPM、稳健值-24.03RPM、角度-0.088°、速率0.020rad/s、输出-0.124、参考-0.911°；四轮同向接近，是持续平移反馈而非单路离群。

上轮后2秒+12.99RPM，此轮方向反转且幅值更大；因此只重复了小摆角，不能声称P0.037已经稳定降低残余车速，更不能由单次“好很多”固化为最终参数。3秒V速度-17.12RPM、积分-0.019°、参考-0.652°，不接近参考上限，也不能仅因I数值小就唯一断定Ki不足。

暂保持内环8.4/0/0.17、外环P0.037及其它参数，不继续推P或扫描trim。下一轮仅试外环Ki0.0005升至0.0007：STOP、BALVEL0.037/0.0007/3、ARM；沿用同标定、60RPM/5000ms，不ZERO不烧录。这是未验证试调，早前Ki0.001在不同窗口/内环/外环P组合发生无接触摆动，故不直接跳到0.001，也不同时延长时限。若出现自行振荡或加速加重，STOP后BALVEL0.037/0.0005/3撤回。观察V.i_deg、摆角和同时间窗速度，目标为持续回零，不以方向变化或单次瞬间零速判为完成。

## 07:59，Ki0.0007可见后段平稳慢漂，先观察8秒，不继续增I

附件：`C:/Users/14449/.codex/attachments/6f8ad492-7fb0-49f6-bad8-9859d8ae64e2/已粘贴的文本.txt`。STOP/BALVEL0.037/0.0007/3/ARM均OK。附件缺协议头和启动前460ms，中段B/V确认标定4061/2013、内环8.4/0/0.17、外环0.037/0.0007/3、trim0、60RPM/5000ms、70%输出、0.5°捕捉和10°/s保持。沿用已确认三点窗口v27，不由缺失头部独立重复验证版本。

V1536524ms的run_ms1000推导ACTIVE起点1535524ms。186条完整T覆盖运行460～4980ms，初态和前段不可与上一轮直接等同。所见角度-0.264～0°、单轮峰值16.62RPM；第1～2秒均速+11.15RPM，2～3秒+10.34RPM，3～4秒37条+11.46RPM，4～5秒24条+10.95RPM，后2秒61条观测平均+11.26RPM、稳健值+11.25RPM。末T角度-0.088°、速率-0.066rad/s、输出+0.087、均速+10.03RPM、稳健值+9.68RPM、参考+0.428°。后1秒可见角度-0.088～0°，没有增长振荡，但速度基本在约11RPM附近，不是已持续回零。

4秒V滤波速度+11.71RPM、积分+0.028°、参考+0.461°，无参考饱和。相较上一轮Ki0.0005的负向约22RPM，本轮正向约11RPM较小，但初态缺失/释放差异且Ki0.0005也曾取得正向约13RPM，不以单次结果断定积分已解决漂移。暂留Ki0.0007为未出现五秒明显振荡的候选，不固化默认。

下一轮不增加P/I/D、不改变trim或标定，只将同60RPM退出阈值的观察时限从5000ms延到8000ms：STOP、BALSAFE60/8000、ARM，不ZERO不烧录。此前Ki0.001在不同窗口/阻尼组合约6.7秒后自行振荡，八秒结果尚未验证；本次目的观察后段是否有持续减速或振荡增长，不预先保证积分将自行消除漂移。需足够无障碍行程且无接触，若出现加速或抖动便停止，不上调阈值或输出限幅。

## 08:00，八秒试验尾段疑似过坎扰动，未见完整恢复，不据此改增益

附件：`C:/Users/14449/.codex/attachments/c6cf0c90-2b71-4469-bca2-cbcf536b69d6/已粘贴的文本.txt`。STOP/BALSAFE60/8000/ARM均OK。用户报告“后续抖一下应该是轮胎过了一个小坎”，记录为可能的地面扰动，不能当作已精确定位的确定接触，也不将尾段直接判为Ki0.0007自激。

附件缺协议头和启动前440ms，中段B/V确认标定4061/2013、内环8.4/0/0.17、外环0.037/0.0007/3、trim0、60RPM/8000ms、70%输出、0.5°捕捉、10°/s。V1634789ms的run_ms2000推导ACTIVE起点1632789ms；173条完整T到末1639309ms，即6.52秒，并非完整8秒。中间存在较大缺帧，第1秒段仅2条完整T，5.48秒后到6.34秒之间缺连续完整帧，不根据串口助手分块时间推断控制暂停或精确过坎时刻。

第2～3秒27条均速-24.94RPM，3～4秒49条-25.01RPM，4～5秒49条-26.77RPM；这些可见帧角度在-0.264～0°。5秒V滤波速度-25.47RPM、积分-0.071°、参考-1.013°，末个扰动前完整T在5.48秒均速-24.47RPM、角度-0.176°。因此在疑似过坎前已存在约25RPM慢漂，没有持续回零；上一轮约11RPM的幅度改善未稳定复现，不应将全程漂移归因于坎。

约6.34秒起可见大摆动，所见角度最低-1.494°、随后最高+0.879°，最大单轮67.23RPM；末T均速-50.90RPM、稳健值-59.50RPM、角度+0.615°、输出-0.281、参考-1.436°。最终帧仍ACTIVE且没有恢复到扰动前速度，尾部不足以确认已恢复；虽有原始单轮超60RPM，不能仅凭20ms帧判定内部50ms连续超速或最终reason=8，也不能称8000ms到时退出。

本轮不增加P/I/D、不改窗口或零位，不提高阈值。下一轮同参数在平整、连续且有足够行程的地面复测，命令仅STOP、ARM，保留60RPM/8000ms。不要ZERO或烧录。目标是获取无坎的较长后段，区分自行增长与地面扰动；若再发生碰撞/过坎，保留标记，不用受扰尾段直接决定积分优劣。

## 后续硬件变更：实心铁棒，v28固化最近试调参数

用户报告已将原空心杆末端负重结构换为实心铁棒，且刚关机，要求先把相关参数写入源码。具体换杆发生时刻/杆长/质量/转轴位置不明，不能把全部先前日志一概视为旧杆或新杆，也不能凭材料重新估算确定PID。先按用户要求固化最近8.4/0/0.17、外环0.037/0.0007/3°及完整相关设置为新结构调试起点，未宣称已经调好。

v28（0x103C8028）更新balance_control.c初值：角度8.4/0/0.17，入口0.5°/400ms，退出20°，输出0.70，轮速60RPM，试验8000ms，外环启用0.037/0.0007/3°，slew10，trim0、BALSIGN-1保持。默认BALTRACE1，LOG1，仍只ACTIVE期间打印。三点角度中值、10ms角速度LP、轮位与编码器方向不改。上电仍OFF且未标定，不固化旧最低点，不能绕过ZERO和顶端捕捉；每次上电只需STOP、ZERO恢复试验准备，退出后ARM重试。

启动初值/未标定拒绝/400ms捕捉、角度/外环/保护回归、串口及日志回归、ARMCC5全量40源构建通过，未自动烧录。正常KeilHEX/AXF已更新，旧v27备份在before_solid_rod_defaults_v28。原算法测试改为显式选择旧场景参数，避免把默认值变化误作算法回归。详细参数与新杆局限见[实心铁棒默认参数](实心铁棒默认参数.md)。

## 15:03，实心铁棒v28基线八秒小摆角，仍负向漂移，试外环Ki0.0009

附件：`C:/Users/14449/.codex/attachments/33041a33-b828-4a0b-a050-9d48002bc6fe/已粘贴的文本.txt`。ARM回执OK，fw0x103C8028。B确认最低点4060、顶端2012、标定成功200点；V/B确认源码默认8.4/0/0.17、速度外环启用0.037/0.0007/3、trim0、60RPM/8000ms、70%输出、入口0.5°/400ms、退出20°和10°/s均已生效。此为用户报告实心铁棒更换后发来的v28基线；不跨结构将旧日志中的Ki边界当成新结构已验证结论。

301条完整T覆盖83794～91774ms，0～7.98秒，中间缺帧，不把串口助手接收间隔当控制停顿。初角-0.264°、速率-0.044rad/s；可见角度-0.352～+0.439°，最大单轮30.27RPM，未见增长振荡或之前过坎尾部那种明显摆动。前约100ms通道3测速0，其余已有少量读数，后续四轮同向接近；现有诊断不支持单轮异常导致整个后段均速偏移。

第3～4秒36条均速-19.38RPM，4～5秒49条-23.12RPM，5～6秒49条-21.45RPM，6～7秒27条-22.99RPM，7～8秒29条-21.88RPM。末T角度-0.176°、速率+0.072rad/s、输出-0.103、均速-17.89RPM、稳健值-18.12RPM、参考-0.793°。末段局部减速，但没有持续回零；不能把最后单点减小或小摆角保持8秒视为原地稳速完成。6秒V积分-0.063°、参考-0.916°，未接近3°参考限幅；末帧仍ACTIVE，截止接近8秒而未打印最终reason，不单独确认到时原因。

新杆角度内环暂保留8.4/0/0.17，外环P0.037和其它默认/标定/保护保持。下一轮只把外环Ki0.0007试增到0.0009：STOP、BALVEL0.037/0.0009/3、ARM，不ZERO不烧录，仍60RPM/8000ms。本次是串口临时试调，不同时改源码默认Ki；若出现自行摆动或速度增长加重，STOP后BALVEL0.037/0.0007/3撤回。较早Ki0.001曾在当时结构/窗口/阻尼组合发生振荡，但换杆时刻不详且当前配置不同，既不声称那次边界自动适用，也不据本轮稳角保证加I安全或必定改善。目标继续观察同时间窗车速与角度，而非单纯延时或加大P/输出。

## 15:05，实心铁棒Ki0.0009无接触自主减速至近零，保持增益观察12秒

附件：`C:/Users/14449/.codex/attachments/10c30405-b370-4e7d-9b46-6d7e59d8afb2/已粘贴的文本.txt`。STOP/BALVEL0.037/0.0009/3/ARM均OK。协议头/启动前220ms缺失，中段B/V确认标定4060/2012、内环8.4/0/0.17、外环0.037/0.0009/3、trim0、60RPM/8000ms及其它设置保持。用户明确后半段“全程松手、无接触”，排除本轮已知的扶杆/碰车/轮/障碍物导致减速，不把减速归为过坎或外力停止。

296条完整T覆盖229234～236994ms。由首V230014/run1000推导ACTIVE起点229014ms，可见运行220～7980ms；中间缺帧，首段不可独立比较初态。所见角度-0.439～+0.176°，最大单轮21.79RPM，未出现增长振荡。

第4～5秒49条T均速+17.25RPM、5～6秒49条+10.29RPM、6～7秒36条+4.77RPM、7～8秒49条+2.07RPM（稳健值+1.86RPM），呈多秒持续减速，而非只挑末点。末T角度-0.176°、速率-0.013rad/s、输出+0.048、均速+0.11RPM、稳健值+0.11RPM、最大单轮0.20RPM，四轮读数均接近0，且仍ACTIVE4，非到时撤驱动后滑行读数。7秒V滤波速度+2.59RPM、积分+0.073°、参考+0.169°，未接近3°限幅。少量低速脉冲和滤波衰减仍存在，末点接近0不等于持续停车已证实。

该轮支持新杆配置下出现自主回零趋势，不能仅由一次不同初态试验精确量化Ki变化的因果收益，也不能声称长期稳摆/原地保持已完成。接近零后是否反向增长或缓慢振荡尚缺数据；固件源码默认Ki仍0.0007，0.0009当前仅串口临时候选。

下一轮不增加或减少任何增益、trim、窗口或标定，仅把同60RPM阈值的时限从8000ms改12000ms，观察零速附近的后续：STOP、BALSAFE60/12000、ARM。不ZERO不烧录，不提高输出/速度阈值，需足够平整无障碍行程。关注回零是否可重复、后续有没有反向加速或振荡，而非只看某一帧为0；若异常增长即停止，不据单次近零就固化新默认或继续提高Ki。

## 15:07，两次12秒试验受地面/碰墙影响，不据尾段加减增益

附件：`C:/Users/14449/.codex/attachments/98615b38-5ebf-4c9c-bdb2-b9350bbc0c7b/已粘贴的文本.txt`。用户明确“第一次地板有点不平，第二次撞到墙停止”。询问第二次墙碰撞发生在打印中还是打印后，用户答“记不清”；因此不把第二轮后段减速或停止归为确定自主回零，也不凭日志猜碰撞时刻。当前候选仍角度8.4/0/0.17、外环0.037/0.0009/3、trim0、60RPM/12000ms；有效B/V确认标定4060/2012和参数，第二轮头确认fw0x103C8028。

串口助手有中途截断/拼接，部分B行不完整，只统计完整16列T和16列V；由V.ms-run_ms分别推导ACTIVE起点370774、401284ms，不能把各段首T都当开始。两轮末T均为起点后11980ms，仍ACTIVE4，不从截止单独确认最终reason或墙碰撞的先后。

第一轮431条完整T从运行1100～11980ms。所见角度-0.879～+0.264°、最大单轮42.53RPM。第3～4秒均速-21.35RPM，7～8秒-17.27，8～9秒-15.54，9～10秒-21.02，10～11秒-24.14，11～12秒-28.51；末T均速-30.02RPM、角度-0.615°、参考-1.334°、输出-0.074。11秒V积分-0.173°、参考-1.100°，未到参考限幅。存在后段增长/摆角变化，但地面不平是已知混杂，不能单独判Ki0.0009自激或将全部漂移唯一归因于路面。

第二轮413条完整T覆盖0～11980ms，初角-0.088°、速率+0.069rad/s。所见角度-0.352～+0.264°、单轮最大23.36RPM。第4～5秒均速+16.99RPM，第5～6秒+19.42，第7～8秒+15.12，第8～9秒+11.33，第9～10秒+6.45，第10～11秒+8.55，第11～12秒+7.26。末T角度0°、输出+0.054、均速+6.50RPM、稳健值+6.88RPM、参考+0.373°。11秒V积分+0.118°，未到参考限幅。由于碰撞时刻不明，完整“无接触”时间窗不能准确划定；该下降趋势不替代上一轮用户确认无接触的8秒回零证据，也不能进一步证明已原地保持或成功恢复碰撞。

不修改当前P/I/D、trim、滤波或标定，不因受扰动结果继续增加Ki或延长时限。下一轮在平整、连续且有足够无障碍行程的位置，同一上电状态仅STOP、ARM，保留60RPM/12000ms，不ZERO不烧录。目标是在无路面/墙约束下观察近零后的保持或反向增长；碰墙时刻无法回忆时保留不确定标记，不反复追问也不捏造洁净尾段。源码默认仍v28 Ki0.0007/8000ms，当前0.0009/12000ms为本次上电串口候选，不能在复位后仅ARM而假设候选仍在。

## 15:14，Ki0.0009十二秒未重复回零，保留内环，外环Ki试0.0011

附件：`C:/Users/14449/.codex/attachments/5afebdf5-739a-4485-903e-ff189bbfff96/已粘贴的文本.txt`。STOP/ARM均OK，fw0x103C8028。首B/V完整确认标定4060/2012、角度8.4/0/0.17、外环0.037/0.0009/3、trim0、60RPM/12000ms、70%输出、0.5°/400ms捕捉和10°/s均保持。用户本轮未另报告碰撞/地面扰动，不把上一轮两次碰撞/路面情况自动套用到本轮，也不声称已经单独确认全程无接触。

421条完整T覆盖739239～751219ms，0～11.98秒。初角+0.088°、速率0，约0.3秒角度短暂到-0.615°，之后可见角度总体较小，所见范围-0.615～+0.439°、最大单轮44.17RPM，未见此前增长振荡形态。中段有缺帧：运行第10～11秒无完整T，不能用插值假装全覆盖或将串口缺帧视为控制暂停。

第2～3秒均速-20.09RPM，3～4秒-13.61RPM，5～6秒-22.85RPM，6～7秒-14.20RPM，7～8秒-16.30RPM，9～10秒-15.36RPM，第11～12秒40条-18.22RPM；末T均速-20.54RPM、稳健值-19.53RPM、角度-0.176°、速率-0.067rad/s、输出-0.095、参考-0.899°。没有持续回零或回零后的保持，先前15:05无接触正向减速至近零不能外推为已完成整定。

9秒V滤波速度-20.72RPM、积分-0.130°、参考-0.897°，未到参考3°限制；不能称积分饱和，也不能仅由I小唯一断言积分不足。角度保持而车速持续偏移，当前先固定角度内环/外环P/trim，不推高输出或试验时限。

下一轮仅将速度外环Ki0.0009试增至0.0011，命令STOP、BALVEL0.037/0.0011/3、ARM。仍60RPM/12000ms，沿用本次标定，不ZERO不烧录；本次串口临时候选，不改变源码v28默认Ki0.0007/8000ms。此为有界单项试调，不预先保证消除漂移；更早Ki0.001在当时不同结构/窗口/阻尼组合出现振荡，当前新杆需独立验证。若后段自行摆动或加速加重，STOP后BALVEL0.037/0.0009/3撤回，不同时增加P/D或提高阈值。

## 15:22，Ki0.0011出现慢速速度起伏未持续回零，退回0.0009并补充新杆几何数据

附件：`C:/Users/14449/.codex/attachments/c8963f50-1173-44de-bc2e-393fea36c011/已粘贴的文本.txt`。STOP/BALVEL0.037/0.0011/3/ARM均OK，fw0x103C8028，完整首B/V确认标定4060/2012、直立8.4/0/0.17、速度外环0.037/0.0011/3、trim0、60RPM/12000ms、70%输出、0.5°/400ms和10°/s。初角+0.088°、角速度-0.004rad/s；与先前取得近零的Ki0.0009记录初态不完全可比，不据单次试验断言Ki变动是全部差异的唯一原因。

551条完整T覆盖1219844～1231824ms，0～11.98秒，后段存在少量缺帧。所见角度-0.439～+0.264°、单轮最大23.32RPM，无明显增长的高频角度振荡。第5～6秒均速+15.72RPM，6～7秒+9.27，7～8秒+7.05，8～9秒+7.25，9～10秒+9.83，10～11秒25条+16.80，11～12秒37条+17.13RPM。末T角度+0.088°、速率-0.001rad/s、输出+0.078、均速+12.41RPM、稳健值+12.48RPM、参考+0.617°；没有回零后的保持，也没有速度过零反向的证据。

11秒V滤波速度+19.96RPM、积分+0.110°、参考+0.848°，远离3°限幅，不称积分饱和。表现是数秒尺度的速度起伏，不能直接称“高频振荡”，也不能在缺少本轮接触说明时唯一认定自激。但相较已有候选未出现可重复的持续减速收益，不把更大Ki固化或继续单向加I。

先撤回Ki0.0009，其余均保持：STOP、BALVEL0.037/0.0009/3。它是此前有用户确认全程无接触、自主减速至近零证据的候选，不是已完成原地稳速的最终值；是否继续ARM仍按正常操作与同60RPM/12000ms观察，不ZERO不烧录、不提高阈值。源码v28默认仍Ki0.0007/8000ms，本次不修改默认固件。

已通过异步问题请求新实心铁棒的转轴到顶端长度、重量（若不知重量可提供总长度/直径）、是否有轴下延伸段，用于复核新杆几何/惯量变化与后续调参范围。仅“实心铁棒”不足以准确重算PID；不承诺单靠杆长/质量就能唯一得到实际电机/摩擦耦合系统的最优增益。尺寸答复待补充。

## 新铁棒尺寸与CAD转轴关系补充

用户粗测约265mm、直径8mm，后指出3D模型在D:/blance_car，转轴应在棒上方。已读取V3参数/源程序/装配说明/两张实际CAD预览，并用CadQuery只读回读assembly.step：横轴中心Z320，原Ø8×Ø6管Z340～600，本体260mm，轴心到管尖280mm，棒端与轴心存在20mm夹座偏移。模型为直立展示（棒在轴上方），自然下垂后轴位于棒上方，同一结构两种姿态。

之前132.5mm重心距是假设转轴在265mm棒端；与模型夹座偏移不符，不再沿用。若265为本体且插到底沿用20mm偏移，则轴到尖285、裸棒重心距轴152.5；若265为轴到尖，则本体245、重心距轴142.5。已通过异步问题询问测量口径，精确尺寸/质量/是否保留旧配重待确认。旧模型仍是铝管+配重，不能假定已更新成实心棒或直接把CAD整体质量用作新结构参数。未改CAD/固件/方向/标定流程，也未发送硬件动作；详见摆杆转轴与重心几何核对.md。

用户进一步明确265mm为旋转轴中心到铁棒末端，并说明连接件很大一部分中空、下垂时重心应偏下。按原模型20mm轴端间隔，条件估计裸棒长245mm、裸棒重心距轴142.5mm；此前132.5mm假设撤回，265为棒本体的152.5mm分支不再适用。实际整体重心需按旋转横轴/夹具/铁棒/磁铁/螺丝等实际质量加权；中空夹具质量较小会将重心拉向铁棒侧，不能按外形或满密度CAD体积估重，固定塔架不算摆动质量。自然下垂时轴在上、重心在下，旋到直立后同一重心在轴上方。已更新几何核对说明，未据这些近似尺寸改PID或方向，未改原始CAD。

## 15:36～15:37，Ki0.0009回退已执行，十二秒仍漂移，外环P试0.038

附件：`C:/Users/14449/.codex/attachments/efc4e8dc-4f0a-4a40-a500-28abf38cf07e/已粘贴的文本.txt`。15:36两次STOP/BALVEL0.037/0.0009/3均OK，15:37另发ARM并OK；随后实际ACTIVE日志，不能误认用户只发BALVEL未启动。fw0x103C8028，B/V确认标定4060/2012、内环8.4/0/0.17、外环0.037/0.0009/3、trim0、60RPM/12000ms、70%输出、0.5°/400ms及10°/s均保持。

423条完整T覆盖2127439～2139419ms，0～11.98秒。初角-0.352°、角速度0。可见角度-0.439～+0.439°、最大单轮24.61RPM，未见明显增长振荡。第1～2秒均速-19.59RPM，第2～3秒-15.48RPM；中段第6～7秒仅7条完整T（角度-0.439～+0.439°），不能把该段均速-6.60当作充分覆盖的稳定低速段或未经确认就判定过坎。第9～10秒27条均速-18.38RPM，10～11秒49条-12.26，11～12秒49条-14.24。末T角度-0.088°、速率0、输出-0.095、均速-14.88RPM、稳健值-14.60RPM、参考-0.733°；仍存在持续残余运动，没有回零后的保持。

11秒V滤波速度-12.62RPM、积分-0.139°、参考-0.606°，未到参考3°或输出70%限制。相较若干更早负向记录末约20RPM，本次幅值较小，但初态/缺帧不同，不能据此精确判定回退Ki的改善幅度，也不把小摆角等同原地整定完成。

已核对新杆CAD关系：轴心到棒尖粗测265mm，连接件中空；仅由这些几何信息不能唯一识别电机/摩擦耦合的最优PID，也不据此反转控制方向。暂固定内环8.4/0/0.17、外环Ki0.0009与trim0，不继续增I。

下一轮仅试速度外环P0.037增至0.038：STOP、BALVEL0.038/0.0009/3、ARM，保持60RPM/12000ms、同标定、三点窗口和其它设置，不ZERO不烧录。较早0.038在当时窗口/阻尼/硬件组合下出现过振荡，不能忽略；当前杆/窗口/阻尼不同，故仅作保留退出限制的单项试调，未预先确认稳定。若出现自行抖动或加速更重，STOP并回退BALVEL0.037/0.0009/3，不同时推高I/D或限幅。本次不修改固件源码默认值。

## 15:46，P0.038保持小摆角，启动通道3大幅突跳；按用户实物观察优先检查计数

附件：`C:/Users/14449/.codex/attachments/a202aad5-5e6f-45ae-924b-69fbe72c1771/已粘贴的文本.txt`。STOP/BALVEL0.038/0.0009/3/ARM均OK，fw0x103C8028。B/V确认标定4060/2012、内环8.4/0/0.17、外环0.038/0.0009/3、trim0、60RPM/12000ms和其它设置保持。575条完整T覆盖2677444～2689424ms，0～11.98秒，所见角度-0.439～+0.352°，未见旧配置P0.038那样的明显增长振荡。约第3～4秒均速-19.44RPM，第8～9秒-10.12，第9～10秒-6.76，第10～11秒-7.22，第11～12秒-10.96；末T均速-13.02RPM、参考-0.554°，仍无持续回零，不据本轮继续加P/I。

120ms时仅fast3报+49.45RPM，其余约0.2～0.56；960ms时fast3+229.45RPM，其余-0.02/0/-0.23，算术均值+57.30RPM、稳健值-0.01RPM、输出-0.020、参考-0.016°。用户先答刚开始可能手没移开，随后明确更正“应该不影响，就是单纯的检测错误，因为速度没这么快”。据最新观察将该值按疑似测速异常处理，不能把接触当作真实229RPM的证明，也不能从日志唯一确认硬件根因。外环中间两路估计已屏蔽该单路离群，但原始计数仍需查。

只读检查原A相EXTI入口每次IRQ即按当前A/B电平加减，没有检测A电平变化/短脉冲。暂停增益试调，v29加入四路100μs非阻塞电平确认：重复A采样不重复计数，短返回脉冲成对取消；存B方向、延后确认，控制任务与ISR互斥且跳过待处理EXTI位。没有忙等，没有改轮位/符号/增益/阈值，没有自动操作硬件。E19列每约1秒在ACTIVE中输出irq/ok/glitch/dup四组原始索引诊断；T16/B25/V16保持，全量CSV_V12。

新增生产滤波和GPIO包装回归（含同电平1000IRQ、500短脉冲、正常280RPM四路正反转、排队EXTI竞态及周期回绕）通过，原直立/速度外环、命令及日志回归通过，ARMCC5全40源警告视错误构建成功。正常KeilHEX/AXF已同步，未烧录。Code40552/RO4144/RW712/ZI19600，RAM20312字节。首日志包831/2048、最坏GET1261/2048，TRACE估算<=6100字节/秒。新确认带来低速最多约一控制周期计数延迟，不能把主机通过当成已实车修好；较长假脉冲或B相问题仍可通过，后续看E与T。

v29下载后源码默认仍P0.037/Ki0.0007及8000ms，因此恢复本轮候选需STOP、BALVEL0.038/0.0009/3、BALSAFE60/12000、ZERO；ZERO自然下垂后自动等顶端400ms，第一份头应fw0x103C8029。下一轮保持增益，优先确认诊断和尖峰变化，不改接线、不上调保护。细节见编码器毛刺与重复中断检查.md。

## 16:04，旧v28延长24秒可恢复手碰扰动，仍漂移，v29尚未在本轮验证

附件：`C:/Users/14449/.codex/attachments/004f04cf-c5bf-4061-99ad-6560e2009df9/已粘贴的文本.txt`。STOP/BALVEL0.038/0.0009/3/BALSAFE60/24000/ARM均OK。用户报告“我中途用手碰了一下基本上也不会倒了”。日志头明确fw0x103C8028、无E行，因此不能把本轮表现归功于刚完成的v29计数确认/滤波，也不能据此说测速异常已修复。当前本地源码/正常HEX仍为v29，已验证其构建和文件同步，未代用户下载硬件。

B/V确认标定4060/2012、内环8.4/0/0.17、速度外环0.038/0.0009/3、trim0、60RPM/24000ms、70%输出、入口0.5°/400ms、10°/s。1133条完整T覆盖3768044～3792024ms，0～23.98秒，中间少量缺帧。约10.12秒起可见摆角骤变，最低-2.637°（约10.16～10.18秒），与手碰描述相符，但未让用户确认精确接触时刻，不把所有后续噪声也归为触碰。输出最高附近+0.387、没有达到70%限幅；随后可见摆角逐渐回到小幅范围，17秒以后可见-0.352～+0.088°。整段可见角度-2.637～+0.703°，说明本次小扰动后保持了角度控制，不能外推任意幅度扰动或长期安全。

扰动前多秒均速约-19～-25RPM；第10～11秒观测均速+23.44RPM，车速随扰动转向，不能称自主过零回正。后续大多+9～+17RPM，第23～24秒49条T均速+9.97RPM。末T角度0°、速率0.006rad/s、输出+0.059、均速+9.41RPM、稳健值+9.38RPM、参考+0.408°。23秒积分-0.024°，仍远离3°参考限幅。角度抗扰已有本轮实物/日志支持，但原地稳速仍未完成；末行ACTIVE，截止接近24秒不能独立确认最终reason。

原始单轮峰值72.58RPM，包含约12.34秒fast3+72.58、其它三轮约5.4～12.4（稳健11.27）的离群形态；15秒附近还有fast3正负单路离群。它们与10秒附近四轮一致的真实车速反转不同，旧稳健外环仍抑制其影响，但无E诊断不能进一步定位输入毛刺。没有将60RPM保护改成更高值；20ms采样超过阈值不等于已确认内部连续50ms超速。

保留当前控制增益作为候选，不继续提高P/I/D。下一步先下载已完成的v29验证计数确认，恢复用户本轮最新时限24000ms而非默默退回12秒：STOP、BALVEL0.038/0.0009/3、BALSAFE60/24000、ZERO；其余源码默认与本轮一致，ZERO自然下垂且重启后必需，随后顶端400ms自动捕捉。第一份头应0x103C8029且包含E。这个软件测量链变化仍可能引入低速约一控制周期延迟，不能预设实车更好；保持增益进行对照，后续依据E/T再调零速。

## 16:10，v29输入确认实车生效，24秒近零后无接触反向增长，试减外环I

附件：`C:/Users/14449/.codex/attachments/a39b5af6-6874-4699-b007-1a5067d8cbbe/已粘贴的文本.txt`。STOP/ARM均OK，完整头确认fw0x103C8029，E19列/100μs确认已输出。B/V确认标定4061/2013、内环8.4/0/0.17、外环0.038/0.0009/3、trim0、60RPM/24000ms等保持。新启动零位较上一轮4060/2012差1计数，不把所有跨轮差异都归因于滤波。用户针对16～17秒反向前后明确“全程无接触、地面平整”，因此不归因于碰手/墙/过坎。

744条完整T覆盖106014～129994ms，0～23.98秒，中间缺帧较多，尤其运行第1～2秒无完整T，不能插值声称全覆盖；有效V可补1秒级状态。所见角度-0.439～+0.703°，最大单轮35.73RPM，未见此前同通道229RPM那种大尖峰。

E起点106014与最后129014（23秒）之差：原始编码器0，IRQ+2175/ok+2175/glitch+0/dup+0；原始1，IRQ+2385/ok+2384/glitch+0/dup+0（可有一个候选待确认）；原始2，IRQ+2216/ok+2186/glitch+4/dup+22；原始3，IRQ+2339/ok+2249/glitch+16/dup+58。原始2、3确有输入被拦截，支持新机制正在工作；启动前已有的累计264/532等不能当成本轮新增，也不能仅凭一次尖峰缺席就确认物理干扰根因已消除。16～17秒原始3还有glitch/dup集中增长，但稳健车速及其它三轮同向的反向运动不由单路伪尖峰即可解释。

第5～6秒均速+12.29RPM，6～7秒可见+13.38，第11～12秒+6.26，第12～13秒+6.35，第15～16秒21条+2.63。16秒V滤波+1.06RPM、稳健+0.03RPM、积分+0.125°、参考+0.165°，处于近零。随后第16～17秒49条均速-3.01RPM、角度到+0.703°，第17～18秒-18.24，第18～19秒-23.48，第19～20秒-28.96，第23～24秒-20.14RPM。末T角度0°、速率0.026rad/s、输出-0.127、均速-23.00RPM、稳健值-22.52RPM、参考-0.838°。说明零速后自行反向增长，尚未实现原地保持；不是只靠最后帧或正负号翻转作判断。

积分在16秒+0.125°，17秒仍+0.123°，20秒+0.061°，23秒-0.006°；均远低于3°限制，不称积分饱和，也不能从一条曲线唯一归因为I导致。不过该慢速过冲在确认无外扰条件下发生，因此先不继续加P/I。保留直立角度内环和外环P0.038，只将速度外环Ki0.0009减到0.0006：STOP、BALVEL0.038/0.0006/3、ARM。沿用v29、同标定、trim0、60RPM/24000ms，不ZERO不烧录。目的观察近零后的反向增长是否减轻，而非保证降I消除漂移；若变差则STOP并回退0.038/0.0009/3，不同时改输出/保护或源码默认。

## 16:13，Ki0.0006试验过坎后持续摆动，先恢复候选，不能唯一归因减I

附件：`C:/Users/14449/.codex/attachments/f72b143c-883b-4b66-bb59-d40e90042f50/已粘贴的文本.txt`。STOP/BALVEL0.038/0.0006/3/ARM均OK，fw0x103C8029。B/V确认标定4061/2013、内环8.4/0/0.17、trim0、60RPM/24000ms和其它配置保持。助手询问末段约11～12秒有无接触/过坎，用户明确“有过坎”。因此末段为含已知地面扰动的响应，不能把与前轮不同的尾部全部归因Ki下降或定性无接触自激。

552条完整T覆盖319899～332039ms，0～12.14秒，不是完成24秒。初角-0.088°。第1～2秒均速-23.17RPM，第3～4秒-31.64，第5～6秒-25.82，第8～9秒-27.72，第9～10秒-24.06；过坎前已存在持续负向漂移，没有形成接近零后保持的对照，不能声称低Ki已经改善回零。约11秒后可见数次快速摆动，周期约0.2秒量级，所见角度-1.230～+0.879°；末T均速-60.33RPM、稳健值-65.23RPM、单轮最大66.71RPM、输出-0.245、参考-1.971°。本轮最高单轮71.03RPM，多路同时增长，不是单一编码器离群就能解释。未见扰动后恢复，末帧仍ACTIVE4，无最终reason；可能随后触发50ms超速退出，但不能只凭20ms采样确证，不称24秒到时退出。

E从起点到最后12秒快照：原始0 IRQ+2270/ok+2267/glitch+1/dup+1；原始1 +2419/+2415/+2/+0；原始2 +2590/+2243/+90/+167；原始3 +2370/+2321/+11/+26。输入确认仍有拦截，尤其末段原始2毛刺/重复事件较多，但不直接等同硬件根因或全部车速为假；多数轮同向增速和明显真实摆角仍需按整车扰动响应处理。

本次结果更差，但因过坎混杂，不作“Ki0.0006本身一定导致自激”的因果结论。恢复此前有较长小摆角记录的候选Ki0.0009，保持P0.038、角度8.4/0/0.17及其它全部设置：STOP、BALVEL0.038/0.0009/3、ARM。不ZERO不烧录、不提高输出/速度/时间阈值，仍60RPM/24000ms。后续先在平整连续路面观察自身零速问题，过坎抗扰应另作明确标记的试验。当前Ki0.0009也仍未解决无接触回零后的反向增长，不把回退写作最终整定成功，本次不更新源码默认。

## 后续功能：保持倒立的目标速度与直走停车返程，v30

用户确认要“保持倒立，让小车按目标RPM前后行驶”，进一步要求一段“直走停止倒走回原点”程序；随后要求退出窗口稍放宽，并明确启动捕捉为±1.4°。实现v30（0x103C8030）：捕捉±1.4°连续400ms，退出阈值±25°（不是误差不控制区）；启动/退出仍基于原始角度和旧有效性/间隔检查，未把所有轻推保证为可恢复。

新增BALSPD signed_rpm，仅ACTIVE且速度外环启用时接受，目标范围±30且不超过超速阈值一半，10RPM/s斜坡，外环改用实测RPM减斜坡目标；不清已有速度PI积分。BALSPD0取消自动流程、保持倒立零速目标；STOP仍撤驱动。普通FWD/REV/MOVE保留退出直立的旧语义。

新增BALSEQ [rpm turns pause_ms]，默认8RPM上限、输出轴平均0.25圈、停稳2000ms。状态OUT→PAUSE→RETURN→HOME；确认后四路带符号编码增量平均里程，启动时将相对起点设0。位置P起点20RPM/圈，在给定速度上限内形成目标；位置误差≤0.02圈、滤波速度≤2RPM连续400ms才切换到位阶段。停车要求连续停稳达到pause_ms，受扰重新计时；回0后继续原点保持。参数验证、停止/模式切换/故障取消、NaN防护与总时限保留；BALSEQ不续期ACTIVE总时限，未自动修改阈值或驾驶硬件。打滑/轮径差/偏航会导致实际位置误差，未经实车验证，不能将此代码称精确二维回原点。

源码默认同步最近候选8.4/0/0.17、外环0.038/0.0009、60RPM/24000ms、70%、slew10、trim0。为了首轮流程留时间，使用说明给出显式在ZERO前BALSAFE60/60000；仍需每次上电ZERO，捕捉进入ACTIVE后再BALSEQ，不上电自动跑。编码器v29确认不改，T/B/V/E旧列保持，P9列约100ms记录目标/斜坡/速度误差/位置/目标/阶段；全量CSV_V13，TRACE_V2的T16不变。

控制/运动/串口/日志回归与ARMCC5全量40源构建通过，未自动烧录或执行实车。运动测试涵盖完整双向阶段、停车计时受扰重启、HOME保持、停止/普通行驶取消、边界/NaN/回绕以及不刷新原超时；这些为状态机验证，不是被控对象实车收敛证明。Code41856/RO4404/RW752/ZI19600，RAM20352/20480（含预留堆栈）、ROM47012。日志首包970/2048，最坏GET1324/2048，精简流估算≤7300字节/秒。正常Keil HEX/AXF同步，v29备份before_balance_motion_v30；使用与限制见直立直走停车返程测试.md。

## v31：持续直立与差速转向

用户要求长时间直立并实现转向。实现0x103C8031，默认g_bal_max_run_ms由24000改0，BALSAFE允许0或500～60000整数ms；0只关闭到时退出，原超速60RPM/50ms、±25°角度、无效传感器和控制间隔等检查保留。未增加自动驾驶、任务或动态分配，未改角度/速度PID和映射。±1.4°/400ms捕捉不变。

BALTURN±10RPM，单位为左减右轮速差的一半，正右负左。仅ACTIVE且速度外环开启接受；10RPM/s目标斜坡，四轮fast按本车左右映射组成差速量，50ms低通，P估值0.003、差动上限0.08。混合先保留原共同直立输出，再按剩余输出空间给差动，不作角度转弯保证。BALSPD不清转向，非零BALTURN取消原一维BALSEQ并将平移目标0，BALSEQ要求转向目标及斜坡均0；STOP/ARM/ZERO/退出清零所有转向。新Y8每100ms与P一起输出，旧T/B/V/E/P列不改，CSV_V14。

主机逻辑回归、命令/包边界和生产DMA/PWM回归通过；不限时跨uint32回绕120秒只是注入直立传感器的代码测试，不是实车120秒成功。ARMCC5全量40源警告视错构建通过。Code42804/RO4516/RW776/ZI19600，RAM20376/20480含预留堆栈，ROM47456。首包1072/2048，最坏GET1376/2048。正常HEX与构建HEX SHA256均EB8AF104FEE3387BEA85F0DD58E2EEE82FCE9B3A1F215029CF7EAEEF6BC36A3F。v30备份before_balance_turn_v31，实车待用户烧录、确认左右转与长期漂移，不把取消试验时限当成已解决长期稳定。

## v32：低速周期/高速计数混合测速及转向P0.008

用户报告目标0时仍前后跑、转向困难，询问是否编码器分辨率原因，随后明确要求直接修改源码。原A双边沿11×2×21.3=468.6计数/输出轴圈，5ms内1计数对应原始25.61RPM，1RPM约128ms/边沿。旧20ms计数低通后四轮中间两路融合可能低估异步稀疏脉冲，不等于低于25.61RPM无法测。原转向P0.003在BALTURN5且差速0时只给每侧±1.5%差动，未达到8%限幅；本轮默认改0.008，每侧起点4%，未增加积分或起转冲击补偿，仍待实测。

实现0x103C8032：只在100us确认通过时记录原候选DWT时间和同方向相邻周期；ISR不做浮点/除法，新增共享状态volatile。任务临界区采样当前周期/时间/方向、出临界区做浮点；低于100边沿/秒用周期，100～300连续混合，高于300用5ms计数，输出20ms低通。首边沿或反转首边沿回退计数；无新边沿时按age拉长有效周期，250ms无确认边沿使旧周期失效锁存。极慢低于约0.51RPM仍退回稀疏计数，不能称分辨率限制已消除。原计数g_speed_fast与T的fast/mean保留供超速检查；混合测速g_speed_estimated_rpm按电机顺序用于普通速度PI、直立外环和差速转向。捕捉1.4°/400ms、25°退出、不限时、原PID/限幅/轮位符号保留。

新增H6行每100ms在P/Y后输出四轮混合RPM，旧T/B/V/E/P/Y列数不改，T.robust和V.rpm来自混合测速融合，CSV_V15/TRACE_V2。仍只ACTIVE输出参数。主机编码器生产包装测试：四轮异步相位1/5/10RPM输入恢复正确均值/中间两路值（仅软件输入，非实车精度），首脉冲、换向、停止衰减和250ms失效、毛刺拒绝、DWT回绕与混合边界通过。控制回归确认混合仅1RPM时原计数70RPM持续50ms仍超速退出，混合NaN退出；旧控制/运动/命令/日志回归通过，ARMCC5全40源警告视错构建通过。

Code43332/RO4516/RW780/ZI19652，RAM20432/20480含预留堆栈，ROM47984。新增共享周期36字节+映射混合速度16字节，无新任务、堆分配、等待或接线变更。首包1134/2048，最坏GET1411/2048，全量流估算9196B/s。正常KeilHEX与脚本HEX SHA256均5B774A9904060447EF65C0F0D140519A8053371E41C3D97611F728A7BFEE2182；v31备份before_hybrid_speed_v32。未烧录/开电机，先上电ZERO、零速观察，再单独BALTURN5及BALTURN0试转，回传T/P/Y/H继续判断，不把编译/测量单元测试当作已解决实际慢漂与转向。

## 18:36，v32转向目标生效但差速不足；v33转向PI/80%输出/±30°退出

附件25878046-e9a6-45e0-91cd-b9202997e09b。第一次18:36:50 BALTURN5早于ACTIVE为NOT_READY，第二次18:37:01为A,6,OK,BALTURN，之后Y目标/斜坡到5。fw32，cal4060/2012，原PID和外环正确。Y236/H236/T1127/V24/E24完整行；Y稳态92914～111814的190行，差速半差均0.79RPM，目标5，差动平均约3.37%（并未触8%限幅）。H显示通道2相对其它轮更明显减速，但多数轮仍负向；不能仅归结命令没接受，也不能单凭编码器确认机械摩擦根因或实际航向。最后V滤波-6.81RPM，速度积分-0.188°；仍有整体负漂，未验证静止，末T仍ACTIVE不能推定退出原因。

用户追加“输出限幅也大一点，退出控制角度改为180±30°”。实现0x103C8033：共同直立限幅70→80%，差动上限8→12%，退出±25→±30°（150～210），捕捉±1.4°连续400ms及不限时不改。原P转向没碰限幅，仅改上限不会自动增加输出，因此加入Ki0.010（Kp0.008保留）。实际dt积分、有余量跟踪和条件冻结抗饱和，P+I仅能用共同输出剩余空间；中立/方向反转/停止/重启/故障清旧I，斜坡未进入新方向不积旧方向误差。新增BALTURNPI kp ki，0..0.02/0..0.05，ACTIVE可用，清I保留目标。直立8.4/0/0.17、速度外环0.038/0.0009、混合测速和原计数超速60/50ms保留。

Y在8列后追加ki/i为10列，其余T/B/V/E/P/H不变，CSV_V16/TRACE_V2，仍只ACTIVE参数打印。生产控制/运动、串口/日志回归及ARMCC全40源警告视错构建通过；新测PI持续误差增长、冻结积分、共同饱和跟踪、停止/反转/重启清I、无效Ki、30°退出和80%混合限幅。未烧录或执行实车，不把测试通过当作实际转向/长期平衡成功。

Code43648/RO4608/RW788/ZI19652，RAM20440/20480含预留堆栈，ROM48396。首包1154/2048、最坏GET1426/2048、全量流估算9347B/s。v32备份before_turn_pi_v33，正常及脚本HEX SHA256均3A1E4DB3A6DF7911A4D2ADFD667393618748FD389C7E128BE79E2D122BF91953。完整解释/操作在docs/转向积分与30度退出.md。新上电需ZERO，看到ACTIVE参数打印后再单独BALTURN5，回传T/P/Y/H，不再在等待捕捉时提早发转向。

## v34：用户要求四轮平均里程的位置0保持

用户希望记录编码器平均里程，设置位置为0并配合速度环尽量保持0附近。已有v30 BALSEQ提供平均确认计数和回程位置P基础，扩为独立保持，0x103C8034。新增BALPOS rev（绝对目标±5轮轴圈，不修改累计位置）、BALHOLD（目标设为当前位置、原点不变）、BALPZERO（当前位置明确设新0并保持，不清g_enc_count/E）、BALPOSCFG kp max_rpm（0.1..60/1..15，默认20RPM/圈、6RPM）。进入保持复用P.seq_state5，位置目标g_bal_seq_goal_rev、反馈g_bal_position_rev；实际位置误差经P和限幅、原10RPM/s斜坡产生速度请求，再沿现有速度/角度环控制。位置不加I/死区，不直接叠加电机输出。

仅ACTIVE/速度外环开启、转向请求及斜坡均0时接受位置命令；NOT_READY和非法参数原子拒绝。目标变化保留速度I、斜坡和运行时限，不把每条BALPOS0变成重设原点。非零转向或BALSPD/普通行驶/STOP/故障取消保持；ARM/捕捉以及旧BALSEQ启动仍按原规则重设里程0，位置模式不自动恢复。位置单位不擅设轮径，用户可先BALPZERO一次，随后目标保持0；反复置零会让原点跟车移动。转向后为一维新方向，可停转再BALPZERO，不能声称打滑/转弯后仍精确回到二维原点。

延续v33角度8.4/0/0.17、速度0.038/0.0009、转向0.008/0.010、80%共同/12%差动、±1.4°/400ms捕捉、±30°退出、60RPM/50ms超速、不限时和v32混合测速。新增g_bal_pos_kp/max_rpm共8字节，日志O5每100ms给保持参数和目标减反馈误差；P已有位置/目标/模式，T/B/V/E/P/Y/H列数不变，CSV_V17/TRACE_V2，ACTIVE-only参数流保留。

新生产位置逻辑回归验证正反偏差、微小误差不忽略、速度限幅/保护头部余量、保留原点/I/斜坡、保持当前位置/显式置零、转向/速度/往返切换、停止和ZERO取消、边界NaN、原时限不续期及tick回绕；旧控制/转向/命令/日志回归通过，ARMCC5全40源警告视错构建通过。未烧录/操作实车，不能称位置已实车收敛；需要位置P/速度PI继续整定。

Code44236/RO4784/RW796/ZI19652，RAM20448/20480含预留堆栈、ROM49168。首包1210/2048、压力GET1454/2048、全量流估算9633B/s。正常Keil与脚本HEX SHA256均B3408D9A62A43C9BAA2468FF6DB3D5549A955547621AAA837062C75E8E5CA6AF。v33备份before_position_hold_v34；完整操作docs/编码器平均里程位置保持.md。下次新上电STOP/ZERO，进入ACTIVE后BALPZERO，仅一次置当前为0，回传完整P/O/T/Y/H等日志调节。

## 19:27，v34位置保持推车后停止：疑似原60RPM超速退出，待Watch确认

附件f05d70e2-550e-4461-8702-ebb7d27621a9/已粘贴的文本.txt，fw0x103C8034。第一次BALHOLD在ARM前为NOT_READY；ARM成功后，19:27:30第二次BALHOLD为A,5,OK，P从MCU80329开始seq_state5、goal1.031，说明实际保持的是当时当前位置1.031圈，不是位置0，符合BALHOLD语义。无需把第一次拒绝当成本次末端退出原因。

可用完整记录T1121/P288/B30/V30/E30/H288。ACTIVE起点约72028（V.ms-run_ms），末T104029约32秒；HOLD起点80289（P.ms-stage_ms），末保持约23.74秒。位置P20/上限6，角度8.4/0/0.17、80%、±30°、外环0.038/0.0009、超速60RPM/50ms，不限时，实际参数正确。

末段103829时均速+25.91，103929角度1.318°、均速+7.42，103969角度2.725°、均速-32.35/峰39.11，103989角度2.813°、均速-50.16/峰58.76，104009角度2.725°、均速-60.84/峰72.05，104029角度2.285°、均速-65.41/峰77.49。末四轮原计数速度[-71.90,-51.20,-77.49,-61.06]，混合[-71.77,-51.13,-77.41,-61.00]，不是孤立一轮离群峰。末原始角2038相对顶2014为2.109°；所见整轮角度-1.318～2.813，没有观察到30°越界；时限0排除设定到时退出。

因此末段停止最符合60RPM持续50ms超速退出，但最后帧仍BAL_ACTIVE4/reason0，按用户ACTIVE-only参数流策略未输出最终reason，且所见两帧>60只相隔20ms，不能从20ms日志确证连续50ms。已通过异步输入询问用户退出后、再次ARM/ZERO之前Watch的g_bal_reason与g_bal_overspeed_ms；reason8和overspeed_ms>=50才能确认。不能把日志截断本身当作确证，也不能反推为角度越界。此轮仅诊断，不修改源码/保护阈值。

位置保持本身也未整定：goal1.031，HOLD前4秒pos1.035～1.209，随后pos下至-0.299，再到1.279，速度多次±25～33RPM，目标限幅6并未限制实际轮速。末推车前仍约25～30RPM正向走。位置P输出仅是速度目标上限，不是轮速硬限或原地成功；推车时姿态纠偏迅速反转加速，可能撞原超速退出。应结合Watch先确定退出原因，再调位置/速度跟踪和抗扰，不能把放宽角度等同放宽速度保护或保证抗推。

## v35：用户要求退出串口打印，超速改200RPM/200ms

用户不方便看Watch，明确要求“直接用打印确认”；随后明确将任一轮绝对速度60RPM连续50ms退出改为200RPM连续200ms。实现0x103C8035：默认g_bal_max_rpm200、公开BAL_OVERSPEED_DWELL_MS200；严格>阈值、达到200ms退出，降到<=阈值重计时。BALSAFE第二项仍是总运行时限，默认200/0，不能将它误当持续200ms配置；旧指令BALSAFE60会覆盖回60。角度±30、捕捉1.4/400ms、80%共同/12%差动、PID、混合测速/原计数保护与位置保持保持。

新增固定28字节BalanceExitEvent单槽，在ACTIVE离开前冻结ms/run_ms/overspeed_ms/peak/max/原始直立偏角/reason/pending/coalesced。在Balance_Update计算elapsed后提前更新观测时刻，原控制间隔/捕捉语义回归未变；raw角先更新到事件槽，pending期间冻结，重新ARM/ZERO不覆盖。人工STOP/模式停止也记录STOP；非ACTIVE的OFF/标定失败不虚构ACTIVE退出。ControlTask不等待串口、不格式化；日志任务临界区Peek，DMA空闲时在参数流之前、命令回复之后单独发#X表头+X11原因行，LOG0和退出后也允许发送，这是用户对原ACTIVE-only规则的明确窄例外；普通参数流仍仅ACTIVE。发布DMA后按事件ms Ack，不重复发；单槽忙时保留最早、coalesced累加后续退出，非无限队列，无额外UART重发保证。

X字段ms,reason,code,peak_rpm,max_rpm,overspeed_ms,dwell_ms,raw_angle_deg,run_ms,coalesced。SPEED8、ANGLE2、SENSOR3、TIMING4、STOP1等直接文字显示。raw_angle_deg是相对最高点0°偏差，非最低点0°绝对角；peak是最近可用单轮峰，不是整轮历史最大。CSV_V18/TRACE_V2，其它T/B/V/E/P/Y/H/O列保持。v34已经发生的退出不能靠新烧录回补，需v35重测手推后回传X及前后日志。

控制/运动/位置/命令/日志及ARMCC5全40源警告视错构建通过。新生产测试检查>200RPM连续195不触发/200触发/等于200复位、原始角非滤波角、冻结值在STOP/重ARM后保留、Peek重复/错误Ack不丢/发送后清、二次退出合并、STOP/角度/时序/传感器原因和OFF静默；格式化X11及LOG0非ACTIVE真实事件链路通过。保留旧各轮双向/时限/uint32回绕等回归，并把旧50ms测试更新200ms。未烧录或操作实车。

Code44608/RO4984/RW796/ZI19676，RAM20472/20480含预留堆栈，ROM49740。事件类型28字节、链接RAM增24（段对齐差异），无新任务/堆分配。参数首包1210/2048、压力GET1454/2048、X<250独立包。正常与脚本HEX SHA256均D99E405309DCB99F5C284648D2D6E1B0441C4F121E478618C197BB55A6AAA6D8；v34备份before_exit_diagnostic_v35，构建日志build_exit_diagnostic_v35.log。使用文档docs/退出诊断与200RPM阈值.md，推荐新上电STOP、BALSAFE200/0、ZERO，ACTIVE后BALPZERO重测。

## v36：默认进入点位置保持，捕捉改180°±8°

用户要求默认保持当前位置，只用手扶到180±8°进入倒立程序，并纠正输入为“倒立”。实现0x103C8036：g_bal_entry_deg从1.4改8，仍连续400ms；成功捕捉进入ACTIVE、reset_velocity并将进入时平均里程设0后，默认调用已有Balance_HoldPosition(1)启用目标0保持。原点只捕捉一次，不随每轮位置反馈重置；重新ARM/捕捉以新的进入点为原点。上电仍需ZERO最低点标定，不能未经标定驱动。保留显式BALVEL0/0关闭速度外环的语义，该模式下不强行开启位置保持。

退出±30°、200RPM/200ms、80%共同/12%差动、位置P20/速度上限6RPM、原角度/速度/转向PI、X一次性退出诊断均保持。手动BALPOS/BALHOLD/BALPZERO继续可用但启动不再需要；BALSPD或非零BALTURN依旧取消位置保持，退出后不自动重新捕捉，需ARM。HELP改为新默认流程。CSV_V18/TRACE_V2格式不变。

生产边界回归验证8.01°不捕捉、7.99°395ms不足/400ms成功自动state5、初始pos/goal0、无位置命令时正反偏移回正、原点不随循环改写、重新捕捉新原点、角度-only显式关闭外环不auto-hold；原控制/速度/转向/位置/退出及命令回归通过。ARMCC5全40源警告视错编译成功，未烧录或执行实车；±8°开始和原地保持的实际收敛/抗扰仍待验证。

最终Code44616/RO4980/RW796/ZI19676，RAM20472/20480含预留堆栈、ROM49740，无新增RAM/任务/堆分配。正常KeilHEX/AXF同步，HEX SHA256 A30904A878113D07944DE58A2661605F98DDA0B7A734669663CD1855D607BCC7。v35备份before_auto_hold_v36，构建日志build_auto_hold_v36.log，操作文档docs/自动捕捉与当前位置保持.md。推荐上电静止下垂ZERO，成功后扶到172～188°连续400ms即进入并自动守进入点，不必发BALPZERO；故障退出后ARM再扶起。

## 20:25推摆杆，v36明确超速退出；用户转为优先原地旋转，v37新增SPIN保持

附件3d70cad2-01b9-4221-b430-d8cf79276d1c，fw36。用户说“这是推一下”，异步回答推的是“摆杆”，未明确其它外部接触。自动保持state5/goal0、内环8.4/0/.17、外环.038/.0009、P20/6、捕捉8/400、限幅80/12、200RPM/200ms正常。捕捉初角+2.021°。约10139～10299ms（运行约1.9～2.1s）角度-0.615→-6.943°，均速-7.03→168.33RPM；10399位置目标已-6而斜坡仍+1.64，11199斜坡-6但滤波速度+119.68，外环参考约10539后持续+3°限幅。速度I约-.013°不属于积分饱和。中段一度降到41RPM后又增速，输出反复.80。最终X,13089,SPEED,8,204.85,200.00,200,200,-14.326,4891,0明确200RPM/200ms退出，非30°角退出；末P位置6.496/目标0。不能将此多轮共同高速增长归因11线低速粒度或静态零点偏置。

用户明确主要想原地转弯，并问是否应细调零点、11线是否太低。已解释角度ZERO/BALTRIM与里程0不同；468.6计数/轮轴圈而非轮轴11格，单计数.768°，极低速确有粒度/观测等待；先取无推杆静止段判定角度恒偏和速度跟踪，不能用推杆瞬态盲调trim。原BALTURN会取消自动位置保持，是原地需求的软件缺口。

实现v37 0x103C8037新增BALSPIN±10，单位左减右半轮速差RPM。首次进入时保留当前里程数值、锚点设为当前位置，不清编码器或里程坐标原点；state6同时运行位置P与差速PI，重复正/负/0请求不挪锚点。SPIN0只撤转向请求并继续守锚点，保留速度与转向斜坡/I历史（转向0或反向按旧逻辑清yawI）。位置目标限幅进一步扣除yaw目标，使目标绝对值总和仍在既有半超速阈值余量内。普通非零BALTURN仍取消所有位置模式；BALSPD取消SPIN并保留旧转向目标语义。STOP/ARM/ZERO/故障清Spin，重新捕捉回普通自动HOLD5，不自动恢复旧转向。无航向/二维定位，平均净里程约束不保证绝对车身中心不移或转90°。

未改PID、trim0、捕捉/退出/超速/输出阈值和原地P20/6参数；当前零速动态仍需调，新增模式不能称已实际原地转成功。CSV_V19/TRACE_V2，旧T/B/V/E/P/Y/H/O/X列数不变，P.state6辨识SPIN。新增生产回归验证锚点/重复/中立/反向、正反里程纠偏、双目标余量、非法原子拒绝、手动/往返切换、STOP/传感器/配置/超时与回绕；旧全部控制、命令/日志回归通过，ARMCC5全40源警告视错构建通过，未烧录/驾驶实车。

Code44852/RO5068/RW796/ZI19676，RAM20472/20480含预留堆栈（无新增RAM/任务/堆）、ROM50064。正常及脚本HEX SHA256均4B3DCCC34472764B1D7D639E89B84BB341CB655BB9E40B7AE3BA1C7AACC1337C，v36备份before_spin_hold_v37，构建日志build_spin_hold_v37.log，docs/原地转向与零点整定.md说明。下一步先在平整地面不推杆记录零速段，再单独BALSPIN2，BALSPIN0停止旋转保留锚点，回传完整日志与实际方向判断；目前不能凭此轮决定trim符号或认定编码器必须换。

## v38：无外力SPIN10前后往复，修正原地模式的速度融合权重

附件2e5c7a16-cee3-49a5-8fdf-62a759ccab20。用户反馈一直乱跑着转弯，并异步确认全程落地、松杆、无碰车/过坎/障碍。片段无版本头/命令ACK，不声称精确fw已确认；P.state全6、Y请求/斜坡10，确实SPIN。T1132/P290/Y290/H290/V29/B29/E29，约95364～124364的29秒；V反推ACTIVE82263，P反推SPIN86749，缺启动静止和2RPM段。

实测半差6.36～16.87，均10.09跟住目标10；前后计数均速-36.45～58.10、平均2.77，角度-1.318～1.758。goal .744固定，pos约-.13～1.902，末偏+1.158；非转向完全没执行，主要是前后往复，未见X且末ACTIVE。H全均值平均+2.84，中间两项均值平均+.29，差值平均+2.55RPM、范围-2.80～8.37。位置按四轮平均累计而速度环在SPIN仍排序取中间两项，合法差速和前后轮不同响应时权重不一致。例H95464[0,5.12,40.82,21.55]真全均值16.8725，中间两项13.335，对应原robust约13.33；这在29秒有约1.23轮轴圈的偏差量级，不能只归零点或11线分辨率。

E原始0增IRQ3610/ok3606/glitch1/dup2；1 4591/4581/1/9；2 6975/3597/953/1472；3 3930/3174/255/246。确认仍拦大量输入，但不能证明硬件干扰已消除。全平均更易受通过确认的单轮假计数影响，保留E/H与原计数保护监测，不能用错误的融合权重掩盖输入问题。

实现0x103C8038：仅SPIN（state6）将平移反馈改四轮混合测速算术均值，匹配里程各1/4权重，再走既有100ms低通；其它模式保留中间两项离群抑制。g_bal_robust_rpm/T.robust/V.robust保留旧名，需按模式解释，H各轮和T原计数保持。CSV_V20/TRACE_V2，字段数不变。不同时改PID、trim0、输出/捕捉/退出/速度阈值或Spin±10输入范围；该轮10是当前上端，下轮建议2对照。已承认此前把直行估算沿用原地模式不合适，修正的是确定的计算偏差，不能承诺所有实际振荡已解决。

生产SPIN回归回放[0,0,33.12,14.19]应11.8275而非7.095，反向符号正确；[-10,-10,10,10]不产生虚假平移，[5,5,25,25]共同分量15；切回普通仍原中间两项。旧全部控制/位置/转向/退出事件、命令/日志回归通过，ARMCC5全40源警告视错构建通过，未烧录或驾驶。Code44888/RO5068/RW796/ZI19676，RAM20472/20480含预留堆栈（无新增RAM/任务/堆），ROM50100。正常与脚本HEX SHA256均CFE68CDCC369D1254957F8AA44CC0845D0F0631A54E64741B0951DF3C2F8766B，v37备份before_spin_mean_v38，build_spin_mean_v38.log，docs/原地转向前后测速均值修正.md。

下一步新烧录ZERO捕捉，先不推杆静止记录，再单独BALSPIN2，数秒后BALSPIN0，回传完整日志与是否窜动。不能由本片段直接决定trim方向，也不把编译/重放测试当作实际原地固定中心成功。

## v39：自动起摆候选与正弦方案参考

用户提供选拔题DOCX：基础项目含小车从静止运动使杆倒立、保持20秒及抗小推扰；扩展正方形边长1.5m、各顶点停留至少5秒。全文没有规定必须原地转90度，也没有给出数值位置误差，评分表还出现正文未定义的条目，不自行补全。DOCX文字/表格/附属文本检查完成，图为赛事标志；本机缺LibreOffice故无法验证分页，未改文档。用户选择先完成起摆，确认杆全程摆动无碰撞，活动范围暂按约2m考虑。

实现0x103C8039能量反馈起摆：新增balance_swing.inc由balance_control.c包含，5ms非阻塞控制，无新任务；校准后自然下垂静止发送SWING，最初150ms有限斜坡激励，之后由归一化能量差和rate*cos(theta)确定加减能，并加净里程回中与车速阻尼。默认SWINGCFG35/2/10000、SWINGENERGY.18/55/2、SWINGDIR+1。theta0最高点，E=.5*rate²/omega2+cos(theta)，目标1.02；omega2基于265mm轴尖距离/旧20mm近轴空段的简化估计，实际惯量和PWM加速度关系未识别，不宣称严格收敛或实车成功。

新增stateBAL_SWING6（不是seq_stateSPIN6）。SWING要求有效校准/角度、距最低点约30°以内、角速度≤.5、四轮新鲜基础测速峰值≤5RPM，非法启动不先破坏原普通电机模式。自动接管要求原始角误差与40ms线性预测角均在当前entry带、角速度≤2rad/s、最近轮速峰值≤90且≤配置超速值；立即接入原ACTIVE与autoHold，不等待手动400ms，保留实际速度作为外环初始值，进入点设0。手动ARM原±8°/400ms、直立±30°退出及PID/轮位/方向均保留。起摆不使用±30°退出，独立超时10秒、净里程±2圈和原200RPM/200ms、传感器/时序/冲突/配置退出有效，TRAVEL新reason10，失败不自动重试。

2m不是已标定边界：轮径未知，±2圈按旧CAD参考65mm只是±.408m示例；平均净圈数不能估算打滑或累计路程。未假设用户已经装麦轮，也未在本轮新增麦轮平移/正方形轨迹。

串口新增SWING/SWINGCFG/SWINGENERGY/SWINGDIR，配置会停止，ZERO后需等待标定结束再单独SWING。起摆默认40ms U17日志，phase1激励2加减能3接管4中止，接管重新打印原TRACE_V2头及一帧U3，然后T20ms；完整CSV_V21，旧列不变，X仍可在停止/LOG0发送。RX搬运临时区256降128而DMA环仍512，5ms服务理论吞吐大于串口线速；控制snapshot与实际state一致才发参数包。

用户问正弦起摆对比，已在线核对主要来源：UiTM2010原论文控制策略A节给出水平小车正弦位置参考+PV闭环伺服并切换顶端稳定器；MIT课程给出车摆能量控制+车体回中，精确最低点需启动激励。IFAC2002论文将周期输入和能量调幅结合，但其支点振动模型不能直接视为本车水平驱动，验证为数值仿真。正弦位移不等于正弦PWM，不能笼统称能量法一定更快或行程更小；基于当前车体伺服仍有波动，先保留能量基线，不同时换两套控制，后续可比较成功率/耗时/行程/顶端速度/接管后表现。来源链接在自动起摆文档。

生产回归通过：原直立/速度/位置/转向/角度处理、swing启动/能量方向/回中阻尼/输出斜坡/接管条件/速度继承/旅程界/时间回绕/各种退出；生产命令新增边界/NaN/失败原子性/129字节后STOP（229字节burst分128+101处理）与原RXDMA故障/环绕；真实电机DMA波形/符号/分数占空比；U列数和带U首直立包1449/2048、完整GET+U1558/2048缓冲压力。软件注入测试不等于实车起摆验证，未烧录或驾驶。

ARMCC5全40源警告视错构建通过，Code47612/RO5396/RW824/ZI19552，RAM20376/20480含预留堆栈，ROM53176。正常KeilHEX/AXF已同步；HEX SHA256 2E740657680BDFDA270CCB8C6AF223E18262BB0C6D279BCED42A18AA14461364，构建日志build_swingup_v39.log，v38备份before_swingup_v39。文档docs/自动起摆控制与调试.md及默认值、命令、标定说明已同步v39。下一步首次自动试验回传从SWING回执开始的U、接管T、最终X，再按实际起摆能量增长和捕捉状态整定。

## 21:49首次v39自动起摆：约72°底部摆幅平台，10秒超时

附件f72e636e-b156-499d-b979-db1ff4649fa3，头确认fw39。STOP/ZERO接受后约6.8秒发送SWING，启动成功；标定bottom4054、upright2006，200点成功。清除串口助手分片时间标签并拼接，得到248条完整U17，仅phase1/2，未出现phase3或ACTIVE接管。

按最低点有符号角解释0/360回绕：0～2秒范围-47.373～38.848°，2～4秒-66.885～68.555°，4～6秒-71.103～71.982°，6～8秒-72.246～72.246°，8～10秒-72.686～72.422°。先加起摆幅，随后收敛到约±72°，距离最高点180°仍约107°，不是顶端接管太窄。末两秒能量约-.350～-.195，而目标1.020；当前模型能量是估计量，不能据此识别实际惯量或精确损耗。末两秒平均轮速绝对值≤40.65RPM，输出绝对值≤.234，配置起摆限幅.350没有持续用满。全程平均净里程约-.121～+.131圈，远未达到±2圈边界。

最终X,34234,RUN_TIME,9,17.66,200.00,0,200,108.984,10001,0明确起摆10001ms超时；无超速累计，不是角度退出。没有接管，所以不调整直立PID、捕捉角或接管角速度，也不单纯延长超时。摆幅增长后平台表明目前有效加能与损耗/控制时序达到平衡；这不能唯一归因增益不足或证明驱动精确等效加速度，但可以先在原35%/±2圈/10秒限制下单独提高能量增益进行对照。

下一轮建议自然下垂且静止后STOP、SWINGENERGY0.30/55/2、SWING；保留所有其它参数，现有标定有效且未重新上电时无需ZERO、无需ARM。无需重新烧录。本轮只记录分析与串口试调建议，未改变源码默认增益.18，未驱动实车。观察是否突破±72°平台、是否接管及最终X，不能预先宣称.30一定成功。

## 21:54能量增益0.30：摆幅提高到约±84°，仍10秒超时

附件0e3f330c-8098-4189-887f-6f83c00e0ac4是累计日志，前半段包含原21:49增益.18试验；后半段21:54:04的STOP/SWINGENERGY.30/55/2/SWING均ACK成功，头确认fw39，U确认实际gain.300，分析必须分组而非混算。新轮重建238条U17，仅phase1/2，无自动接管。

新轮前2秒角范围约-70.664～65.303°，2～4秒-83.760～83.408°，4～6秒-83.848～83.672°，后面维持约±83°。末两秒能量-.191～+.020，目标仍1.020；接近底点时rate约10.5rad/s，转折点仍未越过水平，不能将模型能量偶尔约0误认为最高点能量1。末两秒平均轮速绝对值≤60RPM、输出≤.321，净圈数-.148～+.189；全轮净圈数约-.148～+.309，未触及±2圈边界。较.18轮约±72°和平均±40RPM，增益增加确实提高了运动幅度，但仍形成周期平台。

最终X,296609,RUN_TIME,9,55.76,200.00,0,200,-138.164,10001,0明确10秒超时，非角度或超速退出。不放宽接管带、不调直立PID、不单纯延长时限。下轮在原35%/±2圈/10秒边界内仅把SWINGENERGY增益改.45，omega2=55/capture_rate=2保持；自然下垂静止后STOP、SWINGENERGY0.45/55/2、SWING，无断电无需ZERO、无需重烧录。进一步提高有效输出可作一次对照，但当前直接PWM近似加速度、相位及输出斜坡仍会影响加能，不能保证单加增益解决水平附近的平台。源码默认仍.18，本轮仅记录分析与串口试调建议，未操作实车。

## 21:57能量增益0.45：越过水平，末段摆幅仍增长至约121°

附件85e9a5a1-6968-4254-b08e-25cd8ec91004为累计三轮日志；仅提取gain.450新轮248条完整U17，命令STOP/SWINGENERGY.45/55/2/SWING全ACK，fw39。仅phase1/2，无ACTIVE接管。相对最低点有符号角：0～2秒-58.887～68.818°、2～4秒-92.549～93.164°、4～6秒-94.834～96.152°、6～8秒-99.053～101.426°、8～10秒-114.258～120.674°。与.30的约±84°平台不同，本轮越过水平后仍缓慢加能，末段连续峰约104.9/109.3/114.3/120.7°，尚不能称平台或接管成功。

末两秒归一化能量.138～.670、转折点约.257→.511；目标1.020尚未达到。输出绝对值最高.283且无触及.35的采样，早期0～2秒有20/48帧到限幅。全程平均净圈数约-.097～+.392圈，未触及±2。最终X,480669,RUN_TIME,9,40.35,200.00,0,200,-86.484,10001,0明确10秒超时，非速度/角度退出。最大摆幅120.674是先前峰值，并非X时的实际摆角。

本轮证据支持先仅把起摆时限10秒改15秒观察继续加能，不同时加增益/输出或放宽接管条件。自然下垂且车静止后：STOP、SWINGCFG35/2/15000、SWINGENERGY.45/55/2、SWING。现有固件解析及配置校验支持15秒，已查源；无需重烧录，未断电且标定有效无需ZERO。与前两轮延时无助平台不同，此次后半段能量/幅度仍增长，延时是有依据的单项对照，不保证15秒能成功接管。源码默认仍35%/2圈/10秒/gain.18，本轮仅串口建议与记录，未操作实车。

## 22:02延长15秒：约136°出现平台，下一轮只增能量增益至0.65

附件3a1344d4-a3b1-43b7-a548-ca0e6b46a726，STOP/SWINGCFG35/2/15000/SWINGENERGY.45/55/2/SWING全部ACK，头fw39。按串口助手分片标签拼接后351条有效U17，另2条不完整记录排除；部分接收段实际缺失，不能由此推断控制环停顿。有效数据仅phase1/2，B.state6，无自动接管。

摆角以最低点0°解释：0～3秒范围-86.309～77.871°（本窗有缺帧，不能把此上界当实际峰值），3～6秒-94.922～95.889°，6～9秒-107.930～113.818°，9～12秒-135.176～135.000°，12～15秒-135.703～136.406°。后期半周期转折幅度约132.0/135.0/135.2/136.1/135.7/136.4/135.6°，说明10秒后确实继续加能，但约12秒后又形成平台；最近距最高点约43.6°，尚未到±8°捕捉带，不归因接管角速度或直立PID。

末3秒模型能量.538～.977，转折点约.716～.725，目标1.020。接近底点的瞬时模型能量接近1不等于已经到顶；实际车体加减速、摩擦/延迟及模型误差仍可改变能量。末3秒输出绝对值平均.08324、最大.182，低于35%限幅；平均轮速绝对值≤23.37RPM，净圈数-.019～+.049。全程有效帧净圈数约-.094～+.382。最终X,812354,RUN_TIME,9,14.71,200.00,0,200,-46.318,15000,0明确15秒超时；无超速累计，不是退出角度触发。

下轮保持35%输出、±2圈、15秒、omega2=55与接管rate2，仅把SWINGENERGY增益.45改.65，原指令解析/配置允许到.8。自然下垂且车静止后STOP、SWINGENERGY.65/55/2、SWING。未断电且标定有效不需ZERO，无需重烧录。此为受同一输出限幅约束的单项加能对照，不宣称解决相位/电机加速度近似问题；不再单纯延长本轮已出现平台的时限，不放宽接管带或更改直立PID。源码默认未改，未操作实车。

## 22:07增益0.65：约147°平台，改为单项能量尺度诊断

附件bf89652d-e786-4836-8955-e9efd4a99b74累计含22:02旧轮；仅抽取gain.650的新轮361条完整U17。STOP/SWINGENERGY.65/55/2/SWING均ACK成功，fw39，起摆35%/±2圈/15秒配置保留。只有phase1/2和B.state6，无顶端接管；附件后部存在接收缺段，不能把缺段两端当成真实局部峰值，例如run13166角103.359后缺帧，此点并非摆幅转折。

0～3秒范围-87.627～98.438°，3～6秒-143.613～136.055°，6～9秒-146.426～146.953°，9～12秒-145.811～146.602°，12～15秒有效帧-145.723～145.107°。最大距最低点146.953°，仍离最高点33.047°，没有进±8°捕捉带。较.45轮136°平台提升约10°，但后期连续转折约145～147°基本不再上升，继续仅加增益或延时的依据减弱。

末3秒模型能量.653～1.078，已观测转折能量约.820～.835；输出绝对值平均.08046、最大.184，平均轮速绝对值≤22.60RPM，净圈数-.026～+.041。全程有效帧净圈数约-.084～+.392。最终X,1133449,RUN_TIME,9,22.89,200.00,0,200,-87.188,15001,0仍明确超时，非角度/超速触发。

生产代码复核E=.5*rate²/omega2+cos(theta)，目标1.02，能量差为负就请求减能。例ms1130774、run12326、bottom341.104°、rate-14.921，估计E1.078已高于目标，而相邻周期转折仅约146°。这是能量调节、实际驱动及损耗/模型不匹配的诊断线索，不能从受控运动直接认定实际固有频率平方偏大或传感器错误。当前omega2=55本来就是几何简化初估，未经过自由摆辨识；PWM也未精确等效加速度。在线复核MIT cart-pole energy shaping课程，理想律建立在模型和小车加速度控制上，本车不能照搬收敛保证。

下一轮只把能量尺度omega2从55试到65，增益仍.65，capture_rate仍2，35%/±2圈/15秒不变。相同观测rate和theta代入65时上述E由1.078约变.767，能量项由减能改为加能；转折角速度接近0时势能项几乎不变。这个试验用于检查高速段动能归一化/驱动损耗造成的提前减能，不将65写成已测机械参数，不改变角度标定、退出角度或接管门限。下垂静止后STOP、SWINGENERGY.65/65/2、SWING；现有指令支持，无需重烧录，未断电且标定有效无需ZERO。观察能否突破147°、是否出现过顶过快和接管，不能预先声称成功。源码默认仍未改，未驱动实车。

## 22:12能量尺度65实现自动接管；v40分离动态与手扶入口

附件65101f07-04c6-42d7-bdd9-a458eee01450累计包含历史轮次；新轮22:12:03 STOP/SWINGENERGY.65/65/2/SWING成功。约6秒后ms1371359 U.phase3/B.state4明确已自动接入直立，初始滤波角188.086°、误差+8.086°、角速度-.815rad/s、四轮接近静止，共同输出从接管前-.021跳至-.800。滤波中值滞后使原始角已进8°带而PID角仍8.086；按实际8.4/0/.17增益算未限幅约-1.05，必然打满。约120ms后平均原计数速度约-106RPM，随后反向最高约176RPM，原地保持虽启用但动态没有收敛。

最终X,1372744,ANGLE,2,195.29,200.00,0,200,-30.410,1386,0是接管1.386秒后原始偏角超过30°退出，并非该日志证实超速。用户确认这次碰障碍，末段外力不能用于调PID；另一次未附日志重试反馈追杆时因轮速达到阈值退出，只记录用户现象，未核实精确X。保留原200RPM/200ms，不据此提高阈值或扩大角退出。

实现0x103C8040：新增g_swing_capture_deg=2、SWINGCATCH0.5～4°（修改停止），实际自动接管角取与手动BALWIN入口的较小值；原始角、滤波PID角、40ms预测角都在该自动带内，原角速度≤2和车速≤90/配置阈值条件保留。手扶±8°/400ms保留，原直立/速度/位置/转向PID、autoHold、输出80%、退出角30°和轮位/符号保留；不同时加输出斜坡或改变外环，以便比较入口状态。起摆当前可达顶端的一组.65/65/2、35%/±2圈/15000ms固化为新开机默认；65仍试调尺度而非测得机械参数。

U末尾追加有效capture_deg为18列，SWING_TRACE_V2/CSV_V22，正常BAL_TRACE_V2及旧列数不改。HELP加入新命令并缩短冗余描述，保证8条ACK+HELP仍在2048以内。生产控制测试回放raw7.998/filtered8.086/rate-.815拒绝提前接管，2.01边界/raw-filter差、预测角/速率/车速门槛、两侧小角接管首输出<35%、手动更小入口上界、非法Watch、原速度继承/位置重置/退出和手动400ms回归通过。新命令范围/NaN/缺参/运行修改停机、原RXDMA和退出诊断回归通过；U18、首接管包1466/2048、GET+U1563/2048缓冲回归通过。旧示意植物测试只算软件回归，不是本车动力学稳定性证明。

ARMCC5全40源警告视错通过，Code47752/RO5372/RW828/ZI19548，RAM20376/20480含预留堆栈，压缩ROM53292。正常KeilHEX/AXF与脚本产物同步，HEX SHA256 37DB7A2C704C65DEFA31F5AC2D77028A6587B68DEE532D0768EE9AF0E9F17767。v39备份before_swing_capture_v40，build_swing_capture_v40.log，docs/自动起摆顶端接管修正.md。软件已完成，未烧录或操作实车；新入口实际能否顺利捕捉并保持待下一轮完整日志。烧录后自然下垂STOP/ZERO，等待约1秒，再单独SWING，默认无需重发参数。

## 22:24 v40首次试验：最近离顶端约3.8°，未进入独立2°接管带

附件09639992-6d6d-49a3-801d-39dc1c87d303，头确认fw40/SWING_TRACE_V2，STOP/ZERO后等待约6.6秒发SWING成功。标定200点成功，bottom4059/upright2011；U确认默认.65/65/2、35%/±2圈/15000ms、capture_deg2。重建343条完整U18，只有phase1/2、B.state仅6，没有phase3或ACTIVE，所以不能按接管后追不上或直立PID失稳分析。

有效帧最近点ms16644/run8205：bottom183.779、顶端偏差+3.779°、rate-.050、E.998、u-.009、净圈数.100、平均RPM-.01；相邻帧183.867/rate+.028说明在接近点转回。其它顶部转折依次约190.195、183.779、172.090、185.625、169.805、186.943、174.111，存在接近顶端后反复回落，尚未进±2°带。日志有缺段，不将观测极值当作200Hz全采样精确最小值。全有效帧净圈数-.066～+.396，平均轮速绝对值峰80.79RPM；未据均速宣称各轮实际峰值同样低。

最终X,23439,RUN_TIME,9,0.00,200.00,0,200,7.471,15001,0明确15秒起摆超时，非超速/角度退出。此轮没有检验到新接管后的稳定性，窄入口正常阻止了较大角度接管。仅调整能量尺度65→66作小步加能试验，gain.65、rate2、capture2、35%/±2圈/15秒均保留；相同高速角速度时提高omega2会减小动能估值，增加能量差请求，实际效果仍待验证，不将66称作测得机械参数。下垂静止后STOP、SWINGENERGY.65/66/2、SWING；未断电且标定有效不需ZERO，无需重烧录。先观察是否进入2°带及接管时rate/u，再决定接管整定；源码默认仍65，本轮仅分析和UART建议，未操作实车。

## 用户确认66起摆成功，v41固化成功参数

用户随后回复“成功了”，未附本次完整日志或说明保持时长，记录为自动起摆/接管流程用户确认成功，不推定已达到20秒或多次重复成功。沿既有将调好参数固化源码的工作，将g_swing_omega2默认65改66，版本0x103C8041；gain.65/rate2/capture2、35%/±2圈/15秒、直立与外环PID、手动捕捉、autoHold、方向、退出阈值和协议均不变。66仍实际试调尺度，不宣称识别了真实固有频率。

生产控制/角度/速度/位置/转向/退出/起摆回归通过，新启动默认66断言通过；ARMCC5全40源警告视错构建通过。Code47752/RO5372/RW828/ZI19548，RAM20376/20480含预留堆栈，压缩ROM53292不变。正常KeilHEX/AXF已同步，HEX SHA256 F925C9E8253D302774E2EB6C08EC400DA22E1709A0000298017A913934F592B5；v40备份before_swing_confirmed_v41，build_swing_confirmed_v41.log。未烧录或操作实车，当前运行板无需为继续试验立即重烧；下次烧录v41后默认使用66，仍需ZERO后SWING。后续先保留成功参数，收集成功轮完整U/T/X并验证连续20秒保持及重复性。
