lingkonglengfeng/nanhua-pendulum-car/f103_bringup/docs/直立零速外环与位置保持整定.md

# 直立零速外环与位置保持整定

2026-10-19。用户认为起摆已基本可用，要求停止起摆提速，转向尽量保持不动。仅在原工程调试，不修改学生练习副本。

## 当前起摆与漂移基线

附件ba0f4fc9-4f52-409e-b124-4757c4baf126，fw42，起摆37%/±2圈/15秒、gain.65/omega2=63.5/capture_rate2/capture_deg2。首U ms1673949/run46，推算启动1673903；phase3 ms1680404，用时6501ms。接管误差+1.934°、rate-.425rad/s、输出-.211、均速约0。相较前一37%/63轮7.421秒，本次单次6.501秒，不做总体成功率或最快时间结论。

附件直立段仅2580ms，98条完整T、26条P，末帧完整T偏角-.352°、角速度0、共同输出-.131、均速-27.02RPM、robust-26.60、参考角-1.247°。位置P.state5、goal0、pos-.626、target/command均+6RPM，说明位置环正在请求正向回原点，并不是速度目标一直0。V确认速度外环.038/.0009、角限幅3°、变化率10°/s；O为位置P20、目标上限6RPM。

分半秒统计，0～.5秒均速平均+11.30、.5～1秒-.63、1～1.5秒-19.50、1.5～2秒-29.84、2～2.5秒-28.26RPM。后段速度峰约-33.32回到-27，已有局部减速，不能用短片段认定持续加速、反馈极性错或长期无法回零。没有X，仅能确认附件记录内仍ACTIVE，不能认定保持20秒或位置收敛。

## 下一轮先分离零速外环

起摆配置暂保留成功组。实际进入ACTIVE、开始打印T后发送BALSPD0；当前若仍在ACTIVE也可直接下发。生产Balance_SetSpeed已核对：保持直立和速度外环，设速度请求0，取消P.state5的位置回拉，保留实际测量、斜坡和积分历史，不停止或重设里程原点。应见P.state0、target0、随后command0。不能将此命令与SWING一起在未接管时发出，否则NOT_READY。

先保持外环增益.038/.0009与内环8.4/0/.17，记录BALSPD0回执后的10～15秒完整T/V/P/H/E和实物表现，判断均速是否收敛0、参考角/I是否有长期偏置、是否往复振荡。当前片段只有2.6秒且位置目标不断变化，不同时提高增益和改变控制模式，以免无法判断变化来源。先整定零速外环，再用BALPOS0接回捕捉原点位置目标，或BALHOLD守住当时位置；两者的原点语义不同。

用户此时说的速度环是直立速度外环BALVEL，通过目标摆角控制车体速度，不是普通单轮PID/PIDW。普通单轮速度PI不与直立共同输出并行叠加。目标是先压低车速，再整定位置回正，单纯零速估计不能保证长时间位置不漂。此次仅日志分析与下一轮UART测试说明，未改源码默认、未自动驱动实车。

## 20:43零速请求生效，持续约负50RPM偏移；下一轮仅提高外环P

附件52d080a0-08f5-4d60-a07f-e9f77fc75ebe，开头缺少完整启动指令/头，延续U确认37%/.65/63.5/2。接管ms1980289，角误差+1.934°、rate-1.192rad/s、输出-.081；用户约3.2秒后发送BALSPD0，ACK61/OK，第一条P.state0在1983529，target0、command-3.58正在原10RPM/s斜坡归零，后续target/command均0，位置回拉已取消。不能再把后段偏移归因位置环主动要求行驶。

零速模式第一帧到末T约4.24秒，尚未达到先前请求的10～15秒观察，但已存在持续非零车速。前三个1秒分箱平均约-50.10/-48.46/-47.48RPM；参考角约-1.91/-1.89/-1.91°，角度均值约-.45～-.51°，输出约-.21。外环仍.038/.0009、最大角3°，积分V在捕捉后3/4/5/6/7秒分别+.027/-.018/-.062/-.104/-.145°，没有积分限幅饱和；速度参考末端才到-3°限幅。数据支持当前零速未收敛，但尚不能唯一认定物理平衡点偏差、摩擦或增益哪一项是根因，不反转已实测的符号。

末约0.5秒均速扩展到-100附近、角度开始较大摆动，已异步询问20:43:49～50附近是否无接触/地面平整；回答未到时不把这段当作纯控制本体失稳。无X且末帧截断，不认定已超速或角度退出。最后P位置约-3.508圈仅表示纯零速试验的累计净位移，不能称位置保持已开启。

下一轮维持起摆参数、直立PID及速度I，仅将BALVEL的P从.038提高到.042，I仍.0009、角限幅3，输入范围源码确认P上限.05。先STOP/BALVEL.042/.0009/3，待下垂静止后SWING；接管开始T后尽快BALSPD0，记录零速请求后的完整日志。目的是加强速度误差到目标角的修正，不是直接叠加反向PWM。先比较持续漂移和往复振荡，再决定I或静态偏置；没有同时改位置P或扩大输出/退出范围。源码默认未改，学生副本未动，未自动驱动实车。

用户随后确认该轮“全程无接触、地面平整”。因此末段速度增到约-100RPM附近不能按碰撞或过坎剔除，应保留为本次系统自行偏移/摆动的有效观测。该确认排除了已询问的外部接触条件，但未单独识别控制增益、角度测量、电源或执行机构哪项为根因。下一轮仍只比较P=.042、I=.0009与原P=.038，不同时增加积分或恢复位置回拉，重点检查是否继续出现无外力加速。

## 20:48 P=.042的长记录：车速可过零，但存在慢往复；下一轮仅试目标角偏置

附件d5168443-f177-4d40-9af0-be2c18c99636，fw42，STOP/BALVEL.042/.0009/3均ACK成功，起摆延续37%/.65/63.5/2。首T ms2288294、末T2318434，记录ACTIVE约30.14秒，无X。仅凭串口状态不替代实物无接触说明或判定赛事已通过。完整T891、P232，接管角-1.934°、rate+.992、输出+.115；尾部角-.527°、输出-.099、均速-14.13RPM，仍有漂移。

本轮BALSPD0在接管约11.3秒后才发送，ACK67/OK，P.state0首帧2299634，target0，command+5.70按既有斜坡回0；后续目标/命令均0。命令前已在位置保持模式累计偏移-4.316圈，积分约-.28°；零速试验并非从相同捕捉初始状态开始，不能直接将其和上一轮短记录作严格P改善因果比较。

零速请求后约1～8秒仍有-27～-33RPM，约10～11秒接近0，随后约12～13秒平均+17～+19RPM，再逐渐回到负向；末P位置-8.584圈。V在接管22/23秒的外环速度分别-4.31/+1.74，积分-.523/-.524°，trim0；末30秒积分-.505°。不是超速退出或位置环再次启用，零速度还没有稳定收敛。

去掉命令后初始斜坡段，T样本角平均约-.568°，只对<=200ms相邻帧积分的时间均值约-.566°；选abs(mean_rpm)<=5且abs(rate)<=.15rad/s的95帧，角平均-.517°、参考角平均-.505°。这些运行数据提示约半度的有效平衡目标偏置，可作下一项试验；它不是独立量得的机械竖直零位，动态加速度、地面/安装和测量误差仍可能参与，不能证明AS5600自身偏差。

下一轮保持P=.042、I=.0009、目标角限幅3及内环8.4/0/.17，仅将BALTRIM从0试到-.50°。目的为减轻积分长时间建立静态补偿及初始漂移，不同时增加I或位置增益，不改ZERO、原始角保护或自动接管带。STOP、BALTRIM-.50，待下垂静止后SWING，T开始后尽快BALSPD0；尽量避免再等十余秒才切到零速。比较零速后的速度幅度、积分和参考角、反向过冲以及姿态，成功后再接回位置保持。命令范围/停止语义已核对，源码默认和学生副本均未改，未自动驱动实车。

## 20:55 trim=-.50：零速漂移转为正向，下一轮中间偏置-.35作对照

附件000f53a7-5a5b-4ebc-9fd9-d6f9eb3ca54c，fw42，STOP/BALTRIM-.50均ACK。首T2679539，末2691479，记录ACTIVE11.94秒，无X；V确认trim-.500、外环.042/.0009、角限幅3，其它起摆参数保持。BALSPD0在接管约3.4秒发送，ACK73/OK，P.state0首帧2682979，target0/command+.14随后归0，和前轮约11.3秒切零速的初始状态不同。

零速记录约8.5秒，前三秒平均速度约+23.80/+18.20/+16.45，随后约+11～+16RPM；末T+12.08RPM，末P+2.180圈。速度没有收敛0，不能称位置已保持。I在接管3～11秒由-.030逐渐升到+.088°，仍在变化；前轮trim0的慢性偏移主要为负，本轮方向已相反，但切换时机、积分历史、初始过渡不同，不能由这两次直接唯一算出准确静态偏置，也不能把降低漂移全归因trim。

下一轮只将trim从-.50向0回收至-.35°，作为中间值对照，P/I保持.042/.0009，不恢复位置保持，不改起摆、ZERO、捕捉或退出条件。STOP、BALTRIM-.35，待下垂静止后SWING，开始T后尽快BALSPD0；记录至少约15秒零速日志，重点看后期积分、速度过零和是否慢往复，不仅比较前几秒。若零速改善，再接回位置环。此次仅UART建议与记录，未改源码默认或学生副本，未操作实车。

## 21:04 trim=-.35仍正向漂移，用户为避免碰撞手动干预；下一轮仅增外环I

附件5260c953-4ec5-4992-bd9a-616cc79866cd，fw42，STOP/BALTRIM-.35成功。接管ms3192084，误差-1.846°、rate+.360、输出+.158；完整T记录到3201564，约9.48秒。BALSPD0在约4.8秒才发送，ACK82/OK，P.state0首帧3196924、target0/command-5.10随后按原斜坡回0，零速段约4.6秒。

用户明确“最后快撞上了我手动停的”。日志中没有末端串口STOP回执，实际保存X是ANGLE/2、原始角32.344°、run9496；前一帧角从-.088突然到15.117°/rate11.510，属于干预附近，不能把此段当无外力失稳或把实际退出码改写为STOP。分析只采用干预前：最后稳定T3201524角-.088°、均速+28.01RPM，P位置+2.011圈、目标/斜坡均0，仍没有停住。

零速前1/2/3秒分箱均速约+9.45/+20.70/+21.32RPM，后段仍约+18～+28；没有因为-.35就稳定归零。V确认P=.042、I=.0009、trim-.350，捕捉后5/6/7/8/9秒I为+.046/+.055/+.074/+.092/+.108°，持续正速误差的修正建立缓慢。这不能唯一证明I小是根因，但继续依据短暂漂移方向来回猜trim没有形成可靠改善；先固定trim-.35，转为一项I增益对照。

下一轮仅把BALVEL的I从.0009提高到.0015，P仍.042、角限幅3、trim-.35和内环/起摆/捕捉/退出条件均保留。以20RPM持续误差为例，积分角每秒变化由.018°增加到.030°；实际是否更快收敛以及反向过冲是否扩大需要实测，不保证只增I就能原地保持。STOP、BALVEL.042/.0015/3、BALTRIM-.35；待下垂静止后SWING，接管T开始后尽快BALSPD0。空间不足可以先STOP，不为凑齐时长而撞障碍。源码默认和学生副本未动，未自动驱动实车。

## 21:09 I=.0015轮未接管，先改用手扶ARM隔离速度试验

附件cf3106fb-c0d9-431b-8d8b-98e4b361d4da，fw42，STOP/BALVEL.042/.0015/3/BALTRIM-.35/SWING全部ACK成功。U确认起摆仍37%/.65/63.5/2、自动2°，372条完整U只有phase1/2，B仅state6，无T或V/ACTIVE。最近有效帧ms3508524/run10845，angle183.779°、rate-.141、E.998，仍在2°入口带之外；相邻183.955/rate+.076说明回落。最终X,3512679,RUN_TIME,9,4.05,200.00,0,200,30.586,15001,0是起摆超时。

生产Balance_Update已复核：SWING未接管时swing_update后直接return，update_velocity只在ACTIVE路径执行，因此本轮外环I=.0015尚未参与驱动，不能把这次偶发未起到顶归因加I，也不能用它评价新速度参数。起摆重复性仍未解决，但本阶段用户优先零速，不同时回到起摆参数整定。

下一轮用现有手扶ARM入口隔离速度环试验：STOP、BALWIN2/30/400、ARM，手扶到软件顶端窗口，连续满足400ms后开始T；松手并尽快BALSPD0，收集实际零速状态的日志。手动入口暂收窄至2°，使接管初角与现有自动2°相近，避免8°大初偏差打满输出；退出30°和时间400ms不变。此改动不放宽自动接管（实际角带仍min(entry2,auto2)）。保持P=.042/I=.0015/trim-.35及其它配置，不改源码或学生副本，不烧录或自动驱动实车。

## 21:13手扶轮仍移动，发现重新ZERO使角度参照平移约0.703°

附件714c5fb5-cb04-489b-bd7e-f529f2a00e3c，fw42，STOP/BALWIN2/30/400/ARM成功，手扶接管ms3779624，初始误差+.176°、rate-.034、输出-.071。V确认P=.042、I=.0015、trim-.350。约2.1秒后BALSPD0 ACK100/OK，target0、command+5.75按原斜坡回0，位置模式随后为0。干预前约7秒持续均速约-21～-26RPM，对应用户反馈一直前行，积分在接管9秒累到-.311°；尚未压到零。最终明确串口STOP/ACK101，X为STOP/1、run9206，不是角度或超速退出。

注意解析P记录时必须排除X原因字符串STOP中的字母P，不能用无边界的P,数字正则：它会将X,ms,STOP,1,...错误解析成一条P。此轮最后实际P为3788764、state0/target0/command0、pos-3.414，不是误匹配得到的伪记录。

关键变化：此前B底部4065、顶端2017；本轮B底部4073、顶端2025。用户异步确认“重新ZERO了，硬件没动”。相同原始角对应的测量偏角因此减少8*360/4096=.703125°，而BALTRIM会保留原数值，不自动做坐标补偿。因此之前按同一角度参照作的-.50/-.35方向比较不能原样延续，这也不证明速度I无效。新标定可能反映下垂参考重复性，尚未查明机械静摩擦/姿态或测量具体来源，不断言传感器损坏。

本阶段先固定本轮标定，后续只STOP/ARM重试，不重新ZERO或挪动硬件。若要保持原2017参照下trim-.35所对应的原始角目标，新2025参照下等效trim为-.35-.703125=-1.053125°。当前BALTRIM允许范围[-1,+1]，源码已核对，故先试合法的-1.00°，与原目标残差仅+.053125°；不直接下发越界-1.05。此为已知坐标变化的近似补偿，不宣称找到了真实物理平衡角。

下一轮STOP、BALVEL.042/.0015/3、BALTRIM-1.00、ARM，保留手动2°/400ms与原退出条件；手扶接管后松手并尽快BALSPD0，比较新I在近似一致参考下的零速表现。此轮不再改P/I、起摆或位置增益，不修改ZERO原始数据、源码默认或学生副本，未自动操作实车。固定参考后再依据后期速度/积分调整，避免将标定变化当成参数响应。

## 21:23 trim=-1改为正向漂移，固定标定下两侧已夹住，下一轮试-.70

附件974ce2b9-5bb3-4561-b6d9-4e3028359a0c，fw42，B底部4073/顶端2025保持，与21:13轮是同一参照。V确认P=.042、I=.0015、trim-1，捕捉初误差-.264°、rate+.142、u-.132。约.6秒BALSPD0 ACK106/OK，target/command随后0，位置已取消；这轮切换较及时。干预前2～5秒仍正向约+20～+26RPM，积分到+.123°，目标0没有实现停止。

用户明确“还是一直走撞到东西停了”。记录最后X是ANGLE/2、偏角-30.762°、run6341，不应改写为STOP，也不把末段角度快速增大、共同输出打满和均速约170当作未受外力的速度环失稳。碰撞精确时刻未给出，本轮参数比较只使用此前平缓漂移片段。

在两轮相同4073/2025标定与相同P/I下，取接管3/4/5秒V记录粗比：trim-.35轮均速均值-23.663RPM，平均有效静态项trim+Iv=-.480°；trim-1轮均速均值+23.373RPM，平均trim+Iv=-.912°。将其仅作局部对照插值得零速项约-.697°，不是模型辨识或已验证平衡角，瞬态、不同切换时机和积分历史仍影响结果。但现有数据支持在当前参照下以-.70作下一轮中间偏置，比继续改P/I或依据碰撞段推断更有针对性。

下一轮只改BALTRIM-.70，P=.042/I=.0015/角限幅3以及标定、手动2°/400ms、退出条件保持。STOP、BALVEL.042/.0015/3、BALTRIM-.70、ARM，开始T后松手并尽快BALSPD0。先观察3～5秒漂移方向和幅度，有持续单向移动就提前STOP，不为长日志撞障碍；确实接近零速再延长验证。没有更新源码默认、修改学生副本或操作实车。

## 21:30 trim=-.70仍有负向漂移，下一轮二分试-.85

附件b9e421c1-8793-48d5-a086-fb28b8dfc401，fw42。STOP/BALVEL.042/.0015/3/BALTRIM-.70/ARM均成功。捕捉4782404，底4073/顶2025未变，内环8.4/0/.17、输出.8、手动2/30/400。第一次BALSPD0在接管前返回NOT_READY；接管后第二次ACK112/OK，P.state0且target0，command在4783444归0，后段确为纯零速试验，不能因第一次错误认定目标未生效。

完整T按数值字段15列解析（加记录字母共16列）；接管后各秒平均速度为-6.01/-14.42/-19.29/-23.24/-23.85/-23.35/-23.02/-17.67/-23.39/-29.36RPM。V在3/4/5/6/7/8/9秒的积分-.054/-.088/-.123/-.158/-.193/-.220/-.253度；不是速度目标非零或积分已限幅。末P位置-3.358圈，仍未保持位置。X明确STOP/1，run9976ms、原始偏角-1.318度，峰速30.29/阈值200，不是超速或角度自动退出。约7.8秒附近有短暂角度/速度变化，用户未说明接触情况，不独立归因碰撞或自然恢复。

之前用两轮trim+Iv局部插值估出的-.70并未得到本次验证，不能视为已识别出的真实平衡角。动态积分历史和起始条件会影响漂移响应，不再将它当静态线性模型。在同一ZERO下，-.70主要负向漂移，-1轮干预前主要正向漂移，下一次仅试两者中间-.85，保持P=.042、I=.0015及其它控制条件，继续固定ZERO，不同时增加增益。STOP/BALVEL.042/.0015/3/BALTRIM-.85/ARM，T开始后松手并BALSPD0，确认OK；只取3～5秒初始方向和幅度作比较，持续漂移提前STOP。若仍不收敛，应重新评估动态外环与标定重复性，不能无限依赖短轮次二分保证稳定。此次仅分析与串口试验建议，源码默认和学生副本未改，未操作实车。

## 21:34 trim=-.85转为正向漂移，碰撞尾段剔除，下一轮试-.78

附件2cfd2337-ca10-4141-b3f4-74d8eca21ed5，fw42，全部设置ACK114～117成功。标定仍4073/2025、速度P=.042/I=.0015、trim-.85、内环8.4/0/.17。初始捕捉偏角+1.143度、rate0、共同输出-.292，与上一轮-.70的初偏角-1.143度、输出+.076不同，初始瞬态并不一致，不能由漂移符号唯一确定真实竖直偏置或作精确线性辨识。BALSPD0 ACK118成功，P.state0且target0，command于5005554回0，后段不再由位置环主动请求运动。

接管后1～7秒各完整秒平均RPM约+23.37/+22.08/+20.12/+19.45/+16.81/+18.13；V六秒为+16.96RPM、I+.161度，七秒+19.30/I+.187度，仍未停住，也未证明稳定收敛。相较-.70的负向漂移，方向已改变，但初始状态和积分历史仍影响幅度。当前积分未饱和，不能仅凭此次非零速度认定反馈反向。

约7.44秒后角度、四轮速度开始急变，X明确ANGLE/2、run7856、raw-30.850度、peak191.69<200、overspeed0。用户已确认该处碰到障碍物或有接触，因此将末段打满输出、约170RPM加速和退出视为受干扰尾段，不当作无接触控制本体失稳，亦不改写为超速退出。

下一轮维持其余设置，仅将trim试到-.78，作为-.70与-.85之间的粗略比较，非已验证平衡点。固定ZERO，不再标定；STOP/BALVEL.042/.0015/3/BALTRIM-.78/ARM，开始T后松手并BALSPD0确认OK，尽量减少不同侧大初偏角接管造成的干扰。只观察3～5秒，持续漂移提前STOP；若依然在近邻偏置下出现大幅相反漂移，应进一步核对起始条件与速度外环动态，不把无限细分trim当保证收敛的方法。源码默认和学生副本均未改，未操作实车。

## 21:40 trim=-.78漂移减小但未归零，下一轮仅试-.81

附件526210fb-64f8-4d87-99d6-3b1dec67c4b7，fw42，设置119～122全部OK，捕捉5345229，底4073/顶2025保持，初偏角+.264度、rate-.015、共同输出-.151。BALSPD0 ACK123成功，P.state0，斜坡于5346469归0；后段速度目标与命令均0，位置环取消。完整直立记录约14.3秒，X为STOP/1、run14316、raw-.879度、peak11.74/阈值200，overspeed0，未发生日志所示自动保护退出。

接管后1～14秒各秒完整T均速约-15.22/-14.93/-15.63/-13.65/-12.65/-8.91/-9.49/-13.32/-13.65/-14.36/-9.03/-8.96/-10.83/-10.25RPM。较-.70轮中段约-23RPM、-.85轮约+20RPM，本轮负向漂移幅度较小，但有缓慢起伏，并非持续单调减速或已停住。V积分3/7/10/14秒为-.057/-.133/-.186/-.250度，仍在累积且未限幅；末位置-2.873圈，不能称位置已保持。后期约-8～-11RPM，未接近稳态零速，未独立确认实物无接触，不额外认定某次波动为碰撞。

下一轮固定ZERO、P=.042、I=.0015、手动入口与内环等，只将trim从-.78试到-.81作为邻近粗调。此前-.85正向与本轮-.78负向可作试验区间，但初态/积分历史不同，-.81不是精确辨识结果或稳定保证。STOP/BALVEL.042/.0015/3/BALTRIM-.81/ARM，开始T并松手后BALSPD0确认OK。先观察3～5秒；确实低速且有空间再延长看慢摆与积分，持续漂移提前STOP。改善后应固定偏置验证重复性及速度外环动态，再恢复位置保持；不将每次短日志内的不同漂移都继续归因静态零点。未改源码默认、学生副本或自动操作实车。

## 21:43 trim=-.81前段低速、九秒后无接触反向加速，固定偏置做I=0对照

附件c265fbc3-40f5-4f66-aead-ff8a634cf9cf，fw42，设置125～128成功，接管5522959，标定4073/2025保持，初偏角+.352度、rate-.006、u-.169。外环.042/.0015/3、trim-.81、内环8.4/0/.17、输出.8保持。BALSPD0 ACK129/OK，P.state0、target0，command于5523579归0；整个后段没有位置环重新启动。最终串口STOP ACK130，X为STOP/1、run14796、raw-.615度、peak26.45<200、overspeed0。最后P.pos+1.245圈，不是位置守住。

各秒完整T均速约-4.20/-2.45/-3.52/-4.99/-6.44/-6.70/-6.70/-3.93/-.97/+7.88/+20.25/+25.08/+24.43/+20.64/+21.87RPM。前段较前几轮低速，但9秒附近短暂过零后持续正向加速，不能称长期静止。用户明确21:42:55～56附近及全程无接触、地面平整，因此该反向段是当前闭环系统无已知外部接触的有效响应，不按碰撞剔除。

V在7/8/9秒速度-6.71/-2.94/-.09，积分-.050/-.057/-.059度；随后10/11/12/14秒速度+16.61/+21.71/+26.22/+21.09，积分-.050/-.021/+.016/+.085度。参考角相应由-.063变+.647并至约1度。积分从未饱和，因果尚不能唯一归为积分过大；摩擦、参考偏置、测量/执行动态和P仍可能参与。此前用短轮漂移二分trim不能证明准确重力零位，本轮停止继续细分trim，固定-.81做动态对照。

下一轮只将速度外环I从.0015临时置0，P=.042、角限幅3、trim-.81及其它控制条件保持；生产代码已核对，BALVEL .042 0 3仍开启速度反馈，并在update_velocity清除外环积分，不影响直立PD或原有保护。STOP/BALVEL.042/0/3/BALTRIM-.81/ARM，开始T并松手后BALSPD0确认OK，固定ZERO。目的为检查相似初态下反向加速是否仍出现，非断言取消I即可长期零速。优先取相近初始角启动，空间足够时观察到此前约9秒转折附近；若持续单向漂移则提前STOP，无需为时长碰障碍。若I=0仍反向，应继续检查P及控制动态，而不是重新猜静态trim。未修改源码默认、学生练习副本或操作实车。

## 21:47 I=0对照仍负向漂移，碰撞后角度退出；下一轮恢复I并小幅降低P

附件36d01c4b-87a7-473d-9424-ad04d27443fb，fw42，设置131～134成功，捕捉5814949，底4073/顶2025、trim-.81保持；外环.042/0/3、I全程0、内环8.4/0/.17。捕捉初偏角-1.318度、输出+.078，而上一轮初角+.352度/输出-.169，初始过渡不同。BALSPD0在接管约2.5秒才ACK135/OK，P.state0首帧5817489，command由+5.50按既有10RPM/s斜坡回0，5818089即接管3.14秒才见command0；上一轮约.62秒已归0。两轮不是严格单变量等初态对照，不能据此唯一归因I。

完整T每秒均速约-9.92/-14.86/-14.48/-22.52/-25.75/-23.01/-26.53，后面第7秒包含接触尾段。实际纯零速后、接触前仍约-23～-27RPM，I=0没有在本轮把车停住，也不能用不足9秒且中途接触的记录排除更晚反向。前7秒最大速度较小，无速度阈值触发。

用户已确认约21:47:45.5、接管7.8秒附近碰到障碍物或有接触。末段u打满-.8、均速约-140，X明确ANGLE/2、run8146、原始偏角+31.025度、峰速192.73<200、overspeed0。因此尾段不当成无接触本体失稳或超速退出，也不据此修改保护阈值。

下一轮以之前前段较低速的P=.042/I=.0015/trim-.81作为恢复基线，仅对该基线的P小幅降低到.040，I回.0015、角限幅3、trim-.81、其它控制与ZERO保持。目的是检查速度到目标角的修正强度对慢漂移/过冲的影响，非证明P过大或保证减P有效；与本轮I0相比有恢复I和改变P两项，评价时应主要对照21:43的PI基线，并记录初始角和切换时刻。STOP/BALVEL.040/.0015/3/BALTRIM-.81/ARM，开始T后尽快松手并BALSPD0确认OK。先检查早期速度；若低速且空间允许再看9～12秒是否反向，持续漂移提前STOP，不为记录时长碰障碍。未更新源码默认、学生副本或操作实车。

## 源码默认值固化：v43

用户要求将刚建议的参数写进代码。原工程Core/Src/balance_control.c默认速度外环改为Kp=.040、Ki=.0015、角限幅3度、trim=-.81度；固件号0x103C8043。保留其它默认与上电ZERO要求，没有将当前原始标定4073/2025、串口临时手动捕捉2度或起摆37%/63.5一并固化，学生待调参副本未动。该组新P=.040尚无实车反馈，不宣称已停稳。

修改前源码/默认测试/文档及v42HEX和AXF备份在MDK-ARM/speed_pid_build/before_velocity_defaults_v43。现有默认值断言同步，非零trim在接管时的预期输出同步，算法回归场景显式使用原先零trim夹具。verify_balance.ps1全套通过；ARMCC5全40源文件警告视错构建通过，Code47812、RO5436、RW828、ZI19548，RAM20376/20480（含预分配堆栈）。正常Keil HEX/AXF已同步，无自动烧录或实车动作。

## v44实测：约5.046秒接管，后段仍是位置保持模式

附件19dec0d7-e942-44d4-9343-4b412c98a698，fw0x103C8044，SWING ACK3/OK。U确认默认37%/.65/63.5/2rad/s/2度/净2圈/15秒已生效。首次U ms74629/run46，推算开始74583；phase3于79629，约5046ms接入ACTIVE。接管angle181.670度、rate-1.095rad/s、共同输出-.182、robust-.04RPM，符合保留的2度/2rad/s等接管检查。B确认底4076/顶2028，与此前旧传感器试调参照4073/2025不同；trim仍源码-.81，后续零速比较需要固定此次标定，不直接混用旧参照的偏置试验。

直立运行到用户串口stop ACK4/OK，X为STOP/1、run7266、raw-1.318度、peak22.21<200、overspeed0；不是起摆未接管或保护退出。此记录支持本次成功接管并运行约7.3秒，不代表连续20秒、重复成功率、位置或零速已稳定。首秒T均速约+38.47，随后各秒-8.86/-38.25/-35.99/-26.89/-15.71/-14.26RPM，先有接管过渡后仍漂移。

全程未见BALSPD0，P.seq_state始终5，末P.pos-1.786圈、goal0、target/command均+6RPM；默认位置环在请求回到捕捉点，不能把本轮当目标恒0的纯速度对照。V实际外环.040/.0015/3、trim-.81，7秒I-.163度、filtered-15.01RPM。下一轮不改起摆/直立/速度参数或源码：等待自然下垂静止后SWING，实际开始T后BALSPD0确认OK，检查P.state0、target0及斜坡command归0，再观察零速的持续漂移/过冲。固定当前ZERO、提前STOP避免障碍。此次仅分析记录与后续UART测试说明，无源码默认变更、无操作实车或学生副本。
