lingkonglengfeng/nanhua-pendulum-car/f103_bringup/docs/转向积分与30度退出.md

# 转向积分与30度退出

2026-10-18，固件 `0x103C8033`。用户反馈v32仍不转向，并要求输出限幅更大、退出角度180°±30°。实现转向PI、直立输出80%、差动上限12%、退出±30°；捕捉±1.4°连续400ms和不限时不变。未自动烧录或驾驶实车。

## 本轮日志依据

附件：`C:/Users/14449/.codex/attachments/25878046-e9a6-45e0-91cd-b9202997e09b/已粘贴的文本.txt`。日志确认fw0x103C8032，直立PID8.4/0/0.17，速度外环0.038/0.0009、60RPM/不限时，标定底4060/顶2012。

18:36:50首次BALTURN5早于捕捉，被NOT_READY拒绝；18:37:01第二次明确A,6,OK,BALTURN，之后Y目标/斜坡均5，不能把整次不转向归结为命令没生效。完整解析得Y236、H236、T1127、V24、E24行；串口分包标签中断行需拼接，含发送标签或字段不全的行不强行补造。

Y斜坡到5的稳态区间MCU92914～111814，共190行，实测半轮速差均值约0.79RPM（范围-1.73～2.91），差动平均约0.0337，即3.37%，未触及8%上限。目标5对应左右平均轮速差10RPM，实际平均仅约1.58RPM。仅增加上限不会自动使原P控制增加力矩；持续跟踪误差下需要积分补偿。轮胎侧向摩擦、驱动差异或测速偏差仍需实车验证，不能仅凭编码器断言已确定机械根因或真实车体航向。

按稳态4秒段的H均值：首段通道0～3约[-10.30,-10.40,-6.79,-10.05]RPM，末3秒约[-6.68,-6.56,-3.89,-6.51]。通道2有更明显的轮速变化，其余轮仍同向；整体仍有负向漂移，并非实现原地零速。最后V滤波均速-6.81RPM，速度积分-0.188°；末T角度-0.439°、原计数均速-2.38RPM。所见末段仍ACTIVE，未记录最终退出原因。提高共同输出上限是按用户要求；本轮正常小角度输出未触及原70%，不能把共同限幅认定为本次不转向的主因。

## 默认配置和指令

- 直立输出上限：70%→80%。
- 转向差动上限：8%→12%，仍受共同直立输出剩余空间限制，单轮总输出不超过80%。
- 转向PI：Kp0.008、Ki0.010，单位归一化输出/RPM和归一化输出/(RPM·s)。
- 退出角度：180°±30°，即150°～210°；进入仍±1.4°连续400ms。
- 原直立PID8.4/0/0.17、速度外环0.038/0.0009、60RPM连续50ms超速退出、v32混合测速与原计数独立保护、轮位方向、日志仅ACTIVE保留。

烧录正常Keil HEX/AXF后，摆杆自然下垂且静止发送STOP、ZERO。捕捉进入ACTIVE开始打印后再发送BALTURN5；这时应返回OK。观察几秒后发送BALTURN0撤掉转向请求；单独再测试BALTURN-5。BALSPD0请求平移零速，STOP则撤驱动。扩大退出角度不代表已验证±30°可恢复，转向0不代表绝对航向保持，零速目标仍需继续实车整定。

新增串口调参：

```text
BALTURNPI 0.008 0.010
```

范围Kp0～0.02、Ki0～0.05，整条参数有效才应用；允许ACTIVE内修改，清转向积分，保留直立和目标请求。将Ki设0可退回P控制。Watch可看g_bal_turn_ki、g_bal_turn_integral。上电用源码默认，不写Flash。

## 积分和饱和

使用斜坡后的差速目标减实际低通差速作误差，实际dt积分；只在非零转向请求、斜坡已进入目标同方向、Ki非零时积分。先保留共同直立输出，再由min(0.12,0.80-|u_balance|)决定转向余量。积分跟随这个余量收缩；P+I需求在限幅外且误差继续向外推动时冻结积分。输出饱和期间不会无限蓄积。

BALTURN0或直接反向会清原转向积分，反向斜坡尚未跨过0时不积原方向误差；STOP/ARM/ZERO/故障/外环禁用同样清零，避免旧积分在下一次控制中恢复。中立时保留原P差速阻尼，不额外用积分追求绝对航向。

## 日志和验证

Y由8列扩为10列，末尾追加ki和i，旧字段顺序不改：

```text
Y,ms,target_rpm,command_rpm,diff_rpm,u,kp,limit,ki,i
```

limit现在0.120；i是积分输出，不是轮速误差或安培。T/B/V/E/P/H列数不变，完整CSV_V16，精简T仍TRACE_V2。下轮回传完整T/P/Y/H，结合实物确认左右转、前后漂移及是否接触/过坎，不只看输出增长判断转向成功。

ARMCC5全量40源警告视错编译、控制/运动、串口和日志回归通过。新检查覆盖±30°原始角度退出、80%共同/12%差动混合、持续误差时积分增长到限幅、共同饱和时积分跟随归零、停止/反向/重启/故障清积分、Ki0等价P控制、无效Ki及参数原子拒绝。原零速/序列/超速检查保留；代码回归不代表实车已经转向成功或长期平衡稳定。

Code43648、RO4608、RW788、ZI19652；RAM20440/20480（含预留堆栈），ROM48396字节。仅增加8字节PI状态，没有新任务或堆分配。首包1154/2048，最坏GET1426/2048，全量默认流估算9347B/s。v32备份在 `MDK-ARM/speed_pid_build/before_turn_pi_v33/`，构建日志build_turn_pi_v33.log。
