lingkonglengfeng/nanhua-pendulum-car/f103_bringup/docs/通道1速度环实测.md

# 通道 1 映射修正后的实测

## 映射和单轮确认

用户在0x103C800D上通过MAP/ENCSIGN命令将映射设为0/2/1/3、编码器符号设为-1/1/1/-1。日志只有电机1有非零输出，0/2/3输出均为0；原始编码器2变化是电机1的正确反馈，并不代表电机2在转。用户最初表示单轮转动比较平稳，后续更正左前轮也实际忽快忽慢，以更正为准：对应关系已校准，前轮速度稳定性仍未通过。当前试验方案见 [单轮PID调试](单轮PID调试.md)。

默认映射已包含在0x103C800E及以后固件中。旧D固件的串口校正存储于RAM，复位会恢复旧值。

## 60RPM与200RPM

新日志包含770条60RPM记录和198条200RPM记录，全程dt=5ms，missed=0，无输出饱和，其他三个电机输出为0。

| 目标 | 最后2秒瞬时样本平均 | 同期累计计数换算平均 | 稳态平均输出 |
|---|---:|---:|---:|
| 60RPM | 60.925RPM | 59.987RPM | 0.57944 |
| 200RPM | 200.169RPM | 200.384RPM | 0.82320 |

60RPM最后2秒瞬时读数范围41.63～75.10RPM，200RPM为184.68～224.40RPM。用户观察轮子平稳，长窗口计数平均与目标接近；短时间测速仍有明显波动，当前不据此继续增加PID增益。保持Kp=0.001562、Ki=0.01、Kd=0，先完成其它电机的对应关系和方向验证。

通道1的起转和稳态所需输出明显高于通道0，不能把通道0的输出幅值直接当作所有轮子的参考。原因尚未由这些日志单独确定。

## 重复RUN指令的修正

本轮换到200RPM时发送了SET 1 200和RUN 1。旧实现每次RUN 1都清积分，即使电机早已在速度模式运行；这会让已有维持输出消失，造成不必要的掉速再起步。

0x103C800F改为：已经处于速度模式时重复RUN 1保持积分/微分历史和目标；从STOP或其它驱动模式进入速度环仍清历史。显式RESET和PID指令的清历史行为保留，先RESET再RUN也不会撤销重置请求。

命令回归新增了重复使能、切换模式、显式RESET保留三个场景，均通过。39个源文件ARMCC编译/链接通过，Keil自身Rebuild为0 Error、0 Warning；未自动烧录。默认PID和映射保持已校准值。

## 下一步

先STOP等轮子停稳，架空单测通道2：LED 2 5、SET 2 60、RUN 1。采3～5秒后单独STOP，核对实物轮位、前进方向、rpm2是否为正、其它通道是否无输出。通道3随后同样验证。

数据位于logs/2026-10-18_021022和logs/2026-10-18_021522。
