lingkonglengfeng/nanhua-pendulum-car/f103_bringup/docs/倒立摆串口控制与最低点标定.md

# 倒立摆串口控制与最低点标定

当前v41（0x103C8041）：用户反馈起摆成功，将SWINGENERGY0.65/66/2写为默认，起摆35%/±2圈/15秒、自动±2°接管、手动±8°/400ms及原控制/退出条件保留。每次上电仍需最低点ZERO，等待完成后单独SWING。

当前v40（0x103C8040）：手扶ARM仍180°±8°连续400ms；自动SWING接管独立为±2°，同时检查原始角/滤波角/预测角，新增SWINGCATCH。默认起摆35%/±2圈/15秒、能量.65/65/2，普通直立PID和退出阈值保留。上电ZERO等待约1秒后单独SWING，详见[自动起摆顶端接管修正](自动起摆顶端接管修正.md)。

当前v39（0x103C8039）：新增自然下垂自动起摆。先ZERO并静止等待约1秒标定结束，再发SWING；默认起摆35%/±2轮轴圈/10秒，达到顶端动态接管条件后直接进入原直立与位置保持。手动ARM仍保持±8°连续400ms。起摆新增U17/40ms日志、TRAVEL退出原因，普通直立参数与轮位方向保留。详见[自动起摆控制与调试](自动起摆控制与调试.md)。以下旧版记录不代表当前全部默认值。

当前v36（0x103C8036）：上电ZERO后，扶到180°±8°连续400ms自动进入并保持进入时的位置；不再要求手动BALPZERO。见[自动捕捉与当前位置保持](自动捕捉与当前位置保持.md)。退出±30°、200RPM/200ms、原PID及X退出打印保留，以下为旧版记录。

当前v35（0x103C8035）：超速默认200RPM/200ms，退出后额外一次X原因诊断，LOG0也可发送；普通参数仍仅ACTIVE。见[退出诊断与200RPM阈值](退出诊断与200RPM阈值.md)。以下各旧版60RPM/50ms和退出后只看Watch的规则已更新。

当前v34（0x103C8034）：新增BALPOS/BALHOLD/BALPZERO/BALPOSCFG，使用四轮平均确认计数里程，经位置环产生速度目标，见[编码器平均里程位置保持](编码器平均里程位置保持.md)。保持仅ACTIVE明确启用，P.seq_state5表示独立保持，O5打印配置及误差；其余控制与退出阈值沿用v33。以下为旧版记录。

当前v33（0x103C8033）：按用户要求退出角度改180°±30°、直立输出上限80%、差动上限12%；转向增加抗饱和积分，默认PI0.008/0.010，见[转向积分与30度退出](转向积分与30度退出.md)。捕捉仍±1.4°连续400ms，以下为版本记录。

当前固件v32（0x103C8032）：增加低速周期/高速计数测速，转向P0.008，新增H6日志；捕捉±1.4°/400ms、退出±25°、不限时及原PID保留。见[低速周期测速与转向增益](低速周期测速与转向增益.md)。下文为各旧版本记录。

当前固件v31（0x103C8031）：默认关闭ACTIVE到时退出（BALSAFE60/0），增加BALTURN差速转向和Y8日志；捕捉仍±1.4°连续400ms，退出±25°，原角度/速度/传感器等退出条件保留。见[长时间直立与差速转向](长时间直立与差速转向.md)。下面v30及更早段落为历史记录。

当前固件v30（0x103C8030）：捕捉改为±1.4°连续400ms，退出改为±25°；默认直立8.4/0/0.17、外环0.038/0.0009、60RPM/24000ms，开机仍OFF且目标0。新增BALSPD和BALSEQ保持倒立的目标速度/小范围往返流程，实际精度待验证，详见[直立直走停车返程测试](直立直走停车返程测试.md)。下面各旧版默认值为历史记录。

当前v23（0x103C8023）：新增 `BALSLEW deg_s` 可调速度外环目标角变化率（0.1～10°/s，默认1）。外环仍默认关闭，10ms角速度滤波、轮位和退出保护保持不变。新增含电机延迟的示意模型检查，但实车整定仍未完成；流程见[外环变化率与电机延迟复核](外环变化率与电机延迟复核.md)。

当前v22（0x103C8022）：按用户要求将AS5600角速度滤波时间常数改为10ms，读取仍200Hz；新增默认关闭的零速外环及 `BALVEL kp ki max_deg`、CSV_V8的V行。原角度PID、轮位和退出保护保留。先单独比较滤波，再启用外环，流程见[10ms滤波与直立速度外环](10ms滤波与直立速度外环.md)。

当前版本为 `0x103C8021`：新增独立于输出限幅的直立试验自动退出保护。默认任一轮基础滤波测速绝对值连续50ms超过40RPM，或本次ACTIVE运行达到1500ms，就撤掉四轮驱动并锁定。之后需要ARM，不自动重启。退出为00滑行，不能保证立即刹停或继续扶住摆杆。新增 `BALSAFE max_rpm max_run_ms`；reason=8表示超速、9表示到时。原角度、方向和仅ACTIVE打印策略保留，详见[直立试验自动退出保护](直立试验自动退出保护.md)。

当前更新为 `0x103C8020`：仅在直立环实际运行（state=4）期间打印参数；上电、ZERO标定、等待/手扶400ms计时、OPEN/FWD/REV及退出后不再安排参数打印。指令回执及主动HELP仍可用；非运行状态GET仅回执，不输出参数。直立输出默认 `BALSIGN=-1`，根据用户“杆前倾而车向后跑”的实测，将v19的直立PID输出取反。轮位仍为0右后、1右前、2左后、3左前，电机符号{-1,-1,1,1}、编码器符号{-1,1,-1,-1}。详见[轮位与通道对应](轮位与通道对应.md)。

固件 `0x103C8015`，STM32F103C8T6，2026-10-18。源码已接入 Keil 工程；本轮只编译和主机验证，没有烧录或运行实车。

## 先测试整车前后控制

串口仍为 USART3（PB10 TX / PB11 RX），115200、8N1、无流控。文本发送，每行加 CR/LF，等待 `A,...,OK,...` 后再发下一行。最新轮位为 0右后、1右前、2左后、3左前；方向使用上述v19配置，编码器映射、双向慢衰减驱动和轮速PI保持原实现。

分别发送，下列各行是独立操作，不要整块一次发出：

| 指令 | 行为 |
|---|---|
| `FWD 30` | 四轮以 +30 RPM 前进，立即启用轮速闭环 |
| `REV 30` | 四轮以 -30 RPM 后退 |
| `MOVE -60` | 有符号速度控制，等同后退60 RPM |
| `FWD 0` / `REV 0` / `MOVE 0` | 与 STOP 相同 |
| `STOP` | 退出所有驱动模式，清目标及控制历史，输出滑行 |

`FWD/REV` 参数范围0～280，`MOVE` 为-280～280，单位为减速箱输出轴RPM。更新速度时保留已经工作的轮速PI积分；不会因重复发送同一命令每次清积分。跨入轮速模式时重新清历史。

前后指令会取消标定后的自动捕捉准备/直立模式，切入普通轮速控制。这些指令目前用于独立测试整车动力链；不表示在稳摆时给小车添加位移目标。直立环工作时，不同时叠加四个轮速PI。

前后指令持续生效直到 STOP 或切换模式。串口断开本身不会自动清除电机指令；需要停车时先发 STOP。

## 最低点标定和自动捕捉

1. 将摆杆自然垂到最低点并保持静止，发送 `ZERO`。
2. 固件关闭其它驱动模式，在200 Hz控制周期采集200个原始角度，约1秒。`A,...,OK,ZERO` 表示指令已接受；此阶段按用户要求不打印参数，可用Watch看 `g_pendulum_zero_result=2`、`g_pendulum_calibrated=1` 确认完成。标定期间运动过大或磁场/通信无效，会失败并保持停机，重新静止后再发 ZERO。
3. 标定成功后自动进入等待顶端状态。最低点定义为0°，顶端为180°；内部直立误差以顶端为0弧度。原始顶端计数为 `(bottom_raw + 2048) % 4096`，不向AS5600写零点/OTP。
4. 用手将摆杆扶到180°附近。默认捕捉窗口是 **175°～185°**，所有有效样本在窗口内保持连续400 ms，进入直立环。离开捕捉窗口、出现无效样本或超过15 ms的控制间隔，捕捉计时清零。
5. 进入后默认允许 **160°～200°**。最新未滤波角度越界、角度失效、控制间隔异常等情况，会退出直立环、清积分和输出；四轮进入滑行。滤波角度只用于PID，不用于延迟越界判定。
6. 退出后不会在摆杆回摆时自行重启。标定仍有效时发送 `ARM`，再手扶进顶端窗口400 ms；`STOP` 可以取消准备或运行。未标定时 ARM 返回 `ERR,ARM,NOT_READY`。重新上电必须重新 ZERO。

ZERO 与 STOP/RUN/FWD 等在同一批串口命令中出现时，后续停止/行驶命令会取消尚未执行的ZERO，不会迟到地重新准备直立。已经开始但被STOP取消的采样可完成标定数据，但不会自动进入等待/捕捉。

## 参数指令

| 指令 | 默认/示例 | 说明 |
|---|---|---|
| `BALPID kp ki kd` | `BALPID 1.2 0 0.08` | 直立环增益，与轮速的 PID/PIDW/KP/KI/KD 独立；更新时清直立积分 |
| `BALLIMIT pct` | `BALLIMIT 25` | 最大驱动占比25%，范围1～100%；正反对称限幅 |
| `BALWIN entry exit dwell` | `BALWIN 5 20 400` | 捕捉半宽5°、退出半宽20°、连续400 ms |
| `BALWIN 20 20 400` | 同一角度区间 | 如需捕捉和退出都使用180°±20°，可用此配置 |
| `BALSIGN +/-1` | 默认 `BALSIGN -1` | 翻转整个直立控制输出方向，不改电机/编码器映射；修改会停止，需ARM |
| `PENDSIGN +/-1` | `PENDSIGN 1` | 校正角度正方向；修改会停止，需ARM |
| `ARM` | `ARM` | 保留零点，重新等待手扶捕捉，不立即驱动电机 |
| `GET` | `GET` | 运行直立环时获取包含B行的完整状态，即使LOG=0也可用；其它状态仅回执 |
| `LOG 1` / `PERIOD 100` | 默认允许/100 ms | 仅运行直立环期间周期打印；LOG 0进一步禁用，LOG 1不会绕过运行条件 |

BALWIN的半宽范围0.1°～45°，退出半宽不得小于捕捉半宽；连续时间400～5000 ms，必须为整数。修改BALWIN会停机，之后需ARM或ZERO。参数保存在RAM，断电恢复默认。

直立环：`u = BALSIGN * clamp(Kp*theta + integral + Kd*omega, -limit, limit)`。
theta单位rad，omega单位rad/s，积分使用实际控制间隔，含抗饱和。四轮接受相同的逻辑前后命令，再经过各轮既有的电机方向修正。

**1.2 / 0 / 0.08、输出限幅25%仅为首次试验的预估值，尚未实车整定。** 当前实现的是角度稳定控制，尚无小车位置回中或自动起摆。后续根据日志调整直立参数。首次确认方向时应检查“杆顶向前偏 → 车轮向前追杆”；若相反，用STOP后更改BALSIGN，再ARM，不通过加大增益修正极性。

## 日志和Watch

协议标记升级为 `#F103_PID_CSV_V7`，原Q机械绝对角度、D轮速和其它行的列数保持不变，新增B行：

```text
B,ms,state,reason,cal,valid,zero_result,zero_samples,bottom_raw,upright_raw,bottom_deg,error_deg,rate_rad_s,u,i,kp,ki,kd,limit,entry_deg,exit_deg,dwell_ms,hold_ms,sign,angle_sign
```

| state | 含义 |
|---|---|
| 0 | 停止/未准备 |
| 1 | 最低点标定采集中 |
| 2 | 已准备，等待进入顶端窗口 |
| 3 | 顶端窗口连续计时中 |
| 4 | 直立环运行中 |
| 5 | 退出锁定，需ARM或重新ZERO |

reason：0正常，1主动停止/切到其它模式，2角度越界，3传感器或角度无效，4控制间隔异常，5标定失败/失效，6控制模式冲突，7参数无效。

zero_result：0空闲，1采集中，2成功，3样本无效，4标定期间移动，5配置错误。cal=1才可使用零点；valid表示本周期摆角有效。Q行仍是AS5600原始机械角，不会因为ZERO变成最低点0°；标定后的角度看B行bottom_deg。

Watch可看：`g_bal_state`、`g_bal_reason`、`g_bal_hold_ms`、`g_bal_enable`、`g_pendulum_bottom_deg`、`g_bal_theta`、`g_bal_theta_dot`、`g_bal_output`、`g_bal_integral`、`g_pendulum_zero_result`、`g_pendulum_zero_samples`。其中g_bal_enable由状态机生成，单独写1无法绕过400ms判定。增益可Watch修改，串口修改会在控制周期边界一起提交，更便于复现。

运行期间默认日志周期100 ms，控制仍为5 ms。每次进入运行状态立即安排列名和首条B行，之后打印完整参数；退出后不再提交新参数包，已提交的DMA包正常发完。再次ARM并满足400ms条件后自动恢复打印。列名、HELP、GET分包发送，不扩大原2 KiB DMA缓冲区。高频全量打印受115200带宽限制；先保留100 ms。请保留完整运行日志，并说明实物方向、是否松手及大致表现。退出原因可通过Watch的g_bal_reason查看。

## 验证与构建

- `MDK-ARM/speed_pid_build/verify_balance.ps1`：直接编译生产角度/直立控制模块，覆盖最低点跨零标定、运动/弱磁/过期拒绝、395/400 ms边界、连续计时重置、原始角度越界、故障锁定、计时溢出、限幅/抗积分饱和及NaN处理。
- `verify_commands.ps1`：串口解析、队列、DMA RX，以及ZERO/ARM/STOP和FWD/REV/MOVE模式切换、重复速度更新、参数合法性。
- `verify_telemetry.ps1`：B行25列与旧字段、极值格式、DMA包边界和默认带宽预算；极值全量GET为959/2048字节，默认10 Hz压力数据约6348字节/秒。
- ARMCC5全量构建启用警告视为错误；原Keil工程再次构建确认0错误、0警告，新模块已加入工程。版本号为 `0x103C8015`；下载路径仍是 `MDK-ARM/f103_bringup/f103_bringup.hex` / `.axf`。
- 构建资源：Code=37380、RO=3404、RW=620、ZI=19476字节，链接RAM占用20096/20480字节（包括预留堆栈），ROM加载约40884字节。链接器静态最大调用栈估计1420字节并标注部分未知路径，日志任务仍保留2048字节栈；上板后继续观察S行stack_free和周期统计。证据：`speed_pid_build/build_pendulum_v15.log`、`keil_pendulum_v15.log`、`f103_speed_pid.map`。
- 上述是编译和主机逻辑验证，不等于实车已稳摆；当前没有自动烧录。
