lingkonglengfeng/nanhua-pendulum-car/f103_bringup/docs/实心铁棒默认参数.md

# 实心铁棒试调默认参数

2026-10-19，当前固件 `0x103C8044`。新AS5600后曾成功的起摆串口组37% / gain=0.65 / omega2=63.5 / capture_rate=2现已写入开机默认，修正v43断电后回到旧35%/66组的问题。保留v43速度外环Kp=0.040、Ki=0.0015、角度限幅3°、BALTRIM=-0.81°；这组新P尚待实车验证，不能认定已实现静止保持。保留v42的AS5600主动查询及其它控制配置。能量起摆默认不自动启动，自动接管独立为±2°，详见[自动起摆顶端接管修正](自动起摆顶端接管修正.md)。连续20秒保持、重复成功率与位置/转向稳定性仍需实测。

这些值是重新调试的起点。用户后来粗测轴心到新铁棒尖端约265 mm、铁棒直径8 mm，已确认265 mm不是棒本体长度，准确质量待测；用户还确认连接件大部分中空，不能按实体体积满密度估算。已从D:/blance_car旧V3模型核实，棒通过夹座接轴，近轴端与轴心沿杆相隔20 mm，轴不正好在棒端；新棒的实际插入深度需复核，见[摆杆转轴与重心几何核对](摆杆转轴与重心几何核对.md)。不能按“实心”直接计算新PID，也不能把此前日志的表现视为新结构的稳定性证明。历史记录保留，不整体推定所有旧日志属于哪一种摆杆。

| 项目 | v44开机默认值 |
| --- | --- |
| 直立角度PID | Kp=8.4，Ki=0，Kd=0.17 |
| 速度外环 | 启用，Kp=0.040，Ki=0.0015，零速请求0 RPM；捕捉后仍默认位置保持，位置环可产生速度目标 |
| 独立位置保持 | 捕捉成功自动记录进入点为0并保持；P=20 RPM/轮轴圈，速度上限6 RPM |
| 外环目标角限幅/变化率 | ±3°，10°/s |
| 手动平衡点偏置 | -0.81°，相对于本次ZERO，重新标定后需复核 |
| 电机输出限幅 | 80% |
| 顶端捕捉 | 手动ARM：180°±8°连续400ms；SWING：原始/滤波/预测角均在±2°，并满足角速度/车速条件后立即接管 |
| 原始角度退出范围 | 顶端±30°，即150°～210° |
| 原始最大轮速退出 | 严格大于200 RPM，连续达到200 ms |
| 每次直立试验时限 | 0，不启用到时退出，仍保留其它退出条件 |
| 差速转向 | 目标0，P=0.008、I=0.010，最大差动输出±0.12，10RPM/s斜坡，抗饱和 |
| 原地转向 | ACTIVE后用BALSPIN启用，保留进入SPIN时平均里程锚点；默认不旋转 |
| 直立输出方向/摆角方向 | BALSIGN=-1，PENDSIGN=+1 |
| 角度滤波 | 三点环形中值，采样200 Hz |
| 角速度低通时间常数 | 10 ms |
| 速度外环测速 | 四轮混合测速20ms低通；SPIN和SWING取四轮平均、其它模式取中间两项；直立外环再做100ms低通，超速仍用原计数测速 |
| 自动起摆输出/行程/时限 | 37%、起点±2输出轴圈、15000ms，需显式SWING |
| 起摆能量参数 | 增益0.65、omega2=63.5 s^-2（更换AS5600后成功试验组）、接管角速度≤2rad/s、目标归一化能量1.02 |
| 串口日志 | LOG=1、BALTRACE=1；ACTIVE期间20ms/50Hz，SWING期间40ms/25Hz U；退出一次X（LOG0也发送） |

直立初值集中在 `Core/Src/balance_control.c` 顶部，起摆初值在 `Core/Src/balance_swing.inc`；日志默认模式位于 `Core/Src/app_telemetry.c` 顶部。滤波实现和轮位/方向映射保持本车配置。

## 烧录与上电操作

正常Keil输出已同步到 `MDK-ARM/f103_bringup/f103_bringup.hex` 和 `.axf`。本次没有自动烧录或操作实车。

每次上电，摆杆自然下垂且小车静止，逐行发送：

```text
STOP
ZERO
```

最低点每次启动重新采200点，未将旧4061/2013零位写入源码或AS5600。静止等待约1秒标定完成后，自动起摆单独发SWING；手动流程则扶到顶端±8°连续400ms进入直立。退出后不自动捕捉重启，手动再ARM，自动起摆则在最低点静止后再SWING。默认直立不限总时长，起摆单独限制15秒。

开机 `g_bal_state=OFF`、`g_bal_enable=0`，未标定时ARM/SWING返回NOT_READY。上电无需再重发PID、BALVEL、BALWIN、BALLIMIT、BALSAFE、BALSLEW、BALTRACE、BALTRIM或起摆配置。串口临时修改保存在RAM，复位后恢复本表源码初值；更新断电默认值需重新编译烧录。

日志头应报告 `fw=0x103C8044`。B行增益8.4/0/0.17、entry=8（手动）、exit=30；V行外环0.040/0.0015、角限幅3、max_run_ms=0、trim=-0.81。起摆U行limit=0.370、omega2=63.50，末capture_deg=2，共18列，接管后恢复原T/P/Y/H/O/E。

继续隔离零速外环测试时，在实际进入ACTIVE、开始T日志后发送`BALSPD 0`并确认OK；该命令取消位置保持、将速度目标归0。源码没有将运行时原始零位固化，上电仍需自然下垂ZERO。手动捕捉默认仍为±8°/400ms，独立自动接管仍为±2°并检查原始/滤波/预测角、角速度及轮速。

## 验证

起摆状态机、命令解析与DMA接收、日志缓冲边界、原直立/速度/位置/转向及电机DMA回归通过。自动起摆的机械响应与接管稳定性待实测，测试不证明实车能起摆成功或精确停车返程。

历史v41验证：ARMCC5全40源文件警告视错构建通过。Code47752、RO5372、RW828、ZI19548字节，RAM20376/20480字节（含预分配堆栈），压缩ROM加载53292字节。v40备份 `MDK-ARM/speed_pid_build/before_swing_confirmed_v41/`；构建日志 `build_swing_confirmed_v41.log`。

v43修改前备份：`MDK-ARM/speed_pid_build/before_velocity_defaults_v43/`。构建日志：`build_velocity_defaults_v43.log`；控制器回归日志：`verify_velocity_defaults_v43.log`。未自动烧录或操作实车。

v43验证完成：控制器全套回归通过；ARMCC5全40源文件警告视错构建通过。Code47812、RO5436、RW828、ZI19548，RAM20376/20480字节（含预分配堆栈）。正常Keil HEX/AXF已同步，实车响应待验证。

v44验证完成：控制器全套回归通过，ARMCC5全40源文件警告视错构建通过。Code47812、RO5436、RW828、ZI19548，RAM20376/20480字节（含预分配堆栈）。备份before_swing_defaults_v44，构建/回归日志build_swing_defaults_v44.log、verify_swing_defaults_v44.log。正常Keil HEX/AXF已同步，尚未烧录，实际起摆待复测。
