lingkonglengfeng/nanhua-pendulum-car/f103_bringup/docs/新AS5600快速起摆试调.md

# 新AS5600快速起摆试调

2026-10-19。仅记录原工程调试，不写入学生待调参副本。

## 63尺度成功基线

用户附件52462d03-a018-43f8-8539-88267a523d61，fw42，起摆35%/±2圈/15秒、gain0.65/omega2=63/capture_rate2/capture_deg2。初始U ms1093994、run46，推算起摆开始1093948；U.phase3在1100989，约7041ms后接入ACTIVE。

接管角178.066°、误差-1.934°、rate+0.784rad/s、共同输出+0.150、车速约0。后续完整T记录约6秒，误差绝对值峰2.285°、原计数平均轮速绝对值峰72.62RPM；末T偏角.264°、平均14.48RPM，无X。附件末端截断，不能据此认定已保持20秒、当前位置已收敛或没有之后的退出。用户反馈“ok了”，并要求尝试缩短起摆时间。

## 第一轮提速对照

保持已成功的gain0.65、omega2=63、角速度门限2、自动入口2°、净里程±2圈及15秒失败时限，只将起摆输出限幅35%提高到40%。启动激励按原代码占限幅比例，故也随限幅相应提高；控制律、目标能量和接管条件不变。目的是加快前段能量建立，同时维持顶端接管约束，不是提高允许过顶速度。

串口先STOP、SWINGCFG40/2/15000、SWINGENERGY0.65/63/2；等待下垂静止后SWING。无需改源码或重烧录。下一轮比较从U首次时间推算的开始时刻到phase3的实际时间，并检查接管rate、首输出、后续T、净圈数和最终X；不承诺一定比原基线更快或更稳。本轮仅给UART试调配置，未驱动实车，也未覆盖源码原默认值。

## 40%首次试验未接管，下一轮缩小提速步幅至37%

附件55794311-14ea-40b5-b32e-740e56ab976f，fw42，STOP/SWINGCFG40/2/15000/SWINGENERGY.65/63/2均ACK成功，U确认实际限幅.400。重建363条有效U18，只有phase1/2、B.state仅6，没有进入ACTIVE。最近有效帧run8525、angle187.910°，离顶7.910°、rate-.282、E.991；相邻帧187.998/rate+.091显示接近该处后回落。原始200Hz极值未全记录，不能将25Hz帧极值当精确最小值，但整个状态机确实没有接管。

最终X,1301578,RUN_TIME,9,0.00,200.00,0,200,12.217,15000,0，明确15秒起摆超时；不是接管后摔倒、角度或超速退出。早期均速绝对值峰93.55RPM，后期最近顶端约8～10°，不能把这轮概括为“过顶太快”。限幅增加没有复现35%轮的7.041秒成功，说明当前近似能量控制与往复初始状态仍敏感，不能认定单加限幅一定提速，也不能唯一归因传感器或某一机械因素。

下一轮仅将限幅40%退至37%（比成功35%小幅提高），仍.65/63/2、自动2°、±2圈、15秒，其余不变。STOP、SWINGCFG37/2/15000、SWINGENERGY.65/63/2，待下垂静止后SWING。比较是否接管及耗时，不放宽捕捉条件、不改直立PID；保留35%作为已成功基线，未将试调值写入默认源码，未操作实车或学生副本。

## 37%接管成功，单次用时7.421秒，下一轮小步测试63.5尺度

附件84d310c6-9580-4567-96b6-27aafe291ed7，fw42，37%/.65/63/2配置已确认。首次SWING报BAD_ARGS只能说明启动姿态/静止/配置前置条件未满足，不能从ACK定位具体哪个量；约5秒后第二次SWING收到OK，实际起摆运行。新轮首U ms1503609/run46，推算启动1503563，U.phase3 ms1510984，即约7421ms成功接管。

接管angle178.066°、rate+.430rad/s、u+.210、均速约0；原35%轮约7041ms/rate+.784，37%此轮慢约.38秒，不能根据各一次就认定总体统计差异。可确认当前限幅提高未得到已验证提速。后续完整T约3.7秒，角误差绝对值峰2.021°、平均RPM绝对值峰55.61，末均速-23.54、位置约-1.75圈，仍有平移漂移，不能称位置保持收敛或保持20秒。末帧截断，无X，不推定最终结束原因。

接管前约5.246秒峰值仅163.213°，约6.245秒到188.262°后回落，约7.421秒才进入2°带。下一轮保持已接管的37%限幅与gain.65，只把omega2从63小步升到63.5，尝试在较早一次接近顶端时进入窗口；不增加接管允许速率/角度，也不同时改直立环或外环。65此前曾过顶过快，故使用更小试调步幅，实际能否提速仍需数据。命令STOP、SWINGCFG37/2/15000、SWINGENERGY.65/63.5/2，待下垂静止后SWING。保留63为成功参考，不覆盖源码默认，不操作学生副本或实车。

## v44：将新AS5600后的成功起摆组保存为默认

用户附件daa4fa69-6171-4c0a-8e92-1e549e29102d，fw43，上电ZERO成功，底4076/顶2028。U确认实际起摆默认仍35%/gain.65/omega2=66/capture_rate2/capture_deg2/净行程2圈/15秒。重建331条完整U仅phase1/2，B仅state6，无ACTIVE；X为RUN_TIME/9、run15000ms、peak3.99，明确起摆超时而不是直立环或轮速退出。

最近完整采样181.143度/rate-3.421，另有178.242/-3.265、178.066/-3.227。4度内完整采样角速度绝对值最小仍约2.949rad/s，高于自动捕捉2rad/s门限；原始200Hz极值未完整记录，不能由25Hz日志推定每一瞬间，但确认全程未接管。生产代码SWING未满足接管条件时调用swing_update后直接return，刚保存的速度外环PI和trim尚未参与驱动，不能把本轮失败直接归因新速度参数。

核对原始成功附件ba0f4fc9-4f52-409e-b124-4757c4baf126，实际为37%/.65/63.5/2：首U1673949/run46，phase3在1680404，约6501ms接管，角181.934、rate-.425。v43只保存了用户当时指定的速度参数，未保存该临时起摆组，所以断电重烧后恢复旧35%/66。

按本次修正要求，Core/Src/balance_swing.inc默认改37%与omega2=63.5，保留gain.65、2rad/s、自动2度、2圈、15秒及所有接管检查。速度外环.040/.0015/3与trim-.81沿用v43，固件号改0x103C8044。没有放宽捕捉带或角速度门限，没有改学生待调参副本或固化传感器原始零位。恢复的是曾成功的试验组，不保证所有初始状态或当前标定下必然接管。

修改前源文件、默认值测试、参数文档及v43HEX/AXF在MDK-ARM/speed_pid_build/before_swing_defaults_v44。现有起摆默认值断言同步，能量符号算法测试显式保留其旧35%夹具。verify_balance.ps1全套通过；ARMCC5全40源文件警告视错构建通过，Code47812、RO5436、RW828、ZI19548，RAM20376/20480字节（含预分配堆栈）。日志build_swing_defaults_v44.log和verify_swing_defaults_v44.log，正常Keil HEX/AXF已同步，未烧录或操作实车。

## v44实测：约5.046秒接管，后段仍是位置保持模式

附件19dec0d7-e942-44d4-9343-4b412c98a698，fw0x103C8044，SWING ACK3/OK。U确认默认37%/.65/63.5/2rad/s/2度/净2圈/15秒已生效。首次U ms74629/run46，推算开始74583；phase3于79629，约5046ms接入ACTIVE。接管angle181.670度、rate-1.095rad/s、共同输出-.182、robust-.04RPM，符合保留的2度/2rad/s等接管检查。B确认底4076/顶2028，与此前旧传感器试调参照4073/2025不同；trim仍源码-.81，后续零速比较需要固定此次标定，不直接混用旧参照的偏置试验。

直立运行到用户串口stop ACK4/OK，X为STOP/1、run7266、raw-1.318度、peak22.21<200、overspeed0；不是起摆未接管或保护退出。此记录支持本次成功接管并运行约7.3秒，不代表连续20秒、重复成功率、位置或零速已稳定。首秒T均速约+38.47，随后各秒-8.86/-38.25/-35.99/-26.89/-15.71/-14.26RPM，先有接管过渡后仍漂移。

全程未见BALSPD0，P.seq_state始终5，末P.pos-1.786圈、goal0、target/command均+6RPM；默认位置环在请求回到捕捉点，不能把本轮当目标恒0的纯速度对照。V实际外环.040/.0015/3、trim-.81，7秒I-.163度、filtered-15.01RPM。下一轮不改起摆/直立/速度参数或源码：等待自然下垂静止后SWING，实际开始T后BALSPD0确认OK，检查P.state0、target0及斜坡command归0，再观察零速的持续漂移/过冲。固定当前ZERO、提前STOP避免障碍。此次仅分析记录与后续UART测试说明，无源码默认变更、无操作实车或学生副本。

## 2026-10-20 18:50：更换场地后未到顶，先串口试omega2=65

用户附件257be4de-48b9-4e8b-8f72-57af17cfcae0，fw0x103C8047，反馈换地点后无法起摆。SWING ACK4/OK，底4072/顶2024，实际参数37%/.65/63.5/接管2rad/s/2度，净2圈、15秒。373条完整U中phase1两条、phase2共371条，没有phase3或T。X为RUN_TIME/9，run15001ms、peak.08、overspeed0，明确起摆超时。

最近完整采样在run11366：bottom_deg193.447、rate-.119rad/s、E.973、u-.006，距顶13.447度，相邻194.063/-.640、194.150/+.423显示在此处回落。后期多次在距顶约13～16度折返，没有到2度接管带；这与上次旧35%/66过顶约3rad/s的失败不同。25Hz采样极值不能等同200Hz全部极值，但状态机全程未接管确定。场地改变可影响驱动响应，未独立识别摩擦、打滑、电池或机械因素，不断言其中某项已证实。

本轮先做串口单参数对照：STOP、SWINGENERGY .65 65 2；待摆杆自然下垂且车静止后再SWING。保持输出37%、gain.65、接管2rad/s及2度、15秒和其它控制参数，当前标定保持，不反转方向、不放宽接管、不直接增加输出。omega2从63.5提高约2.36%，在同样角度/角速度下使估计动能降低，从现有代码能量误差项增加补能倾向；实际是否足够到顶及是否变成过顶需下一轮U验证，不能由本轮日志精确算出最优尺度。

这是临时UART试调建议，无需重新烧录；源码默认仍保留37%/63.5，等待新场地有效日志后再决定固化，学生待调参副本未动，未自动操作实车。当前附件没有直立运行段，不能据此评价或修改速度外环和BALSTEP效果。

## 2026-10-20 18:57：65已接管但0.376秒后超速退出，下一轮64.2

附件7fd9d826-bf59-4d9a-bf9c-4b053cc8fca1，fw0x103C8047。STOP/SWINGENERGY.65/65/2及SWING均ACK成功，底4072/顶2024同上一轮，U实际37%/.65/65/2/2度。完整U仅记录到run5886附近，之后存在附件片段缺失，未见完整phase3/B/V接管帧；不能用仅有完整U距顶14.678度误判整轮没接管，也不能把串口缺片当200Hz控制任务时间间隔异常。

末两条完整T分别552999与553039、state4，角-5.449/-3.604度、均速200.61/205.91RPM、参考角+2.430/+2.830、u+.800/+.686，位置模式5。X,553054,SPEED,8,218.95,200.00,200,200,-2.549,376,0，明确ACTIVE接管后376ms因任一原始计数测速绝对值超过200RPM持续200ms退出；不是起摆15秒超时或角度30度退出。由X反推接管时刻约552678，首U546204/run46反推起摆546158，约6.520秒接管。用户明确全程无接触、无障碍物，因此后段急加速为有效无接触闭环响应，不能剔作碰撞；接管瞬间的角度/角速度/轮速缺失，根因不能唯一归为过顶角速度过大。

上一轮63.5未进2度带，65本轮能接管但接管后速度失控。下一轮将omega2从65小步回收至64.2，其它37%/.65/接管2rad/s/2度及直立、速度外环均保留，固定当前ZERO：STOP、SWINGENERGY .65 64.2 2，等下垂静止后SWING。目标为比较接管过渡，而非宣称64.2已是安全或最优能量尺度；若仍快速加速，应继续核查完整接管状态和速度外环动态，不提高超速阈值掩盖问题。建议收集从U切到第一条B/V/T的完整日志。此次串口试调，无源码默认变更、无自动烧录/驱动实车，学生待调参副本未动。

## 2026-10-20 19:00：64.2未到顶，下一轮64.6并统一自然下垂起始条件

附件1f0e3e28-7479-4fb1-bb5f-d394ba29f130包含两轮：前段重复18:57的65接管后SPEED退出，不能把前段T/X混入64.2轮。19:00:11 STOP/SWINGENERGY .65 64.2 2 ACK8/9成功，19:00:15 SWING ACK10成功。新轮B底4072/顶2024保持，U参数37%/.65/64.2/2/2度，完整新U仅phase1/2，无本轮phase3/T；末X,722889,RUN_TIME,9,4.80,200,0,200,30.234,15001,0为15秒未接管超时。

最近完整采样run14765：bottom190.371、rate-.236、E.984；后帧190.547/+ .104表明回落，距顶约10.371度。此前run12806也在190.986/+.059折返。本轮尚未到2度自动接管带，不能认定64.2解决了接管过冲或已成功直立。

首U run45已为bottom335.742，即离自然最低点24.258度，rate+1.535rad/s；前65轮首U在run46为0度/rate0。仅凭首帧不能还原启动瞬间的每个量，但其明显不同于自然下垂静止基线，两轮不能作为严格等初态单参数试验。原启动条件允许最低点附近±30度/较低瞬时速率，可能接受偏底较大的起始姿态，不能用ACK成功代替每轮起始条件一致性。

下一轮保留37%/gain.65/接管2rad/s与2度、其它控制参数及当前ZERO，omega2试64.6，作为64.2与65之间的小步对照，不宣称线性插值或最优值。STOP、SWINGENERGY .65 64.6 2，等杆完全自然下垂且静止、小车静止后再SWING。固定起始条件与完整接管日志比继续仅依据过冲/欠冲标签更有助判断。参数仅UART临时试调，源码默认63.5不变，未自动驱动实车或改学生副本。

## 2026-10-20 19:02：重复64.2从下垂启动已接管，转为收紧自动接管条件

附件8ad7582a-7d8f-47fa-bbcd-5d70b0c83183包含65、64.2欠摆和19:02:34的新一轮。新轮没有SWINGENERGY64.6回执，U明确仍为37%/.65/64.2/接管2rad/s/2度，不能当64.6结果。新首U847544/run45：bottom0/rate0，较上一64.2轮首帧离底24.258度、rate1.535的初态更接近标准自然下垂。

新U.phase3在857574：bottom181.758、upright误差+1.758度、rate-.959rad/s（约55度/秒）、E1.007、u-.214、均速0。由首U推算启动847499，约10075ms接管，证明本轮64.2已经可以到顶，之前以欠摆与65之间建议64.6不再适合作为下一步加能量依据。底4072/顶2024、速度外环.040/.0015/3、trim-.81保留。

接管后121ms误差-4.131度、rate-.672、u+.646、均速87.97；161ms均速154.06/u+.8，200ms附近原始峰超过200；281ms误差-6.680度、u+.8、均速204.37。位置模式5请求由0变-6RPM，斜坡在321ms才-2.42RPM，参考角已+2.305度。X,857964,SPEED,8,200.75,200,200,200,-.791,391,0，明确接管后391ms超速200ms退出；角度未越30度。用户明确该新轮全程无接触、无障碍物。因此不能按碰撞剔除，也不能笼统称未起摆或认定纯能量超调；直立PD、速度外环和捕捉动能均可能影响，日志不能唯一识别根因。

下一轮停止升至64.6，保留omega2=64.2和输出37%、gain.65，仅将自动接管组从2度/2rad/s收紧为1度/.6rad/s。STOP、SWINGCATCH1、SWINGENERGY .65 64.2 .6，等自然下垂静止后SWING。原/滤波/40ms预测角检查及速度保护均保留，手动8度/400ms与内外环参数不动。目的为减少接管时剩余运动的试验对照，不宣称一定能接管或根治后段加速；如15秒仍没有低速入口，应根据U轨迹再调能量与接管过渡，而非放大超速阈值。当前仅UART临时建议，无源码默认变更、无自动驱动实车或学生副本改动。

## 2026-10-20 19:07：窄入口轮尚未到顶，保持入口后试64.6

附件4d0343b9-b2dc-4373-8a78-e6a9576a5cf0，fw47，STOP/SWINGCATCH1/SWINGENERGY .65 64.2 .6/SWING均OK。U确认37%/.65/64.2/1度/.6rad/s；新标定底4075/顶2027，较此前4072/2024变3计数约.264度，不能将其夸大为12度欠摆根因。首U run46为bottom359.473/rate+.020，接近自然下垂。完整372条U仅phase1一条、phase2共371条，无phase3/B.ACTIVE/T/V。

最近完整帧run13485：bottom192.217度，距顶12.217度，rate-.120，E.977；相邻192.656/-.677及193.008/+.452显示在该处回落。后期多个周期在距顶约12～14度折返，最终X RUN_TIME/9、run15001ms、peak25.24、overspeed0。说明本轮未进入1度角带，不能单独归因.6rad/s门限过严，更没有检验接管冲击改善；与上一64.2成功接管轮的差异不应直接由捕捉门限解释，因为生产能量控制直到接管前不使用这两个门限计算驱动。场地、初态、电源或执行差异仍未独立识别。

下一轮保留窄入口1度/.6rad/s，输出37%和gain.65不动，仅把omega2由64.2试到64.6：STOP、SWINGENERGY .65 64.6 .6；自然下垂且小车静止后SWING。保留本轮ZERO，避免再次改变参考。目标为先到达窄入口，并观察是否存在低速接管机会；若过顶但仍不能低速接管，应从U轨迹再调能量余量或交接控制，不能认定此前64.2一次成功已建立可靠起摆重复性。本次无源码默认变更、无自动驱动实车或学生副本改动。
