lingkonglengfeng/nanhua-pendulum-car/f103_bringup/docs/更换AS5600后起摆未接管分析.md

# 更换AS5600后起摆未接管分析

2026-10-19，用户更换AS5600后发送附件7a9026cc-9323-4b57-bf79-57bbefa333f9，串口时间20:11～20:12。只分析原工程v42，不修改学生待调参副本，不改控制参数或烧录实车。

## 日志能确认的原因

- 最先SWIN被拒绝是指令拼写问题，随后SWING收到OK并实际运行，不是最后失败的原因。
- 固件头0x103C8042；B显示200点最低点标定成功、bottom4065/upright2017、传感器/角度有效。起摆配置仍0.65/66/2、35%/±2圈/15秒，接管2°。
- 重建373条完整U18，仅phase1/2、B.state仅6，没有ACTIVE接管。末X为RUN_TIME/9、run15000ms、overspeed0，属于起摆超时，不是角度或超速退出。
- 已多次通过顶端：ms96539角178.857°、rate-2.767rad/s；ms97379角179.033°、rate-2.641；ms98219角178.418°、rate-2.825。均超过接管速率上限2rad/s，且40ms预测角明显超出±2°，不会接管。
- 较早一次ms91179角181.670°、rate-1.754，速率虽在2以内，但按滤波角近似计算40ms预测误差约-2.350°，也已超出2°。实际代码用原始未滤波角预测，不能将该近似当作该5ms周期全部条件的精确回放。
- 因而本轮直接症状是过顶运动未满足动态接管条件。不能把经过180°就算自动进入直立，也不能据此断言新AS5600损坏或零点方向必然错误。

## 换件后还需核对

初始正向驱动使底部角先从0变为358°附近，与此前方向趋势相符，没有从此日志得到需要反转PENDSIGN的证据。ZERO已重新学习最低点，但尚无手扶物理最高点的静态Q数据，无法确认新安装的角度误差、磁铁偏心或间隙影响。B.valid仅说明程序的通信/磁场有效性条件通过，不保证角度精度；本日志也不包含芯片CONF、AGC或MAG寄存器，不能推定新旧内部滤波设置相同或不同。

当前v42的AS5600命令可在STOP及LOG0时读取最新C/S/Q，并不额外操作电机。下一步先STOP，摆杆自然下垂稳定后发AS5600；再手扶到实际竖直最高点，稳定后再次AS5600。两次均保留完整C/S/Q，最高点附近不要重新ZERO。比较原始计数是否相差约半圈2048，关注MD=1、ML=0、MH=0以及读错误计数增量。最低点标定4065对应软件期望最高点2017，但需实际手扶测量核实，不能拿计算结果充当测量。

先核对新传感器静态角度与磁场，保留现有PID、2°/2rad/s和40ms预测门限；不直接放宽接管速度或同时提高起摆能量。确认安装/读数后，若实物确实过顶太快，再单独小步减小加能尺度或强度作对照。原厂安装参考：[AS5600适配板机械设置与磁铁对中](https://look.ams-osram.com/m/4f8342513a447495/original/AS5600_UG000254_2-00.pdf)。
