lingkonglengfeng/nanhua-pendulum-car/f103_bringup/docs/自动捕捉与当前位置保持.md

# 自动捕捉与当前位置保持

2026-10-18，固件 `0x103C8036`。用户要求默认保持当前位置，扶到180°±8°进入倒立。捕捉窗口由±1.4°改为±8°，仍需连续400ms；成功进入ACTIVE时，自动把进入时的四轮平均里程设为0、目标设0并开启位置保持，不再需要单独发送BALHOLD/BALPZERO。

上电仍需最低点标定。自然下垂且小车静止发送STOP、ZERO；成功后自动等待捕捉。扶到172°～188°范围内连续400ms即可进入并尝试守住进入点，边界按原始角度判断；离开窗口、样本无效或控制间隔不连续会重计捕捉时间。无需另外设置最高点角度。不是上电未经标定直接驱动。

捕捉原点只在进入ACTIVE时记录一次，后续偏移会由位置P产生回正速度，循环中不会把原点不断追随小车重置。每次STOP/故障后重新ARM并捕捉，将以新的进入地点为0，不返回上次试验原点。退出后仍不自动重新捕捉，需ARM。位置保持启用时P.seq_state=5、pos/goal初始均0。

保留显式设置：BALPOS/BALHOLD/BALPZERO可重选目标，BALSPD取消保持转为手动速度，非零BALTURN取消保持转向。用户明确通过BALVEL0/0禁用速度外环时，不强行启用位置模式，仍只运行角度控制；默认速度外环开启，因此默认捕捉即自动保持。

退出±30°、200RPM连续200ms、80%共同输出/12%差动、位置P20及速度上限6RPM、原角度/速度/转向PI和X一次性退出诊断保留。放宽捕捉并不保证从±8°都能恢复，位置保持的实际范围和抗推能力仍待实车整定。旧脚本若发BALWIN1.4/30/400会覆盖新默认，应以B行实际参数为准。

控制/位置/转向/退出事件与生产串口回归通过；新边界检查8.01°不捕捉、7.99°连续395ms不足/400ms成功并自动进入位置保持、捕捉后不发任何位置命令也会对正反里程偏移请求回正、原点不在循环中变化、重新捕捉新原点、显式关闭速度外环不启用位置模式。ARMCC5全40源警告视错编译通过，未自动烧录或运行实车。正常Keil HEX/AXF已同步，v35备份before_auto_hold_v36，构建日志build_auto_hold_v36.log。
