lingkonglengfeng/nanhua-pendulum-car/f103_bringup/docs/自动起摆顶端接管修正.md

# 自动起摆顶端接管修正

当前v41（0x103C8041）：用户确认SWINGENERGY0.65/66/2起摆成功，默认能量尺度从65固化为66，35%/±2圈/15秒、自动接管2°与本页v40逻辑保持。未收到成功轮完整日志，尚不能确认连续20秒保持或重复成功率。下文v40使用65的参数为历史试调值。

2026-10-18，固件 `0x103C8040`（v40）。自动起摆接管范围单独收窄到最高点±2°；手扶ARM启动仍是±8°连续400ms。保留直立PID、轮位/方向、±30°退出和200RPM连续200ms的原始轮速退出条件。

## 本轮日志说明

附件65101f07-04c6-42d7-bdd9-a458eee01450中，22:12运行确认使用v39、SWINGENERGY0.65/65/2和35%/±2圈/15秒。约6秒后出现U.phase3和B.state4，已经自动接入直立，随后约1.386秒X.ANGLE退出，冻结原始偏角-30.410°。用户确认该次碰到障碍物，末段不能作为无外力失稳证据；用户又补充重新试仍因追杆加速、轮速达到阈值退出，但未提供那次完整日志，因此不能断言其精确退出码。

本日志能够直接确认的接管问题：接管前共同输出约-0.021，接管时滤波偏角+8.086°、角速度-0.815rad/s、车速近0，立即得到共同输出-0.800。原始角已进入8°带，但三点中值滤波仍略大于8°，原PD在此状态要求约-1.05并饱和到-80%。约120ms后的平均车速已约-106RPM，后面反向追杆最高平均约176RPM。这说明此前将手扶用的宽捕捉带直接用于动态起摆，会在较大偏角时切入高增益控制。不能据此断言它是所有后续失稳的唯一原因，也不把撞障碍后的角度突变用于调PID。

## v40变化

- 新增独立 `g_swing_capture_deg=2.0`，串口 `SWINGCATCH deg` 可调0.5～4°，修改会停止。实际自动接管角带取该值与手动BALWIN入口角的较小者。
- 原始角、滤波PID角和40ms线性预测角都必须在自动角带内，且保持原角速度≤2rad/s、最近轮速峰值≤90RPM并≤当前超速阈值的条件。未满足时继续原能量起摆，直到成功或原有退出条件触发。
- 手动±8°/400ms和接管后的进入点位置保持保留。不增加接管输出斜坡、不同时改直立PID或速度外环，以便单独比较接管范围的效果。
- 将本轮已达到自动接管的起摆参数写为默认：`SWINGENERGY 0.65 65 2`、`SWINGCFG 35 2 15000`。65仍是试调能量尺度，不是自由摆辨识得到的机械参数。
- U末尾追加 `capture_deg`（实际有效自动角带），现在18列；起摆头SWING_TRACE_V2，完整CSV_V22。正常BAL_TRACE_V2及旧T/B/V/E/P/Y/H/O/X列数不变，起摆仍40ms、直立仍20ms。

更窄入口改善的是接管时的初始状态，不能保证当前直立环能从任何扰动恢复，也不能替代无碰撞试验。

## 烧录后测试

正常KeilHEX与AXF已同步到 `MDK-ARM/f103_bringup/`，本轮没有自动烧录或驱动实车。烧录后杆自然下垂、车静止：

```text
STOP
ZERO
```

静止等待至少约1秒标定完成，再单独发送：

```text
SWING
```

默认参数已经写入，无需再发配置。需要显式恢复时可用：

```text
STOP
SWINGCFG 35 2 15000
SWINGENERGY 0.65 65 2
SWINGCATCH 2
SWING
```

不把SWING与刚发的ZERO直接连在同一立即执行批次。自动起摆试验留出运动空间，避免碰障碍；原里程边界是编码器平均净圈数，轮径未知且不能补偿打滑，不能视为准确米制边界。STOP撤驱动仍为滑行，失败后不自动重试。发回完整U、接管T与X，并说明是否有接触。

## 验证与资源

生产控制回归回放原始7.998°/滤波8.086°/-0.815rad/s，v40继续起摆；另验证2.01°原始角与滤波角拒绝、预测角/速率/车速拒绝、两侧接近顶端接管、实际速度继承与原点保持、手动更小入口限制、非法Watch值退出，以及原STOP/超时/超速/传感器/计时回绕。原手动8°/400ms、直立/外环/位置/转向回归通过。生产新命令的上下界、缺参/NaN拒绝、修改停止起摆、原RXDMA长命令与退出打印回归通过。

日志U18、首次接管包1466/2048字节、全GET+U1563/2048字节边界验证通过。HELP压缩冗余说明后与多条ACK同包仍不溢出。测试是软件注入/格式化验证，未验证新接管方式的实车稳定性。

ARMCC5全40源、警告视错构建通过：Code47752/RO5372/RW828/ZI19548字节，RAM20376/20480含预留堆栈，压缩ROM加载53292字节。v39源/固件备份 `MDK-ARM/speed_pid_build/before_swing_capture_v40/`，构建日志 `build_swing_capture_v40.log`。正常/脚本HEX SHA256均为 `37DB7A2C704C65DEFA31F5AC2D77028A6587B68DEE532D0768EE9AF0E9F17767`。
