lingkonglengfeng/nanhua-pendulum-car/f103_bringup/docs/驱动正反向衰减模式差异.md

# 驱动正反向衰减模式差异

用户确认比较方式为串口 `OPEN 0 10`：通道0约10%即能起转，其他通道约50～60%才开始转。此前仅按普通电机死区描述不够完整，软件驱动方式本身存在已确认的不对称；具体起转差异是否主要由此引起仍待实物对照。

## 源码与数据手册核对

现有四路同用TIM1、20kHz、PWM1、相同极性。g_mot_sign={-1,1,1,1}。OPEN命令和闭环输出均先乘电机符号，再按IN2固定方向、IN1输出PWM的关系控制。

AT8236原厂数据手册S409-V1.1第5页明确给出：IN1=PWM、IN2=0为正转快衰减；IN1=PWM、IN2=1为反转慢衰减。逻辑00滑行、11刹车，导致同一PWM脚在两个电气方向采用不同的续流状态。来源：[杭州中科微AT8236数据手册，第5页](https://static.chipdip.ru/lib/795/DOC042795118.pdf)。这不是PWM定时器通道0极性被单独反相。

| 命令 | 电气方向 | IN2 | IN1高电平占比 | 有效驱动占比 | 衰减模式 |
|---|---|---:|---:|---:|---|
| OPEN 0 10 | 反向 | 1 | 90% | 10% | 慢衰减，驱动/刹车切换 |
| OPEN 3 10 | 正向 | 0 | 10% | 10% | 快衰减，驱动/滑行切换 |
| OPEN 3 -10 | 反向 | 1 | 90% | 10% | 慢衰减，驱动/刹车切换 |

占比按程序目标值描述，实际寄存器存在整数舍入。通道0的IN1高电平90%对应多数时间11刹车，实际反向驱动发生于IN1低、IN2高的10%时间，不能将CCR高电平比例直接当作实际驱动力比例。

## 下一步对照

无需新固件，现有0x103C8011/12均可。架空，仅测试右前轮同一个电机，逐条发送：

```text
STOP
OPEN 3 10
```

观察约2秒，STOP并等轮子停稳，再单独发送 `OPEN 3 -10`，观察约2秒后STOP。保存回执与C/D/F日志，反馈两个方向能否起转。如果正向10%不动、反向10%能动，则支持衰减模式是主要影响因素；若两者都不动，还需检查机械负载、模块差异或实物驱动输入波形。

负号仅用于这次电气反向对照，不修改g_mot_sign、g_enc_sign和轮位映射。没有新增启动强推或最低PWM补偿。本次只记录核对与试验步骤，固件仍为0x103C8012；先核对驱动方式，再据闭环实测决定参数与测速滤波是否合适。

## 03:02:25 对照结果

实际板上仍为0x103C8011（不是已构建但未下载的12版），原始与归一化数据位于 `logs/2026-10-18_030225/`。OPEN 3 10和OPEN 3 -10均成功回执。

正10%段共73条完整数据，197253～200903ms，CCR360、DIR0，计数40652完全不变，测速全0。负10%段共180条，200953～209953ms，CCR3239、DIR1，计数40648下降到38824，连续反转约26RPM。其它三路计数不变，控制周期5ms、漏周期0。

同一个轮子在相同10%有效驱动比例下，快衰减方向不动、慢衰减方向持续转动，强烈支持方向相关驱动模式是起转差异的重要因素。不能仅把差异解释为四个电机的普通摩擦差异；仍不等于供电、机械、编码器的所有问题均已排除。

下一步先统一所需运行方向的驱动模式，再做PID标定。当前每个电机只有IN1接硬件PWM、IN2接普通GPIO，在此分工下仅修改g_mot_sign不能使两个物理转向都采用同一种衰减模式。若允许接线改动，可使各轮主要前进方向使用相同的慢衰减，并同时更新方向符号；若要求双向都一致，则需重新设计两路输入的PWM控制。未据此自动翻转方向符号、改接线或替换固件，避免软件与实物状态不匹配。

本截取末尾仍是OPEN反转，未出现STOP回执，结束观察应显式STOP。

用户随后明确接线焊死并要求软件修改。已实现0x103C8013固定引脚双向慢衰减DMA波形，不执行换线/全-1符号方案。详见 [不改线双向慢衰减PWM](不改线双向慢衰减PWM.md)。此前“需要改两输入PWM”的条件通过GPIO DMA完成，并非必须改动实体接线。
