lingkonglengfeng/nanhua-pendulum-car/f103_bringup/tools/as5600-monitor/as5600-monitor.html

# AS5600 实时角度

支持直立 T、起摆 U 与 AS5600 Q 串口数据

历史日志电机状态未知

当前浏览器无法使用串口。请用桌面版 Edge / Chrome 打开本页；日志导入仍可使用。

连接串口断开连接启用日志GET 状态读取 AS5600STOP 停止电机

先关闭串口助手对同一 COM 口的占用。连接后立即接收；“读取 AS5600”单次查询当前机械角、磁场和通信计数，停止或 LOG 0 时也可用（需 v42 固件）。

已载入内置实际日志，可直接查看。选择串口后切换为实时数据。

115200 baud · 8N1
PB10 TX / PB11 RX
固件 —

当前角度

—°

原始值 — / 4095

—

磁场状态（最近 Q）

等待数据

MD — · ML — · MH —

等待 Q 磁场数据

已知有效性样本通过率

—%

0 个角度样本

I²C 通信错误

—

成功读取 — 次

## 角度 / 时间

角度读数已报告无效

显示 时间窗 自动纵轴跨圈连续角度暂停曲线清空曲线

色带：绿=有效，灰=未上报有效性，黄/红=无效；悬停查看样本。历史数据

## 角度与磁场状态

检测到磁铁 MD—

磁场过弱 ML—

磁场过强 MH—

STATUS 寄存器—

角度有效 valid—

顶端偏角—

最低点角度—

角速度—

控制输出 u—

收到数据后显示状态。

## 串口指令

GET发送

“读取 AS5600”发送 AS5600，返回 C / S / Q，不改变运行状态。GET 与周期日志仍仅在直立运行或起摆时输出参数。Enter发送，Shift+Enter换行；每条指令自动添加CRLF。

尚未发送指令

导入日志查看内置日志导出角度CSV保存接收日志

数据来源 —

最新串口内容

Q / T：机械角；T / B：相对顶端偏角；U / B：相对最低点角度。T / U 未提供磁场寄存器，不推断 MD / ML / MH。解析正常
