lingkonglengfeng/nanhua-pendulum-car/f103_bringup/docs/直立环50Hz精简日志.md

# 直立环50Hz精简日志

固件0x103C8024；仅增加诊断日志模式，角度控制、速度外环、10ms滤波、方向和保护均与v23相同。已编译、未自动烧录。

## 当前实测结论

- 06:00附件 `94d23a53-82b0-443f-b671-3537edbbddd5`：8/0/0.205、50%限幅、外环0.035/0/3、变化率10°/s。用户明确反馈高频抖动并撞桌停住，不清楚碰撞时刻及碰撞后是否仍驱动。因此不能把日志任何尾段停住或速度变化当作独立闭环稳定证据。所见外环参考达到+3°、输出多次达到+0.5，100ms采样不能可靠辨识振荡频率。
- 06:02附件 `a3f6e567-8836-4001-83c9-56a8efaa96e7`：8/0/0.205、70%限幅、180RPM/4000ms，外环0.035/0/3、10°/s。用户确认松手且没有碰桌或提车。中段摆角较小，但车由正向运动转为反向持续加速，末最大单轮约182RPM，尚未实现零速稳定。与上一轮相比同时变化了输出限制、最低点零位及捕捉初态，不能把效果单独归因于70%输出。
- 06:03附件 `16d88cc7-0e41-4b09-ae2d-c0f2d9d24da2`：8.8/0/0.205、70%限幅、180RPM/4000ms，外环同上，bottom4061/upright2013。36条完整B覆盖174059～177959ms，即3.9秒，采样偏角-2.549～+1.582°，所采样基础滤波最高单轮115.16RPM；外环滤波均速-58.35～-8.34RPM。相对前轮少了迅速单侧跑到180RPM的表现，但仍抖动且反向漂移。用户反馈“抖动但是保持了很久”；本次是否全程无接触未另外确认。末V.run_ms3900，接近4000ms保护，可能为定时退出，需Watch确认reason=9，不能据日志截止直接认定。

上述原文均位于 `C:/Users/14449/.codex/attachments/<附件ID>/已粘贴的文本.txt`。实车结果已表明示意模型不能预测本车振荡，不再用模型收敛代替实测稳定结论。

## 使用与字段

串口 `BALTRACE 1` 切换精简日志，修改会STOP；`BALTRACE 0` 恢复原全量CSV日志。默认0。LOG仍是总开关：LOG0时不周期打印。两模式均只有BAL_ACTIVE才打印参数，非运行GET仍仅回执，RX/ACK/HELP在所有状态保持工作。

精简模式固定20ms周期（标称50Hz），不受PERIOD影响；PERIOD保存的全量日志周期不变。控制与AS5600仍5ms/200Hz，不因日志改变。忙包、命令回执和首包会造成个别采样间隙，应使用ms实际时间戳，不能假定每行严格20ms。

每次进入ACTIVE，先发短协议头、B/V配置和首T；随后每20ms发T、每1秒附B/V，退出后不再提交新参数包。主动GET在ACTIVE仍返回全量状态，可能临时占用串口带宽。精简模式不是在原D/F/Q全量日志之上追加50Hz数据，避免115200串口拥塞。

```text
#F103_BAL_TRACE_V1,baud=115200,period_ms=20,fw=0x103C8024
#T,ms,raw,error_deg,rate_rad_s,u,mean_rpm,ref_deg,guard_rpm,state,reason
```

T共11列：raw为最新AS5600原始计数，error_deg为中值处理后相对物理顶端的角度；rate_rad_s为10ms低通角速度；u为归一化直立输出；mean_rpm为四轮基础滤波有符号均值（外环关闭时仍可看）；ref_deg为外环参考角，guard_rpm为最大单轮绝对RPM；state/reason沿用原值。raw与滤波角存在延迟差，不能当成同一未滤波读数。

## 下一轮记录

新HEX路径仍为 `MDK-ARM/f103_bringup/f103_bringup.hex`。固件默认外环关闭、试验保护40RPM/1500ms；烧录复位后需要重新设置参数和ZERO。先不要继续增加P或输出上限。

保留最近8.8/0/0.205作为诊断比较参数，不表示这组已稳定。为了观察抖动而不改变更多控制变量，可以在具备足够行程、没有桌子阻挡的场地保持这组参数做一次短记录；新模式通过 `BALTRACE 1` 启用。仍保留超速/角度/定时退出保护，不为延长记录而禁用或放宽保护。新命令会停止，不会自动启动；只有后续ZERO或ARM并完成手扶400ms才进入运行。

## 验证

生产串口解析回归通过：BALTRACE仅接受0/1、非法值原子拒绝、修改停止；旧指令和RX DMA回归通过。生产格式函数验证11列T、有符号均速、协议头、周期选择、极值包边界；首包441/2048字节，50Hz最坏估算含每秒配置不超过3900字节/秒。完整CSV和GET回归通过。保留原状态快照与提交DMA前两次ACTIVE检查，没有新增退出后参数打印。

ARMCC5全量40个源文件，警告视为错误构建通过：Code39380、RO4004、RW680、ZI19528；链接RAM20208/20480字节（含已预留堆栈），ROM43508字节。固件未自动烧录、没有自动驱动电机。v23源码与HEX/AXF备份在 `MDK-ARM/speed_pid_build/before_balance_trace_v24/`。
