lingkonglengfeng/nanhua-pendulum-car/f103_bringup/docs/首轮速度环日志分析.md

# 首轮通道 0 速度环日志分析

输入为用户串口助手记录，MCU 时间约 29～9809ms，固件 0x103C800B。接收分包已合并，提取 161 条完整 D 记录，其中 60RPM 运行记录 127 条，末尾截断记录不参与统计。

## 结果

| 项目 | 实测 |
|---|---|
| 通道 0 目标 | 60RPM |
| 最后 2 秒平均 / 标准差 | 59.698RPM / 0.924RPM |
| 最后 2 秒范围 | 57.19～61.90RPM |
| 全段最大超调 | 约 3.17% |
| 最后 2 秒平均输出 | 0.21738，约 21.7% |
| 输出饱和 | 无 |
| 指令 | STOP、SET、RUN 均 OK，RX/指令/DMA 错误为 0 |
| 采样间隔 | 首条初始化 5ms，其余 160 条全为 30ms |
| 每周期执行时间 | 全部为 26ms |
| 最终累计漏周期 | 1630 |

通道 0 本次运行的反馈方向正确。其它轮目标/反馈均为 0。第一条运行记录已达到 15.88RPM，故不能精确还原指令执行瞬间；从第一条运行记录起约 3.96 秒后，后续采样全部落在 ±5% 范围内。

当前 Kp=0.001562、Ki=0.003905、Kd=0 能实现稳态跟踪，但启动响应偏慢；周期异常解决前，保留参数，不根据这次记录直接增加 Ki。

## 周期异常与固件修订

ControlTask 在测速/PID 前调用 AS5600 阻塞式 I2C 读取。本地 HAL_I2C_Mem_Read 在使用传入的 4ms 超时前，会先走独立的固定 25ms BUSY 等待（I2C_TIMEOUT_BUSY_FLAG）。这与日志中 26ms 执行时间高度吻合；当前记录没有分段耗时和 BUSY 状态，仍需新版诊断确认设备上的实际原因。

固件 0x103C800C 对独占同步 I2C 的新事务先检查 BUSY：已 BUSY 时立即跳过本次读取，清除残留 AF 错误并沿用既有 100ms 限频总线恢复，不进入 HAL 的固定长等待。正常读取、4ms 超时和原有错误处理保留；没有改变电机使能或增加停机条件。

新增 g_as5600_read_time_ms 和 g_as5600_busy_skips。协议标记变为 CSV_V2，D/C 列仍为 49/28 列，S 扩展为 22 列，末尾增加 as_ms、as_busy_skips、as_valid、as_ok、as_errors。

下一轮仍用 60RPM、相同 PID，检查 dt_ms 是否约 5ms、missed 是否不再持续增加，并结合 S 的 AS5600 诊断判断修复效果。其它 I2C 超时路径或总线状态仍可能造成偶发超期，须以新实测为准。

## 验证及产物

AS5600 BUSY 路径、串口指令/RX、CSV 格式三组本机回归通过。39 个源文件 ARMCC 编译/链接通过，Keil 自身 Rebuild 为 0 Error、0 Warning；静态 RAM 17608 字节、ROM 34608 字节。未自动烧录。构建脚本已兼容 Keil 文件组中的头文件条目。

数据和响应图位于 logs/2026-10-18_014057：raw.txt、normalized.csv、summary.json、wheel0_response.png。分析脚本为 tools/analyze_speed_log.py。
