lingkonglengfeng/nanhua-pendulum-car/pendulum_rod_weight/output/配重安装与调试说明.md

# Ø8 摆杆可调配重

此配重套在摆杆上，随摆杆转动，不装在小车底盘上。两组分体夹环在轴向夹住 M8 金属平垫片；增减垫片调质量，松开夹环沿杆移动调位置。原 V3 01–10 号零件均不需改动或重打。

## 打印和采购

| 物料 | 数量 | 规格 |
|---|---:|---|
| 11_weight_clamp_head | 打印 2 件 | 每组夹环的螺丝头侧，26×6.7×8 |
| 12_weight_clamp_nut | 打印 2 件 | 每组夹环的螺母侧，26×6.7×8 |
| M2.5×16 螺丝 | 4 | 模型参考头径 4.5、头高 2.5；两颗固定一组夹环 |
| M2.5 六角螺母 | 4 | 对边约 5、厚约 2；打印螺母窝对边 5.2、深 2.4 |
| M2.5 平垫圈 | 4 | 内径约 2.7、外径约 5、厚约 0.5，放在螺丝头下面 |
| M8 金属平垫片 | 先装 2 片，可买 10 片备用 | 内径 8.4、外径 16、厚 1.6；不要买弹簧垫圈或大外径加大垫片 |

搜索：`M8 平垫圈 8.4 16 1.6`、`M2.5x16 内六角螺丝`、`M2.5 六角螺母`。平垫片规格可参考[伍尔特产品页](https://shop.wurth.ca/attaches/rondelles/rondelles-plates/rondelles-metriques-plates/RONDELLE-PLT-DIN125-ZN-M8x16x1.6mm/407.8/)。这里给的是所需规格，不限定店铺。

钢垫片按上述几何、密度 7.85 g/cm³ 计算，单片理论约 1.83 g；商品实重随材料和公差变化。**夹环、螺丝、螺母也是配重，不能只记金属垫片的重量。** 四个打印半环的实体体积合计约 4.29 cm³，实际打印质量取决于材料和切片；请称整套总质量。

建议 PETG，0.4 喷嘴、0.20 层高、4 道墙、100% 填充作为小件试打起点。文件已按 Z 向通孔朝上、底面贴板摆放，全部远小于 A1 mini 的成型范围。横向螺丝孔和螺母窝的桥接需查看切片，避免残留支撑堵住孔。

**先各打一件 11、12，组成一个夹环试配真实铝管和螺母，再打印第二组。** 当前杆孔 8.2、两半设计间隙 0.6；若实物松紧明显不合适，应修改孔径，不能靠把螺丝拧到底强行补偿。杆孔入口做了 0.2 倒角，清理毛刺后再夹薄壁铝管。

## 装配

1. 将两只 M2.5 螺母放进 12 号件外侧的六角窝；两半合在铝管外，用两颗 M2.5×16 加小平垫圈连接，形成下夹环。两侧逐步、交替轻拧。
2. 将下夹环移到选定位置，锁到手动轻拉不会滑动即可。夹环缝隙不必消失；不要夹瘪铝管。
3. 从摆杆自由端套入 2 片 M8 平垫片，放在下夹环上。分体夹环可以侧向拆装，但完整金属垫片仍需要从杆端套入。
4. 在垫片上方安装另一组夹环，轻压贴住垫片堆后锁紧，使垫片不松响。上夹环绕杆转 180°，让上、下两组螺丝头位于相反侧，模型也采用这一布置。
5. 移动整套配重时，同时略松上下夹环，扶住垫片堆一起移动，再分别锁紧。改变垫片片数时，调整两夹环之间的距离适应实际厚度。

只想做最小幅度试验，也可以先用一组空夹环作为轻配重；此时不用装 M8 垫片或另一组夹环。仍需把这一组的实际质量记入实验记录。

## 位置和数量范围

位置以**下夹环下沿到摆轴中心的距离**计量。模型检查范围为 **70–230 mm**，默认示例是 160 mm。不是从铝管顶端量，也不是配重重心的位置。

两夹环高度各 8，装 n 片、每片 1.6 厚的垫片后，总高度为 16+1.6n。n=2 时为 19.2；n=10 时为 32。在下夹环下沿 230、10 片的几何极限下，上端仍在轴心上方 262，低于原杆端 280。配重连螺丝的 Y 向包络约 ±10，位于支架内侧的空走廊。

**10 片只是空间检查数量，不代表已经验证允许的控制负载。** 初次用单夹环或 2 片方案，先低速试验；如果抱杆不稳、支架明显振动或电机饱和，不要继续增加重量。

配重越靠上，惯性和重力矩都会变化。它能帮助做对比试验，但不能保证位置越高、重量越大就越容易稳摆或自动起摆。

## 建议记录方式

先保持质量不变，只改变位置，例如 100、150、200 mm；再固定位置，比较 0、2、4 片。不要同时改位置、垫片数量和控制参数，否则难以判断原因。相同控制参数用于初步对比，最终每种配置仍可能需要重新整定。

记录整套实测质量、下夹环位置、稳摆时角度波动、电机输出是否饱和、支架振动，以及是否能重复摆起。振幅和扰动条件尽量一致。

## 验证范围

已检查两个打印零件为有效单实体、封闭正体积网格；参考螺丝、螺母、垫片、夹环和铝管在默认装配下无体积穿插；装配 STEP 回读通过。检查了位置范围两端与 0/2/10 片组合的转动包络。新增配重不超过原杆端的扫掠半径，且与固定打印支架轴向分离。原有底部横杆也在该扫掠区之外。

夹环实际夹紧力、打印公差、松动风险和控制效果没有实测。新增螺丝或不同垫片外形超出所列规格时，应重新检查。独立 HTML 可以拖动位置滑块看几何变化，不能当作动力学仿真。
