lingkonglengfeng/nanhua-pendulum-car/hardware/adapter-board/电赛转接板.pdf

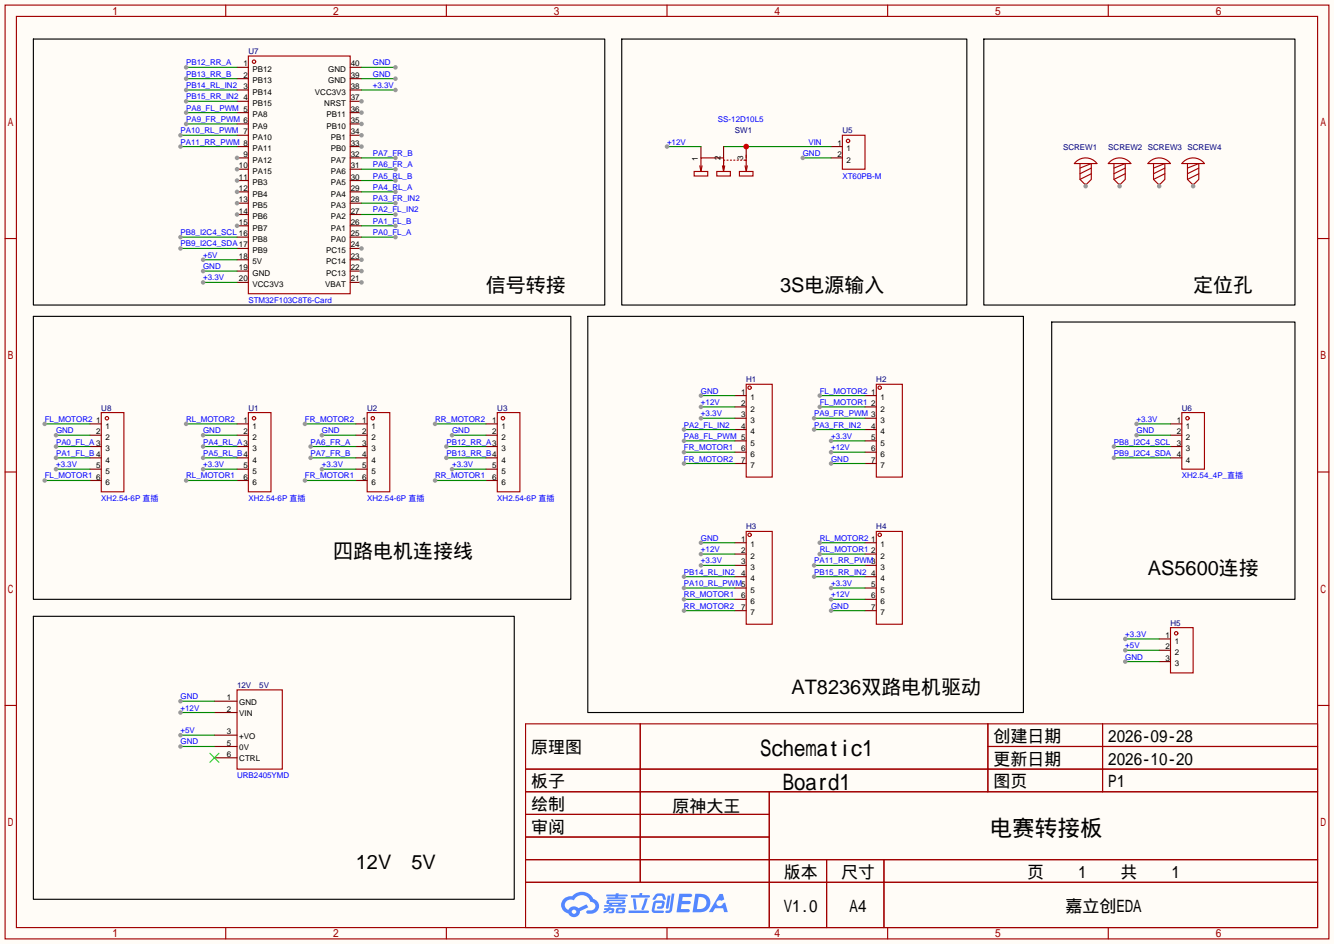
[picture p60: page 1]

原理图 | Schematic1 | 创建日期 | 2026-09-28

更新日期 | 2026-10-20

板子 | Board1 | 图页 | P1
绘制 | 原神大王 | 电赛转接板
审阅

V1.0 | A4 | 嘉立创EDA
