lingkonglengfeng/nanhua-pendulum-car/f103_bringup/f103_bringup.ioc

Mcu.UserName=STM32F103C8Tx
PA0-WKUP.Signal=GPIO_Input
PA1.Signal=GPIO_Input
PA10.Signal=S_TIM1_CH3
PA11.Signal=S_TIM1_CH4
PA13.Signal=SYS_JTMS-SWDIO
PA14.Signal=SYS_JTCK-SWCLK
PA2.Signal=GPIO_Output
PA3.Signal=GPIO_Output
PA4.Signal=GPIO_Input
PA5.Signal=GPIO_Input
PA6.Signal=GPIO_Input
PA7.Signal=GPIO_Input
PA8.Signal=S_TIM1_CH1
PA9.Signal=S_TIM1_CH2
PB12.Signal=GPIO_Input
PB13.Signal=GPIO_Input
PB14.Signal=GPIO_Output
PB15.Signal=GPIO_Output
PB4.Signal=S_TIM3_CH1
PB8.Signal=I2C1_SCL
PB9.Signal=I2C1_SDA
PC13-TAMPER-RTC.Signal=GPIO_Output
PD0-OSC_IN.Signal=RCC_OSC_IN
PD1-OSC_OUT.Signal=RCC_OSC_OUT
