lingkonglengfeng/nanhua-pendulum-car/wiring_dmg474_drv8871/package_wiring.py

from pathlib import Path
import zipfile
r=Path(__file__).resolve().parent;t=r.parent/'pendulum_接线SVG_V1.zip'
with zipfile.ZipFile(t,'w',zipfile.ZIP_DEFLATED) as z:
    for p in r.rglob('*'):
        if p.is_file() and '__pycache__' not in p.parts:z.write(p,Path(r.name)/p.relative_to(r))
with zipfile.ZipFile(t) as z:
    assert z.testzip() is None
    print(str(t),len(z.namelist()))
